Just4Stan/betaflight/(list of files, cad)

Other CAD files:
hardware/OpenFC-B_Paste.dxf
hardware/OpenFC-F_Paste.dxf
