Just4Stan/betaflight/hardware/OpenFC.kicad_pcb

## KiCad design hardware/OpenFC.kicad_pcb (2026-04-27)

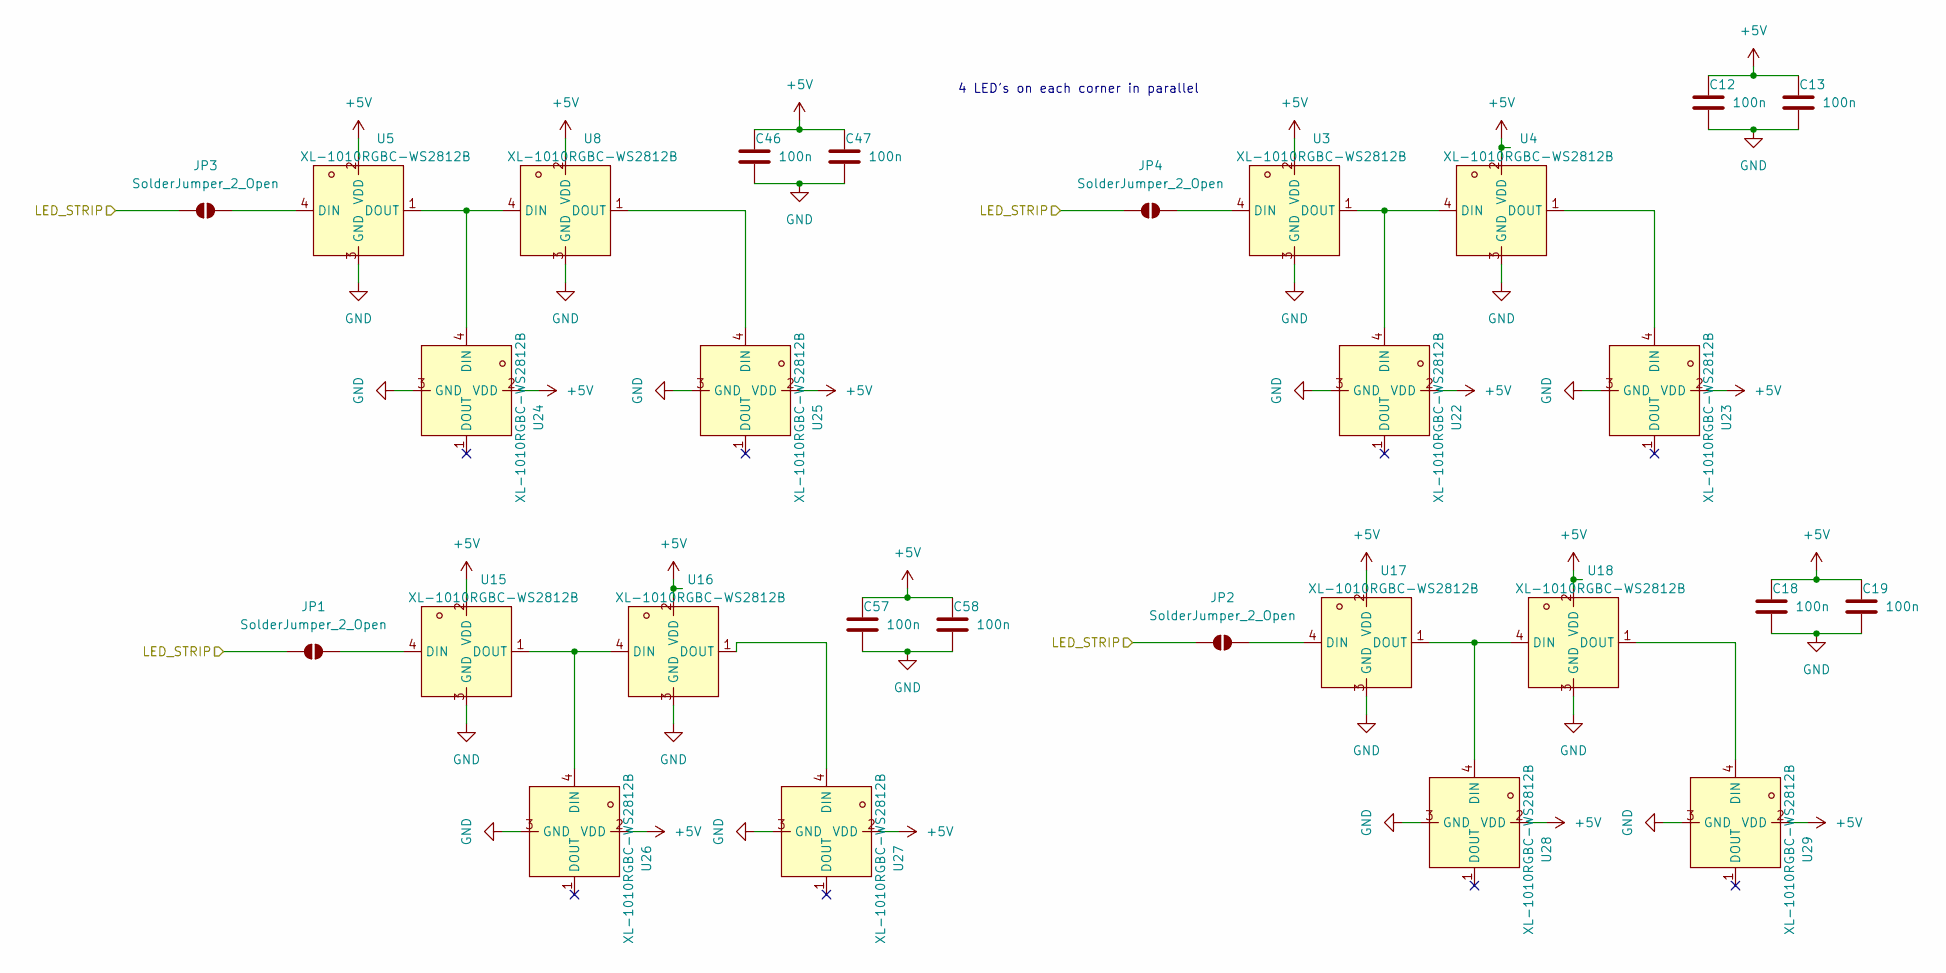
[picture p1: schematic leds.kicad_sch]

Parts:
C12, C13, C18, C19, C46, C47, C57, C58: 100n; C_0402_1005Metric; LCSC C1525
JP1, JP2, JP3, JP4: SolderJumper_2_Open; MouseBite-Slot-Jumper_0201
U3, U4, U5, U8, U15, U16, U17, U18, U22, U23, U24, U25, U26, U27, U28, U29: XL-1010RGBC-WS2812B; LED-SMD_4P-L1.0-W1.0-TL_XL-1010RGBC-WS2812B; LCSC Part C5349953

Connections:
+5V: C12.1, C13.1, C18.1, C19.1, C46.1, C47.1, C57.1, C58.1, U3.2 (VDD), U4.2 (VDD), U5.2 (VDD), U8.2 (VDD), U15.2 (VDD), U16.2 (VDD), U17.2 (VDD), U18.2 (VDD), U22.2 (VDD), U23.2 (VDD), U24.2 (VDD), U25.2 (VDD), U26.2 (VDD), U27.2 (VDD), U28.2 (VDD), U29.2 (VDD); also elsewhere on the board
/LED: JP1.1 (A), JP2.1 (A), JP3.1 (A), JP4.1 (A); also elsewhere on the board
GND: C12.2, C13.2, C18.2, C19.2, C46.2, C47.2, C57.2, C58.2, U3.3 (GND), U4.3 (GND), U5.3 (GND), U8.3 (GND), U15.3 (GND), U16.3 (GND), U17.3 (GND), U18.3 (GND), U22.3 (GND), U23.3 (GND), U24.3 (GND), U25.3 (GND), U26.3 (GND), U27.3 (GND), U28.3 (GND), U29.3 (GND); also elsewhere on the board
unnamed: JP1.2 (B), U15.4 (DIN)
unnamed: JP2.2 (B), U17.4 (DIN)
unnamed: JP3.2 (B), U5.4 (DIN)
unnamed: JP4.2 (B), U3.4 (DIN)
unnamed: U15.1 (DOUT), U16.4 (DIN), U26.4 (DIN)
unnamed: U16.1 (DOUT), U27.4 (DIN)
unnamed: U17.1 (DOUT), U18.4 (DIN), U28.4 (DIN)
unnamed: U18.1 (DOUT), U29.4 (DIN)
unnamed: U3.1 (DOUT), U4.4 (DIN), U22.4 (DIN)
unnamed: U4.1 (DOUT), U23.4 (DIN)
unnamed: U5.1 (DOUT), U8.4 (DIN), U24.4 (DIN)
unnamed: U8.1 (DOUT), U25.4 (DIN)

Notes on the sheet:
4 LED's on each corner in parallel

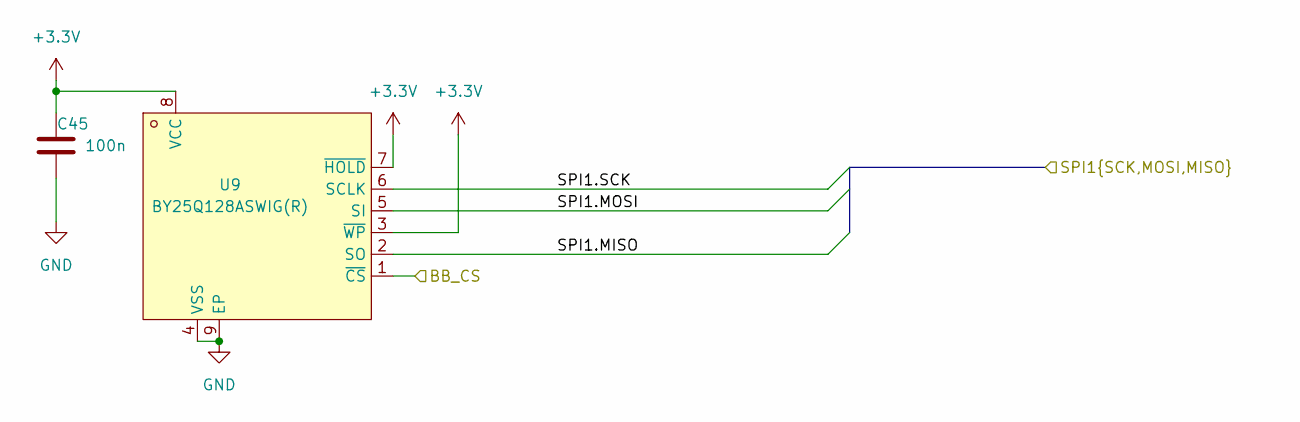
[picture p2: schematic blackbox.kicad_sch]

Parts:
C45: 100n; C_0402_1005Metric; LCSC C1525
U9: BY25Q128ASWIG(R); WSON-8_L6.0-W5.0-P1.27-BL-EP; LCSC Part C394872

Connections:
+3.3V: C45.1, U9.3 (~WP), U9.7 (~HOLD), U9.8 (VCC); also elsewhere on the board
/BLACKBOX/BB_CS: U9.1 (~CS); also elsewhere on the board
/BLACKBOX/SPI1.MISO: U9.2 (SO); also elsewhere on the board
/BLACKBOX/SPI1.MOSI: U9.5 (SI); also elsewhere on the board
/BLACKBOX/SPI1.SCK: U9.6 (SCLK); also elsewhere on the board
GND: C45.2, U9.4 (VSS), U9.9 (EP); also elsewhere on the board

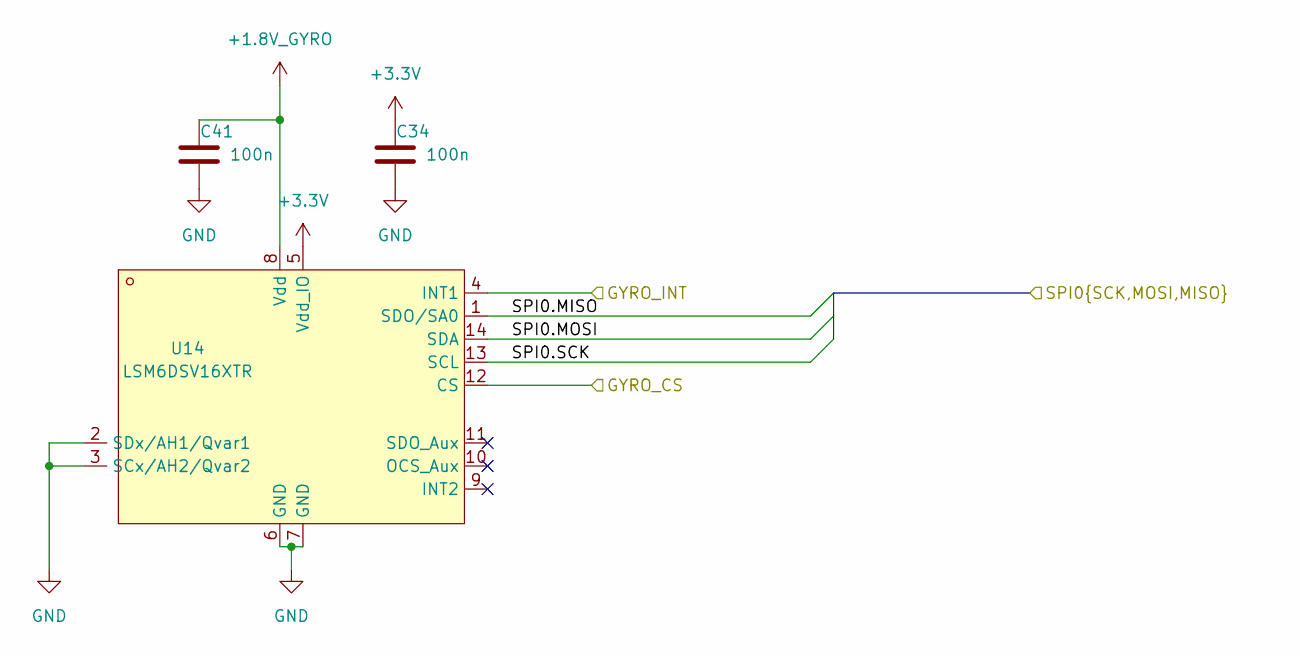
[picture p3: schematic imu.kicad_sch]

Parts:
C34, C41: 100n; C_0402_1005Metric; LCSC C1525
U14: LSM6DSV16XTR; LGA-14_L3.0-W2.5-P0.50-BR; LCSC Part C5267406

Connections:
+1.8V_GYRO: C41.1, U14.8 (Vdd); also elsewhere on the board
+3.3V: C34.1, U14.5 (Vdd_IO); also elsewhere on the board
/IMU/GYRO_CS: U14.12 (CS); also elsewhere on the board
/IMU/GYRO_INT: U14.4 (INT1); also elsewhere on the board
/IMU/SPI0.MISO: U14.1 (SDO/SA0); also elsewhere on the board
/IMU/SPI0.MOSI: U14.14 (SDA); also elsewhere on the board
/IMU/SPI0.SCK: U14.13 (SCL); also elsewhere on the board
GND: C34.2, C41.2, U14.2 (SDx/AH1/Qvar1), U14.3 (SCx/AH2/Qvar2), U14.6 (GND), U14.7 (GND); also elsewhere on the board

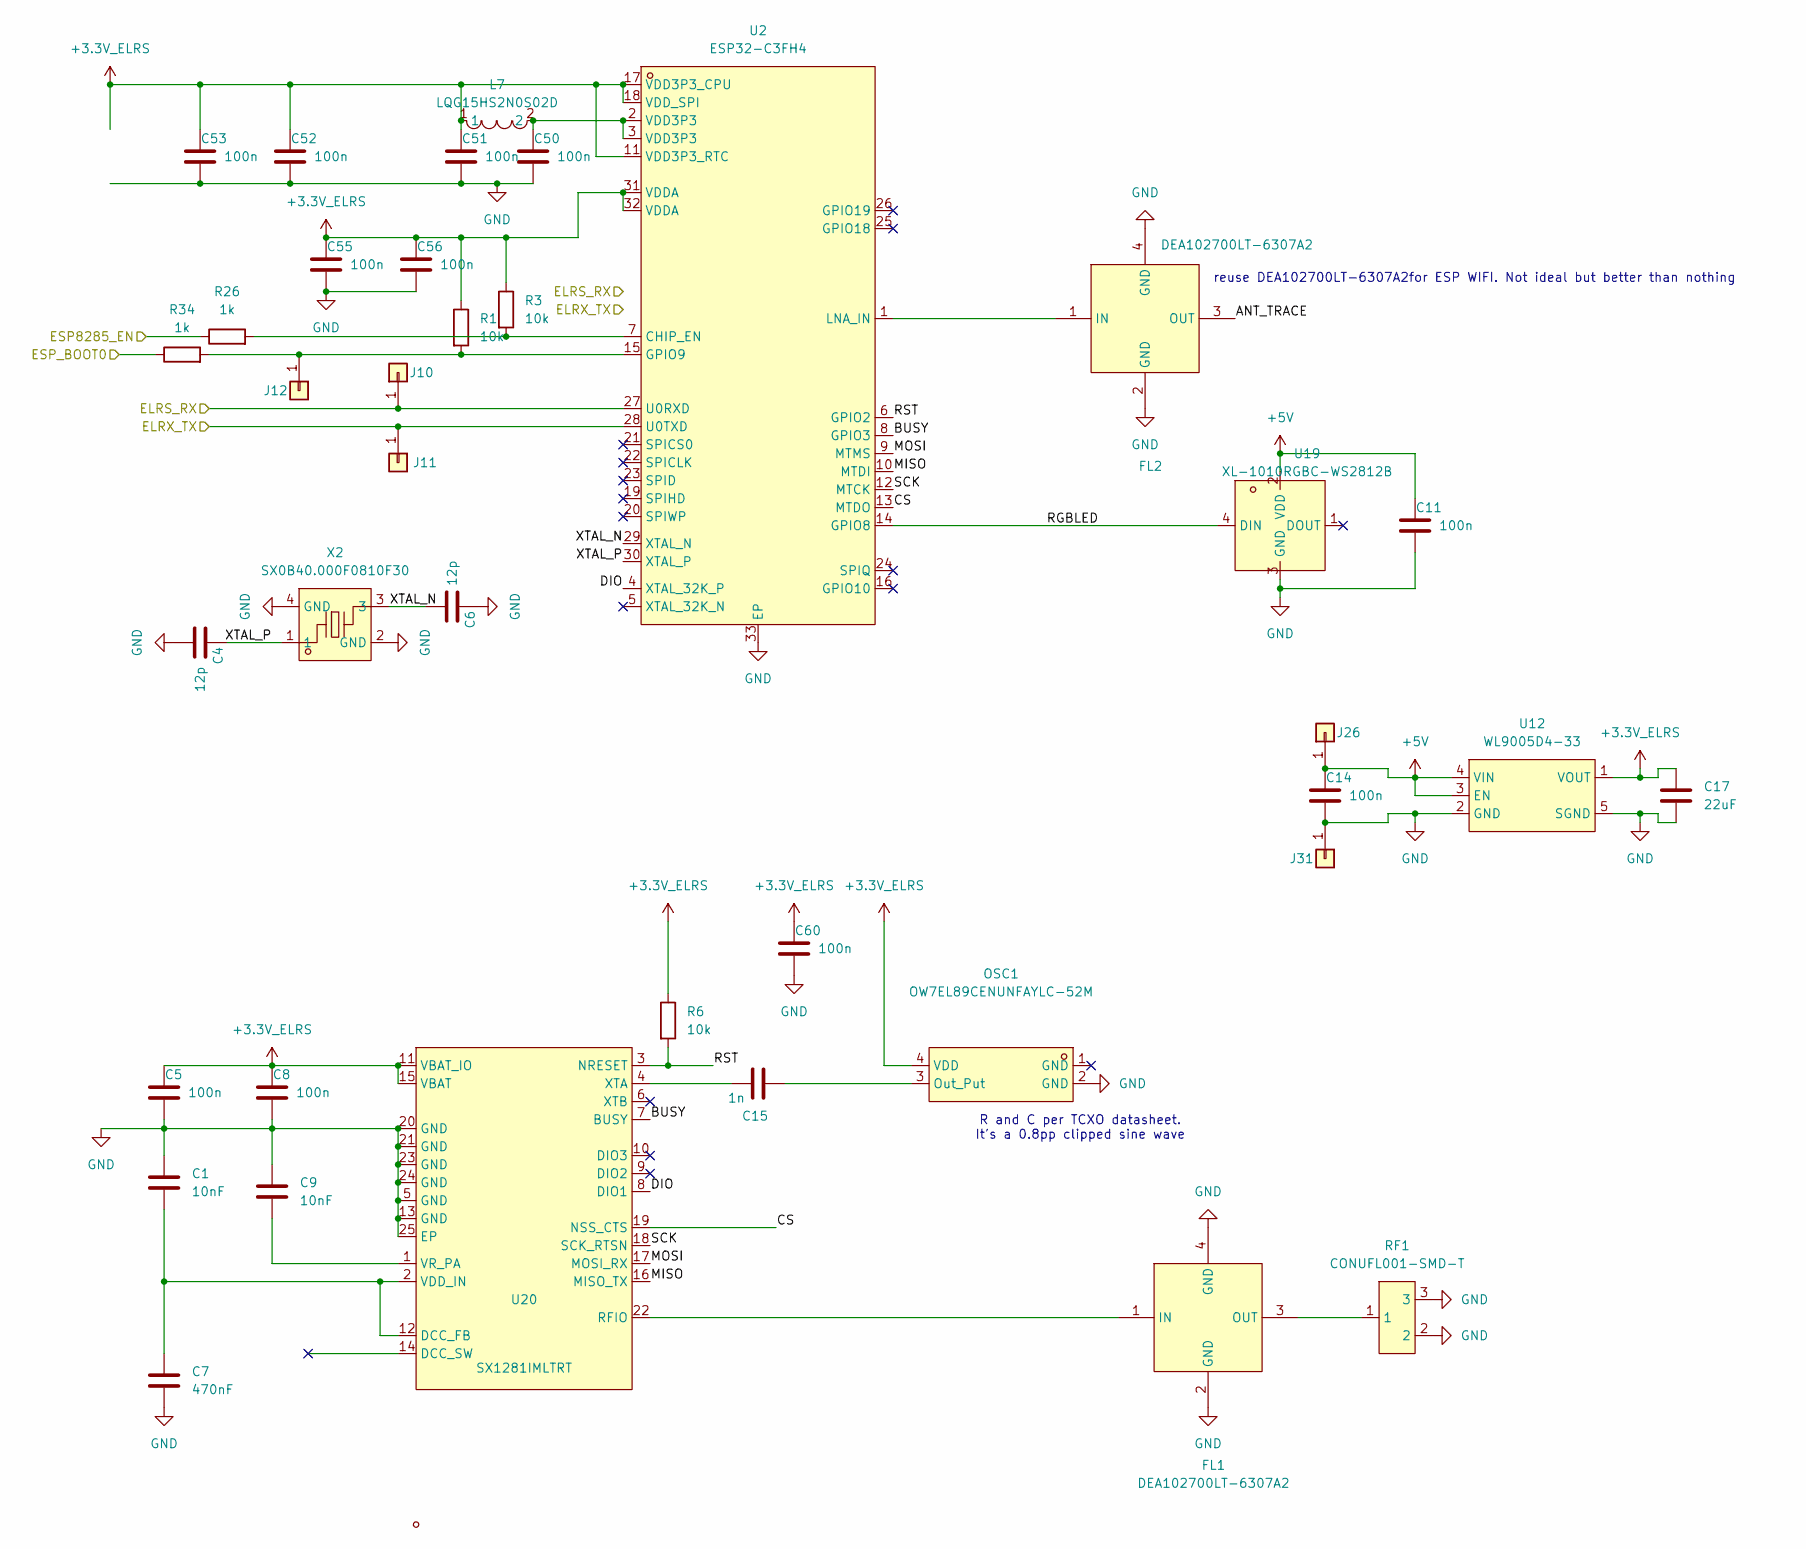
[picture p4: schematic elrs.kicad_sch]

Parts:
C1, C9: 10nF; C_0402_1005Metric; LCSC C15195
C4, C6: 12p; C_0402_1005Metric; LCSC C441742
C5, C8, C11, C14, C50, C51, C52, C53, C55, C56, C60: 100n; C_0402_1005Metric; LCSC C1525
C7: 470nF; C_0402_1005Metric; LCSC C92361
C15: 1n; C_0402_1005Metric
C17: 22uF; C_0402_1005Metric; LCSC C105226
FL1, FL2: DEA102700LT-6307A2; FILTER-SMD_4P-L1.0-W0.5-L; LCSC Part C574024
J10, J11, J12, J26, J31: 5V; small_pad
L7: LQG15HS2N0S02D; L0402; LCSC Part C18216
OSC1: OW7EL89CENUNFAYLC-52M; OSC-SMD_4P-L2.0-W1.6-BL_TXC_7Z; LCSC Part C22434896
R1, R3, R6: 10k; R_0402_1005Metric; LCSC C2909316
R26, R34: 1k; R_0402_1005Metric; LCSC C2909316
RF1: CONUFL001-SMD-T; IPEX-SMD_3P-L2.6-W2.6-LS3.0; LCSC Part C22418213
U2: ESP32-C3FH4; QFN-32_L5.0-W5.0-P0.50-TL-EP3.7; LCSC Part C2858491
U12: WL9005D4-33; UDFN-4_L1.0-W1.0-P0.65-TL; LCSC Part C5357206
U19: XL-1010RGBC-WS2812B; LED-SMD_4P-L1.0-W1.0-TL_XL-1010RGBC-WS2812B; LCSC Part C5349953
U20: SX1281IMLTRT; QFN-24_L4.0-W4.0-P0.50-TL-EP2.6; LCSC Part C2151551
X2: SX0B40.000F0810F30; CRYSTAL-SMD_4P-L1.6-W1.2-BL; LCSC Part C7301926

Connections:
+3.3V_ELRS: C5.1, C8.1, C17.1, C51.1, C52.1, C53.1, C55.1, C56.1, C60.1, L7.1, OSC1.4 (VDD), R1.1, R3.1, R6.1, U2.11 (VDD3P3_RTC), U2.17 (VDD3P3_CPU), U2.18 (VDD_SPI), U2.31 (VDDA), U2.32 (VDDA), U12.1 (VOUT), U20.11 (VBAT_IO), U20.15 (VBAT)
+5V: C11.1, C14.1, J26.1, U12.3 (EN), U12.4 (VIN), U19.2 (VDD); also elsewhere on the board
/ELRS/ANT_TRACE: FL2.3 (OUT)
/ELRS/BUSY: U2.8 (GPIO3), U20.7 (BUSY)
/ELRS/CS: U2.13 (MTDO), U20.19 (NSS_CTS)
/ELRS/DIO: U2.4 (XTAL_32K_P), U20.8 (DIO1)
/ELRS/ESP8285_EN: R26.1; also elsewhere on the board
/ELRS/ESP_BOOT0: R34.1; also elsewhere on the board
/ELRS/MISO: U2.10 (MTDI), U20.16 (MISO_TX)
/ELRS/MOSI: U2.9 (MTMS), U20.17 (MOSI_RX)
/ELRS/RGBLED: U2.14 (GPIO8), U19.4 (DIN)
/ELRS/RST: R6.2, U2.6 (GPIO2), U20.3 (NRESET)
/ELRS/SCK: U2.12 (MTCK), U20.18 (SCK_RTSN)
/ELRS/XTAL_N: C6.2, U2.29 (XTAL_N), X2.3
/ELRS/XTAL_P: C4.1, U2.30 (XTAL_P), X2.1
/UART1_RX: J11.1, U2.28 (U0TXD); also elsewhere on the board
/UART1_TX: J10.1, U2.27 (U0RXD); also elsewhere on the board
GND: C1.1, C4.2, C5.2, C6.1, C7.2, C8.2, C9.1, C11.2, C14.2, C17.2, C50.2, C51.2, C52.2, C53.2, C55.2, C56.2, C60.2, FL1.2 (GND), FL1.4 (GND), FL2.2 (GND), FL2.4 (GND), J31.1, OSC1.2 (GND), RF1.2, RF1.3, U2.33 (EP), U12.2 (GND), U12.5 (SGND), U19.3 (GND), U20.5 (GND), U20.13 (GND), U20.20 (GND), U20.21 (GND), U20.23 (GND), U20.24 (GND), U20.25 (EP), X2.2 (GND), X2.4 (GND); also elsewhere on the board
unnamed: C50.1, L7.2, U2.2 (VDD3P3), U2.3 (VDD3P3)
unnamed: FL1.1 (IN), U20.22 (RFIO)
unnamed: FL1.3 (OUT), RF1.1
unnamed: FL2.1 (IN), U2.1 (LNA_IN)
unnamed: J12.1, R1.2, R34.2, U2.15 (GPIO9)
unnamed: C15.2, OSC1.3 (Out_Put)
unnamed: R3.2, R26.2, U2.7 (CHIP_EN)
unnamed: C1.2, C7.1, U20.2 (VDD_IN), U20.12 (DCC_FB)
unnamed: C9.2, U20.1 (VR_PA)
unnamed: C15.1, U20.4 (XTA)

Notes on the sheet:
reuse DEA102700LT-6307A2for ESP WIFI. Not ideal but better than nothing
R and C per TCXO datasheet. It's a 0.8pp clipped sine wave

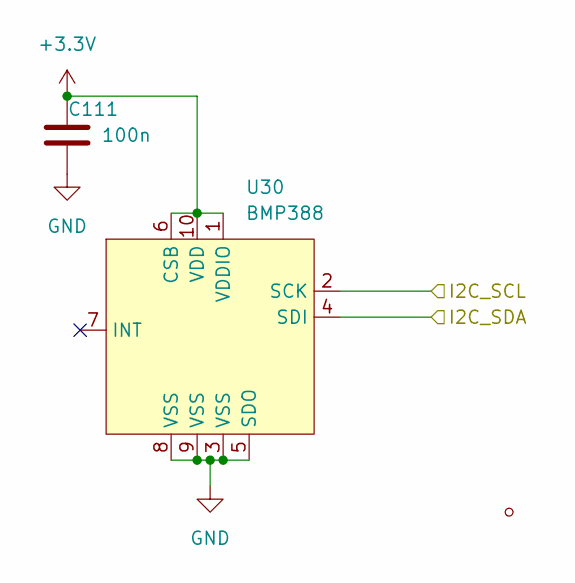
[picture p5: schematic baro.kicad_sch]

Parts:
C111: 100n; C_0402_1005Metric; LCSC C1525
U30: BMP388; SENSORM-SMD_BMP388; LCSC Part C779278

Connections:
+3.3V: C111.1, U30.1 (VDDIO), U30.6 (CSB), U30.10 (VDD); also elsewhere on the board
/I2C_SCL: U30.2 (SCK); also elsewhere on the board
/I2C_SDA: U30.4 (SDI); also elsewhere on the board
GND: C111.2, U30.3 (VSS), U30.5 (SDO), U30.8 (VSS), U30.9 (VSS); also elsewhere on the board

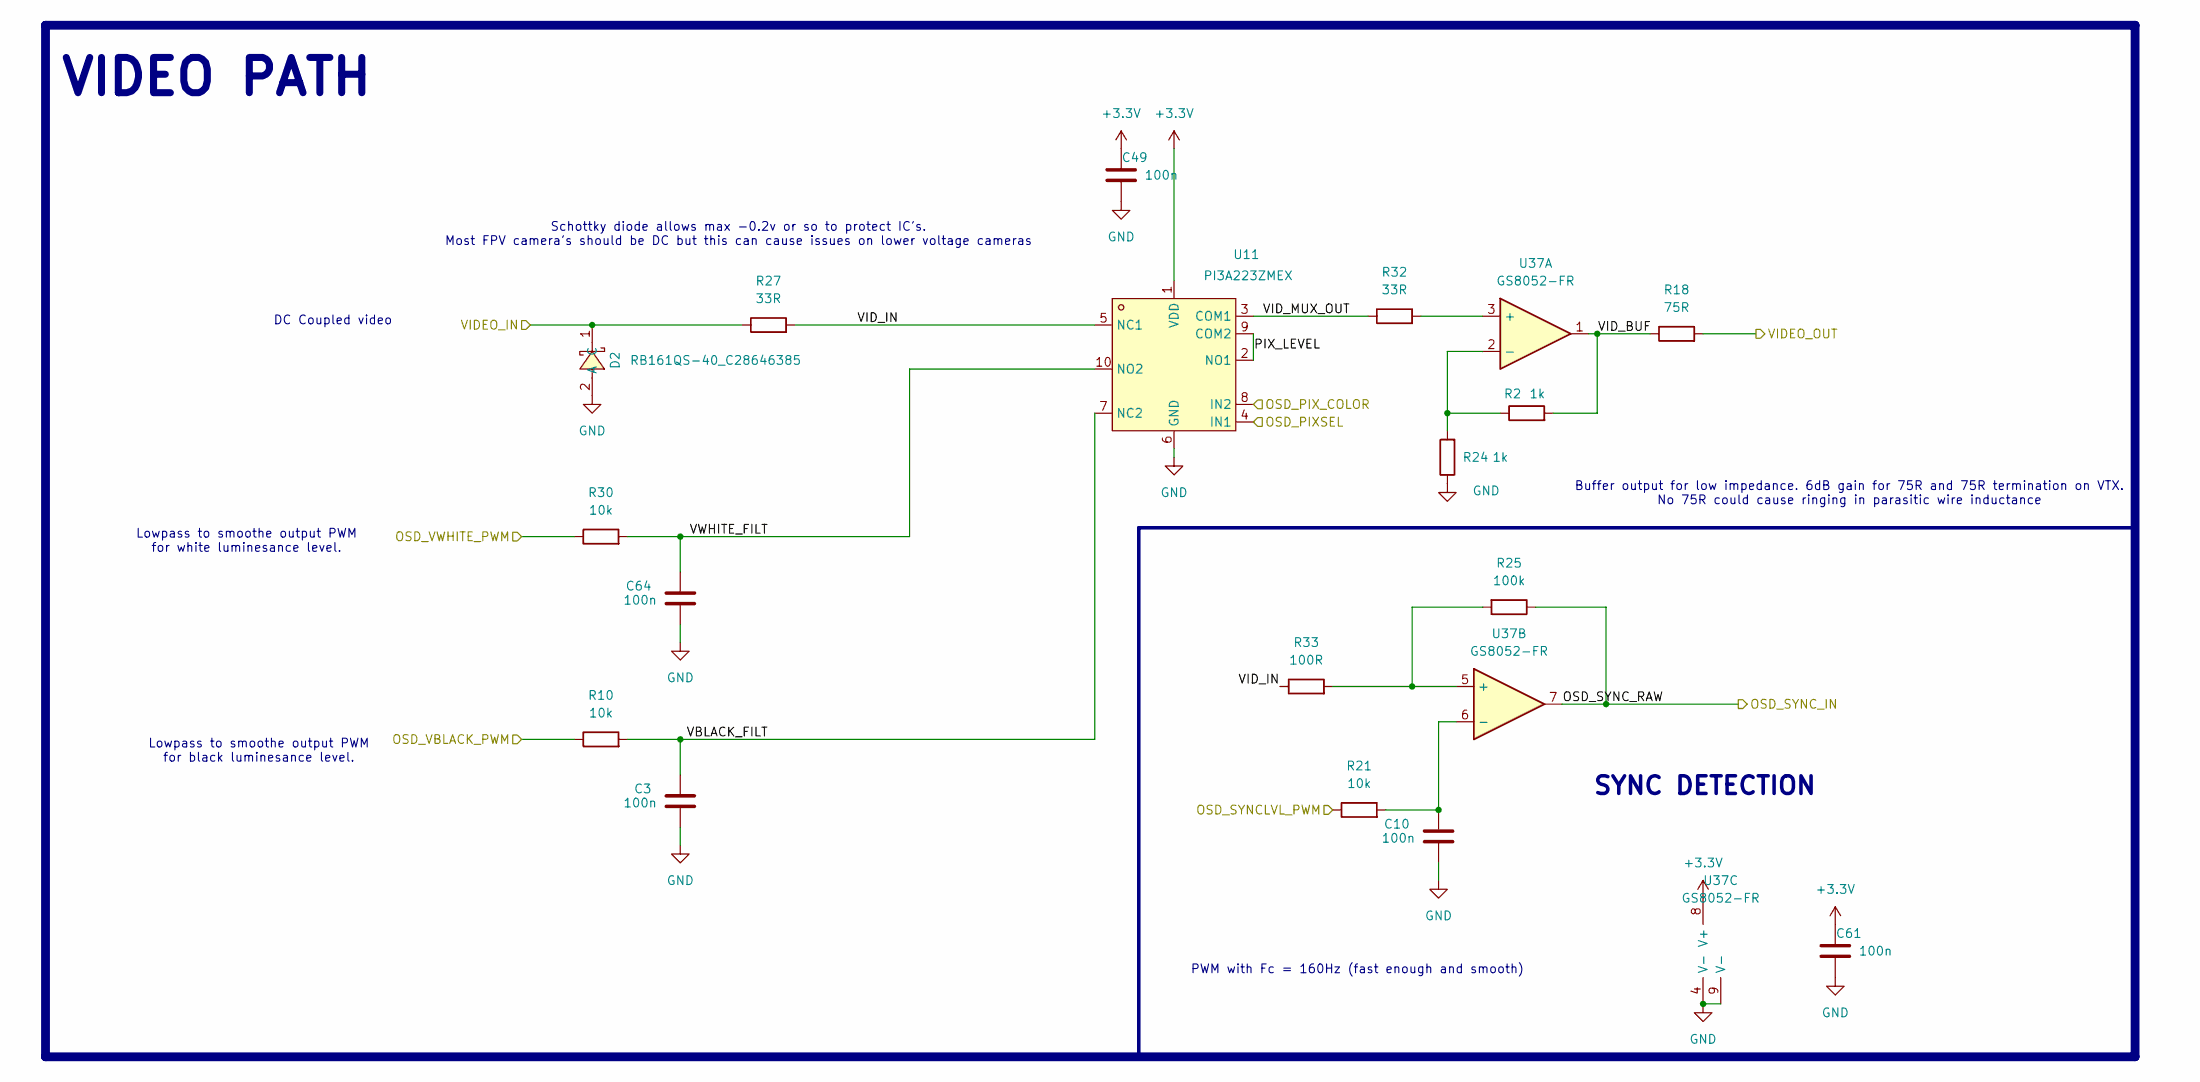
[picture p6: schematic osd.kicad_sch]

Parts:
C3, C10, C49, C61, C64: 100n; C_0402_1005Metric; LCSC C1525
D2: RB161QS-40_C28646385; SOD-882_L1.0-W0.6-RD; LCSC Part C28646385
R2, R24: 1k; R_0402_1005Metric
R10, R21, R30: 10k; R_0402_1005Metric
R18: 75R; R_0402_1005Metric
R25: 100k; R_0402_1005Metric
R27, R32: 33R; R_0402_1005Metric
R33: 100R; R_0402_1005Metric
U11: PI3A223ZMEX; UQFN-10_L1.8-W1.4-P0.40-TL; LCSC Part C2673436
U37: GS8052-FR; WSON-8-1EP_2x2mm_P0.5mm_EP0.9x1.6mm; LCSC C605423

Connections:
+3.3V: C49.1, C61.1, U11.1 (VDD), U37.8 (V+); also elsewhere on the board
/OSD/OSD_PIXSEL: U11.4 (IN1); also elsewhere on the board
/OSD/OSD_PIX_COLOR: U11.8 (IN2); also elsewhere on the board
/OSD/OSD_SYNCLVL_PWM: R21.1; also elsewhere on the board
/OSD/OSD_SYNC_RAW: R25.1, U37.7; also elsewhere on the board
/OSD/OSD_VBLACK_PWM: R10.1; also elsewhere on the board
/OSD/OSD_VWHITE_PWM: R30.1; also elsewhere on the board
/OSD/PIX_LEVEL: U11.2 (NO1), U11.9 (COM2)
/OSD/VBLACK_FILT: C3.2, R10.2, U11.7 (NC2); also elsewhere on the board
/OSD/VIDEO_IN: D2.1 (C), R27.1; also elsewhere on the board
/OSD/VIDEO_OUT: R18.2; also elsewhere on the board
/OSD/VID_BUF: R2.2, R18.1, U37.1
/OSD/VID_IN: R27.2, R33.1, U11.5 (NC1); also elsewhere on the board
/OSD/VID_MUX_OUT: R32.1, U11.3 (COM1); also elsewhere on the board
/OSD/VWHITE_FILT: C64.2, R30.2, U11.10 (NO2); also elsewhere on the board
GND: C3.1, C10.1, C49.2, C61.2, C64.1, D2.2 (A), R24.1, U11.6 (GND), U37.4 (V-), U37.9 (V-); also elsewhere on the board
unnamed: R32.2, U37.3 (+)
unnamed: R2.1, R24.2, U37.2 (-)
unnamed: R25.2, R33.2, U37.5 (+)
unnamed 131: C10.2, R21.2, U37.6 (-); also elsewhere on the board

Notes on the sheet:
PWM with Fc = 160Hz (fast enough and smooth)
DC Coupled video
Buffer output for low impedance. 6dB gain for 75R and 75R termination on VTX. No 75R could cause ringing in parasitic wire inductance
VIDEO PATH
SYNC DETECTION
Lowpass to smoothe output PWM for white luminesance level.
Lowpass to smoothe output PWM for black luminesance level.
Schottky diode allows max -0.2v or so to protect IC's. Most FPV camera's should be DC but this can cause issues on lower voltage cameras

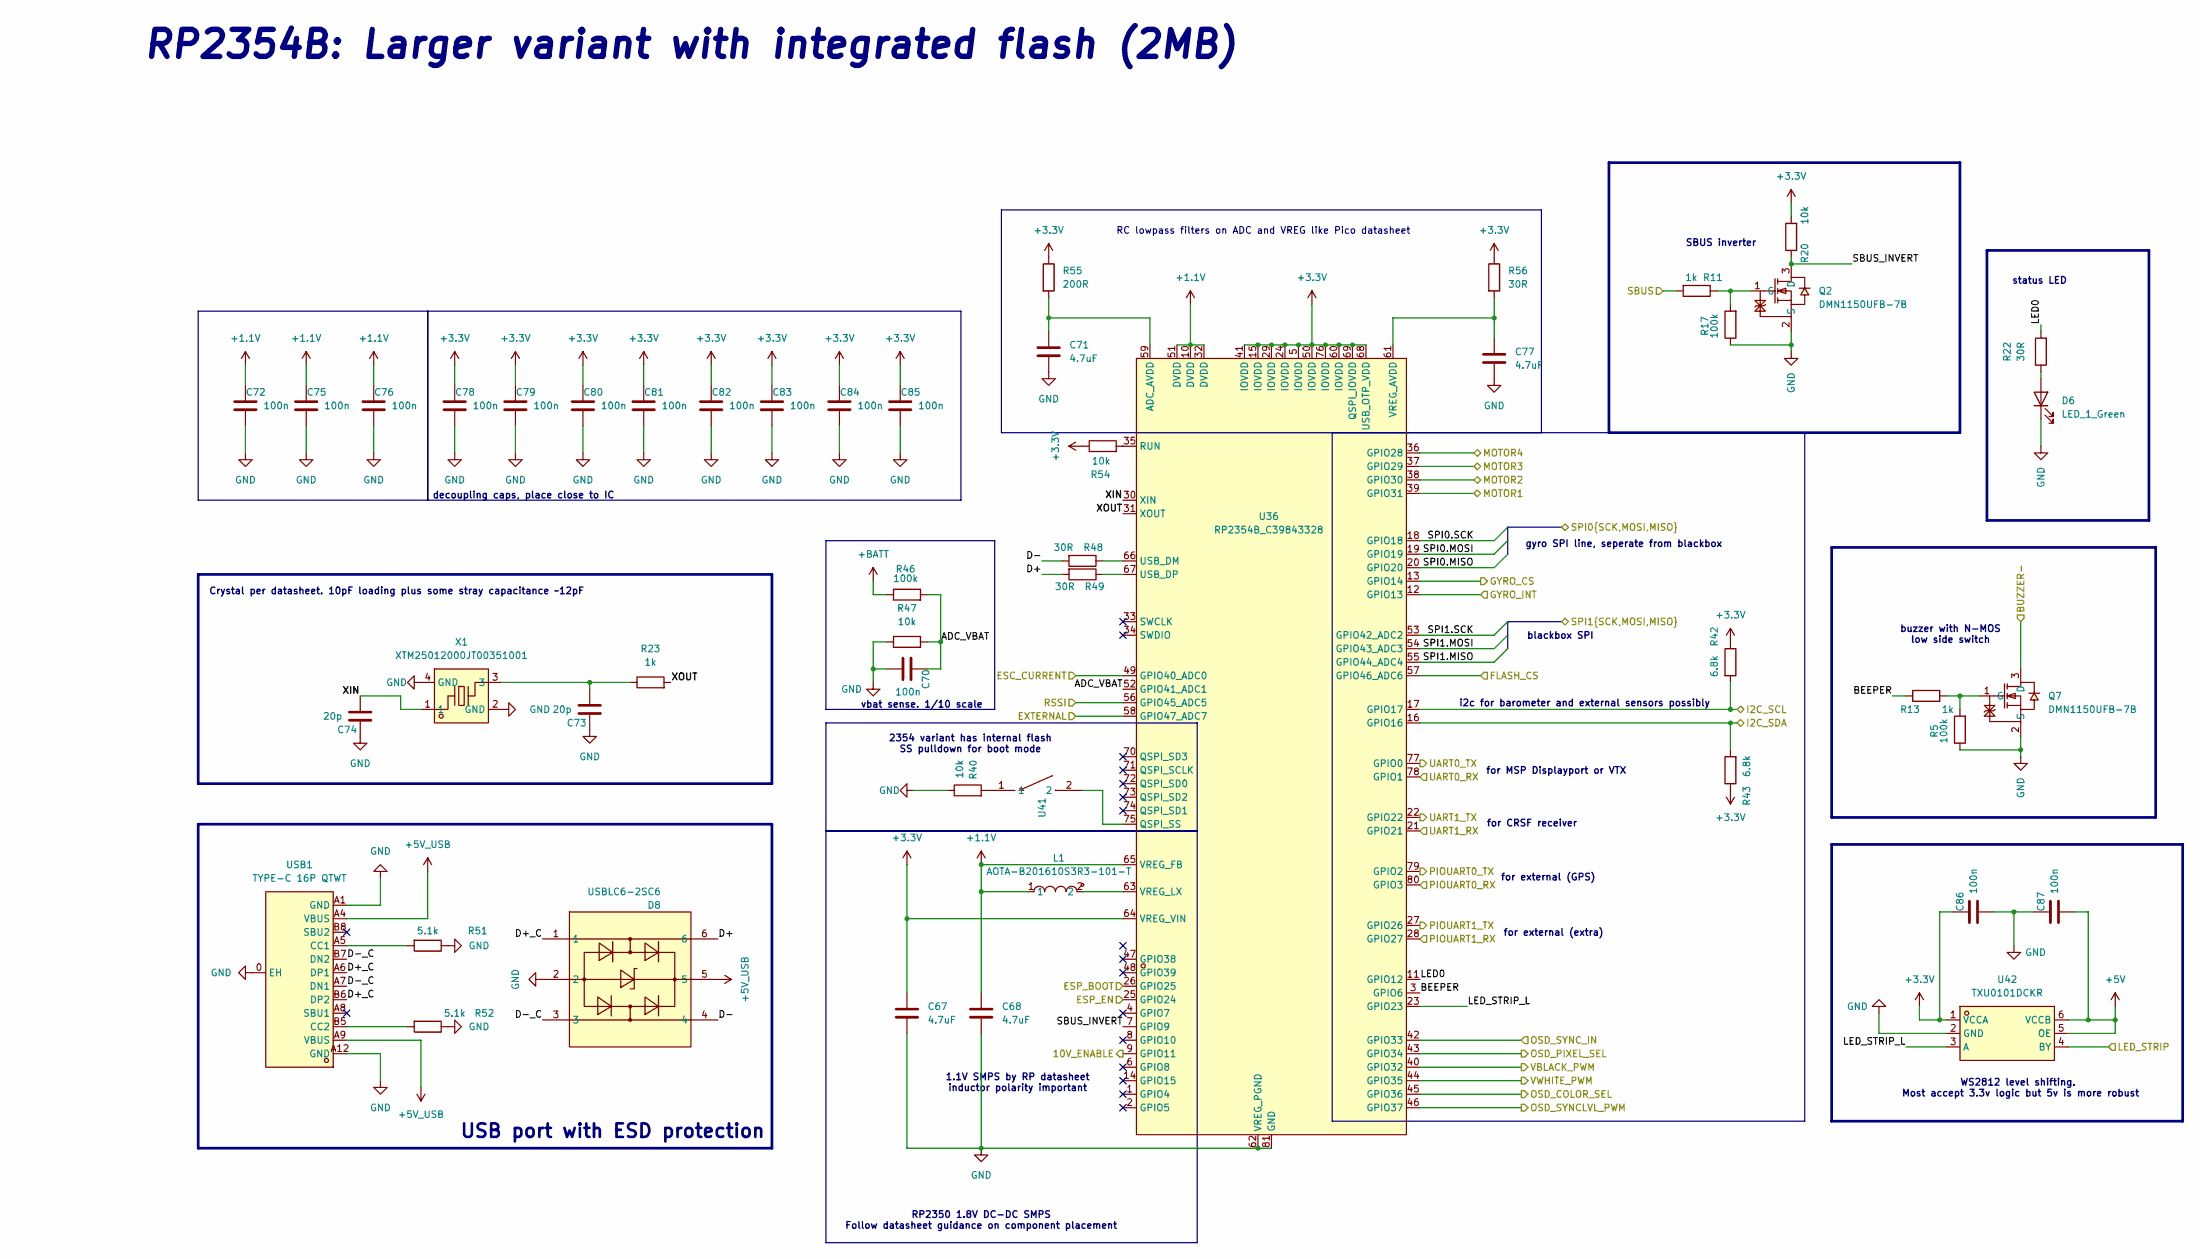
[picture p7: schematic rp2350a.kicad_sch]

Parts:
C67, C68, C71, C77: 4.7uF; C_0402_1005Metric; LCSC C23733
C70, C72, C75, C76, C78, C79, C80, C81, C82, C83, C84, C85, C86, C87: 100n; C_0402_1005Metric; LCSC C1525
C73, C74: 20p; C_0402_1005Metric; LCSC C441742
D6: LED_1_Green; LED_0603_1608Metric; LCSC C2994781
D8: USBLC6-2SC6; SOT-23-6_L2.9-W1.6-P0.95-LS2.8-BL; LCSC Part C7519
L1: AOTA-B201610S3R3-101-T; IND-SMD_L2.0-W1.6_AOTA-B201610S3R3-101-T; LCSC Part C42411119
Q2, Q7: DMN1150UFB-7B; DFN-3L_L1.0-W0.6-P0.65-BR; LCSC Part C459538
R5, R17, R46: 100k; R_0402_1005Metric; LCSC C60491
R11, R13: 1k; R_0402_1005Metric; LCSC C106235
R20: 10k; R_0402_1005Metric; LCSC C106235
R22, R48, R49, R56: 30R; R_0402_1005Metric; LCSC C138007
R23: 1k; R_0402_1005Metric; LCSC C2909316
R40, R47, R54: 10k; R_0402_1005Metric; LCSC C2909316
R42: 6.8k; R_0402_1005Metric; LCSC C105872
R43: 6.8k; R_0402_1005Metric; LCSC C2906876
R51, R52: 5.1k; R_0402_1005Metric; LCSC C105872
R55: 200R; R_0402_1005Metric; LCSC C25087
U36: RP2354B_C39843328; QFN-80_L10.0-W10.0-P0.40-TL-EP3.4; LCSC Part C39843328
U41: TS2306A 240GF MSM 9_C2976675; SW-SMD_4P-L3.0-W2.0-P0.85-LS3.5; LCSC Part C2976675
U42: TXU0101DCKR; SC-70-6_L2.0-W1.3-P0.65-LS2.1-BL; LCSC Part C5217868
USB1: TYPE-C 16P QTWT; USB-TYPE-C-SMD_TYPE-C-16P-QTWT; LCSC Part C5187472
X1: XTM25012000JT00351001; CRYSTAL-SMD_4P-L2.5-W2.0-BL-A; LCSC Part C37635340

Connections:
+1.1V: C68.1, C72.1, C75.1, C76.1, L1.1, U36.10 (DVDD), U36.32 (DVDD), U36.51 (DVDD), U36.65 (VREG_FB)
+3.3V: C67.1, C78.1, C79.1, C80.1, C81.1, C82.1, C83.1, C84.1, C85.1, C86.1, R20.2, R42.1, R43.1, R54.1, R55.1, R56.1, U36.5 (IOVDD), U36.15 (IOVDD), U36.24 (IOVDD), U36.29 (IOVDD), U36.41 (IOVDD), U36.50 (IOVDD), U36.60 (IOVDD), U36.64 (VREG_VIN), U36.68 (USB_OTP_VDD), U36.69 (QSPI_IOVDD), U36.76 (IOVDD), U42.1 (VCCA); also elsewhere on the board
+5V: C87.2, U42.5 (OE), U42.6 (VCCB); also elsewhere on the board
+5V_USB: D8.5, USB1.A4 (VBUS), USB1.A9 (VBUS); also elsewhere on the board
+BATT: R46.1; also elsewhere on the board
/BLACKBOX/BB_CS: U36.57 (GPIO46_ADC6); also elsewhere on the board
/BLACKBOX/SPI1.MISO: U36.55 (GPIO44_ADC4); also elsewhere on the board
/BLACKBOX/SPI1.MOSI: U36.54 (GPIO43_ADC3); also elsewhere on the board
/BLACKBOX/SPI1.SCK: U36.53 (GPIO42_ADC2); also elsewhere on the board
/ELRS/ESP8285_EN: U36.25 (GPIO24); also elsewhere on the board
/ELRS/ESP_BOOT0: U36.26 (GPIO25); also elsewhere on the board
/I2C_SCL: R42.2, U36.17 (GPIO17); also elsewhere on the board
/I2C_SDA: R43.2, U36.16 (GPIO16); also elsewhere on the board
/IMU/GYRO_CS: U36.13 (GPIO14); also elsewhere on the board
/IMU/GYRO_INT: U36.12 (GPIO13); also elsewhere on the board
/IMU/SPI0.MISO: U36.20 (GPIO20); also elsewhere on the board
/IMU/SPI0.MOSI: U36.19 (GPIO19); also elsewhere on the board
/IMU/SPI0.SCK: U36.18 (GPIO18); also elsewhere on the board
/LED: U42.4 (BY); also elsewhere on the board
/OSD/OSD_PIXSEL: U36.43 (GPIO34); also elsewhere on the board
/OSD/OSD_PIX_COLOR: U36.45 (GPIO36); also elsewhere on the board
/OSD/OSD_SYNCLVL_PWM: U36.46 (GPIO37); also elsewhere on the board
/OSD/OSD_SYNC_RAW: U36.42 (GPIO33); also elsewhere on the board
/OSD/OSD_VBLACK_PWM: U36.40 (GPIO32); also elsewhere on the board
/OSD/OSD_VWHITE_PWM: U36.44 (GPIO35); also elsewhere on the board
/PADS/ADC2: U36.58 (GPIO47_ADC7); also elsewhere on the board
/PADS/BUZZER-: Q7.3 (D); also elsewhere on the board
/PADS/CURRENT: U36.49 (GPIO40_ADC0); also elsewhere on the board
/PADS/DIGITAL_RX: U36.78 (GPIO1); also elsewhere on the board
/PADS/DIGITAL_TX: U36.77 (GPIO0); also elsewhere on the board
/PADS/M1: U36.39 (GPIO31); also elsewhere on the board
/PADS/M2: U36.38 (GPIO30); also elsewhere on the board
/PADS/M3: U36.37 (GPIO29); also elsewhere on the board
/PADS/M4: U36.36 (GPIO28); also elsewhere on the board
/PADS/PIOUART0_RX: U36.80 (GPIO3); also elsewhere on the board
/PADS/PIOUART0_TX: U36.79 (GPIO2); also elsewhere on the board
/PADS/PIOUART1_RX: U36.28 (GPIO27); also elsewhere on the board
/PADS/PIOUART1_TX: U36.27 (GPIO26); also elsewhere on the board
/PADS/RSSI: U36.56 (GPIO45_ADC5); also elsewhere on the board
/PADS/SBUS: R11.2; also elsewhere on the board
/RP2350A/ADC_VBAT: C70.1, R46.2, R47.2, U36.52 (GPIO41_ADC1)
/RP2350A/BEEPER: R13.1, U36.3 (GPIO6)
/RP2350A/D+: D8.6, R49.2
/RP2350A/D+_C: D8.1, USB1.A6 (DP1), USB1.B6 (DP2)
/RP2350A/D-: D8.4, R48.2
/RP2350A/D-_C: D8.3, USB1.A7 (DN1), USB1.B7 (DN2)
/RP2350A/LED0: R22.2, U36.11 (GPIO12)
/RP2350A/LED_STRIP_L: U36.23 (GPIO23), U42.3 (A); also elsewhere on the board
/RP2350A/SBUS_INVERT: Q2.3 (D), R20.1, U36.7 (GPIO9); also elsewhere on the board
/RP2350A/XIN: C74.2, U36.30 (XIN), X1.1
/RP2350A/XOUT: R23.2, U36.31 (XOUT)
/UART1_RX: U36.21 (GPIO21); also elsewhere on the board
/UART1_TX: U36.22 (GPIO22); also elsewhere on the board
GND: C67.2, C68.2, C70.2, C71.2, C72.2, C73.1, C74.1, C75.2, C76.2, C77.2, C78.2, C79.2, C80.2, C81.2, C82.2, C83.2, C84.2, C85.2, C86.2, C87.1, D6.1 (K), D8.2, Q2.2 (S), Q7.2 (S), R5.1, R17.1, R40.1, R47.1, R51.1, R52.1, U36.62 (VREG_PGND), U36.81 (GND), U42.2 (GND), USB1.0 (EH), USB1.A1 (GND), USB1.A12 (GND), X1.2 (GND), X1.4 (GND); also elsewhere on the board
unnamed: C73.2, R23.1, X1.3
unnamed: D6.2 (A), R22.1
unnamed: Q2.1 (G), R11.1, R17.2
unnamed: Q7.1 (G), R5.2, R13.2
unnamed: R40.2, U41.1
unnamed: C71.1, R55.2, U36.59 (ADC_AVDD)
unnamed: U36.75 (QSPI_SS), U41.2
unnamed: R54.2, U36.35 (RUN)
unnamed 122: U36.33 (SWCLK); also elsewhere on the board
unnamed 123: U36.34 (SWDIO); also elsewhere on the board
unnamed: R48.1, U36.66 (USB_DM)
unnamed: R49.1, U36.67 (USB_DP)
unnamed: C77.1, R56.2, U36.61 (VREG_AVDD)
unnamed: L1.2, U36.63 (VREG_LX)
unnamed: R51.2, USB1.A5 (CC1)
unnamed: R52.2, USB1.B5 (CC2)

Notes on the sheet:
vbat sense. 1/10 scale
RP2354B: Larger variant with integrated flash (2MB)
blackbox SPI
buzzer with N-MOS low side switch
for MSP Displayport or VTX
2354 variant has internal flash SS pulldown for boot mode
RP2350 1.8V DC-DC SMPS Follow datasheet guidance on component placement
for CRSF receiver
gyro SPI line, seperate from blackbox
decoupling caps, place close to IC
for external (extra)
status LED
Crystal per datasheet. 10pF loading plus some stray capacitance ~12pF
for external (GPS)
i2c for barometer and external sensors possibly
SBUS inverter
RC lowpass filters on ADC and VREG like Pico datasheet
WS2812 level shifting. Most accept 3.3v logic but 5v is more robust
USB port with ESD protection
1.1V SMPS by RP datasheet inductor polarity important

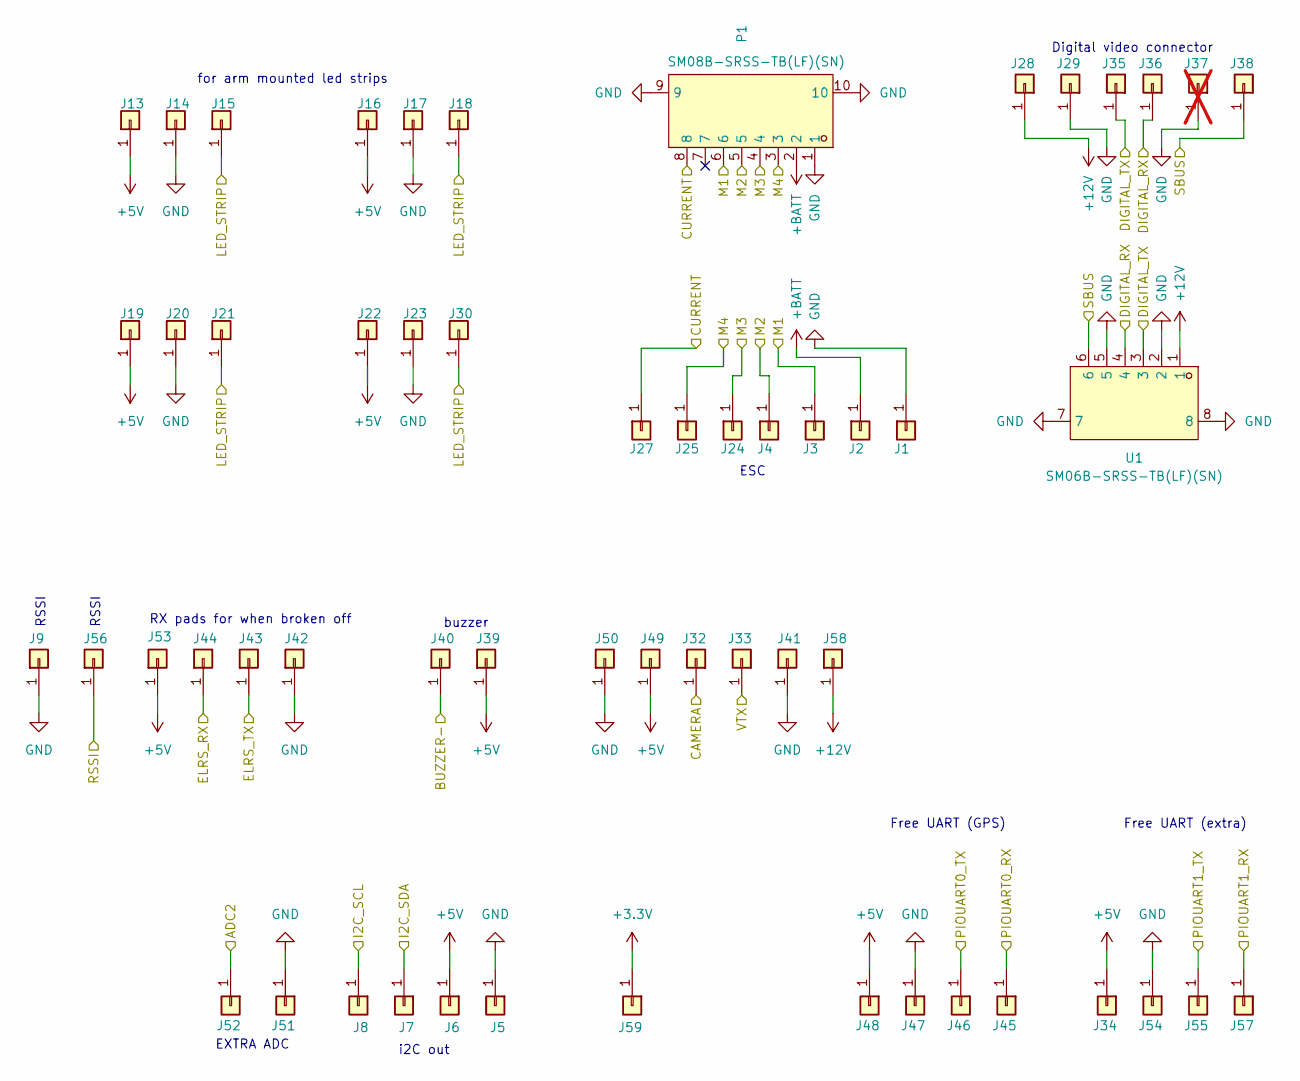
[picture p8: schematic pads.kicad_sch]

Parts:
J1, J2, J3, J4, J5, J6, J7, J8, J9, J13, J14, J15, J16, J17, J18, J19, J20, J21, J22, J23, J24, J25, J27, J28, J29, J30, J32, J33, J34, J35, J36, J38, J39, J40, J41, J42, J43, J44, J45, J46, J47, J48, J49, J50, J51, J52, J53, J54, J55, J56, J57, J58, J59: 5V; small_pad
J37: 5V; small_pad; not fitted
P1: SM08B-SRSS-TB(LF)(SN); CONN-TH_SM08B-SRSS-TB-LF-SN; LCSC Part C160407
U1: SM06B-SRSS-TB(LF)(SN); CONN-SMD_SM06B-SRSS-TB-LF-SN; LCSC Part C160405

Connections:
+3.3V: J59.1; also elsewhere on the board
+5V: J6.1, J13.1, J16.1, J19.1, J22.1, J34.1, J39.1, J48.1, J49.1, J53.1; also elsewhere on the board
+12V: J28.1, J58.1, U1.1; also elsewhere on the board
+BATT: J2.1, P1.2; also elsewhere on the board
/I2C_SCL: J8.1; also elsewhere on the board
/I2C_SDA: J7.1; also elsewhere on the board
/LED: J15.1, J18.1, J21.1, J30.1; also elsewhere on the board
/OSD/VIDEO_IN: J32.1; also elsewhere on the board
/OSD/VIDEO_OUT: J33.1; also elsewhere on the board
/PADS/ADC2: J52.1; also elsewhere on the board
/PADS/BUZZER-: J40.1; also elsewhere on the board
/PADS/CURRENT: J27.1, P1.8; also elsewhere on the board
/PADS/DIGITAL_RX: J36.1, U1.4; also elsewhere on the board
/PADS/DIGITAL_TX: J35.1, U1.3; also elsewhere on the board
/PADS/M1: J3.1, P1.6; also elsewhere on the board
/PADS/M2: J4.1, P1.5; also elsewhere on the board
/PADS/M3: J24.1, P1.4; also elsewhere on the board
/PADS/M4: J25.1, P1.3; also elsewhere on the board
/PADS/PIOUART0_RX: J45.1; also elsewhere on the board
/PADS/PIOUART0_TX: J46.1; also elsewhere on the board
/PADS/PIOUART1_RX: J57.1; also elsewhere on the board
/PADS/PIOUART1_TX: J55.1; also elsewhere on the board
/PADS/RSSI: J56.1; also elsewhere on the board
/PADS/SBUS: J38.1, U1.6; also elsewhere on the board
/UART1_RX: J44.1; also elsewhere on the board
/UART1_TX: J43.1; also elsewhere on the board
GND: J1.1, J5.1, J9.1, J14.1, J17.1, J20.1, J23.1, J29.1, J37.1, J41.1, J42.1, J47.1, J50.1, J51.1, J54.1, P1.1, P1.9, P1.10, U1.2, U1.5, U1.7, U1.8; also elsewhere on the board

Notes on the sheet:
RSSI
Free UART (GPS)
i2C out
Free UART (extra)
buzzer
RX pads for when broken off
ESC
Digital video connector
EXTRA ADC
for arm mounted led strips
