Just4Stan/betaflight/hardware/OpenFC.kicad_pcb

## KiCad design hardware/OpenFC.kicad_pcb (continued)

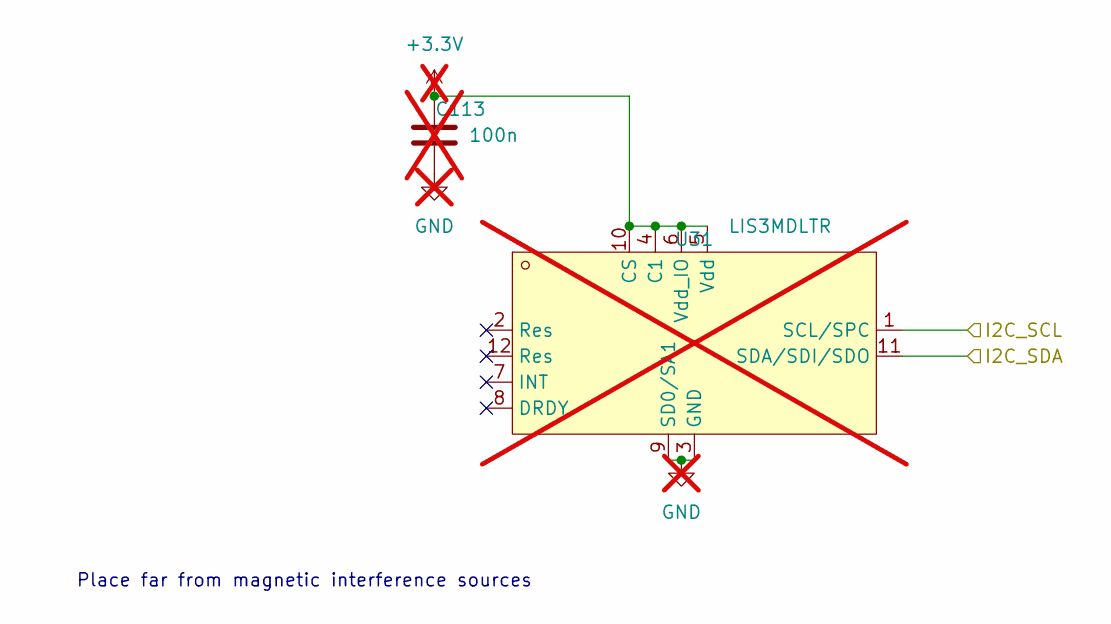
[picture p9: schematic compass.kicad_sch]

Parts:
C113: 100n; C_0402_1005Metric; LCSC C1525; not fitted
U31: LIS3MDLTR; LGA-12_L2.0-W2.0-P0.50-BL; LCSC Part C478483; not fitted

Connections:
unnamed: C113.1, U31.4 (C1), U31.5 (Vdd), U31.6 (Vdd_IO), U31.10 (CS)
unnamed: C113.2, U31.3 (GND), U31.9 (SD0/SA1)

Notes on the sheet:
Place far from magnetic interference sources

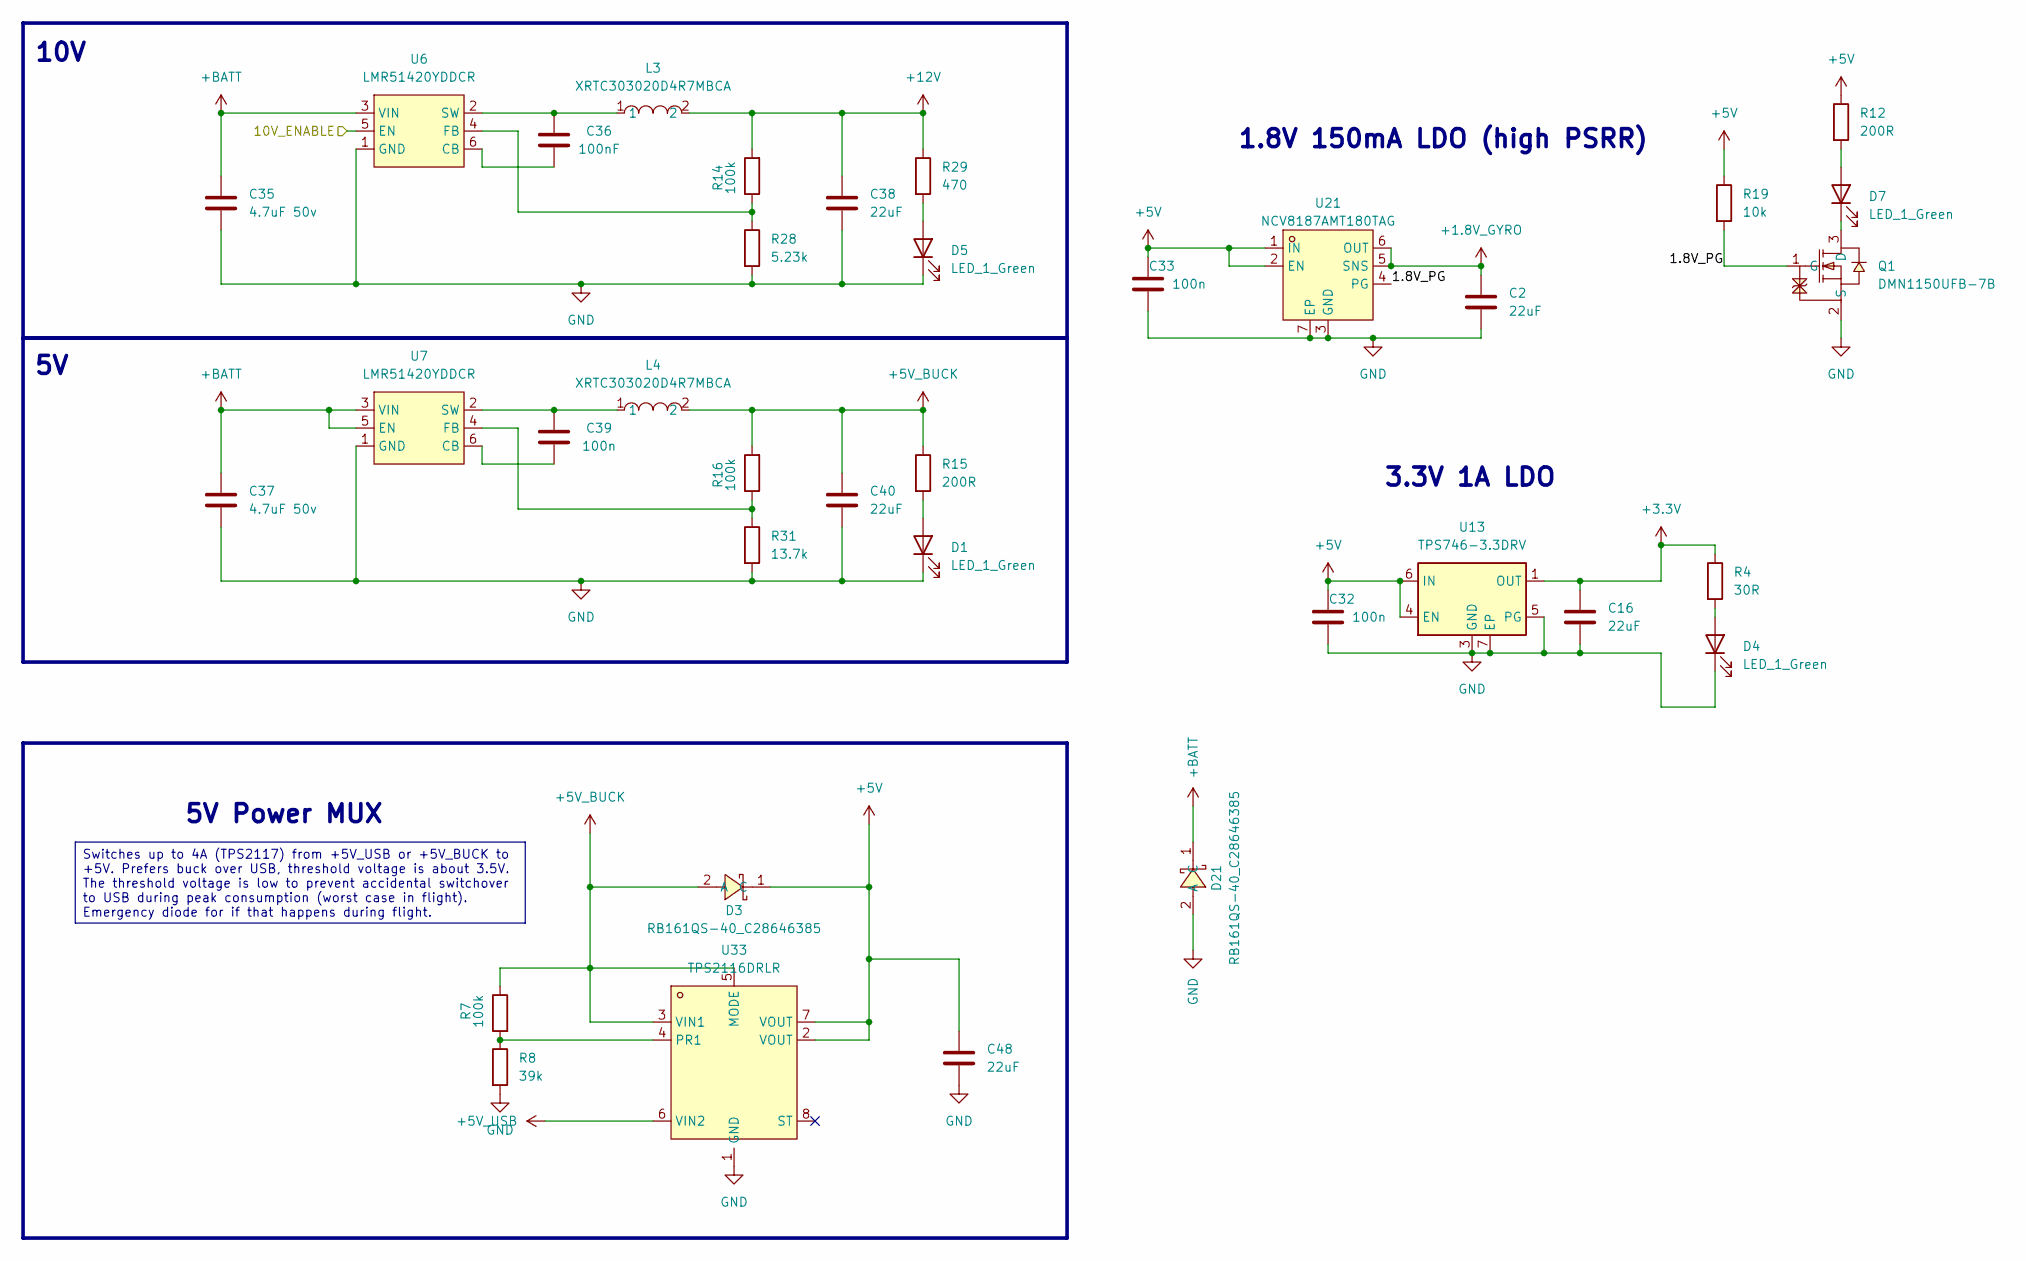
[picture p10: schematic power.kicad_sch]

Parts:
C2, C16: 22uF; C_0402_1005Metric; LCSC C105226
C32, C33, C39: 100n; C_0402_1005Metric; LCSC C1525
C35, C37: 4.7uF 50v; C_0805_2012Metric; LCSC C98192
C36: 100nF; C_0402_1005Metric; LCSC C1525
C38, C40, C48: 22uF; C_0603_1608Metric; LCSC C2762594
D1, D4, D5, D7: LED_1_Green; LED_0603_1608Metric; LCSC C2994781
D3, D21: RB161QS-40_C28646385; SOD-882_L1.0-W0.6-RD; LCSC Part C28646385
L3, L4: XRTC303020D4R7MBCA; IND-SMD_L3.0-W3.0_AFE303020S; LCSC Part C39846837
Q1: DMN1150UFB-7B; DFN-3L_L1.0-W0.6-P0.65-BR; LCSC Part C459538
R4: 30R; R_0402_1005Metric; LCSC C138007
R7, R14, R16: 100k; R_0402_1005Metric; LCSC C60491
R8: 39k; R_0402_1005Metric; LCSC C137995
R12, R15: 200R; R_0402_1005Metric; LCSC C25087
R19: 10k; R_0402_1005Metric; LCSC C25087
R28: 5.23k; R_0402_1005Metric; LCSC C2684530
R29: 470; R_0402_1005Metric; LCSC C114877
R31: 13.7k; R_0402_1005Metric; LCSC C2933072
U6, U7: LMR51420YDDCR; SOT-23-6_L2.9-W1.6-P0.95-LS2.9-BL; LCSC Part C5383002
U13: TPS746-3.3DRV; WSON-6-1EP_2x2mm_P0.65mm_EP1x1.6mm; LCSC C2868202
U21: NCV8187AMT180TAG; WDFN-6_L2.0-W2.0-P0.65-BL-EP; LCSC Part C893189
U33: TPS2116DRLR; SOT-583-8_L2.1-W1.6-P0.50-LS1.6-BL; LCSC Part C3235557

Connections:
+1.8V_GYRO: C2.1, U21.5 (SNS), U21.6 (OUT); also elsewhere on the board
+3.3V: C16.1, R4.1, U13.1 (OUT); also elsewhere on the board
+5V: C32.1, C33.1, C48.1, D3.1 (C), R12.1, R19.1, U13.4 (EN), U13.6 (IN), U21.1 (IN), U21.2 (EN), U33.2 (VOUT), U33.7 (VOUT); also elsewhere on the board
+5V_BUCK: C40.1, D3.2 (A), L4.2, R7.1, R15.1, R16.2, U33.3 (VIN1), U33.5 (MODE); also elsewhere on the board
+5V_USB: U33.6 (VIN2); also elsewhere on the board
+12V: C38.1, L3.2, R14.2, R29.1; also elsewhere on the board
+BATT: C35.1, C37.1, D21.1 (C), U6.3 (VIN), U6.5 (EN), U7.3 (VIN), U7.5 (EN); also elsewhere on the board
/POWER/1.8V_PG: Q1.1 (G), R19.2, U21.4 (PG)
GND: C2.2, C16.2, C32.2, C33.2, C35.2, C37.2, C38.2, C40.2, C48.2, D1.1 (K), D4.1 (K), D5.1 (K), D21.2 (A), Q1.2 (S), R8.2, R28.2, R31.2, U6.1 (GND), U7.1 (GND), U13.3 (GND), U13.5 (PG), U13.7 (EP), U21.3 (GND), U21.7 (EP), U33.1 (GND); also elsewhere on the board
unnamed: D1.2 (A), R15.2
unnamed: D4.2 (A), R4.2
unnamed: D5.2 (A), R29.2
unnamed: D7.2 (A), R12.2
unnamed: D7.1 (K), Q1.3 (D)
unnamed: C36.2, U6.6 (CB)
unnamed: R14.1, R28.1, U6.4 (FB)
unnamed 103: C36.1, L3.1, U6.2 (SW); also elsewhere on the board
unnamed: C39.2, U7.6 (CB)
unnamed: R16.1, R31.1, U7.4 (FB)
unnamed 106: C39.1, L4.1, U7.2 (SW); also elsewhere on the board
unnamed: R7.2, R8.1, U33.4 (PR1)

Notes on the sheet:
10V
3.3V 1A LDO
1.8V 150mA LDO (high PSRR)
5V Power MUX
Switches up to 4A (TPS2117) from +5V_USB or +5V_BUCK to +5V. Prefers buck over USB, threshold voltage is about 3.5V. The threshold voltage is low to prevent accidental switchover to USB during peak consumption (worst case in flight). Emergency diode for if that happens during flight.

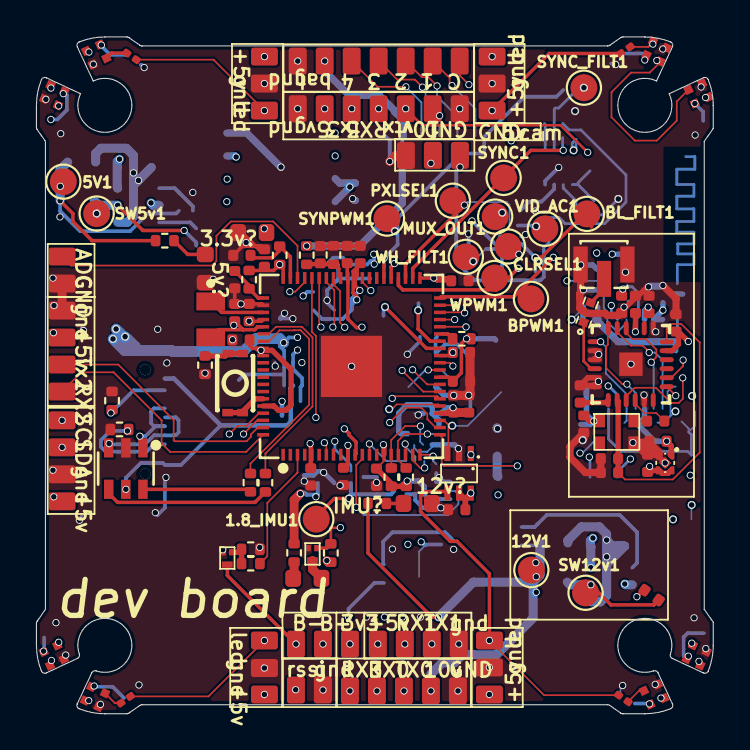
[picture p11: board OpenFC.kicad_pcb from above]

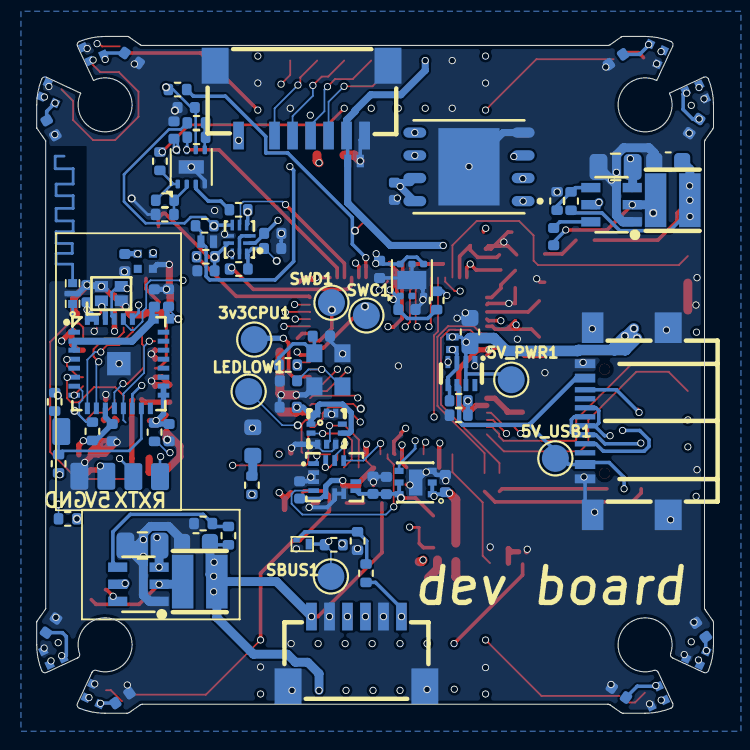
[picture p12: board OpenFC.kicad_pcb from below]

Board: 8 copper layers, 37.6 x 37.6 mm, 253 parts (108 on the bottom side), 131 nets.

Other parts of the board:
1.8_IMU1, 3v3CPU1, 5V1, 5V_PWR1, 5V_USB1, 12V1: TestPoint; TestPoint_Pad_D1.5mm
BL_FILT1: TestPoint; TestPoint_Pad_D1.5mm
BPWM1: TestPoint; TestPoint_Pad_D1.5mm
CLRSEL1: TestPoint; TestPoint_Pad_D1.5mm
LEDLOW1: TestPoint; TestPoint_Pad_D1.5mm
MUX_OUT1: TestPoint; TestPoint_Pad_D1.5mm
PXLSEL1: TestPoint; TestPoint_Pad_D1.5mm
SBUS1: TestPoint; TestPoint_Pad_D1.5mm
SW5v1, SW12v1: TestPoint; TestPoint_Pad_D1.5mm
SWC1: TestPoint; TestPoint_Pad_D1.5mm
SWD1: TestPoint; TestPoint_Pad_D1.5mm
SYNC1: TestPoint; TestPoint_Pad_D1.5mm
SYNC_FILT1: TestPoint; TestPoint_Pad_D1.5mm
SYNPWM1: TestPoint; TestPoint_Pad_D1.5mm
VID_AC1: TestPoint; TestPoint_Pad_D1.5mm
WH_FILT1: TestPoint; TestPoint_Pad_D1.5mm
WPWM1: TestPoint; TestPoint_Pad_D1.5mm

Their connections:
+1.8V_GYRO: 1.8_IMU1.1; also elsewhere on the board
+3.3V: 3v3CPU1.1; also elsewhere on the board
+5V: 5V_PWR1.1; also elsewhere on the board
+5V_BUCK: 5V1.1; also elsewhere on the board
+5V_USB: 5V_USB1.1; also elsewhere on the board
+12V: 12V1.1; also elsewhere on the board
/OSD/OSD_PIXSEL: PXLSEL1.1; also elsewhere on the board
/OSD/OSD_PIX_COLOR: CLRSEL1.1; also elsewhere on the board
/OSD/OSD_SYNCLVL_PWM: SYNPWM1.1; also elsewhere on the board
/OSD/OSD_SYNC_RAW: SYNC1.1; also elsewhere on the board
/OSD/OSD_VBLACK_PWM: BPWM1.1; also elsewhere on the board
/OSD/OSD_VWHITE_PWM: WPWM1.1; also elsewhere on the board
/OSD/VBLACK_FILT: BL_FILT1.1; also elsewhere on the board
/OSD/VID_IN: VID_AC1.1; also elsewhere on the board
/OSD/VID_MUX_OUT: MUX_OUT1.1; also elsewhere on the board
/OSD/VWHITE_FILT: WH_FILT1.1; also elsewhere on the board
/RP2350A/LED_STRIP_L: LEDLOW1.1; also elsewhere on the board
/RP2350A/SBUS_INVERT: SBUS1.1; also elsewhere on the board
unnamed 103: SW12v1.1; also elsewhere on the board
unnamed 106: SW5v1.1; also elsewhere on the board
unnamed 122: SWC1.1; also elsewhere on the board
unnamed 123: SWD1.1; also elsewhere on the board
unnamed 131: SYNC_FILT1.1; also elsewhere on the board
