Just4Stan/betaflight/src/platform/PICO/pwm_motor_pico.c

/*
 * This file is part of Betaflight.
 *
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
 * See the GNU General Public License for more details.
 *
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
 * If not, see <http://www.gnu.org/licenses/>.
 */

#include <stdbool.h>
#include <stdint.h>
#include <math.h>
#include <string.h>

#include "platform.h"

#ifdef USE_PWM_OUTPUT

#include "build/debug.h"
#include "build/debug_pin.h"

#include "drivers/io.h"
#include "drivers/io_impl.h"
#include "drivers/pwm_output.h"
#include "drivers/pwm_output_impl.h"
#include "drivers/motor_types.h"

#include "drivers/time.h"
#include "drivers/timer.h"

#include "pg/motor.h"

#include "hardware/gpio.h"
#include "hardware/pwm.h"
#include "hardware/clocks.h"

#include "platform/pwm.h"

static picoPwmOutput_t picoPwmMotors[MAX_SUPPORTED_MOTORS];
static bool useContinuousUpdate = false;

void pwmShutdownPulsesForAllMotors(void)
{
    for (int index = 0; index < pwmMotorCount; index++) {
        pwm_set_chan_level(picoPwmMotors[index].slice, picoPwmMotors[index].channel, 0);
    }
}

void pwmDisableMotors(void)
{
    pwmShutdownPulsesForAllMotors();
}

static void pwmWriteStandard(uint8_t index, float value)
{
    /* TODO: move value to be a number between 0-1 (i.e. percent throttle from mixer) */
    pwm_set_chan_level(picoPwmMotors[index].slice, picoPwmMotors[index].channel, lrintf((value * pwmMotors[index].pulseScale) + pwmMotors[index].pulseOffset));
}

static void pwmCompleteMotorUpdate(void)
{
    if (useContinuousUpdate) {
        return;
    }

    for (int index = 0; index < pwmMotorCount; index++) {
        pwm_set_chan_level(picoPwmMotors[index].slice, picoPwmMotors[index].channel, 0);
    }
}

static float pwmConvertFromExternal(uint16_t externalValue)
{
    return (float)externalValue;
}

static uint16_t pwmConvertToExternal(float motorValue)
{
    return (uint16_t)motorValue;
}

static motorVTable_t motorPwmVTable = {
    .postInit = NULL,
    .enable = pwmEnableMotors,
    .disable = pwmDisableMotors,
    .isMotorEnabled = pwmIsMotorEnabled,
    .shutdown = pwmShutdownPulsesForAllMotors,
    .convertExternalToMotor = pwmConvertFromExternal,
    .convertMotorToExternal = pwmConvertToExternal,
    .write = pwmWriteStandard,
    .decodeTelemetry = NULL,
    .updateComplete = pwmCompleteMotorUpdate,
    .requestTelemetry = NULL,
    .isMotorIdle = NULL,
    .getMotorIO = pwmGetMotorIO,
};

bool motorPwmDevInit(motorDevice_t *device, const motorDevConfig_t *motorConfig, uint16_t idlePulse)
{
    UNUSED(idlePulse);

    if (!device) {
        return false;
    }

    pwmMotorCount = device->count;

    memset(pwmMotors, 0, sizeof(pwmMotors));

    if (!device || !motorConfig) {
        return false;
    }

    pwmMotorCount = device->count;
    device->vTable = &motorPwmVTable;

    useContinuousUpdate = motorConfig->useContinuousUpdate;

    float sMin = 0;
    float sLen = 0;
    switch (motorConfig->motorProtocol) {
    default:
    case MOTOR_PROTOCOL_ONESHOT125:
        sMin = 125e-6f;
        sLen = 125e-6f;
        break;
    case MOTOR_PROTOCOL_ONESHOT42:
        sMin = 42e-6f;
        sLen = 42e-6f;
        break;
    case MOTOR_PROTOCOL_MULTISHOT:
        sMin = 5e-6f;
        sLen = 20e-6f;
        break;
    case MOTOR_PROTOCOL_BRUSHED:
        sMin = 0;
        useContinuousUpdate = true;
        break;
    case MOTOR_PROTOCOL_PWM :
        sMin = 1e-3f;
        sLen = 1e-3f;
        useContinuousUpdate = true;
        break;
    }

    for (unsigned motorIndex = 0; motorIndex < MAX_SUPPORTED_MOTORS && motorIndex < pwmMotorCount; motorIndex++) {

        const unsigned reorderedMotorIndex = motorConfig->motorOutputReordering[motorIndex];
        const ioTag_t tag = motorConfig->ioTags[reorderedMotorIndex];

        pwmMotors[motorIndex].io = IOGetByTag(tag);
        uint8_t pin = IO_PINBYTAG(tag);

        const uint16_t slice = pwm_gpio_to_slice_num(pin);
        const uint16_t channel = pwm_gpio_to_channel(pin);

        IOInit(pwmMotors[motorIndex].io, OWNER_MOTOR, RESOURCE_INDEX(reorderedMotorIndex));

        picoPwmMotors[motorIndex].slice = slice;
        picoPwmMotors[motorIndex].channel = channel;

        /* standard PWM outputs */
        // margin of safety is 4 periods when not continuous
        const unsigned pwmRateHz = useContinuousUpdate ? motorConfig->motorPwmRate : ceilf(1 / ((sMin + sLen) * 4));

        /*
            PWM Frequency = clock / (interval * (wrap + 1))

            Wrap is when the counter resets to zero.
            Interval (divider) will determine the resolution.
        */
        const uint32_t clock = clock_get_hz(clk_sys); // PICO timer clock is the CPU clock.

        /* used to find the desired timer frequency for max resolution */
        const unsigned prescaler = ceilf(clock / pwmRateHz); /* rounding up */
        const uint32_t hz = clock / prescaler;
        const unsigned period = useContinuousUpdate ? hz / pwmRateHz : 0xffff;

        pwm_config config = pwm_get_default_config();

        const uint8_t interval = (uint8_t)(clock / period);
        const uint8_t fraction = (uint8_t)(((clock / period) - interval) * (0x01 << 4));
        pwm_config_set_clkdiv_int_frac(&config, interval, fraction);
        pwm_config_set_wrap(&config, period);

        gpio_set_function(pin, GPIO_FUNC_PWM);

        pwm_set_chan_level(slice, channel, 0);
        pwm_init(slice, &config, true);

        /*
            if brushed then it is the entire length of the period.
            TODO: this can be moved back to periodMin and periodLen
            once mixer outputs a 0..1 float value.
        */
        pwmMotors[motorIndex].pulseScale = ((motorConfig->motorProtocol == MOTOR_PROTOCOL_BRUSHED) ? period : (sLen * hz)) / 1000.0f;
        pwmMotors[motorIndex].pulseOffset = (sMin * hz) - (pwmMotors[motorIndex].pulseScale * 1000);
        pwmMotors[motorIndex].enabled = true;
        picoPwmMotors[motorIndex].initialised = true;
    }

    return true;
}

#endif // USE_PWM_OUTPUT
