Just4Stan/betaflight/src/main/msp/msp_protocol_v2_betaflight.h

/*
 * This file is part of Cleanflight, Betaflight and INAV.
 *
 * Cleanflight and Betaflight are free software. You can redistribute
 * this software and/or modify this software under the terms of the
 * GNU General Public License as published by the Free Software
 * Foundation, either version 3 of the License, or (at your option)
 * any later version.
 *
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
 * If not, see <http://www.gnu.org/licenses/>.
 */

#define MSP2_BETAFLIGHT_BIND                0x3000
#define MSP2_MOTOR_OUTPUT_REORDERING        0x3001
#define MSP2_SET_MOTOR_OUTPUT_REORDERING    0x3002
#define MSP2_SEND_DSHOT_COMMAND             0x3003
#define MSP2_GET_VTX_DEVICE_STATUS          0x3004
#define MSP2_GET_OSD_WARNINGS               0x3005  // returns active OSD warning message text
#define MSP2_GET_TEXT                       0x3006
#define MSP2_SET_TEXT                       0x3007
#define MSP2_GET_LED_STRIP_CONFIG_VALUES    0x3008
#define MSP2_SET_LED_STRIP_CONFIG_VALUES    0x3009
#define MSP2_SENSOR_CONFIG_ACTIVE           0x300A
#define MSP2_SENSOR_OPTICALFLOW             0x300B
#define MSP2_MCU_INFO                       0x300C
#define MSP2_GYRO_SENSOR_ACTIVE             0x300D
#define MSP2_BATTERY_PROFILE                0x300E
#define MSP2_SET_BATTERY_PROFILE            0x300F
#define MSP2_CLI_SETTING                    0x3010
#define MSP2_CLI_SETTING_INFO               0x3011
#define MSP2_SYSID_RESULT                   0x3012  // out: per-axis on-board PID identifier fit (PR-D)
#define MSP2_SET_SYSID_CMD                  0x3013  // in:  payload byte = 0:wipe / 1:compute_now / 2:apply_suggestion

// MSP2_SET_TEXT and MSP2_GET_TEXT variable types
#define MSP2TEXT_PILOT_NAME                      1
#define MSP2TEXT_CRAFT_NAME                      2
#define MSP2TEXT_PID_PROFILE_NAME                3
#define MSP2TEXT_RATE_PROFILE_NAME               4
#define MSP2TEXT_BUILDKEY                        5
#define MSP2TEXT_RELEASENAME                     6
#define MSP2TEXT_CUSTOM_MSG_0                    7  // CUSTOM_MSG_MAX_NUM  entries are allocated
#define CUSTOM_MSG_MAX_NUM                       4
#define MSP2TEXT_BATTERY_PROFILE_NAME        11
// next new variable type must be >= MSP2TEXT_BATTERY_PROFILE_NAME + 1 (12)
