Just4Stan/betaflight/src/main/cli/cli.c

/*
 * This file is part of Cleanflight and Betaflight.
 *
 * Cleanflight and Betaflight are free software. You can redistribute
 * this software and/or modify this software under the terms of the
 * GNU General Public License as published by the Free Software
 * Foundation, either version 3 of the License, or (at your option)
 * any later version.
 *
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
 * If not, see <http://www.gnu.org/licenses/>.
 */

#include <stdbool.h>
#include <stdint.h>
#include <stdlib.h>
#include <stdarg.h>
#include <string.h>
#include <math.h>
#include <ctype.h>
#include <errno.h>

#include "platform.h"

// FIXME remove this for targets that don't need a CLI.  Perhaps use a no-op macro when USE_CLI is not enabled
// signal that we're in cli mode
bool cliMode = false;

#ifdef USE_CLI

#include "blackbox/blackbox.h"

#include "build/build_config.h"
#include "build/debug.h"
#include "build/version.h"

#include "cli/settings.h"

#include "cms/cms.h"

#include "common/axis.h"
#include "common/color.h"
#include "common/maths.h"
#include "common/printf.h"
#include "common/printf_serial.h"
#include "common/strtol.h"
#include "common/time.h"
#include "common/typeconversion.h"
#include "common/utils.h"

#include "config/config.h"
#include "config/config_eeprom.h"
#include "config/feature.h"
#include "config/simplified_tuning.h"

#include "drivers/accgyro/accgyro.h"
#include "drivers/adc.h"
#include "drivers/buf_writer.h"
#include "drivers/bus_i2c.h"
#include "drivers/bus_spi.h"
#include "drivers/dma.h"
#include "drivers/dma_reqmap.h"
#include "drivers/dshot.h"
#include "drivers/dshot_command.h"
#include "drivers/camera_control.h"
#include "drivers/compass/compass.h"
#include "drivers/display.h"
#include "drivers/dma.h"
#include "drivers/flash/flash.h"
#include "drivers/inverter.h"
#include "drivers/io.h"
#include "drivers/io_impl.h"
#include "drivers/lcd_console.h"
#include "drivers/light_led.h"
#include "drivers/motor.h"
#include "drivers/rangefinder/rangefinder_hcsr04.h"
#include "drivers/resource.h"
#include "drivers/sdcard.h"
#include "drivers/sensor.h"
#include "drivers/serial.h"
#include "drivers/serial_escserial.h"
#include "drivers/sound_beeper.h"
#include "drivers/stack_check.h"
#include "drivers/system.h"
#include "drivers/time.h"
#include "drivers/timer.h"
#include "drivers/transponder_ir.h"
#include "drivers/usb_msc.h"
#include "drivers/vtx_common.h"
#include "drivers/vtx_table.h"

#include "fc/board_info.h"
#include "fc/controlrate_profile.h"
#include "fc/core.h"
#include "fc/rc.h"
#include "fc/rc_adjustments.h"
#include "fc/rc_controls.h"
#include "fc/runtime_config.h"

#include "flight/failsafe.h"
#include "flight/flight_plan_nav.h"
#include "flight/imu.h"
#include "flight/mixer.h"
#include "flight/pid.h"
#include "flight/position.h"
#include "flight/servos.h"

#include "io/asyncfatfs/asyncfatfs.h"
#include "io/beeper.h"
#if ENABLE_FB_OSD
#include "drivers/fb_osd_impl.h"
#include "io/displayport_fb_osd.h"
#endif
#include "io/dronecan/dronecan.h"
#include "io/flashfs.h"
#include "io/gimbal.h"
#include "io/gps.h"
#include "io/ledstrip.h"
#include "io/serial.h"
#include "io/transponder_ir.h"
#include "io/usb_msc.h"
#include "io/vtx_control.h"
#include "io/vtx.h"

#include "msp/msp.h"
#include "msp/msp_box.h"
#include "msp/msp_build_info.h"
#include "msp/msp_protocol.h"

#include "osd/osd.h"

#include "pg/adc.h"
#include "pg/beeper.h"
#include "pg/beeper_dev.h"
#include "pg/board.h"
#include "pg/bus_i2c.h"
#include "pg/bus_spi.h"
#include "pg/can.h"
#include "pg/dronecan.h"
#include "pg/flight_plan.h"
#include "pg/gyrodev.h"
#include "pg/max7456.h"
#include "pg/mco.h"
#include "pg/motor.h"
#include "pg/pilot.h"
#include "pg/pinio.h"
#include "pg/pin_pull_up_down.h"
#include "pg/pg.h"
#include "pg/pg_ids.h"
#include "pg/rx.h"
#include "pg/rx_pwm.h"
#include "pg/rx_spi_cc2500.h"
#include "pg/rx_spi_expresslrs.h"
#include "pg/serial_uart.h"
#include "pg/sdio.h"
#include "pg/timerio.h"
#include "pg/timerup.h"
#include "pg/usb.h"
#include "pg/vtx_table.h"

#include "rx/rx_bind.h"
#include "rx/rx_spi.h"

#include "scheduler/scheduler.h"

#include "sensors/acceleration.h"
#include "sensors/adcinternal.h"
#include "sensors/barometer.h"
#include "sensors/battery.h"
#include "sensors/boardalignment.h"
#include "sensors/compass.h"
#include "sensors/gyro.h"
#include "sensors/gyro_init.h"
#include "sensors/sensors.h"

#include "telemetry/frsky_hub.h"
#include "telemetry/telemetry.h"

#include "cli.h"

static serialPort_t *cliPort = NULL;
static bool cliInteractive = false;
static timeMs_t cliEntryTime = 0;

static bufWriter_t cliWriterDesc;
static bufWriter_t *cliWriter = NULL;
static bufWriter_t *cliErrorWriter = NULL;
static uint8_t cliWriteBuffer[CLI_OUT_BUFFER_SIZE];

static char cliBuffer[CLI_IN_BUFFER_SIZE];
static uint32_t bufferIndex = 0;

static bool configIsInCopy = false;

#define CURRENT_PROFILE_INDEX -1
static int8_t pidProfileIndexToUse = CURRENT_PROFILE_INDEX;
static int8_t rateProfileIndexToUse = CURRENT_PROFILE_INDEX;
static int8_t batteryProfileIndexToUse = CURRENT_PROFILE_INDEX;

#ifdef USE_CLI_BATCH
static bool commandBatchActive = false;
static bool commandBatchError = false;
#endif

#if defined(USE_BOARD_INFO)
static bool boardInformationUpdated = false;
#if defined(USE_SIGNATURE)
static bool signatureUpdated = false;
#endif
#endif // USE_BOARD_INFO

static const char* const emptyName = "-";
static const char* const invalidName = "INVALID";

#define MAX_CHANGESET_ID_LENGTH 8
#define MAX_DATE_LENGTH 20

#define ERROR_INVALID_NAME "INVALID NAME: %s"
#define ERROR_MESSAGE "%s CANNOT BE CHANGED. CURRENT VALUE: '%s'"

#ifndef USE_QUAD_MIXER_ONLY
// sync this with mixerMode_e
static const char * const mixerNames[] = {
    "TRI", "QUADP", "QUADX", "BI",
    "GIMBAL", "Y6", "HEX6",
    "FLYING_WING", "Y4", "HEX6X", "OCTOX8", "OCTOFLATP", "OCTOFLATX",
    "AIRPLANE", "HELI_120_CCPM", "HELI_90_DEG", "VTAIL4",
    "HEX6H", "PPM_TO_SERVO", "DUALCOPTER", "SINGLECOPTER",
    "ATAIL4", "CUSTOM", "CUSTOMAIRPLANE", "CUSTOMTRI", "QUADX1234",
    "OCTOX8P", NULL
};
#endif

// sync this with features_e
#define _R(_flag, _name) [LOG2(_flag)] = _name
static const char * const featureNames[] = {
    _R(FEATURE_RX_PPM, "RX_PPM"),
    _R(FEATURE_RX_UDP, "RX_UDP"),
    _R(FEATURE_INFLIGHT_ACC_CAL, "INFLIGHT_ACC_CAL"),
    _R(FEATURE_RX_SERIAL, "RX_SERIAL"),
    _R(FEATURE_MOTOR_STOP, "MOTOR_STOP"),
    _R(FEATURE_SERVO_TILT, "SERVO_TILT"),
    _R(FEATURE_SOFTSERIAL, "SOFTSERIAL"),
    _R(FEATURE_GPS, "GPS"),
    _R(FEATURE_RANGEFINDER, "RANGEFINDER"),
    _R(FEATURE_OPTICALFLOW, "OPTICALFLOW"),
    _R(FEATURE_TELEMETRY, "TELEMETRY"),
    _R(FEATURE_3D, "3D"),
    _R(FEATURE_RX_PARALLEL_PWM, "RX_PARALLEL_PWM"),
    _R(FEATURE_RX_MSP, "RX_MSP"),
    _R(FEATURE_RSSI_ADC, "RSSI_ADC"),
    _R(FEATURE_LED_STRIP, "LED_STRIP"),
    _R(FEATURE_DASHBOARD, "DISPLAY"),
    _R(FEATURE_OSD, "OSD"),
    _R(FEATURE_CHANNEL_FORWARDING, "CHANNEL_FORWARDING"),
    _R(FEATURE_TRANSPONDER, "TRANSPONDER"),
    _R(FEATURE_AIRMODE, "AIRMODE"),
    _R(FEATURE_RX_SPI, "RX_SPI"),
    _R(FEATURE_ESC_SENSOR, "ESC_SENSOR"),
    _R(FEATURE_ANTI_GRAVITY, "ANTI_GRAVITY"),
};
#undef _R

// sync this with rxFailsafeChannelMode_e
static const char rxFailsafeModeCharacters[] = "ahs";

static const rxFailsafeChannelMode_e rxFailsafeModesTable[RX_FAILSAFE_TYPE_COUNT][RX_FAILSAFE_MODE_COUNT] = {
    { RX_FAILSAFE_MODE_AUTO, RX_FAILSAFE_MODE_HOLD, RX_FAILSAFE_MODE_SET },
    { RX_FAILSAFE_MODE_INVALID, RX_FAILSAFE_MODE_HOLD, RX_FAILSAFE_MODE_SET }
};

#if defined(USE_SENSOR_NAMES)
// sync this with sensors_e
static const char *const sensorTypeDisplayNames[] = {
    "GYRO", "ACC", "BARO", "MAG", "RANGEFINDER", "OPTICAL-FLOW"
};
STATIC_ASSERT(SENSOR_INDEX_COUNT == ARRAYLEN(sensorTypeDisplayNames), sensorTypeDisplayNames_array_length_mismatch);
#endif // USE_SENSOR_NAMES

static const char *configurationStates[] = {
    [CONFIGURATION_STATE_UNCONFIGURED] = "UNCONFIGURED",
    [CONFIGURATION_STATE_CONFIGURED] = "CONFIGURED"
};

typedef enum dumpFlags_e {
    DUMP_MASTER = (1 << 0),
    DUMP_PROFILE = (1 << 1),
    DUMP_RATES = (1 << 2),
    DUMP_ALL = (1 << 3),
    DO_DIFF = (1 << 4),
    SHOW_DEFAULTS = (1 << 5),
    HIDE_UNUSED = (1 << 6),
    HARDWARE_ONLY = (1 << 7),
    BARE = (1 << 8),
} dumpFlags_t;

static void cliExit(const bool reboot);
typedef bool printFn(dumpFlags_t dumpMask, bool equalsDefault, const char *format, ...);

typedef enum {
    REBOOT_TARGET_FIRMWARE,
    REBOOT_TARGET_BOOTLOADER_ROM,
    REBOOT_TARGET_BOOTLOADER_FLASH,
} rebootTarget_e;

typedef struct serialPassthroughPort_s {
    serialPortIdentifier_e id;
    uint32_t baud;
    portMode_e mode;
    portOptions_e options;
    serialPort_t *port;
} serialPassthroughPort_t;

static void cliClearInputBuffer(void)
{
    memset(cliBuffer, 0, sizeof(cliBuffer));
    bufferIndex = 0;
}

static void cliWriterFlushInternal(bufWriter_t *writer)
{
    if (writer) {
        bufWriterFlush(writer);
    }
}

static void cliPrintInternal(bufWriter_t *writer, const char *str)
{
    if (writer) {
        while (*str) {
            bufWriterAppend(writer, *str++);
        }
        cliWriterFlushInternal(writer);
    }
}

static void cliWriterFlush(void)
{
    cliWriterFlushInternal(cliWriter);
}

#ifdef USE_CLI_DEBUG_PRINT
#define CLI_DEBUG_EXPORT /* empty */
#else
#define CLI_DEBUG_EXPORT static
#endif

CLI_DEBUG_EXPORT void cliPrint(const char *str)
{
    cliPrintInternal(cliWriter, str);
}

CLI_DEBUG_EXPORT void cliPrintLinefeed(void)
{
    cliPrint("\r\n");
}

CLI_DEBUG_EXPORT void cliPrintLine(const char *str)
{
    cliPrint(str);
    cliPrintLinefeed();
}

static void cliPrintHashLine(const char *str)
{
#ifndef MINIMAL_CLI
    cliPrint("\r\n# ");
    cliPrintLine(str);
#else
    UNUSED(str);
#endif
}

static void cliPutp(void *p, char ch)
{
    bufWriterAppend(p, ch);
}

static void cliPrintfva(const char *format, va_list va)
{
    if (cliWriter) {
        tfp_format(cliWriter, cliPutp, format, va);
        cliWriterFlush();
    }
}

static bool cliDumpPrintLinef(dumpFlags_t dumpMask, bool equalsDefault, const char *format, ...)
{
    if (!((dumpMask & DO_DIFF) && equalsDefault)) {
        va_list va;
        va_start(va, format);
        cliPrintfva(format, va);
        va_end(va);
        cliPrintLinefeed();
        return true;
    } else {
        return false;
    }
}

static void cliWrite(uint8_t ch)
{
    if (cliWriter) {
        bufWriterAppend(cliWriter, ch);
    }
}

static bool cliDefaultPrintLinef(dumpFlags_t dumpMask, bool equalsDefault, const char *format, ...)
{
    if ((dumpMask & SHOW_DEFAULTS) && !equalsDefault) {
        cliWrite('#');

        va_list va;
        va_start(va, format);
        cliPrintfva(format, va);
        va_end(va);
        cliPrintLinefeed();
        return true;
    } else {
        return false;
    }
}

CLI_DEBUG_EXPORT void cliPrintf(const char *format, ...)
{
    va_list va;
    va_start(va, format);
    cliPrintfva(format, va);
    va_end(va);
}

CLI_DEBUG_EXPORT void cliPrintLinef(const char *format, ...)
{
    va_list va;
    va_start(va, format);
    cliPrintfva(format, va);
    va_end(va);
    cliPrintLinefeed();
}

static const char *cliEnvFilter;

static bool cliEnvKeyMatches(const char *name)
{
    return !cliEnvFilter || strncmp(name, cliEnvFilter, strlen(cliEnvFilter)) == 0;
}

static void cliPrintNameValue(const char *name, const char *value)
{
    if (!cliEnvKeyMatches(name)) {
        return;
    }
    cliPrintf("%s=%s", name, value);
    cliPrintLinefeed();
}

static void cliPrintNameValuef(const char *name, const char *format, ...)
{
    if (!cliEnvKeyMatches(name)) {
        return;
    }
    cliPrintf("%s=", name);
    va_list va;
    va_start(va, format);
    cliPrintfva(format, va);
    va_end(va);
    cliPrintLinefeed();
}

static void cliPrintErrorVa(const char *cmdName, const char *format, va_list va)
{
    if (cliErrorWriter) {
        cliPrintInternal(cliErrorWriter, "###ERROR IN ");
        cliPrintInternal(cliErrorWriter, cmdName);
        cliPrintInternal(cliErrorWriter, ": ");

        tfp_format(cliErrorWriter, cliPutp, format, va);
        va_end(va);

        cliPrintInternal(cliErrorWriter, "###");
    }

#ifdef USE_CLI_BATCH
    if (commandBatchActive) {
        commandBatchError = true;
    }
#endif
}

static void cliPrintError(const char *cmdName, const char *format, ...)
{
    va_list va;
    va_start(va, format);
    cliPrintErrorVa(cmdName, format, va);
    va_end(va);

    if (!cliWriter) {
        // Supply our own linefeed in case we are printing inside a custom defaults operation
        // TODO: Fix this by rewriting the entire CLI to have self contained line feeds
        // instead of expecting the directly following command to supply the line feed.
        cliPrintInternal(cliErrorWriter, "\r\n");
    }
}

static void cliPrintErrorLinef(const char *cmdName, const char *format, ...)
{
    va_list va;
    va_start(va, format);
    cliPrintErrorVa(cmdName, format, va);
    va_end(va);
    cliPrintInternal(cliErrorWriter, "\r\n");
}

static void getMinMax(const clivalue_t *var, int *min, int *max)
{
    switch (var->type & VALUE_TYPE_MASK) {
    case VAR_UINT8:
    case VAR_UINT16:
        *min = var->config.minmaxUnsigned.min;
        *max = var->config.minmaxUnsigned.max;

        break;
    default:
        *min = var->config.minmax.min;
        *max = var->config.minmax.max;

        break;
    }
}

// Returns the full required length (excluding NUL), copying up to bufLen-1 bytes.
// If return value >= bufLen, the output was truncated.
// Returns -1 if the value is corrupted (e.g., NULL lookup entry).
static int sprintValuePointer(char *buf, int bufLen, const clivalue_t *var, const void *valuePointer)
{
    int required = 0;

    if ((var->type & VALUE_MODE_MASK) == MODE_ARRAY) {
        for (int i = 0; i < var->config.array.length; i++) {
            int val = 0;
            switch (var->type & VALUE_TYPE_MASK) {
            default:
            case VAR_UINT8:
                val = ((uint8_t *)valuePointer)[i];
                break;
            case VAR_INT8:
                val = ((int8_t *)valuePointer)[i];
                break;
            case VAR_UINT16:
                val = ((uint16_t *)valuePointer)[i];
                break;
            case VAR_INT16:
                val = ((int16_t *)valuePointer)[i];
                break;
            case VAR_UINT32:
                val = ((uint32_t *)valuePointer)[i];
                break;
            case VAR_INT32:
                val = ((int32_t *)valuePointer)[i];
                break;
            }
            char tmp[16];
            int n;
            if ((var->type & VALUE_TYPE_MASK) == VAR_UINT32) {
                n = tfp_sprintf(tmp, "%u", (uint32_t)val);
            } else {
                n = tfp_sprintf(tmp, "%d", val);
            }
            if (required < bufLen - 1) {
                const int rem = bufLen - 1 - required;
                const int copy = MIN(n, rem);
                memcpy(buf + required, tmp, copy);
            }
            required += n;
            if (i < var->config.array.length - 1) {
                if (required < bufLen - 1) {
                    buf[required] = ',';
                }
                required++;
            }
        }
    } else {
        int value = 0;

        switch (var->type & VALUE_TYPE_MASK) {
        case VAR_UINT8:
            value = *(uint8_t *)valuePointer;
            break;
        case VAR_INT8:
            value = *(int8_t *)valuePointer;
            break;
        case VAR_UINT16:
            value = *(uint16_t *)valuePointer;
            break;
        case VAR_INT16:
            value = *(int16_t *)valuePointer;
            break;
        case VAR_UINT32:
            value = *(uint32_t *)valuePointer;
            break;
        case VAR_INT32:
            value = *(int32_t *)valuePointer;
            break;
        }

        switch (var->type & VALUE_MODE_MASK) {
        case MODE_DIRECT: {
                char tmp[16];
                int n;
                if ((var->type & VALUE_TYPE_MASK) == VAR_UINT32) {
                    n = tfp_sprintf(tmp, "%u", (uint32_t)value);
                } else {
                    n = tfp_sprintf(tmp, "%d", value);
                }
                const int copy = MIN(n, bufLen - 1);
                memcpy(buf, tmp, copy);
                required = n;
            }
            break;
        case MODE_LOOKUP: {
                if (value < 0 || value >= lookupTables[var->config.lookup.tableIndex].valueCount
                    || !lookupTables[var->config.lookup.tableIndex].values[value]) {
                    if (bufLen > 0) {
                        buf[0] = '\0';
                    }
                    return -1;
                }

                const char *str = lookupTables[var->config.lookup.tableIndex].values[value];
                required = strlen(str);
                const int copy = MIN(required, bufLen - 1);
                memcpy(buf, str, copy);
            }
            break;
        case MODE_BITSET: {
                const char *str = (value & 1U << var->config.bitpos) ? "ON" : "OFF";
                required = strlen(str);
                const int copy = MIN(required, bufLen - 1);
                memcpy(buf, str, copy);
            }
            break;
        case MODE_STRING: {
                const int maxLen = var->config.string.maxlength;
                const size_t sLen = strnlen((const char *)valuePointer, maxLen);
                const char *str = (sLen == 0) ? "-" : (const char *)valuePointer;
                required = (sLen == 0) ? 1 : (int)sLen;
                const int copy = MIN(required, bufLen - 1);
                memcpy(buf, str, copy);
            }
            break;
        }
    }

    const int written = MIN(required, bufLen - 1);
    if (written >= 0 && written < bufLen) {
        buf[written] = '\0';
    }
    return required;
}

static void printValuePointer(const char *cmdName, const clivalue_t *var, const void *valuePointer, bool full)
{
    char buf[256];
    sprintValuePointer(buf, sizeof(buf), var, valuePointer);
    cliPrint(buf);

    if ((var->type & VALUE_MODE_MASK) != MODE_ARRAY) {
        int value = 0;

        switch (var->type & VALUE_TYPE_MASK) {
        case VAR_UINT8:
            value = *(uint8_t *)valuePointer;
            break;
        case VAR_INT8:
            value = *(int8_t *)valuePointer;
            break;
        case VAR_UINT16:
            value = *(uint16_t *)valuePointer;
            break;
        case VAR_INT16:
            value = *(int16_t *)valuePointer;
            break;
        case VAR_UINT32:
            value = *(uint32_t *)valuePointer;
            break;
        case VAR_INT32:
            value = *(int32_t *)valuePointer;
            break;
        }

        bool valueIsCorrupted = false;
        switch (var->type & VALUE_MODE_MASK) {
        case MODE_DIRECT:
            if ((var->type & VALUE_TYPE_MASK) == VAR_UINT32) {
                if ((uint32_t)value > var->config.u32Max) {
                    valueIsCorrupted = true;
                } else if (full) {
                    cliPrintf(" 0 %u", var->config.u32Max);
                }
            } else if ((var->type & VALUE_TYPE_MASK) == VAR_INT32) {
                if ((int32_t)value > var->config.d32Max || (int32_t)value < -var->config.d32Max) {
                    valueIsCorrupted = true;
                } else if (full) {
                    cliPrintf(" 0 %u", var->config.u32Max);
                }
            } else {
                int min;
                int max;
                getMinMax(var, &min, &max);
                if ((value < min) || (value > max)) {
                    valueIsCorrupted = true;
                } else if (full) {
                    cliPrintf(" %d %d", min, max);
                }
            }
            break;
        case MODE_LOOKUP:
            if (value < 0 || value >= lookupTables[var->config.lookup.tableIndex].valueCount
                || !lookupTables[var->config.lookup.tableIndex].values[value]) {
                valueIsCorrupted = true;
            }
            break;
        }

        if (valueIsCorrupted) {
            cliPrintLinefeed();
            cliPrintError(cmdName, "CORRUPTED CONFIG: %s = %d", var->name, value);
        }
    }
}

static bool valuePtrEqualsDefault(const clivalue_t *var, const void *ptr, const void *ptrDefault)
{
    bool result = true;
    int elementCount = 1;
    uint32_t mask = 0xffffffff;

    if ((var->type & VALUE_MODE_MASK) == MODE_ARRAY) {
        elementCount = var->config.array.length;
    }
    if ((var->type & VALUE_MODE_MASK) == MODE_BITSET) {
        mask = 1U << var->config.bitpos;
    }
    for (int i = 0; i < elementCount; i++) {
        switch (var->type & VALUE_TYPE_MASK) {
        case VAR_UINT8:
            result = result && (((uint8_t *)ptr)[i] & mask) == (((uint8_t *)ptrDefault)[i] & mask);
            break;

        case VAR_INT8:
            result = result && ((int8_t *)ptr)[i] == ((int8_t *)ptrDefault)[i];
            break;

        case VAR_UINT16:
            result = result && (((uint16_t *)ptr)[i] & mask) == (((uint16_t *)ptrDefault)[i] & mask);
            break;
        case VAR_INT16:
            result = result && ((int16_t *)ptr)[i] == ((int16_t *)ptrDefault)[i];
            break;
        case VAR_UINT32:
            result = result && (((uint32_t *)ptr)[i] & mask) == (((uint32_t *)ptrDefault)[i] & mask);
            break;
        case VAR_INT32:
            result = result && (((int32_t *)ptr)[i] & mask) == (((int32_t *)ptrDefault)[i] & mask);
            break;
        }
    }

    return result;
}

static const char *cliPrintSectionHeading(dumpFlags_t dumpMask, bool outputFlag, const char *headingStr)
{
    if (headingStr && (!(dumpMask & DO_DIFF) || outputFlag)) {
        cliPrintHashLine(headingStr);
        return NULL;
    } else {
        return headingStr;
    }
}

static void backupPgConfig(const pgRegistry_t *pg)
{
    memcpy(pg->copy, pg->address, pg->size);
}

static void restorePgConfig(const pgRegistry_t *pg, uint16_t notToRestoreGroupId)
{
    if (!notToRestoreGroupId || pgN(pg) != notToRestoreGroupId) {
        memcpy(pg->address, pg->copy, pg->size);
    }
}

static void backupConfigs(void)
{
    if (configIsInCopy) {
        return;
    }

    PG_FOREACH(pg) {
        backupPgConfig(pg);
    }

    configIsInCopy = true;
}

static void restoreConfigs(uint16_t notToRestoreGroupId)
{
    if (!configIsInCopy) {
        return;
    }

    PG_FOREACH(pg) {
        restorePgConfig(pg, notToRestoreGroupId);
    }

    configIsInCopy = false;
}

#if defined(USE_RESOURCE_MGMT) || defined(USE_TIMER_MGMT)
static bool isReadingConfigFromCopy(void)
{
    return configIsInCopy;
}
#endif

static bool isWritingConfigToCopy(void)
{
    return configIsInCopy;
}

static void backupAndResetConfigs(void)
{
    backupConfigs();
    // reset all configs to defaults to do differencing
    resetConfig();
}

static uint8_t getPidProfileIndexToUse(void)
{
    return pidProfileIndexToUse == CURRENT_PROFILE_INDEX ? getCurrentPidProfileIndex() : pidProfileIndexToUse;
}

static uint8_t getRateProfileIndexToUse(void)
{
    return rateProfileIndexToUse == CURRENT_PROFILE_INDEX ? getCurrentControlRateProfileIndex() : rateProfileIndexToUse;
}

static uint8_t getBatteryProfileIndexToUse(void)
{
    return batteryProfileIndexToUse == CURRENT_PROFILE_INDEX ? getCurrentBatteryProfileIndex() : batteryProfileIndexToUse;
}

static uint16_t getValueOffset(const clivalue_t *value)
{
    switch (value->type & VALUE_SECTION_MASK) {
    case MASTER_VALUE:
    case HARDWARE_VALUE:
        return value->offset;
    case PROFILE_VALUE:
        return value->offset + sizeof(pidProfile_t) * getPidProfileIndexToUse();
    case PROFILE_RATE_VALUE:
        return value->offset + sizeof(controlRateConfig_t) * getRateProfileIndexToUse();
    case PROFILE_BATTERY_VALUE:
        return value->offset + sizeof(batteryProfile_t) * getBatteryProfileIndexToUse();
    }
    return 0;
}

STATIC_UNIT_TESTED void *cliGetValuePointer(const clivalue_t *value)
{
    const pgRegistry_t* rec = pgFind(value->pgn);
    if (isWritingConfigToCopy()) {
        return CONST_CAST(void *, rec->copy + getValueOffset(value));
    } else {
        return CONST_CAST(void *, rec->address + getValueOffset(value));
    }
}

static const char *dumpPgValue(const char *cmdName, const clivalue_t *value, dumpFlags_t dumpMask, const char *headingStr)
{
    const pgRegistry_t *pg = pgFind(value->pgn);
#ifdef DEBUG
    if (!pg) {
        cliPrintLinef("VALUE %s ERROR", value->name);
        return headingStr; // if it's not found, the pgn shouldn't be in the value table!
    }
#endif

    const char *format = "set %s = ";
    const char *defaultFormat = "#set %s = ";
    const int valueOffset = getValueOffset(value);
    const bool equalsDefault = valuePtrEqualsDefault(value, pg->copy + valueOffset, pg->address + valueOffset);

    headingStr = cliPrintSectionHeading(dumpMask, !equalsDefault, headingStr);
    if (((dumpMask & DO_DIFF) == 0) || !equalsDefault) {
        if (dumpMask & SHOW_DEFAULTS && !equalsDefault) {
            cliPrintf(defaultFormat, value->name);
            printValuePointer(cmdName, value, (uint8_t*)pg->address + valueOffset, false);
            cliPrintLinefeed();
        }
        cliPrintf(format, value->name);
        printValuePointer(cmdName, value, pg->copy + valueOffset, false);
        cliPrintLinefeed();
    }
    return headingStr;
}

static void dumpAllValues(const char *cmdName, uint16_t valueSection, dumpFlags_t dumpMask, const char *headingStr)
{
    headingStr = cliPrintSectionHeading(dumpMask, false, headingStr);

    for (uint32_t i = 0; i < valueTableEntryCount; i++) {
        const clivalue_t *value = &valueTable[i];
        cliWriterFlush();
        if ((value->type & VALUE_SECTION_MASK) == valueSection || ((valueSection == MASTER_VALUE) && (value->type & VALUE_SECTION_MASK) == HARDWARE_VALUE)) {
            headingStr = dumpPgValue(cmdName, value, dumpMask, headingStr);
        }
    }
}

static void cliPrintVar(const char *cmdName, const clivalue_t *var, bool full)
{
    const void *ptr = cliGetValuePointer(var);

    printValuePointer(cmdName, var, ptr, full);
}

static void cliPrintVarRange(const clivalue_t *var)
{
    switch (var->type & VALUE_MODE_MASK) {
    case (MODE_DIRECT): {
        switch (var->type & VALUE_TYPE_MASK) {
        case VAR_UINT32:
            cliPrintLinef("Allowed range: 0 - %u", var->config.u32Max);

            break;
        case VAR_INT32:
            cliPrintLinef("Allowed range: %d - %d", -var->config.d32Max, var->config.d32Max);

            break;
        case VAR_UINT8:
        case VAR_UINT16:
            cliPrintLinef("Allowed range: %d - %d", var->config.minmaxUnsigned.min, var->config.minmaxUnsigned.max);

            break;
        default:
            cliPrintLinef("Allowed range: %d - %d", var->config.minmax.min, var->config.minmax.max);

            break;
        }
    }
    break;
    case (MODE_LOOKUP): {
        const lookupTableEntry_t *tableEntry = &lookupTables[var->config.lookup.tableIndex];
        cliPrint("Allowed values: ");
        bool firstEntry = true;
        for (unsigned i = 0; i < tableEntry->valueCount; i++) {
            if (tableEntry->values[i]) {
                if (!firstEntry) {
                    cliPrint(", ");
                }
                cliPrintf("%s", tableEntry->values[i]);
                firstEntry = false;
            }
        }
        cliPrintLinefeed();
    }
    break;
    case (MODE_ARRAY): {
        cliPrintLinef("Array length: %d", var->config.array.length);
    }
    break;
    case (MODE_STRING): {
        cliPrintLinef("String length: %d - %d", var->config.string.minlength, var->config.string.maxlength);
    }
    break;
    case (MODE_BITSET): {
        cliPrintLinef("Allowed values: OFF, ON");
    }
    break;
    }
}

static void cliSetVar(const clivalue_t *var, const uint32_t value)
{
    void *ptr = cliGetValuePointer(var);
    uint32_t workValue;
    uint32_t mask;

    if ((var->type & VALUE_MODE_MASK) == MODE_BITSET) {
        switch (var->type & VALUE_TYPE_MASK) {
        case VAR_UINT8:
            mask = (1U << var->config.bitpos) & 0xff;
            if (value) {
                workValue = *(uint8_t *)ptr | mask;
            } else {
                workValue = *(uint8_t *)ptr & ~mask;
            }
            *(uint8_t *)ptr = workValue;
            break;

        case VAR_UINT16:
            mask = (1U << var->config.bitpos) & 0xffff;
            if (value) {
                workValue = *(uint16_t *)ptr | mask;
            } else {
                workValue = *(uint16_t *)ptr & ~mask;
            }
            *(uint16_t *)ptr = workValue;
            break;

        case VAR_UINT32:
            mask = 1U << var->config.bitpos;
            if (value) {
                workValue = *(uint32_t *)ptr | mask;
            } else {
                workValue = *(uint32_t *)ptr & ~mask;
            }
            *(uint32_t *)ptr = workValue;
            break;

        case VAR_INT32:
            mask = 1U << var->config.bitpos;
            if (value) {
                workValue = *(int32_t *)ptr | mask;
            } else {
                workValue = *(int32_t *)ptr & ~mask;
            }
            *(int32_t *)ptr = workValue;
            break;
        }
    } else {
        switch (var->type & VALUE_TYPE_MASK) {
        case VAR_UINT8:
            *(uint8_t *)ptr = value;
            break;

        case VAR_INT8:
            *(int8_t *)ptr = value;
            break;

        case VAR_UINT16:
            *(uint16_t *)ptr = value;
            break;

        case VAR_INT16:
            *(int16_t *)ptr = value;
            break;

        case VAR_UINT32:
            *(uint32_t *)ptr = value;
            break;

        case VAR_INT32:
            *(int32_t *)ptr = value;
            break;
        }
    }
}

#if defined(USE_RESOURCE_MGMT) && !defined(MINIMAL_CLI)
static void cliRepeat(char ch, uint8_t len)
{
    if (cliWriter) {
        for (int i = 0; i < len; i++) {
            bufWriterAppend(cliWriter, ch);
        }
        cliPrintLinefeed();
    }
}
#endif

static char *skipSpace(char *buffer)
{
    while (*(buffer) == ' ') {
        buffer++;
    }

    return buffer;
}

static void cliPrompt(void)
{
    cliPrint("\r\n# ");
}

static void cliShowParseError(const char *cmdName)
{
    cliPrintErrorLinef(cmdName, "PARSING FAILED");
}

static void cliShowInvalidArgumentCountError(const char *cmdName)
{
    cliPrintErrorLinef(cmdName, "INVALID ARGUMENT COUNT");
}

static void cliShowArgumentRangeError(const char *cmdName, char *name, int min, int max)
{
    if (name) {
        cliPrintErrorLinef(cmdName, "%s NOT BETWEEN %d AND %d", name, min, max);
    } else {
        cliPrintErrorLinef(cmdName, "ARGUMENT OUT OF RANGE");
    }
}

static const char *nextArg(const char *currentArg)
{
    if (!currentArg) {
        return NULL;
    }
    const char *ptr = strchr(currentArg, ' ');
    while (ptr && *ptr == ' ') {
        ptr++;
    }

    return ptr;
}

static const char *processChannelRangeArgs(const char *ptr, channelRange_t *range, uint8_t *validArgumentCount)
{
    for (uint32_t argIndex = 0; argIndex < 2; argIndex++) {
        ptr = nextArg(ptr);
        if (ptr) {
            int val = atoi(ptr);
            val = CHANNEL_VALUE_TO_STEP(val);
            if (val >= MIN_MODE_RANGE_STEP && val <= MAX_MODE_RANGE_STEP) {
                if (argIndex == 0) {
                    range->startStep = val;
                } else {
                    range->endStep = val;
                }
                (*validArgumentCount)++;
            }
        }
    }

    return ptr;
}

// Check if a string's length is zero
static bool isEmpty(const char *string)
{
    return (string == NULL || *string == '\0') ? true : false;
}

static void printRxFailsafe(dumpFlags_t dumpMask, const rxFailsafeChannelConfig_t *rxFailsafeChannelConfigs, const rxFailsafeChannelConfig_t *defaultRxFailsafeChannelConfigs, const char *headingStr)
{
    // print out rxConfig failsafe settings
    headingStr = cliPrintSectionHeading(dumpMask, false, headingStr);
    for (uint32_t channel = 0; channel < MAX_SUPPORTED_RC_CHANNEL_COUNT; channel++) {
        const rxFailsafeChannelConfig_t *channelFailsafeConfig = &rxFailsafeChannelConfigs[channel];
        const rxFailsafeChannelConfig_t *defaultChannelFailsafeConfig = &defaultRxFailsafeChannelConfigs[channel];
        const bool equalsDefault = !memcmp(channelFailsafeConfig, defaultChannelFailsafeConfig, sizeof(*channelFailsafeConfig));
        const bool requireValue = channelFailsafeConfig->mode == RX_FAILSAFE_MODE_SET;
        headingStr = cliPrintSectionHeading(dumpMask, !equalsDefault, headingStr);
        if (requireValue) {
            const char *format = "rxfail %u %c %d";
            cliDefaultPrintLinef(dumpMask, equalsDefault, format,
                channel,
                rxFailsafeModeCharacters[defaultChannelFailsafeConfig->mode],
                RXFAIL_STEP_TO_CHANNEL_VALUE(defaultChannelFailsafeConfig->step)
            );
            cliDumpPrintLinef(dumpMask, equalsDefault, format,
                channel,
                rxFailsafeModeCharacters[channelFailsafeConfig->mode],
                RXFAIL_STEP_TO_CHANNEL_VALUE(channelFailsafeConfig->step)
            );
        } else {
            const char *format = "rxfail %u %c";
            cliDefaultPrintLinef(dumpMask, equalsDefault, format,
                channel,
                rxFailsafeModeCharacters[defaultChannelFailsafeConfig->mode]
            );
            cliDumpPrintLinef(dumpMask, equalsDefault, format,
                channel,
                rxFailsafeModeCharacters[channelFailsafeConfig->mode]
            );
        }
    }
}

static void cliRxFailsafe(const char *cmdName, char *cmdline)
{
    uint8_t channel;
    char buf[3];

    if (isEmpty(cmdline)) {
        // print out rxConfig failsafe settings
        for (channel = 0; channel < MAX_SUPPORTED_RC_CHANNEL_COUNT; channel++) {
            cliRxFailsafe(cmdName, itoa(channel, buf, 10));
        }
    } else {
        const char *ptr = cmdline;
        channel = atoi(ptr++);
        if ((channel < MAX_SUPPORTED_RC_CHANNEL_COUNT)) {

            rxFailsafeChannelConfig_t *channelFailsafeConfig = rxFailsafeChannelConfigsMutable(channel);

            const rxFailsafeChannelType_e type = (channel < NON_AUX_CHANNEL_COUNT) ? RX_FAILSAFE_TYPE_FLIGHT : RX_FAILSAFE_TYPE_AUX;
            rxFailsafeChannelMode_e mode = channelFailsafeConfig->mode;
            bool requireValue = channelFailsafeConfig->mode == RX_FAILSAFE_MODE_SET;

            ptr = nextArg(ptr);
            if (ptr) {
                const char *p = strchr(rxFailsafeModeCharacters, *(ptr));
                if (p) {
                    const uint8_t requestedMode = p - rxFailsafeModeCharacters;
                    mode = rxFailsafeModesTable[type][requestedMode];
                } else {
                    mode = RX_FAILSAFE_MODE_INVALID;
                }
                if (mode == RX_FAILSAFE_MODE_INVALID) {
                    cliShowParseError(cmdName);
                    return;
                }

                requireValue = mode == RX_FAILSAFE_MODE_SET;

                ptr = nextArg(ptr);
                if (ptr) {
                    if (!requireValue) {
                        cliShowParseError(cmdName);
                        return;
                    }
                    uint16_t value = atoi(ptr);
                    value = CHANNEL_VALUE_TO_RXFAIL_STEP(value);
                    if (value > MAX_RXFAIL_RANGE_STEP) {
                        cliPrintErrorLinef(cmdName, "value out of range: %d", value);
                        return;
                    }

                    channelFailsafeConfig->step = value;
                } else if (requireValue) {
                    cliShowInvalidArgumentCountError(cmdName);
                    return;
                }
                channelFailsafeConfig->mode = mode;
            }

            char modeCharacter = rxFailsafeModeCharacters[channelFailsafeConfig->mode];

            // double use of cliPrintf below
            // 1. acknowledge interpretation on command,
            // 2. query current setting on single item,

            if (requireValue) {
                cliPrintLinef("rxfail %u %c %d",
                    channel,
                    modeCharacter,
                    RXFAIL_STEP_TO_CHANNEL_VALUE(channelFailsafeConfig->step)
                );
            } else {
                cliPrintLinef("rxfail %u %c",
                    channel,
                    modeCharacter
                );
            }
        } else {
            cliShowArgumentRangeError(cmdName, "CHANNEL", 0, MAX_SUPPORTED_RC_CHANNEL_COUNT - 1);
        }
    }
}

static void printAux(dumpFlags_t dumpMask, const modeActivationCondition_t *modeActivationConditions, const modeActivationCondition_t *defaultModeActivationConditions, const char *headingStr)
{
    const char *format = "aux %u %u %u %u %u %u %u";
    // print out aux channel settings
    headingStr = cliPrintSectionHeading(dumpMask, false, headingStr);
    for (uint32_t i = 0; i < MAX_MODE_ACTIVATION_CONDITION_COUNT; i++) {
        const modeActivationCondition_t *mac = &modeActivationConditions[i];
        bool equalsDefault = false;
        if (defaultModeActivationConditions) {
            const modeActivationCondition_t *macDefault = &defaultModeActivationConditions[i];
            equalsDefault = !isModeActivationConditionConfigured(mac, macDefault);
            headingStr = cliPrintSectionHeading(dumpMask, !equalsDefault, headingStr);
            const box_t *box = findBoxByBoxId(macDefault->modeId);
            const box_t *linkedTo = findBoxByBoxId(macDefault->linkedTo);
            if (box) {
                cliDefaultPrintLinef(dumpMask, equalsDefault, format,
                    i,
                    box->permanentId,
                    macDefault->auxChannelIndex,
                    MODE_STEP_TO_CHANNEL_VALUE(macDefault->range.startStep),
                    MODE_STEP_TO_CHANNEL_VALUE(macDefault->range.endStep),
                    macDefault->modeLogic,
                    linkedTo ? linkedTo->permanentId : 0
                );
            }
        }
        const box_t *box = findBoxByBoxId(mac->modeId);
        const box_t *linkedTo = findBoxByBoxId(mac->linkedTo);
        if (box) {
            cliDumpPrintLinef(dumpMask, equalsDefault, format,
                i,
                box->permanentId,
                mac->auxChannelIndex,
                MODE_STEP_TO_CHANNEL_VALUE(mac->range.startStep),
                MODE_STEP_TO_CHANNEL_VALUE(mac->range.endStep),
                mac->modeLogic,
                linkedTo ? linkedTo->permanentId : 0
            );
        }
    }
}

static void cliAux(const char *cmdName, char *cmdline)
{
    int i, val = 0;
    const char *ptr;

    if (isEmpty(cmdline)) {
        printAux(DUMP_MASTER, modeActivationConditions(0), NULL, NULL);
    } else {
        ptr = cmdline;
        i = atoi(ptr++);
        if (i < MAX_MODE_ACTIVATION_CONDITION_COUNT) {
            modeActivationCondition_t *mac = modeActivationConditionsMutable(i);
            uint8_t validArgumentCount = 0;
            ptr = nextArg(ptr);
            if (ptr) {
                val = atoi(ptr);
                const box_t *box = findBoxByPermanentId(val);
                if (box) {
                    mac->modeId = box->boxId;
                    validArgumentCount++;
                }
            }
            ptr = nextArg(ptr);
            if (ptr) {
                val = atoi(ptr);
                if (val >= 0 && val < MAX_AUX_CHANNEL_COUNT) {
                    mac->auxChannelIndex = val;
                    validArgumentCount++;
                }
            }
            ptr = processChannelRangeArgs(ptr, &mac->range, &validArgumentCount);
            ptr = nextArg(ptr);
            if (ptr) {
                val = atoi(ptr);
                if (val == MODELOGIC_OR || val == MODELOGIC_AND) {
                    mac->modeLogic = val;
                    validArgumentCount++;
                }
            }
            ptr = nextArg(ptr);
            if (ptr) {
                val = atoi(ptr);
                const box_t *box = findBoxByPermanentId(val);
                if (box) {
                    mac->linkedTo = box->boxId;
                    validArgumentCount++;
                }
            }
            if (validArgumentCount == 4) { // for backwards compatibility
                mac->modeLogic = MODELOGIC_OR;
                mac->linkedTo = 0;
            } else if (validArgumentCount == 5) { // for backwards compatibility
                mac->linkedTo = 0;
            } else if (validArgumentCount != 6) {
                memset(mac, 0, sizeof(modeActivationCondition_t));
            }
            analyzeModeActivationConditions();
            cliPrintLinef( "aux %u %u %u %u %u %u %u",
                i,
                findBoxByBoxId(mac->modeId)->permanentId,
                mac->auxChannelIndex,
                MODE_STEP_TO_CHANNEL_VALUE(mac->range.startStep),
                MODE_STEP_TO_CHANNEL_VALUE(mac->range.endStep),
                mac->modeLogic,
                findBoxByBoxId(mac->linkedTo)->permanentId
            );
        } else {
            cliShowArgumentRangeError(cmdName, "INDEX", 0, MAX_MODE_ACTIVATION_CONDITION_COUNT - 1);
        }
    }
}

static void printSerial(dumpFlags_t dumpMask, const serialConfig_t *serialConfig, const serialConfig_t *serialConfigDefault, const char *headingStr)
{
    const char *format = "serial %s %d %ld %ld %ld %ld";
    headingStr = cliPrintSectionHeading(dumpMask, false, headingStr);
    for (unsigned i = 0; i < ARRAYLEN(serialConfig->portConfigs); i++) {
        if (!serialIsPortAvailable(serialConfig->portConfigs[i].identifier)) {
            continue;
        };
        bool equalsDefault = false;
        if (serialConfigDefault) {
            equalsDefault = !memcmp(&serialConfig->portConfigs[i], &serialConfigDefault->portConfigs[i], sizeof(serialConfig->portConfigs[i]));
            headingStr = cliPrintSectionHeading(dumpMask, !equalsDefault, headingStr);
            cliDefaultPrintLinef(dumpMask, equalsDefault, format,
                serialName(serialConfigDefault->portConfigs[i].identifier, invalidName),
                serialConfigDefault->portConfigs[i].functionMask,
                baudRates[serialConfigDefault->portConfigs[i].msp_baudrateIndex],
                baudRates[serialConfigDefault->portConfigs[i].gps_baudrateIndex],
                baudRates[serialConfigDefault->portConfigs[i].telemetry_baudrateIndex],
                baudRates[serialConfigDefault->portConfigs[i].blackbox_baudrateIndex]
            );
        }
        cliDumpPrintLinef(dumpMask, equalsDefault, format,
            serialName(serialConfig->portConfigs[i].identifier, invalidName),
            serialConfig->portConfigs[i].functionMask,
            baudRates[serialConfig->portConfigs[i].msp_baudrateIndex],
            baudRates[serialConfig->portConfigs[i].gps_baudrateIndex],
            baudRates[serialConfig->portConfigs[i].telemetry_baudrateIndex],
            baudRates[serialConfig->portConfigs[i].blackbox_baudrateIndex]
            );
    }
}

static void cliSerial(const char *cmdName, char *cmdline)
{
    const char *format = "serial %s %d %ld %ld %ld %ld";
    if (isEmpty(cmdline)) {
        printSerial(DUMP_MASTER, serialConfig(), NULL, NULL);
        return;
    }

    serialPortConfig_t portConfig;
    memset(&portConfig, 0 , sizeof(portConfig));

    uint8_t validArgumentCount = 0;

    char *ptr = cmdline;
    char *tok = strsep(&ptr, " ");
    serialPortIdentifier_e identifier = findSerialPortByName(tok, strcasecmp);
    if (identifier == SERIAL_PORT_NONE) {
        char *eptr;
        identifier = strtoul(tok, &eptr, 10);
        if (*eptr) {
            // parsing ended before end of token indicating an invalid identifier
            identifier = SERIAL_PORT_NONE;
        } else {
            // correction for legacy configuration where UART1 == 0
            if (identifier >= SERIAL_PORT_LEGACY_START_IDENTIFIER && identifier < SERIAL_PORT_START_IDENTIFIER) {
                identifier += SERIAL_PORT_UART1;
            }
       }
    }

    serialPortConfig_t *currentConfig = serialFindPortConfigurationMutable(identifier);

    if (!currentConfig) {
        cliShowParseError(cmdName);
        return;
    }

    portConfig.identifier = identifier;
    validArgumentCount++;

    tok = strsep(&ptr, " ");
    if (tok) {
        int val = strtoul(tok, NULL, 10);
        portConfig.functionMask = val;
        validArgumentCount++;
    }

    for (int i = 0; i < 4; i ++) {
        tok = strsep(&ptr, " ");
        if (!tok) {
            break;
        }

        int val = atoi(tok);

        uint8_t baudRateIndex = lookupBaudRateIndex(val);
        if (baudRates[baudRateIndex] != (uint32_t) val) {
            break;
        }

        switch (i) {
        case 0:
            if (baudRateIndex < BAUD_9600 || baudRateIndex > BAUD_1000000) {
                continue;
            }
            portConfig.msp_baudrateIndex = baudRateIndex;
            break;
        case 1:
            if (baudRateIndex < BAUD_9600 || baudRateIndex > BAUD_230400) {
                continue;
            }
            portConfig.gps_baudrateIndex = baudRateIndex;
            break;
        case 2:
            if (baudRateIndex != BAUD_AUTO && baudRateIndex > BAUD_460800) {
                continue;
            }
            portConfig.telemetry_baudrateIndex = baudRateIndex;
            break;
        case 3:
            if (baudRateIndex < BAUD_19200 || baudRateIndex > BAUD_2470000) {
                continue;
            }
            portConfig.blackbox_baudrateIndex = baudRateIndex;
            break;
        }

        validArgumentCount++;
    }

    if (validArgumentCount < 6) {
        cliShowInvalidArgumentCountError(cmdName);
        return;
    }

    memcpy(currentConfig, &portConfig, sizeof(portConfig));

    cliDumpPrintLinef(0, false, format,
        serialName(portConfig.identifier, invalidName),
        portConfig.functionMask,
        baudRates[portConfig.msp_baudrateIndex],
        baudRates[portConfig.gps_baudrateIndex],
        baudRates[portConfig.telemetry_baudrateIndex],
        baudRates[portConfig.blackbox_baudrateIndex]
        );
}

#if defined(USE_SERIAL_PASSTHROUGH)
static void cbCtrlLine_reset(void *context, uint16_t ctrl)
{
    UNUSED(context);
    if (!(ctrl & CTRL_LINE_STATE_DTR)) {
        systemReset();
    }
}

#ifdef USE_PINIO
static void cbCtrlLine_pinIO(void *context, uint16_t ctrl)
{
    pinioSet((intptr_t)context, !(ctrl & CTRL_LINE_STATE_DTR));
}
#endif

static portMode_e cliParseSerialMode(const char *tok)
{
    portMode_e mode = 0;

    if (strcasestr(tok, "rx")) {
        mode |= MODE_RX;
    }
    if (strcasestr(tok, "tx")) {
        mode |= MODE_TX;
    }

    return mode;
}

static portOptions_e cliParseSerialOptions(const char *tok)
{
    struct {
        const char* tag;
        portOptions_e val;
    } map[] = {
        {"Invert", SERIAL_INVERTED},
        {"Stop2", SERIAL_STOPBITS_2},
        {"Even", SERIAL_PARITY_EVEN},
        {"Bidir", SERIAL_BIDIR},
        {"Pushpull", SERIAL_BIDIR_PP},
        {"Saudio", SERIAL_PULL_SMARTAUDIO},
        {"Check", SERIAL_CHECK_TX},
    };
    portOptions_e options = 0;
    for (unsigned i = 0; i < ARRAYLEN(map); i++) {
        if (strstr(tok, map[i].tag) != 0) {
            options |= map[i].val;
        }
    }
    return options;
}

static void cliSerialPassthrough(const char *cmdName, char *cmdline)
{
    if (isEmpty(cmdline)) {
        cliShowInvalidArgumentCountError(cmdName);
        return;
    }

    serialPassthroughPort_t ports[2] = { {SERIAL_PORT_NONE, 0, 0, 0, NULL}, {cliPort->identifier, 0, 0, 0, cliPort} };
    bool enableBaudCb = false;
#ifdef USE_PINIO
    int port1PinioDtr = -1;          // route port2 USB DTR to pinio
#endif
    bool port1ResetOnDtr = false;    // reset board with DTR
#ifdef USE_PWM_OUTPUT
    bool escSensorPassthrough = false;
#endif

    char* nexttok = cmdline;
    char* tok;
    int index = 0;
    while ((tok = strsep(&nexttok, " ")) != NULL) {
        if (*tok == '\0') { // skip adjacent delimiters
            continue;
        }
        unsigned portN = (index < 4) ? 0 : 1;  // port1 / port2
        switch (index) {
        case 0: // port1 to open: esc_sensor, portName, port ID port1
        case 4: // port2 to use (defaults to CLI serial if no more arguments)
        {
            serialPortIdentifier_e portId;
            char* endptr;
            if (portN == 0 && strcasestr(tok, "esc_sensor") != NULL) {
#ifdef USE_PWM_OUTPUT
                escSensorPassthrough = true;
#endif
                const serialPortConfig_t *portConfig = findSerialPortConfig(FUNCTION_ESC_SENSOR);
                portId = portConfig ? portConfig->identifier : SERIAL_PORT_NONE;
            } else if (strcasecmp(tok, "cli") == 0) {
                portId = cliPort->identifier;
            } else if ((portId = findSerialPortByName(tok, strcasecmp)) >= 0) {
                // empty
            } else if ((portId = strtol(tok, &endptr, 10)) >= 0 && *endptr == '\0') {
                // empty
            } else {
                cliPrintLinef("Failed parsing port%d (%s)", portN + 1, tok);
                return;
            }
            if (portN == 1) { // port1 is specified, don't use CLI port
                ports[portN].port = NULL;
            }
            ports[portN].id = portId;
            break;
        }
        case 1: // baudrate
        case 5: {
            int baud = atoi(tok);
            ports[portN].baud = baud;
            break;
        }
        case 2: // port1 mode (rx/tx/rxtx) + options
        case 6: // port2 mode + options
            ports[portN].mode = cliParseSerialMode(tok);
            ports[portN].options = cliParseSerialOptions(tok);
            break;
        case 3: // DTR action
            if (strcasecmp(tok, "reset") == 0) {
                port1ResetOnDtr = true;
                break;
            }
            if (strcasecmp(tok, "none") == 0) {
                break;
            }
#ifdef USE_PINIO
            port1PinioDtr = atoi(tok);
            if (port1PinioDtr < 0 || port1PinioDtr >= PINIO_COUNT) {
                cliPrintLinef("Invalid PinIO number %d", port1PinioDtr);
                return;
            }
#endif /* USE_PINIO */
            break;
        default:
            cliPrintLinef("Unexpected argument %d (%s)", index + 1, tok);
            return;
        }
        index++;
    }

    for (unsigned i = 0; i < ARRAYLEN(ports); i++) {
        if (findSerialPortIndexByIdentifier(ports[i].id) < 0) {
            cliPrintLinef("Invalid port%d %d", i + 1, ports[i].id);
            return;
        } else {
            cliPrintLinef("Port%d: %s", i + 1, serialName(ports[i].id, invalidName));
        }
    }

    // Port checks
    if (ports[0].id == ports[1].id) {
        cliPrintLinef("Port1 and port2 are same");
        return ;
    }

    if (ports[0].baud == 0 && ports[1].id == SERIAL_PORT_USB_VCP) {
        enableBaudCb = true;
    }

    for (int i = 0; i < 2; i++) {
        serialPassthroughPort_t* cfg = &ports[i];
        if (cfg->port != NULL) {  // port already selected, don't touch it (used when port2 defaults to cli)
            continue;
        }

        int portIndex = i + 1;
        serialPortUsage_t *portUsage = findSerialPortUsageByIdentifier(cfg->id);
        if (!portUsage || portUsage->serialPort == NULL) {
            // serial port is not open yet
            const bool isUseDefaultBaud = cfg->baud == 0;
            if (isUseDefaultBaud) {
                // Set default baud
                cfg->baud = 57600;
            }

            if (!cfg->mode) {
                cliPrintLinef("Using RXTX mode as default");
                cfg->mode = MODE_RXTX;
            }

            if (cfg->options) {
                cliPrintLinef("Port%d: using options 0x%x",
                              portIndex, cfg->options);
            }
            cfg->port = openSerialPort(cfg->id, FUNCTION_NONE,
                                       NULL, NULL,   // rxCallback
                                       cfg->baud, cfg->mode, cfg->options);
            if (!cfg->port) {
                cliPrintLinef("Port%d could not be opened.", portIndex);
                return;
            }

            cliPrintf("Port%d opened, %sbaud = %d.\r\n", portIndex, isUseDefaultBaud ? "default ":"", cfg->baud);
        } else {
            cfg->port = portUsage->serialPort;
            // If the user supplied a mode, override the port's mode, otherwise
            // leave the mode unchanged. serialPassthrough() handles one-way ports.
            // Set the baud rate if specified
            if (cfg->baud) {
                serialSetBaudRate(cfg->port, cfg->baud);
            }
            cliPrintLinef("Port%d is already open, %sbaud = %d.", portIndex, cfg->baud ? "new " : "", cfg->port->baudRate);

            if (cfg->mode && cfg->port->mode != cfg->mode) {
                cliPrintLinef("Port%d mode changed from %d to %d.",
                          portIndex, cfg->port->mode, cfg->mode);
                serialSetMode(cfg->port, cfg->mode);
            }

            if (cfg->options) {
                cliPrintLinef("Port%d is open, can't change options from 0x%x to 0x%x",
                              portIndex, cfg->port->options, cfg->options);
            }

            // If this port has a rx callback associated we need to remove it now.
            // Otherwise no data will be pushed in the serial port buffer!
            if (cfg->port->rxCallback) {
                cliPrintLinef("Port%d: Callback removed", portIndex);
                cfg->port->rxCallback = NULL;
            }
        }
    }

    // If no baud rate is specified allow to be set via USB
    if (enableBaudCb) {
        cliPrintLine("Port1 baud rate change over USB enabled.");
        // Register the right side baud rate setting routine with the left side which allows setting of the UART
        // baud rate over USB without setting it using the serialpassthrough command
        serialSetBaudRateCb(ports[1].port, serialSetBaudRate, ports[0].port);
    }

    const char *resetMessage = "";
    if (port1ResetOnDtr && ports[1].id == SERIAL_PORT_USB_VCP) {
        resetMessage = "or drop DTR ";
    }

    cliPrintLinef("Forwarding, power cycle %sto exit.", resetMessage);

    if (ports[1].id == SERIAL_PORT_USB_VCP) {
        do {
            if (port1ResetOnDtr) {
                serialSetCtrlLineStateCb(ports[1].port, cbCtrlLine_reset, NULL);
                break;
            }
#ifdef USE_PINIO
            if (port1PinioDtr >= 0) {
                serialSetCtrlLineStateCb(ports[1].port, cbCtrlLine_pinIO, (void *)(intptr_t)(port1PinioDtr));
                break;
            }
#endif /* USE_PINIO */
        } while (0);
    }

// XXX Review ESC pass through under refactored motor handling
#ifdef USE_PWM_OUTPUT
    if (escSensorPassthrough) {
        // pwmDisableMotors();
        motorDisable();
        delay(5);
        for (unsigned i = 0; i < getMotorCount(); i++) {
            const ioTag_t tag = motorConfig()->dev.ioTags[i];
            if (tag) {
                const timerHardware_t *timerHardware = timerGetConfiguredByTag(tag);
                if (timerHardware) {
                    IO_t io = IOGetByTag(tag);
                    IOInit(io, OWNER_MOTOR, i);
                    IOConfigGPIO(io, IOCFG_OUT_PP);
                    if (timerHardware->output & TIMER_OUTPUT_INVERTED) {
                        IOLo(io);
                    } else {
                        IOHi(io);
                    }
                }
            }
        }
    }
#endif

    serialPassthrough(ports[0].port, ports[1].port, NULL, NULL);
}
#endif

static void printAdjustmentRange(dumpFlags_t dumpMask, const adjustmentRange_t *adjustmentRanges, const adjustmentRange_t *defaultAdjustmentRanges, const char *headingStr)
{
    const char *format = "adjrange %u 0 %u %u %u %u %u %u %u";
    // print out adjustment ranges channel settings
    headingStr = cliPrintSectionHeading(dumpMask, false, headingStr);
    for (uint32_t i = 0; i < MAX_ADJUSTMENT_RANGE_COUNT; i++) {
        const adjustmentRange_t *ar = &adjustmentRanges[i];
        bool equalsDefault = false;
        if (defaultAdjustmentRanges) {
            const adjustmentRange_t *arDefault = &defaultAdjustmentRanges[i];
            equalsDefault = !memcmp(ar, arDefault, sizeof(*ar));
            headingStr = cliPrintSectionHeading(dumpMask, !equalsDefault, headingStr);
            cliDefaultPrintLinef(dumpMask, equalsDefault, format,
                i,
                arDefault->auxChannelIndex,
                MODE_STEP_TO_CHANNEL_VALUE(arDefault->range.startStep),
                MODE_STEP_TO_CHANNEL_VALUE(arDefault->range.endStep),
                arDefault->adjustmentConfig,
                arDefault->auxSwitchChannelIndex,
                arDefault->adjustmentCenter,
                arDefault->adjustmentScale
            );
        }
        cliDumpPrintLinef(dumpMask, equalsDefault, format,
            i,
            ar->auxChannelIndex,
            MODE_STEP_TO_CHANNEL_VALUE(ar->range.startStep),
            MODE_STEP_TO_CHANNEL_VALUE(ar->range.endStep),
            ar->adjustmentConfig,
            ar->auxSwitchChannelIndex,
            ar->adjustmentCenter,
            ar->adjustmentScale
        );
    }
}

static void cliAdjustmentRange(const char *cmdName, char *cmdline)
{
    const char *format = "adjrange %u 0 %u %u %u %u %u %u %u";
    const char *ptr;

    if (isEmpty(cmdline)) {
        printAdjustmentRange(DUMP_MASTER, adjustmentRanges(0), NULL, NULL);
    } else {
        ptr = cmdline;
        int i = atoi(ptr++);
        if (i < MAX_ADJUSTMENT_RANGE_COUNT) {
            adjustmentRange_t *ar = adjustmentRangesMutable(i);
            uint8_t validArgumentCount = 0;

            ptr = nextArg(ptr);
            if (ptr) {
                // Was: slot
                // Keeping the parameter to retain backwards compatibility for the command format.
                validArgumentCount++;
            }
            ptr = nextArg(ptr);
            if (ptr) {
                int val = atoi(ptr);
                if (val >= 0 && val < MAX_AUX_CHANNEL_COUNT) {
                    ar->auxChannelIndex = val;
                    validArgumentCount++;
                }
            }

            ptr = processChannelRangeArgs(ptr, &ar->range, &validArgumentCount);

            ptr = nextArg(ptr);
            if (ptr) {
                int val = atoi(ptr);
                if (val >= 0 && val < ADJUSTMENT_FUNCTION_COUNT) {
                    ar->adjustmentConfig = val;
                    validArgumentCount++;
                }
            }
            ptr = nextArg(ptr);
            if (ptr) {
                int val = atoi(ptr);
                if (val >= 0 && val < MAX_AUX_CHANNEL_COUNT) {
                    ar->auxSwitchChannelIndex = val;
                    validArgumentCount++;
                }
            }

            if (validArgumentCount != 6) {
                memset(ar, 0, sizeof(adjustmentRange_t));
                cliShowInvalidArgumentCountError(cmdName);
                return;
            }

            // Optional arguments
            ar->adjustmentCenter = 0;
            ar->adjustmentScale = 0;

            ptr = nextArg(ptr);
            if (ptr) {
                int val = atoi(ptr);
                ar->adjustmentCenter = val;
                validArgumentCount++;
            }
            ptr = nextArg(ptr);
            if (ptr) {
                int val = atoi(ptr);
                ar->adjustmentScale = val;
                validArgumentCount++;
            }

            activeAdjustmentRangeReset();

            cliDumpPrintLinef(0, false, format,
                i,
                ar->auxChannelIndex,
                MODE_STEP_TO_CHANNEL_VALUE(ar->range.startStep),
                MODE_STEP_TO_CHANNEL_VALUE(ar->range.endStep),
                ar->adjustmentConfig,
                ar->auxSwitchChannelIndex,
                ar->adjustmentCenter,
                ar->adjustmentScale
            );

        } else {
            cliShowArgumentRangeError(cmdName, "INDEX", 0, MAX_ADJUSTMENT_RANGE_COUNT - 1);
        }
    }
}

#ifndef USE_QUAD_MIXER_ONLY
static void printMotorMix(dumpFlags_t dumpMask, const motorMixer_t *customMotorMixer, const motorMixer_t *defaultCustomMotorMixer, const char *headingStr)
{
    const char *format = "mmix %d %s %s %s %s";
    char buf0[FTOA_BUFFER_LENGTH];
    char buf1[FTOA_BUFFER_LENGTH];
    char buf2[FTOA_BUFFER_LENGTH];
    char buf3[FTOA_BUFFER_LENGTH];
    for (uint32_t i = 0; i < MAX_SUPPORTED_MOTORS; i++) {
        if (customMotorMixer[i].throttle == 0.0f)
            break;
        const float thr = customMotorMixer[i].throttle;
        const float roll = customMotorMixer[i].roll;
        const float pitch = customMotorMixer[i].pitch;
        const float yaw = customMotorMixer[i].yaw;
        bool equalsDefault = false;
        if (defaultCustomMotorMixer) {
            const float thrDefault = defaultCustomMotorMixer[i].throttle;
            const float rollDefault = defaultCustomMotorMixer[i].roll;
            const float pitchDefault = defaultCustomMotorMixer[i].pitch;
            const float yawDefault = defaultCustomMotorMixer[i].yaw;
            const bool equalsDefault = thr == thrDefault && roll == rollDefault && pitch == pitchDefault && yaw == yawDefault;

            headingStr = cliPrintSectionHeading(dumpMask, !equalsDefault, headingStr);
            cliDefaultPrintLinef(dumpMask, equalsDefault, format,
                i,
                ftoa(thrDefault, buf0),
                ftoa(rollDefault, buf1),
                ftoa(pitchDefault, buf2),
                ftoa(yawDefault, buf3));
        }
        cliDumpPrintLinef(dumpMask, equalsDefault, format,
            i,
            ftoa(thr, buf0),
            ftoa(roll, buf1),
            ftoa(pitch, buf2),
            ftoa(yaw, buf3));
    }
}
#endif // USE_QUAD_MIXER_ONLY

static void cliMotorMix(const char *cmdName, char *cmdline)
{
#ifdef USE_QUAD_MIXER_ONLY
    UNUSED(cmdName);
    UNUSED(cmdline);
#else
    int check = 0;
    uint8_t len;
    const char *ptr;

    if (isEmpty(cmdline)) {
        printMotorMix(DUMP_MASTER, customMotorMixer(0), NULL, NULL);
    } else if (strncasecmp(cmdline, "reset", 5) == 0) {
        // erase custom mixer
        for (uint32_t i = 0; i < MAX_SUPPORTED_MOTORS; i++) {
            customMotorMixerMutable(i)->throttle = 0.0f;
        }
    } else if (strncasecmp(cmdline, "load", 4) == 0) {
        ptr = nextArg(cmdline);
        if (ptr) {
            len = strlen(ptr);
            for (uint32_t i = 0; ; i++) {
                if (mixerNames[i] == NULL) {
                    cliPrintErrorLinef(cmdName, ERROR_INVALID_NAME, cmdline);
                    break;
                }
                if (strncasecmp(ptr, mixerNames[i], len) == 0) {
                    mixerLoadMix(i, customMotorMixerMutable(0));
                    cliPrintLinef("Loaded %s", mixerNames[i]);
                    cliMotorMix(cmdName, "");
                    break;
                }
            }
        }
    } else {
        ptr = cmdline;
        uint32_t i = atoi(ptr); // get motor number
        if (i < MAX_SUPPORTED_MOTORS) {
            ptr = nextArg(ptr);
            if (ptr) {
                customMotorMixerMutable(i)->throttle = fastA2F(ptr);
                check++;
            }
            ptr = nextArg(ptr);
            if (ptr) {
                customMotorMixerMutable(i)->roll = fastA2F(ptr);
                check++;
            }
            ptr = nextArg(ptr);
            if (ptr) {
                customMotorMixerMutable(i)->pitch = fastA2F(ptr);
                check++;
            }
            ptr = nextArg(ptr);
            if (ptr) {
                customMotorMixerMutable(i)->yaw = fastA2F(ptr);
                check++;
            }
            if (check != 4) {
                cliShowInvalidArgumentCountError(cmdName);
            } else {
                printMotorMix(DUMP_MASTER, customMotorMixer(0), NULL, NULL);
            }
        } else {
            cliShowArgumentRangeError(cmdName, "INDEX", 0, MAX_SUPPORTED_MOTORS - 1);
        }
    }
#endif
}

static void printRxRange(dumpFlags_t dumpMask, const rxChannelRangeConfig_t *channelRangeConfigs, const rxChannelRangeConfig_t *defaultChannelRangeConfigs, const char *headingStr)
{
    const char *format = "rxrange %u %u %u";
    headingStr = cliPrintSectionHeading(dumpMask, false, headingStr);
    for (uint32_t i = 0; i < NON_AUX_CHANNEL_COUNT; i++) {
        bool equalsDefault = false;
        if (defaultChannelRangeConfigs) {
            equalsDefault = !memcmp(&channelRangeConfigs[i], &defaultChannelRangeConfigs[i], sizeof(channelRangeConfigs[i]));
            headingStr = cliPrintSectionHeading(dumpMask, !equalsDefault, headingStr);
            cliDefaultPrintLinef(dumpMask, equalsDefault, format,
                i,
                defaultChannelRangeConfigs[i].min,
                defaultChannelRangeConfigs[i].max
            );
        }
        cliDumpPrintLinef(dumpMask, equalsDefault, format,
            i,
            channelRangeConfigs[i].min,
            channelRangeConfigs[i].max
        );
    }
}

static void cliRxRange(const char *cmdName, char *cmdline)
{
    const char *format = "rxrange %u %u %u";
    int i, validArgumentCount = 0;
    const char *ptr;

    if (isEmpty(cmdline)) {
        printRxRange(DUMP_MASTER, rxChannelRangeConfigs(0), NULL, NULL);
    } else if (strcasecmp(cmdline, "reset") == 0) {
        resetAllRxChannelRangeConfigurations(rxChannelRangeConfigsMutable(0));
    } else {
        ptr = cmdline;
        i = atoi(ptr);
        if (i >= 0 && i < NON_AUX_CHANNEL_COUNT) {
            int rangeMin = PWM_PULSE_MIN, rangeMax = PWM_PULSE_MAX;

            ptr = nextArg(ptr);
            if (ptr) {
                rangeMin = atoi(ptr);
                validArgumentCount++;
            }

            ptr = nextArg(ptr);
            if (ptr) {
                rangeMax = atoi(ptr);
                validArgumentCount++;
            }

            if (validArgumentCount != 2) {
                cliShowInvalidArgumentCountError(cmdName);
            } else if (rangeMin < PWM_PULSE_MIN || rangeMin > PWM_PULSE_MAX || rangeMax < PWM_PULSE_MIN || rangeMax > PWM_PULSE_MAX) {
                cliShowArgumentRangeError(cmdName, "range min/max", PWM_PULSE_MIN, PWM_PULSE_MAX);
            } else {
                rxChannelRangeConfig_t *channelRangeConfig = rxChannelRangeConfigsMutable(i);
                channelRangeConfig->min = rangeMin;
                channelRangeConfig->max = rangeMax;
                cliDumpPrintLinef(0, false, format,
                    i,
                    channelRangeConfig->min,
                    channelRangeConfig->max
                );

            }
        } else {
            cliShowArgumentRangeError(cmdName, "CHANNEL", 0, NON_AUX_CHANNEL_COUNT - 1);
        }
    }
}

#ifdef USE_LED_STRIP_STATUS_MODE
static void printLed(dumpFlags_t dumpMask, const ledConfig_t *ledConfigs, const ledConfig_t *defaultLedConfigs, const char *headingStr)
{
    const char *format = "led %u %s";
    char ledConfigBuffer[20];
    char ledConfigDefaultBuffer[20];
    headingStr = cliPrintSectionHeading(dumpMask, false, headingStr);
    for (uint32_t i = 0; i < LED_STRIP_MAX_LENGTH; i++) {
        ledConfig_t ledConfig = ledConfigs[i];
        generateLedConfig(&ledConfig, ledConfigBuffer, sizeof(ledConfigBuffer));
        bool equalsDefault = false;
        if (defaultLedConfigs) {
            ledConfig_t ledConfigDefault = defaultLedConfigs[i];
            equalsDefault = ledConfig == ledConfigDefault;
            headingStr = cliPrintSectionHeading(dumpMask, !equalsDefault, headingStr);
            generateLedConfig(&ledConfigDefault, ledConfigDefaultBuffer, sizeof(ledConfigDefaultBuffer));
            cliDefaultPrintLinef(dumpMask, equalsDefault, format, i, ledConfigDefaultBuffer);
        }
        cliDumpPrintLinef(dumpMask, equalsDefault, format, i, ledConfigBuffer);
    }
}

static void cliLed(const char *cmdName, char *cmdline)
{
    const char *format = "led %u %s";
    char ledConfigBuffer[20];
    int i;
    const char *ptr;

    if (isEmpty(cmdline)) {
        printLed(DUMP_MASTER, ledStripStatusModeConfig()->ledConfigs, NULL, NULL);
    } else {
        ptr = cmdline;
        i = atoi(ptr);
        if (i >= 0 && i < LED_STRIP_MAX_LENGTH) {
            ptr = nextArg(cmdline);
            if (!ptr) {
                cliShowInvalidArgumentCountError(cmdName);
            } else if (parseLedStripConfig(i, ptr)) {
                generateLedConfig((ledConfig_t *)&ledStripStatusModeConfig()->ledConfigs[i], ledConfigBuffer, sizeof(ledConfigBuffer));
                cliDumpPrintLinef(0, false, format, i, ledConfigBuffer);
            } else {
                cliShowParseError(cmdName);
            }
        } else {
            cliShowArgumentRangeError(cmdName, "INDEX", 0, LED_STRIP_MAX_LENGTH - 1);
        }
    }
}

static void printColor(dumpFlags_t dumpMask, const hsvColor_t *colors, const hsvColor_t *defaultColors, const char *headingStr)
{
    const char *format = "color %u %d,%u,%u";
    headingStr = cliPrintSectionHeading(dumpMask, false, headingStr);
    for (uint32_t i = 0; i < LED_CONFIGURABLE_COLOR_COUNT; i++) {
        const hsvColor_t *color = &colors[i];
        bool equalsDefault = false;
        if (defaultColors) {
            const hsvColor_t *colorDefault = &defaultColors[i];
            equalsDefault = !memcmp(color, colorDefault, sizeof(*color));
            headingStr = cliPrintSectionHeading(dumpMask, !equalsDefault, headingStr);
            cliDefaultPrintLinef(dumpMask, equalsDefault, format, i,colorDefault->h, colorDefault->s, colorDefault->v);
        }
        cliDumpPrintLinef(dumpMask, equalsDefault, format, i, color->h, color->s, color->v);
    }
}

static void cliColor(const char *cmdName, char *cmdline)
{
    const char *format = "color %u %d,%u,%u";
    if (isEmpty(cmdline)) {
        printColor(DUMP_MASTER, ledStripStatusModeConfig()->colors, NULL, NULL);
    } else {
        const char *ptr = cmdline;
        const int i = atoi(ptr);
        if (i >= 0 && i < LED_CONFIGURABLE_COLOR_COUNT) {
            ptr = nextArg(cmdline);
            if (!ptr) {
                cliShowInvalidArgumentCountError(cmdName);
            } else if (parseColor(i, ptr)) {
                const hsvColor_t *color = &ledStripStatusModeConfig()->colors[i];
                cliDumpPrintLinef(0, false, format, i, color->h, color->s, color->v);
            } else {
                cliShowParseError(cmdName);
            }
        } else {
            cliShowArgumentRangeError(cmdName, "INDEX", 0, LED_CONFIGURABLE_COLOR_COUNT - 1);
        }
    }
}

static void printModeColor(dumpFlags_t dumpMask, const ledStripStatusModeConfig_t *ledStripStatusModeConfig, const ledStripStatusModeConfig_t *defaultLedStripConfig, const char *headingStr)
{
    const char *format = "mode_color %u %u %u";
    headingStr = cliPrintSectionHeading(dumpMask, false, headingStr);
    for (uint32_t i = 0; i < LED_MODE_COUNT; i++) {
        for (uint32_t j = 0; j < LED_DIRECTION_COUNT; j++) {
            int colorIndex = ledStripStatusModeConfig->modeColors[i].color[j];
            bool equalsDefault = false;
            if (defaultLedStripConfig) {
                int colorIndexDefault = defaultLedStripConfig->modeColors[i].color[j];
                equalsDefault = colorIndex == colorIndexDefault;
                headingStr = cliPrintSectionHeading(dumpMask, !equalsDefault, headingStr);
                cliDefaultPrintLinef(dumpMask, equalsDefault, format, i, j, colorIndexDefault);
            }
            cliDumpPrintLinef(dumpMask, equalsDefault, format, i, j, colorIndex);
        }
    }

    for (uint32_t j = 0; j < LED_SPECIAL_COLOR_COUNT; j++) {
        const int colorIndex = ledStripStatusModeConfig->specialColors.color[j];
        bool equalsDefault = false;
        if (defaultLedStripConfig) {
            const int colorIndexDefault = defaultLedStripConfig->specialColors.color[j];
            equalsDefault = colorIndex == colorIndexDefault;
            headingStr = cliPrintSectionHeading(dumpMask, !equalsDefault, headingStr);
            cliDefaultPrintLinef(dumpMask, equalsDefault, format, LED_SPECIAL, j, colorIndexDefault);
        }
        cliDumpPrintLinef(dumpMask, equalsDefault, format, LED_SPECIAL, j, colorIndex);
    }

    const int ledStripAuxChannel = ledStripStatusModeConfig->ledstrip_aux_channel;
    bool equalsDefault = false;
    if (defaultLedStripConfig) {
        const int ledStripAuxChannelDefault = defaultLedStripConfig->ledstrip_aux_channel;
        equalsDefault = ledStripAuxChannel == ledStripAuxChannelDefault;
        headingStr = cliPrintSectionHeading(dumpMask, !equalsDefault, headingStr);
        cliDefaultPrintLinef(dumpMask, equalsDefault, format, LED_AUX_CHANNEL, 0, ledStripAuxChannelDefault);
    }
    cliDumpPrintLinef(dumpMask, equalsDefault, format, LED_AUX_CHANNEL, 0, ledStripAuxChannel);
}

static void cliModeColor(const char *cmdName, char *cmdline)
{
    if (isEmpty(cmdline)) {
        printModeColor(DUMP_MASTER, ledStripStatusModeConfig(), NULL, NULL);
    } else {
        enum {MODE = 0, FUNCTION, COLOR, ARGS_COUNT};
        int args[ARGS_COUNT];
        int argNo = 0;
        char *saveptr;
        const char* ptr = strtok_r(cmdline, " ", &saveptr);
        while (ptr && argNo < ARGS_COUNT) {
            args[argNo++] = atoi(ptr);
            ptr = strtok_r(NULL, " ", &saveptr);
        }

        if (ptr != NULL || argNo != ARGS_COUNT) {
            cliShowInvalidArgumentCountError(cmdName);
            return;
        }

        int modeIdx  = args[MODE];
        int funIdx = args[FUNCTION];
        int color = args[COLOR];
        if (!setModeColor(modeIdx, funIdx, color)) {
            cliShowParseError(cmdName);
            return;
        }
        // values are validated
        cliPrintLinef("mode_color %u %u %u", modeIdx, funIdx, color);
    }
}
#endif

#ifdef USE_SERVOS
static void printServo(dumpFlags_t dumpMask, const servoParam_t *servoParams, const servoParam_t *defaultServoParams, const char *headingStr)
{
    // print out servo settings
    const char *format = "servo %u %d %d %d %d %d";
    headingStr = cliPrintSectionHeading(dumpMask, false, headingStr);
    for (uint32_t i = 0; i < MAX_SUPPORTED_SERVOS; i++) {
        const servoParam_t *servoConf = &servoParams[i];
        bool equalsDefault = false;
        if (defaultServoParams) {
            const servoParam_t *defaultServoConf = &defaultServoParams[i];
            equalsDefault = !memcmp(servoConf, defaultServoConf, sizeof(*servoConf));
            headingStr = cliPrintSectionHeading(dumpMask, !equalsDefault, headingStr);
            cliDefaultPrintLinef(dumpMask, equalsDefault, format,
                i,
                defaultServoConf->min,
                defaultServoConf->max,
                defaultServoConf->middle,
                defaultServoConf->rate,
                defaultServoConf->forwardFromChannel
            );
        }
        cliDumpPrintLinef(dumpMask, equalsDefault, format,
            i,
            servoConf->min,
            servoConf->max,
            servoConf->middle,
            servoConf->rate,
            servoConf->forwardFromChannel
        );
    }
    // print servo directions
    for (uint32_t i = 0; i < MAX_SUPPORTED_SERVOS; i++) {
        const char *format = "smix reverse %d %d r";
        const servoParam_t *servoConf = &servoParams[i];
        const servoParam_t *servoConfDefault = &defaultServoParams[i];
        if (defaultServoParams) {
            bool equalsDefault = servoConf->reversedSources == servoConfDefault->reversedSources;
            for (uint32_t channel = 0; channel < INPUT_SOURCE_COUNT; channel++) {
                equalsDefault = ~(servoConf->reversedSources ^ servoConfDefault->reversedSources) & (1 << channel);
                if (servoConfDefault->reversedSources & (1 << channel)) {
                    cliDefaultPrintLinef(dumpMask, equalsDefault, format, i , channel);
                }
                if (servoConf->reversedSources & (1 << channel)) {
                    cliDumpPrintLinef(dumpMask, equalsDefault, format, i , channel);
                }
            }
        } else {
            for (uint32_t channel = 0; channel < INPUT_SOURCE_COUNT; channel++) {
                if (servoConf->reversedSources & (1 << channel)) {
                    cliDumpPrintLinef(dumpMask, true, format, i , channel);
                }
            }
        }
    }
}

static void cliServo(const char *cmdName, char *cmdline)
{
    const char *format = "servo %u %d %d %d %d %d";
    enum { SERVO_ARGUMENT_COUNT = 6 };
    int16_t arguments[SERVO_ARGUMENT_COUNT];

    servoParam_t *servo;

    int i;
    char *ptr;

    if (isEmpty(cmdline)) {
        printServo(DUMP_MASTER, servoParams(0), NULL, NULL);
    } else {
        int validArgumentCount = 0;

        ptr = cmdline;

        // Command line is integers (possibly negative) separated by spaces, no other characters allowed.

        // If command line doesn't fit the format, don't modify the config
        while (*ptr) {
            if (*ptr == '-' || (*ptr >= '0' && *ptr <= '9')) {
                if (validArgumentCount >= SERVO_ARGUMENT_COUNT) {
                    cliShowInvalidArgumentCountError(cmdName);
                    return;
                }

                arguments[validArgumentCount++] = atoi(ptr);

                do {
                    ptr++;
                } while (*ptr >= '0' && *ptr <= '9');
            } else if (*ptr == ' ') {
                ptr++;
            } else {
                cliShowParseError(cmdName);
                return;
            }
        }

        enum {INDEX = 0, MIN, MAX, MIDDLE, RATE, FORWARD};

        i = arguments[INDEX];

        // Check we got the right number of args and the servo index is correct (don't validate the other values)
        if (validArgumentCount != SERVO_ARGUMENT_COUNT || i < 0 || i >= MAX_SUPPORTED_SERVOS) {
            cliShowInvalidArgumentCountError(cmdName);
            return;
        }

        servo = servoParamsMutable(i);

        if (
            arguments[MIN] < PWM_SERVO_MIN || arguments[MIN] > PWM_SERVO_MAX ||
            arguments[MAX] < PWM_SERVO_MIN || arguments[MAX] > PWM_SERVO_MAX ||
            arguments[MIDDLE] < arguments[MIN] || arguments[MIDDLE] > arguments[MAX] ||
            arguments[MIN] > arguments[MAX] ||
            arguments[RATE] < -100 || arguments[RATE] > 100 ||
            arguments[FORWARD] >= MAX_SUPPORTED_RC_CHANNEL_COUNT
        ) {
            cliShowArgumentRangeError(cmdName, NULL, 0, 0);
            return;
        }

        servo->min = arguments[MIN];
        servo->max = arguments[MAX];
        servo->middle = arguments[MIDDLE];
        servo->rate = arguments[RATE];
        servo->forwardFromChannel = arguments[FORWARD];

        cliDumpPrintLinef(0, false, format,
            i,
            servo->min,
            servo->max,
            servo->middle,
            servo->rate,
            servo->forwardFromChannel
        );

    }
}
#endif

#ifdef USE_SERVOS
static void printServoMix(dumpFlags_t dumpMask, const servoMixer_t *customServoMixers, const servoMixer_t *defaultCustomServoMixers, const char *headingStr)
{
    const char *format = "smix %d %d %d %d %d %d %d %d";
    headingStr = cliPrintSectionHeading(dumpMask, false, headingStr);
    for (uint32_t i = 0; i < MAX_SERVO_RULES; i++) {
        const servoMixer_t customServoMixer = customServoMixers[i];
        if (customServoMixer.rate == 0) {
            break;
        }

        bool equalsDefault = false;
        if (defaultCustomServoMixers) {
            servoMixer_t customServoMixerDefault = defaultCustomServoMixers[i];
            equalsDefault = !memcmp(&customServoMixer, &customServoMixerDefault, sizeof(customServoMixer));

            headingStr = cliPrintSectionHeading(dumpMask, !equalsDefault, headingStr);
            cliDefaultPrintLinef(dumpMask, equalsDefault, format,
                i,
                customServoMixerDefault.targetChannel,
                customServoMixerDefault.inputSource,
                customServoMixerDefault.rate,
                customServoMixerDefault.speed,
                customServoMixerDefault.min,
                customServoMixerDefault.max,
                customServoMixerDefault.box
            );
        }
        cliDumpPrintLinef(dumpMask, equalsDefault, format,
            i,
            customServoMixer.targetChannel,
            customServoMixer.inputSource,
            customServoMixer.rate,
            customServoMixer.speed,
            customServoMixer.min,
            customServoMixer.max,
            customServoMixer.box
        );
    }
}

static void cliServoMix(const char *cmdName, char *cmdline)
{
    int args[8], check = 0;
    int len = strlen(cmdline);

    if (len == 0) {
        printServoMix(DUMP_MASTER, customServoMixers(0), NULL, NULL);
    } else if (strncasecmp(cmdline, "reset", 5) == 0) {
        // erase custom mixer
        memset(customServoMixers_array(), 0, sizeof(*customServoMixers_array()));
        for (uint32_t i = 0; i < MAX_SUPPORTED_SERVOS; i++) {
            servoParamsMutable(i)->reversedSources = 0;
        }
    } else if (strncasecmp(cmdline, "load", 4) == 0) {
        const char *ptr = nextArg(cmdline);
        if (ptr) {
            len = strlen(ptr);
            for (uint32_t i = 0; ; i++) {
                if (mixerNames[i] == NULL) {
                    cliPrintErrorLinef(cmdName, ERROR_INVALID_NAME, cmdline);
                    break;
                }
                if (strncasecmp(ptr, mixerNames[i], len) == 0) {
                    servoMixerLoadMix(i);
                    cliPrintLinef("Loaded %s", mixerNames[i]);
                    cliServoMix(cmdName, "");
                    break;
                }
            }
        }
    } else if (strncasecmp(cmdline, "reverse", 7) == 0) {
        enum {SERVO = 0, INPUT, REVERSE, ARGS_COUNT};
        char *ptr = strchr(cmdline, ' ');

        if (ptr == NULL) {
            cliPrintf("s");
            for (uint32_t inputSource = 0; inputSource < INPUT_SOURCE_COUNT; inputSource++)
                cliPrintf("\ti%d", inputSource);
            cliPrintLinefeed();

            for (uint32_t servoIndex = 0; servoIndex < MAX_SUPPORTED_SERVOS; servoIndex++) {
                cliPrintf("%d", servoIndex);
                for (uint32_t inputSource = 0; inputSource < INPUT_SOURCE_COUNT; inputSource++) {
                    cliPrintf("\t%s  ", (servoParams(servoIndex)->reversedSources & (1 << inputSource)) ? "r" : "n");
                }
                cliPrintLinefeed();
            }
            return;
        }

        char *saveptr;
        ptr = strtok_r(ptr, " ", &saveptr);
        while (ptr != NULL && check < ARGS_COUNT - 1) {
            args[check++] = atoi(ptr);
            ptr = strtok_r(NULL, " ", &saveptr);
        }

        if (ptr == NULL || check != ARGS_COUNT - 1) {
            cliShowInvalidArgumentCountError(cmdName);
            return;
        }

        if (args[SERVO] >= 0 && args[SERVO] < MAX_SUPPORTED_SERVOS
                && args[INPUT] >= 0 && args[INPUT] < INPUT_SOURCE_COUNT
                && (*ptr == 'r' || *ptr == 'n')) {
            if (*ptr == 'r') {
                servoParamsMutable(args[SERVO])->reversedSources |= 1 << args[INPUT];
            } else {
                servoParamsMutable(args[SERVO])->reversedSources &= ~(1 << args[INPUT]);
            }
        } else {
            cliShowArgumentRangeError(cmdName, "servo", 0, MAX_SUPPORTED_SERVOS);
            return;
        }

        cliServoMix(cmdName, "reverse");
    } else {
        enum {RULE = 0, TARGET, INPUT, RATE, SPEED, MIN, MAX, BOX, ARGS_COUNT};
        char *saveptr;
        char *ptr = strtok_r(cmdline, " ", &saveptr);
        while (ptr != NULL && check < ARGS_COUNT) {
            args[check++] = atoi(ptr);
            ptr = strtok_r(NULL, " ", &saveptr);
        }

        if (ptr != NULL || check != ARGS_COUNT) {
            cliShowInvalidArgumentCountError(cmdName);
            return;
        }

        int32_t i = args[RULE];
        if (i >= 0 && i < MAX_SERVO_RULES &&
            args[TARGET] >= 0 && args[TARGET] < MAX_SUPPORTED_SERVOS &&
            args[INPUT] >= 0 && args[INPUT] < INPUT_SOURCE_COUNT &&
            args[RATE] >= -100 && args[RATE] <= 100 &&
            args[SPEED] >= 0 && args[SPEED] <= MAX_SERVO_SPEED &&
            args[MIN] >= 0 && args[MIN] <= 100 &&
            args[MAX] >= 0 && args[MAX] <= 100 && args[MIN] < args[MAX] &&
            args[BOX] >= 0 && args[BOX] <= MAX_SERVO_BOXES) {
            customServoMixersMutable(i)->targetChannel = args[TARGET];
            customServoMixersMutable(i)->inputSource = args[INPUT];
            customServoMixersMutable(i)->rate = args[RATE];
            customServoMixersMutable(i)->speed = args[SPEED];
            customServoMixersMutable(i)->min = args[MIN];
            customServoMixersMutable(i)->max = args[MAX];
            customServoMixersMutable(i)->box = args[BOX];
            cliServoMix(cmdName, "");
        } else {
            cliShowArgumentRangeError(cmdName, NULL, 0, 0);
        }
    }
}
#endif

#if ENABLE_FLIGHT_PLAN

static const char * const waypointTypeNames[] = {
    "FLYOVER", "FLYBY", "HOLD", "LAND", "TAKEOFF",
    "ALT_CHANGE", "DELAY", "YAW_RATE"
};
STATIC_ASSERT(WAYPOINT_TYPE_COUNT == ARRAYLEN(waypointTypeNames), waypointTypeNames_array_length_mismatch);

static const char * const waypointPatternNames[] = {
    "NONE", "ORBIT", "FIGURE8"
};
STATIC_ASSERT(WAYPOINT_PATTERN_COUNT == ARRAYLEN(waypointPatternNames), waypointPatternNames_array_length_mismatch);

// Parse decimal coordinate string to int32 (degrees * 10^7)
// Accepts formats like: -33.5429890, 151.6664560, -33.5, 151
static bool parseDecimalCoordinate(const char *str, int32_t *result)
{
    if (!str || !result) {
        return false;
    }

    bool negative = false;
    const char *ptr = str;

    // Handle sign
    if (*ptr == '-') {
        negative = true;
        ptr++;
    } else if (*ptr == '+') {
        ptr++;
    }

    // Parse integer part (as positive value) with overflow checks
    int32_t integerPart = 0;
    if (!(*ptr >= '0' && *ptr <= '9')) {
        return false; // No digits found
    }
    while (*ptr >= '0' && *ptr <= '9') {
        int digit = (*ptr - '0');
        // Check for overflow before multiply and add
        if (integerPart > (INT32_MAX - digit) / 10) {
            return false; // Would overflow
        }
        integerPart = integerPart * 10 + digit;
        ptr++;
    }

    // Parse fractional part (up to 7 digits) with overflow checks
    int32_t fractionalPart = 0;
    int32_t divisor = 10000000;

    if (*ptr == '.') {
        ptr++;
        int digits = 0;
        while (*ptr >= '0' && *ptr <= '9' && digits < 7) {
            int digit = (*ptr - '0');
            // Check for overflow before multiply and add
            if (fractionalPart > (INT32_MAX - digit) / 10) {
                return false; // Would overflow
            }
            fractionalPart = fractionalPart * 10 + digit;
            divisor /= 10;
            digits++;
            ptr++;
        }
        // Ignore any additional digits beyond 7 decimal places
        while (*ptr >= '0' && *ptr <= '9') {
            ptr++;
        }
        // Check for overflow before scaling fractional part
        if (divisor > 0 && fractionalPart > INT32_MAX / divisor) {
            return false; // Would overflow
        }
        fractionalPart *= divisor; // Scale to 7 decimal places
    }

    // Check for trailing garbage
    if (*ptr != '\0') {
        return false;
    }

    // Check for overflow before computing result
    // For positive: integerPart * 10000000 + fractionalPart must fit in INT32_MAX
    if (integerPart > (INT32_MAX - fractionalPart) / 10000000) {
        return false; // Would overflow
    }

    int32_t microdegrees = integerPart * 10000000 + fractionalPart;

    // Apply sign and check it fits in int32_t range
    if (negative) {
        // Check if negation would overflow (microdegrees > INT32_MAX means -microdegrees < INT32_MIN)
        // Since microdegrees is positive and <= INT32_MAX, -microdegrees >= -INT32_MAX
        // But -INT32_MAX = INT32_MIN + 1, so we're safe except when microdegrees would make result = INT32_MIN - 1
        // Actually, we need to check if the negated value would be < INT32_MIN
        // For int32_t: INT32_MIN = -2147483648, INT32_MAX = 2147483647
        // If microdegrees = 2147483648, then -microdegrees = -2147483648 = INT32_MIN (valid)
        // But microdegrees is int32_t, max is 2147483647, so -microdegrees = -2147483647 (valid)
        // Special case: if microdegrees = 0, result is 0 (valid)
        // The only concern is if microdegrees = INT32_MAX + 1, but that's impossible since microdegrees is int32_t
        // So negation is always safe here
        microdegrees = -microdegrees;
    }

    *result = microdegrees;
    return true;
}

// Format coordinate as decimal string with 7 decimal places
static void formatDecimalCoordinate(int32_t value, char *buffer)
{
    bool negative = value < 0;
    int32_t integerPart, fractionalPart;

    // Special case for INT32_MIN to avoid UB when negating
    if (value == INT32_MIN) {
        // INT32_MIN = -2147483648
        // -2147483648 / 10000000 = -214 (rounds toward zero)
        // -2147483648 % 10000000 = -7483648
        integerPart = 214;
        fractionalPart = 7483648;
    } else {
        int32_t absValue = negative ? -value : value;
        integerPart = absValue / 10000000;
        fractionalPart = absValue % 10000000;
    }

    tfp_sprintf(buffer, "%s%d.%07d", negative ? "-" : "", integerPart, fractionalPart);
}

static void printWaypoint(dumpFlags_t dumpMask, const flightPlanConfig_t *flightPlanConfig, const flightPlanConfig_t *defaultFlightPlanConfig, const char *headingStr)
{
    const char *format = "waypoint insert %u %s %s %d %u %s %u %s";
    headingStr = cliPrintSectionHeading(dumpMask, false, headingStr);

    // Determine if all waypoints equal their defaults
    bool equalsDefaultAll = false;
    if (defaultFlightPlanConfig) {
        // Check if counts match
        if (flightPlanConfig->waypointCount == defaultFlightPlanConfig->waypointCount) {
            equalsDefaultAll = true;
            // Check if all waypoints match their defaults
            for (uint32_t i = 0; i < flightPlanConfig->waypointCount; i++) {
                const waypoint_t *wp = &flightPlanConfig->waypoints[i];
                const waypoint_t *defaultWp = &defaultFlightPlanConfig->waypoints[i];
                if (memcmp(wp, defaultWp, sizeof(*wp)) != 0) {
                    equalsDefaultAll = false;
                    break;
                }
            }
        }
    }

    // Emit "waypoint clear" before inserts so replaying clears persisted waypoints
    cliDumpPrintLinef(dumpMask, equalsDefaultAll, "waypoint clear");

    for (uint32_t i = 0; i < flightPlanConfig->waypointCount; i++) {
        const waypoint_t *wp = &flightPlanConfig->waypoints[i];
        bool equalsDefault = false;

        char latBuffer[16];
        char lonBuffer[16];

        if (defaultFlightPlanConfig && i < defaultFlightPlanConfig->waypointCount) {
            const waypoint_t *defaultWp = &defaultFlightPlanConfig->waypoints[i];
            equalsDefault = !memcmp(wp, defaultWp, sizeof(*wp));
            headingStr = cliPrintSectionHeading(dumpMask, !equalsDefault, headingStr);

            formatDecimalCoordinate(defaultWp->latitude, latBuffer);
            formatDecimalCoordinate(defaultWp->longitude, lonBuffer);

            const char *defaultTypeName = (defaultWp->type < ARRAYLEN(waypointTypeNames)) ? waypointTypeNames[defaultWp->type] : "UNKNOWN";
            const char *defaultPatternName = (defaultWp->pattern < ARRAYLEN(waypointPatternNames)) ? waypointPatternNames[defaultWp->pattern] : "UNKNOWN";

            cliDefaultPrintLinef(dumpMask, equalsDefault, format,
                i,
                latBuffer,
                lonBuffer,
                defaultWp->altitude,
                defaultWp->speed,
                defaultTypeName,
                defaultWp->duration,
                defaultPatternName
            );
        }

        formatDecimalCoordinate(wp->latitude, latBuffer);
        formatDecimalCoordinate(wp->longitude, lonBuffer);

        const char *typeName = (wp->type < ARRAYLEN(waypointTypeNames)) ? waypointTypeNames[wp->type] : "UNKNOWN";
        const char *patternName = (wp->pattern < ARRAYLEN(waypointPatternNames)) ? waypointPatternNames[wp->pattern] : "UNKNOWN";

        cliDumpPrintLinef(dumpMask, equalsDefault, format,
            i,
            latBuffer,
            lonBuffer,
            wp->altitude,
            wp->speed,
            typeName,
            wp->duration,
            patternName
        );
    }
}

static void cliWaypoint(const char *cmdName, char *cmdline)
{
    flightPlanConfig_t *config = flightPlanConfigMutable();

    // Defensive: detect corrupted waypointCount from EEPROM
    if (config->waypointCount > MAX_WAYPOINTS) {
        config->waypointCount = 0;
        cliPrintErrorLinef(cmdName, "WAYPOINT COUNT CORRUPTED, CLEARED");
    }

    // No arguments - list all waypoints
    if (isEmpty(cmdline)) {
        printWaypoint(DUMP_MASTER, flightPlanConfig(), NULL, NULL);
        return;
    }

    // Parse arguments into args array
    enum { OP = 0, INDEX, LAT, LON, ALT, SPEED, TYPE, DURATION, PATTERN, MAX_ARGS };
    char *args[MAX_ARGS];
    int argCount = 0;

    char *ptr = cmdline;
    while (*ptr && argCount < MAX_ARGS) {
        while (*ptr == ' ') ptr++;
        if (*ptr == '\0') break;
        args[argCount++] = ptr;
        while (*ptr && *ptr != ' ') ptr++;
        if (*ptr) *ptr++ = '\0';
    }

    // Reject commands with more tokens than MAX_ARGS
    while (*ptr == ' ') ptr++;
    if (*ptr != '\0') {
        cliShowInvalidArgumentCountError(cmdName);
        return;
    }

    // Validate we have at least one argument
    if (argCount == 0) {
        return;
    }

    // Check for clear operation
    if (strcasecmp(args[OP], "clear") == 0) {
        if (argCount != 1) {
            cliShowInvalidArgumentCountError(cmdName);
            return;
        }
        config->waypointCount = 0;
        cliPrintLine("Waypoints cleared");
        return;
    }

    // Check for list operation
    if (strcasecmp(args[OP], "list") == 0) {
        if (argCount != 1) {
            cliShowInvalidArgumentCountError(cmdName);
            return;
        }
        printWaypoint(DUMP_MASTER, flightPlanConfig(), NULL, NULL);
        return;
    }

    // Check for status operation
    if (strcasecmp(args[OP], "status") == 0) {
        if (argCount != 1) {
            cliShowInvalidArgumentCountError(cmdName);
            return;
        }
        cliPrintLinef("Waypoint count: %u", config->waypointCount);

        // List configured waypoints
        if (config->waypointCount > 0) {
            cliPrintLine("\nConfigured waypoints:");
            for (int i = 0; i < config->waypointCount; i++) {
                const waypoint_t *wp = &config->waypoints[i];
                char latBuffer[16];
                char lonBuffer[16];
                formatDecimalCoordinate(wp->latitude, latBuffer);
                formatDecimalCoordinate(wp->longitude, lonBuffer);
                const char *typeName = (wp->type < ARRAYLEN(waypointTypeNames)) ? waypointTypeNames[wp->type] : "UNKNOWN";
                const uint32_t altAbs = (wp->altitude < 0) ? -(uint32_t)wp->altitude : (uint32_t)wp->altitude;
                cliPrintLinef("  [%d] %s %s %s%u.%02um %s",
                    i, latBuffer, lonBuffer, (wp->altitude < 0) ? "-" : "", altAbs / 100, altAbs % 100, typeName);
            }
        }

        cliPrintLine("\nRuntime status:");
        if (!flightPlanNavIsActive()) {
            cliPrintLine("  inactive");
            return;
        }

        static const char * const stateNames[] = {
            "IDLE", "TARGETING", "HOLDING", "COMPLETE", "LANDING", "ABORTED",
        };
        const flightPlanNavState_e state = flightPlanNavGetState();
        cliPrintLinef("  state: %s", (state < ARRAYLEN(stateNames)) ? stateNames[state] : "UNKNOWN");
        const uint8_t currentDisplay = (config->waypointCount == 0) ? 0 : flightPlanNavGetCurrentIndex() + 1;
        cliPrintLinef("  current waypoint: %u/%u", currentDisplay, config->waypointCount);

        const float distanceM = flightPlanNavGetDistanceToWaypointM();
        if (distanceM >= 0.0f) {
            const uint32_t distanceCm = lrintf(distanceM * 100.0f);
            const int32_t bearingDeg = flightPlanNavGetBearingToWaypointDeciDeg() / 10;
            cliPrintLinef("  distance: %u.%02um  bearing: %ld deg  eta: %us",
                distanceCm / 100, distanceCm % 100, (long)bearingDeg, flightPlanNavGetEtaSeconds());
        }

        if (state == FP_NAV_ABORTED) {
            static const char * const abortNames[] = {
                "NONE", "GPS LOST", "STALLED", "FLYAWAY", "HEADING",
            };
            const flightPlanAbortReason_e reason = flightPlanNavGetAbortReason();
            cliPrintLinef("  abort reason: %s", (reason < ARRAYLEN(abortNames)) ? abortNames[reason] : "UNKNOWN");
        }
        return;
    }

    // Check for remove operation
    if (strcasecmp(args[OP], "remove") == 0) {
        if (argCount != 2) {
            cliShowInvalidArgumentCountError(cmdName);
            return;
        }

        if (config->waypointCount == 0) {
            cliPrintErrorLinef(cmdName, "NO WAYPOINTS TO REMOVE");
            return;
        }

        char *endptr;
        long index = strtol(args[INDEX], &endptr, 10);
        if (*endptr != '\0') {
            cliPrintErrorLinef(cmdName, "INVALID INDEX");
            return;
        }
        if (index < 0 || index >= config->waypointCount) {
            cliShowArgumentRangeError(cmdName, "index", 0, config->waypointCount - 1);
            return;
        }

        // Shift waypoints down to fill the gap
        for (int i = index; i < config->waypointCount - 1; i++) {
            config->waypoints[i] = config->waypoints[i + 1];
        }
        config->waypointCount--;

        cliPrintLinef("Waypoint %d removed, %d waypoints remaining", index, config->waypointCount);
        return;
    }

    // Check for insert or update operation
    bool isInsert = strcasecmp(args[OP], "insert") == 0;
    bool isUpdate = strcasecmp(args[OP], "update") == 0;

    if (!isInsert && !isUpdate) {
        cliPrintErrorLinef(cmdName, "INVALID OPERATION. USE: list, status, insert, update, remove, clear");
        return;
    }

    if (argCount != 9) {
        cliShowInvalidArgumentCountError(cmdName);
        return;
    }

    // Parse index
    char *endptr;
    long index = strtol(args[INDEX], &endptr, 10);
    if (*endptr != '\0') {
        cliPrintErrorLinef(cmdName, "INVALID INDEX");
        return;
    }

    if (isInsert) {
        // For insert, index can be 0 to waypointCount (inclusive, to append)
        if (index < 0 || index > config->waypointCount || config->waypointCount >= MAX_WAYPOINTS) {
            if (config->waypointCount >= MAX_WAYPOINTS) {
                cliPrintErrorLinef(cmdName, "WAYPOINT LIST FULL");
            } else {
                cliShowArgumentRangeError(cmdName, "index", 0, config->waypointCount);
            }
            return;
        }
    } else {
        // For update, index must be within existing waypoints
        if (config->waypointCount == 0) {
            cliPrintErrorLinef(cmdName, "NO WAYPOINTS TO UPDATE");
            return;
        }
        if (index < 0 || index >= config->waypointCount) {
            cliShowArgumentRangeError(cmdName, "index", 0, config->waypointCount - 1);
            return;
        }
    }

    // Parse coordinates (decimal format with up to 7 decimal places)
    int32_t latitude, longitude;
    if (!parseDecimalCoordinate(args[LAT], &latitude)) {
        cliPrintErrorLinef(cmdName, "INVALID LATITUDE FORMAT. USE: -90.0000000 to 90.0000000");
        return;
    }
    if (!parseDecimalCoordinate(args[LON], &longitude)) {
        cliPrintErrorLinef(cmdName, "INVALID LONGITUDE FORMAT. USE: -180.0000000 to 180.0000000");
        return;
    }

    // Parse other values
    errno = 0;
    long altitude = strtol(args[ALT], &endptr, 10);
    if (*endptr != '\0') {
        cliPrintErrorLinef(cmdName, "INVALID ALTITUDE");
        return;
    }
    if (errno == ERANGE || altitude < INT32_MIN || altitude > INT32_MAX) {
        cliPrintErrorLinef(cmdName, "ALTITUDE OUT OF RANGE");
        return;
    }

    // Parse speed and duration with validation
    long tmpSpeed = strtol(args[SPEED], &endptr, 10);
    if (*endptr != '\0') {
        cliPrintErrorLinef(cmdName, "INVALID SPEED");
        return;
    }
    long tmpDuration = strtol(args[DURATION], &endptr, 10);
    if (*endptr != '\0') {
        cliPrintErrorLinef(cmdName, "INVALID DURATION");
        return;
    }

    if (tmpSpeed < 0 || tmpSpeed > UINT16_MAX) {
        cliShowArgumentRangeError(cmdName, "speed", 0, UINT16_MAX);
        return;
    }
    if (tmpDuration < 0 || tmpDuration > UINT16_MAX) {
        cliShowArgumentRangeError(cmdName, "duration", 0, UINT16_MAX);
        return;
    }

    // Parse type
    uint8_t type = 0;
    bool typeFound = false;
    for (uint8_t i = 0; i < ARRAYLEN(waypointTypeNames); i++) {
        if (strcasecmp(args[TYPE], waypointTypeNames[i]) == 0) {
            type = i;
            typeFound = true;
            break;
        }
    }
    if (!typeFound) {
        cliPrintErrorLinef(cmdName, "INVALID TYPE. USE: FLYOVER, FLYBY, HOLD, LAND, TAKEOFF, ALT_CHANGE, DELAY, YAW_RATE");
        return;
    }

    // Parse pattern
    uint8_t pattern = 0;
    bool patternFound = false;
    for (uint8_t i = 0; i < ARRAYLEN(waypointPatternNames); i++) {
        if (strcasecmp(args[PATTERN], waypointPatternNames[i]) == 0) {
            pattern = i;
            patternFound = true;
            break;
        }
    }
    if (!patternFound) {
        cliPrintErrorLinef(cmdName, "INVALID PATTERN. USE: NONE, ORBIT, FIGURE8");
        return;
    }

    // Validate ranges (stored as degrees * 10^7)
    if (latitude < -900000000 || latitude > 900000000) {
        cliPrintErrorLinef(cmdName, "LATITUDE OUT OF RANGE. USE: -90.0 to 90.0");
        return;
    }
    if (longitude < -1800000000 || longitude > 1800000000) {
        cliPrintErrorLinef(cmdName, "LONGITUDE OUT OF RANGE. USE: -180.0 to 180.0");
        return;
    }

    // Perform insert or update
    if (isInsert) {
        // Shift waypoints up to make room
        for (int i = config->waypointCount; i > index; i--) {
            config->waypoints[i] = config->waypoints[i - 1];
        }
        config->waypointCount++;
    }

    // Set waypoint data
    waypoint_t *wp = &config->waypoints[index];
    wp->latitude = latitude;
    wp->longitude = longitude;
    wp->altitude = altitude;
    wp->speed = (uint16_t)tmpSpeed;
    wp->duration = (uint16_t)tmpDuration;
    wp->type = type;
    wp->pattern = pattern;

    char latBuffer[16];
    char lonBuffer[16];
    formatDecimalCoordinate(wp->latitude, latBuffer);
    formatDecimalCoordinate(wp->longitude, lonBuffer);

    const uint32_t altAbs = (wp->altitude < 0) ? -(uint32_t)wp->altitude : (uint32_t)wp->altitude;
    cliPrintLinef("waypoint %s %u %s %s %s%u.%02um %u %s %u %s",
        isInsert ? "insert" : "update",
        index,
        latBuffer,
        lonBuffer,
        (wp->altitude < 0) ? "-" : "", altAbs / 100, altAbs % 100,
        wp->speed,
        waypointTypeNames[wp->type],
        wp->duration,
        waypointPatternNames[wp->pattern]
    );
}

#endif // ENABLE_FLIGHT_PLAN

#ifdef USE_SDCARD

static void cliWriteBytes(const uint8_t *buffer, int count)
{
    while (count > 0) {
        cliWrite(*buffer);
        buffer++;
        count--;
    }
}

static void cliSdInfo(const char *cmdName, char *cmdline)
{
    UNUSED(cmdName);
    UNUSED(cmdline);

    cliPrint("SD-CARD: ");

    if (sdcardConfig()->mode == SDCARD_MODE_NONE) {
        cliPrintLine("Not configured");

        return;
    }

    if (!sdcard_isInserted()) {
        cliPrintLine("None inserted");
        return;
    }

    if (!sdcard_isFunctional() || !sdcard_isInitialized()) {
        cliPrintLine("Startup failed");
        return;
    }

    const sdcardMetadata_t *metadata = sdcard_getMetadata();

    cliPrintf("Manufacturer 0x%x, %ukB, %02d/%04d, v%d.%d, '",
        metadata->manufacturerID,
        metadata->numBlocks / 2, /* One block is half a kB */
        metadata->productionMonth,
        metadata->productionYear,
        metadata->productRevisionMajor,
        metadata->productRevisionMinor
    );

    cliWriteBytes((uint8_t*)metadata->productName, sizeof(metadata->productName));

    cliPrint(" FS: ");

    switch (afatfs_getFilesystemState()) {
    case AFATFS_FILESYSTEM_STATE_READY:
        cliPrint("Ready");
        break;
    case AFATFS_FILESYSTEM_STATE_INITIALIZATION:
        cliPrint("Initializing");
        break;
    case AFATFS_FILESYSTEM_STATE_UNKNOWN:
    case AFATFS_FILESYSTEM_STATE_FATAL:
        cliPrint("Fatal");

        switch (afatfs_getLastError()) {
        case AFATFS_ERROR_BAD_MBR:
            cliPrint(" - no FAT MBR partitions");
            break;
        case AFATFS_ERROR_BAD_FILESYSTEM_HEADER:
            cliPrint(" - bad FAT header");
            break;
        case AFATFS_ERROR_GENERIC:
        case AFATFS_ERROR_NONE:
            ; // Nothing more detailed to print
            break;
        }
        break;
    }
    cliPrintLinefeed();
}

#endif

#ifdef USE_FLASH_CHIP
static void cliFlashInfo(const char *cmdName, char *cmdline)
{
    UNUSED(cmdName);
    UNUSED(cmdline);

    const flashGeometry_t *layout = flashGetGeometry();

    cliPrintLinef("Flash sectors=%u, sectorSize=%u, pagesPerSector=%u, pageSize=%u, totalSize=%u JEDEC ID=0x%08x",
            layout->sectors, layout->sectorSize, layout->pagesPerSector, layout->pageSize, layout->totalSize, layout->jedecId);

    for (uint8_t index = 0; index < FLASH_MAX_PARTITIONS; index++) {
        const flashPartition_t *partition;
        if (index == 0) {
            cliPrintLine("Partitions:");
        }
        partition = flashPartitionFindByIndex(index);
        if (!partition) {
            break;
        }
        cliPrintLinef("  %d: %s %u %u", index, flashPartitionGetTypeName(partition->type), partition->startSector, partition->endSector);
    }
#ifdef USE_FLASHFS
    const flashPartition_t *flashPartition = flashPartitionFindByType(FLASH_PARTITION_TYPE_FLASHFS);

    cliPrintLinef("FlashFS size=%u, usedSize=%u",
            FLASH_PARTITION_SECTOR_COUNT(flashPartition) * layout->sectorSize,
            flashfsGetOffset()
    );
#endif
}
#endif // USE_FLASH_CHIP

#if defined(USE_FLASHFS) && defined(USE_FLASH_CHIP)
static void cliFlashErase(const char *cmdName, char *cmdline)
{
    UNUSED(cmdName);
    UNUSED(cmdline);

    if (!flashfsIsSupported()) {
        return;
    }

#ifndef MINIMAL_CLI
    uint32_t i = 0;
    cliPrintLine("Erasing, please wait ... ");
#else
    cliPrintLine("Erasing,");
#endif

    cliWriterFlush();
    flashfsEraseCompletely();

    while (!flashfsIsReady()) {
        flashfsEraseAsync();
#ifndef MINIMAL_CLI
        cliPrintf(".");
        if (i++ > 120) {
            i=0;
            cliPrintLinefeed();
        }

        cliWriterFlush();
#endif
        delay(100);
    }
    beeper(BEEPER_BLACKBOX_ERASE);
    cliPrintLinefeed();
    cliPrintLine("Done.");
}

#ifdef USE_FLASH_TOOLS
static void cliFlashVerify(const char *cmdName, char *cmdline)
{
    UNUSED(cmdline);

    cliPrintLine("Verifying");
    if (flashfsVerifyEntireFlash()) {
        cliPrintLine("Success");
    } else {
        cliPrintErrorLinef(cmdName, "Failed");
    }
}

static void cliFlashWrite(const char *cmdName, char *cmdline)
{
    const uint32_t address = atoi(cmdline);
    char *text = strchr(cmdline, ' ');

    if (!text) {
        cliShowInvalidArgumentCountError(cmdName);
    } else {
        text = skipSpace(text + 1);
        flashfsSeekAbs(address);
        flashfsWrite((uint8_t*)text, strlen(text), true);
        flashfsFlushSync();

        cliPrintLinef("Wrote %u bytes at %u.", strlen(text), address);
    }
}

static void cliFlashRead(const char *cmdName, char *cmdline)
{
    uint32_t address = atoi(cmdline);

    const char *nextArg = strchr(cmdline, ' ');

    if (!nextArg) {
        cliShowInvalidArgumentCountError(cmdName);
    } else {
        uint32_t length = atoi(nextArg);

        cliPrintLinef("Reading %u bytes at %u:", length, address);

        uint8_t buffer[32];
        while (length > 0) {
            int bytesRead = flashfsReadAbs(address, buffer, length < sizeof(buffer) ? length : sizeof(buffer));

            for (int i = 0; i < bytesRead; i++) {
                cliWrite(buffer[i]);
            }

            length -= bytesRead;
            address += bytesRead;

            if (bytesRead == 0) {
                //Assume we reached the end of the volume or something fatal happened
                break;
            }
        }
        cliPrintLinefeed();
    }
}
#endif // USE_FLASH_TOOLS
#endif // USE_FLASHFS

#ifdef USE_VTX_CONTROL
static void printVtx(dumpFlags_t dumpMask, const vtxConfig_t *vtxConfig, const vtxConfig_t *vtxConfigDefault, const char *headingStr)
{
    // print out vtx channel settings
    const char *format = "vtx %u %u %u %u %u %u %u";
    headingStr = cliPrintSectionHeading(dumpMask, false, headingStr);
    bool equalsDefault = false;
    for (uint32_t i = 0; i < MAX_CHANNEL_ACTIVATION_CONDITION_COUNT; i++) {
        const vtxChannelActivationCondition_t *cac = &vtxConfig->vtxChannelActivationConditions[i];
        if (vtxConfigDefault) {
            const vtxChannelActivationCondition_t *cacDefault = &vtxConfigDefault->vtxChannelActivationConditions[i];
            equalsDefault = !memcmp(cac, cacDefault, sizeof(*cac));
            headingStr = cliPrintSectionHeading(dumpMask, !equalsDefault, headingStr);
            cliDefaultPrintLinef(dumpMask, equalsDefault, format,
                i,
                cacDefault->auxChannelIndex,
                cacDefault->band,
                cacDefault->channel,
                cacDefault->power,
                MODE_STEP_TO_CHANNEL_VALUE(cacDefault->range.startStep),
                MODE_STEP_TO_CHANNEL_VALUE(cacDefault->range.endStep)
            );
        }
        cliDumpPrintLinef(dumpMask, equalsDefault, format,
            i,
            cac->auxChannelIndex,
            cac->band,
            cac->channel,
            cac->power,
            MODE_STEP_TO_CHANNEL_VALUE(cac->range.startStep),
            MODE_STEP_TO_CHANNEL_VALUE(cac->range.endStep)
        );
    }
}

static void cliVtx(const char *cmdName, char *cmdline)
{
    const char *format = "vtx %u %u %u %u %u %u %u";
    const char *ptr;

    if (isEmpty(cmdline)) {
        printVtx(DUMP_MASTER, vtxConfig(), NULL, NULL);
    } else {
#ifdef USE_VTX_TABLE
        const uint8_t maxBandIndex = vtxTableConfig()->bands;
        const uint8_t maxChannelIndex = vtxTableConfig()->channels;
        const uint8_t maxPowerIndex = vtxTableConfig()->powerLevels;
#else
        const uint8_t maxBandIndex = VTX_TABLE_MAX_BANDS;
        const uint8_t maxChannelIndex = VTX_TABLE_MAX_CHANNELS;
        const uint8_t maxPowerIndex = VTX_TABLE_MAX_POWER_LEVELS;
#endif
        ptr = cmdline;
        int i = atoi(ptr++);
        if (i < MAX_CHANNEL_ACTIVATION_CONDITION_COUNT) {
            vtxChannelActivationCondition_t *cac = &vtxConfigMutable()->vtxChannelActivationConditions[i];
            uint8_t validArgumentCount = 0;
            ptr = nextArg(ptr);
            if (ptr) {
                int val = atoi(ptr);
                if (val >= 0 && val < MAX_AUX_CHANNEL_COUNT) {
                    cac->auxChannelIndex = val;
                    validArgumentCount++;
                }
            }
            ptr = nextArg(ptr);
            if (ptr) {
                int val = atoi(ptr);
                if (val >= 0 && val <= maxBandIndex) {
                    cac->band = val;
                    validArgumentCount++;
                }
            }
            ptr = nextArg(ptr);
            if (ptr) {
                int val = atoi(ptr);
                if (val >= 0 && val <= maxChannelIndex) {
                    cac->channel = val;
                    validArgumentCount++;
                }
            }
            ptr = nextArg(ptr);
            if (ptr) {
                int val = atoi(ptr);
                if (val >= 0 && val <= maxPowerIndex) {
                    cac->power= val;
                    validArgumentCount++;
                }
            }
            ptr = processChannelRangeArgs(ptr, &cac->range, &validArgumentCount);

            if (validArgumentCount != 6) {
                memset(cac, 0, sizeof(vtxChannelActivationCondition_t));
                cliShowInvalidArgumentCountError(cmdName);
            } else {
                cliDumpPrintLinef(0, false, format,
                    i,
                    cac->auxChannelIndex,
                    cac->band,
                    cac->channel,
                    cac->power,
                    MODE_STEP_TO_CHANNEL_VALUE(cac->range.startStep),
                    MODE_STEP_TO_CHANNEL_VALUE(cac->range.endStep)
                );
            }
        } else {
            cliShowArgumentRangeError(cmdName, "INDEX", 0, MAX_CHANNEL_ACTIVATION_CONDITION_COUNT - 1);
        }
    }
}

#endif // VTX_CONTROL

#ifdef USE_VTX_TABLE

static char *formatVtxTableBandFrequency(const bool isFactory, const uint16_t *frequency, int channels)
{
    static char freqbuf[5 * VTX_TABLE_MAX_CHANNELS + 8 + 1];
    char freqtmp[5 + 1];
    freqbuf[0] = 0;
    strcat(freqbuf, isFactory ? " FACTORY" : " CUSTOM ");
    for (int channel = 0; channel < channels; channel++) {
        tfp_sprintf(freqtmp, " %4d", frequency[channel]);
        strcat(freqbuf, freqtmp);
    }
    return freqbuf;
}

static const char *printVtxTableBand(dumpFlags_t dumpMask, int band, const vtxTableConfig_t *currentConfig, const vtxTableConfig_t *defaultConfig, const char *headingStr)
{
    char *fmt = "vtxtable band %d %s %c%s";
    bool equalsDefault = false;

    if (defaultConfig) {
        equalsDefault = true;
        if (strcasecmp(currentConfig->bandNames[band], defaultConfig->bandNames[band])) {
            equalsDefault = false;
        }
        if (currentConfig->bandLetters[band] != defaultConfig->bandLetters[band]) {
            equalsDefault = false;
        }
        for (int channel = 0; channel < VTX_TABLE_MAX_CHANNELS; channel++) {
            if (currentConfig->frequency[band][channel] != defaultConfig->frequency[band][channel]) {
                equalsDefault = false;
              }
        }
        headingStr = cliPrintSectionHeading(dumpMask, !equalsDefault, headingStr);
        char *freqbuf = formatVtxTableBandFrequency(defaultConfig->isFactoryBand[band], defaultConfig->frequency[band], defaultConfig->channels);
        cliDefaultPrintLinef(dumpMask, equalsDefault, fmt, band + 1, defaultConfig->bandNames[band], defaultConfig->bandLetters[band], freqbuf);
    }

    char *freqbuf = formatVtxTableBandFrequency(currentConfig->isFactoryBand[band], currentConfig->frequency[band], currentConfig->channels);
    cliDumpPrintLinef(dumpMask, equalsDefault, fmt, band + 1, currentConfig->bandNames[band], currentConfig->bandLetters[band], freqbuf);
    return headingStr;
}

static char *formatVtxTablePowerValues(const uint16_t *levels, int count)
{
    // (max 4 digit + 1 space) per level
    static char pwrbuf[5 * VTX_TABLE_MAX_POWER_LEVELS + 1];
    char pwrtmp[5 + 1];
    pwrbuf[0] = 0;
    for (int pwrindex = 0; pwrindex < count; pwrindex++) {
        tfp_sprintf(pwrtmp, " %d", levels[pwrindex]);
        strcat(pwrbuf, pwrtmp);
    }
    return pwrbuf;
}

static const char *printVtxTablePowerValues(dumpFlags_t dumpMask, const vtxTableConfig_t *currentConfig, const vtxTableConfig_t *defaultConfig, const char *headingStr)
{
    char *fmt = "vtxtable powervalues%s";
    bool equalsDefault = false;
    if (defaultConfig) {
        equalsDefault = true;
        for (int pwrindex = 0; pwrindex < VTX_TABLE_MAX_POWER_LEVELS; pwrindex++) {
            if (defaultConfig->powerValues[pwrindex] != currentConfig->powerValues[pwrindex]) {
                equalsDefault = false;
            }
        }
        headingStr = cliPrintSectionHeading(dumpMask, !equalsDefault, headingStr);
        char *pwrbuf = formatVtxTablePowerValues(defaultConfig->powerValues, VTX_TABLE_MAX_POWER_LEVELS);
        cliDefaultPrintLinef(dumpMask, equalsDefault, fmt, pwrbuf);
    }

    char *pwrbuf = formatVtxTablePowerValues(currentConfig->powerValues, currentConfig->powerLevels);
    cliDumpPrintLinef(dumpMask, equalsDefault, fmt, pwrbuf);
    return headingStr;
}

static char *formatVtxTablePowerLabels(const char labels[VTX_TABLE_MAX_POWER_LEVELS][VTX_TABLE_POWER_LABEL_LENGTH + 1], int count)
{
    static char pwrbuf[(VTX_TABLE_POWER_LABEL_LENGTH + 1) * VTX_TABLE_MAX_POWER_LEVELS + 1];
    char pwrtmp[(VTX_TABLE_POWER_LABEL_LENGTH + 1) + 1];
    pwrbuf[0] = 0;
    for (int pwrindex = 0; pwrindex < count; pwrindex++) {
        strcat(pwrbuf, " ");
        strcpy(pwrtmp, labels[pwrindex]);
        // trim trailing space
        char *sp;
        while ((sp = strchr(pwrtmp, ' '))) {
            *sp = 0;
        }
        strcat(pwrbuf, pwrtmp);
    }
    return pwrbuf;
}

static const char *printVtxTablePowerLabels(dumpFlags_t dumpMask, const vtxTableConfig_t *currentConfig, const vtxTableConfig_t *defaultConfig, const char *headingStr)
{
    char *fmt = "vtxtable powerlabels%s";
    bool equalsDefault = false;
    if (defaultConfig) {
        equalsDefault = true;
        for (int pwrindex = 0; pwrindex < VTX_TABLE_MAX_POWER_LEVELS; pwrindex++) {
            if (strcasecmp(defaultConfig->powerLabels[pwrindex], currentConfig->powerLabels[pwrindex])) {
                equalsDefault = false;
            }
        }
        headingStr = cliPrintSectionHeading(dumpMask, !equalsDefault, headingStr);
        char *pwrbuf = formatVtxTablePowerLabels(defaultConfig->powerLabels, VTX_TABLE_MAX_POWER_LEVELS);
        cliDefaultPrintLinef(dumpMask, equalsDefault, fmt, pwrbuf);
    }

    char *pwrbuf = formatVtxTablePowerLabels(currentConfig->powerLabels, currentConfig->powerLevels);
    cliDumpPrintLinef(dumpMask, equalsDefault, fmt, pwrbuf);
    return headingStr;
}
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
