Just4Stan/betaflight/src/main/msp/msp.c

/*
 * This file is part of Cleanflight and Betaflight.
 *
 * Cleanflight and Betaflight are free software. You can redistribute
 * this software and/or modify this software under the terms of the
 * GNU General Public License as published by the Free Software
 * Foundation, either version 3 of the License, or (at your option)
 * any later version.
 *
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
 * If not, see <http://www.gnu.org/licenses/>.
 */

#include <stdbool.h>
#include <stdint.h>
#include <string.h>
#include <math.h>
#include <stdlib.h>
#include <limits.h>
#include <ctype.h>

#include "platform.h"

#include "blackbox/blackbox.h"
#include "blackbox/blackbox_io.h"

#include "build/build_config.h"
#include "build/debug.h"
#include "build/version.h"

#include "cli/cli.h"

#include "common/axis.h"
#include "common/bitarray.h"
#include "common/color.h"
#include "common/huffman.h"
#include "common/maths.h"
#include "common/streambuf.h"
#include "common/utils.h"

#include "config/config.h"
#include "config/config_eeprom.h"
#include "config/feature.h"
#include "config/simplified_tuning.h"

#include "drivers/accgyro/accgyro.h"
#include "drivers/bus_i2c.h"
#include "drivers/bus_spi.h"
#include "drivers/camera_control.h"
#include "drivers/compass/compass.h"
#include "drivers/display.h"
#include "drivers/dshot.h"
#include "drivers/dshot_command.h"
#include "drivers/flash/flash.h"
#include "drivers/io.h"
#include "drivers/motor.h"
#include "drivers/osd.h"
#include "drivers/pwm_output.h"
#include "drivers/sdcard.h"
#include "drivers/serial.h"
#include "drivers/serial_escserial.h"
#include "drivers/system.h"
#include "drivers/transponder_ir.h"
#include "drivers/usb_msc.h"
#include "drivers/vtx_common.h"
#include "drivers/vtx_table.h"
#include "drivers/rangefinder/rangefinder_lidarmt.h"

#include "fc/board_info.h"
#include "fc/controlrate_profile.h"
#include "fc/core.h"
#include "fc/dispatch.h"
#include "fc/rc.h"
#include "fc/rc_adjustments.h"
#include "fc/rc_controls.h"
#include "fc/rc_modes.h"
#include "fc/runtime_config.h"

#include "flight/failsafe.h"
#include "flight/imu.h"
#include "flight/mixer.h"
#include "flight/pid.h"
#include "flight/pid_init.h"
#include "flight/position.h"
#include "flight/rpm_filter.h"
#include "flight/servos.h"

#include "io/asyncfatfs/asyncfatfs.h"
#include "io/beeper.h"
#include "io/flashfs.h"
#include "io/gimbal.h"
#include "io/gps.h"
#include "io/ledstrip.h"
#include "io/serial.h"
#include "io/serial_4way.h"
#include "io/transponder_ir.h"
#include "io/usb_msc.h"
#include "io/vtx_control.h"
#include "io/vtx.h"
#include "io/vtx_msp.h"

#include "msp/msp_box.h"
#include "msp/msp_build_info.h"
#include "msp/msp_protocol.h"
#include "msp/msp_protocol_v2_betaflight.h"
#include "msp/msp_protocol_v2_common.h"
#include "msp/msp_serial.h"

#include "osd/osd.h"
#include "osd/osd_elements.h"
#include "osd/osd_warnings.h"

#include "pg/autopilot.h"
#include "pg/beeper.h"
#include "pg/board.h"
#include "pg/displayport_profiles.h"
#include "pg/dyn_notch.h"
#include "pg/gps_rescue.h"
#include "pg/gyrodev.h"
#include "pg/motor.h"
#include "pg/pilot.h"
#include "pg/pos_hold.h"
#include "pg/rx.h"
#include "pg/rx_spi.h"
#ifdef USE_RX_EXPRESSLRS
#include "pg/rx_spi_expresslrs.h"
#endif
#include "pg/usb.h"
#include "pg/vcd.h"
#include "pg/vtx_table.h"

#include "rx/rx.h"
#include "rx/rx_bind.h"
#include "rx/msp.h"

#include "scheduler/scheduler.h"

#include "sensors/acceleration.h"
#include "sensors/adcinternal.h"
#include "sensors/barometer.h"
#include "sensors/battery.h"
#include "sensors/boardalignment.h"
#include "sensors/compass.h"
#include "sensors/gyro.h"
#include "sensors/gyro_init.h"
#include "sensors/rangefinder.h"
#include "sensors/opticalflow.h"

#include "telemetry/msp_shared.h"
#include "telemetry/telemetry.h"

#ifdef USE_HARDWARE_REVISION_DETECTION
#include "hardware_revision.h"
#endif

#include "msp.h"

static const char * const flightControllerIdentifier = FC_FIRMWARE_IDENTIFIER; // 4 UPPER CASE alpha numeric characters that identify the flight controller.

enum {
    MSP_REBOOT_FIRMWARE = 0,
    MSP_REBOOT_BOOTLOADER_ROM,
    MSP_REBOOT_MSC,
    MSP_REBOOT_MSC_UTC,
    MSP_REBOOT_BOOTLOADER_FLASH,
    MSP_REBOOT_COUNT,
};

static uint8_t rebootMode;

typedef enum {
    MSP_SDCARD_STATE_NOT_PRESENT = 0,
    MSP_SDCARD_STATE_FATAL       = 1,
    MSP_SDCARD_STATE_CARD_INIT   = 2,
    MSP_SDCARD_STATE_FS_INIT     = 3,
    MSP_SDCARD_STATE_READY       = 4
} mspSDCardState_e;

typedef enum {
    MSP_SDCARD_FLAG_SUPPORTED   = 1
} mspSDCardFlags_e;

typedef enum {
    MSP_FLASHFS_FLAG_READY       = 1,
    MSP_FLASHFS_FLAG_SUPPORTED  = 2
} mspFlashFsFlags_e;

typedef enum {
    MSP_PASSTHROUGH_ESC_SIMONK = PROTOCOL_SIMONK,
    MSP_PASSTHROUGH_ESC_BLHELI = PROTOCOL_BLHELI,
    MSP_PASSTHROUGH_ESC_KISS = PROTOCOL_KISS,
    MSP_PASSTHROUGH_ESC_KISSALL = PROTOCOL_KISSALL,
    MSP_PASSTHROUGH_ESC_CASTLE = PROTOCOL_CASTLE,

    MSP_PASSTHROUGH_SERIAL_ID = 0xFD,
    MSP_PASSTHROUGH_SERIAL_FUNCTION_ID = 0xFE,

    MSP_PASSTHROUGH_ESC_4WAY = 0xFF,
} mspPassthroughType_e;

#define RATEPROFILE_MASK (1 << 7)
#define BATTERYPROFILE_MASK (1 << 6)

#define RTC_NOT_SUPPORTED 0xff

typedef enum {
    DEFAULTS_TYPE_BASE = 0,
    DEFAULTS_TYPE_CUSTOM,
} defaultsType_e;

#ifdef USE_VTX_TABLE
static bool vtxTableNeedsInit = false;
#endif

#ifdef USE_OSD
static bool fontHasBeenUpdated = false;
#endif

static int mspDescriptor = 0;

mspDescriptor_t mspDescriptorAlloc(void)
{
    return (mspDescriptor_t)mspDescriptor++;
}

static uint32_t mspArmingDisableFlags = 0;

#if !ENABLE_SIMULATOR
static void mspArmingDisableByDescriptor(mspDescriptor_t desc)
{
    mspArmingDisableFlags |= (1 << desc);
}
#endif

static void mspArmingEnableByDescriptor(mspDescriptor_t desc)
{
    mspArmingDisableFlags &= ~(1 << desc);
}

static bool mspIsMspArmingEnabled(void)
{
    return mspArmingDisableFlags == 0;
}

#define MSP_PASSTHROUGH_ESC_4WAY 0xff

static uint8_t mspPassthroughMode;
static uint8_t mspPassthroughArgument;

#if defined(USE_ESCSERIAL) && defined(USE_SERIAL_4WAY_BLHELI_INTERFACE)
static void mspEscPassthroughFn(serialPort_t *serialPort)
{
    escEnablePassthrough(serialPort, &motorConfig()->dev, mspPassthroughArgument, mspPassthroughMode);
}
#endif

#ifdef USE_SERIAL_PASSTHROUGH
static serialPort_t *mspFindPassthroughSerialPort(void)
{
    serialPortUsage_t *portUsage = NULL;

    switch (mspPassthroughMode) {
    case MSP_PASSTHROUGH_SERIAL_ID:
    {
        portUsage = findSerialPortUsageByIdentifier(mspPassthroughArgument);
        break;
    }
    case MSP_PASSTHROUGH_SERIAL_FUNCTION_ID:
    {
        const serialPortConfig_t *portConfig = findSerialPortConfig(1 << mspPassthroughArgument);
        if (portConfig) {
            portUsage = findSerialPortUsageByIdentifier(portConfig->identifier);
        }
        break;
    }
    }
    return portUsage ? portUsage->serialPort : NULL;
}

static void mspSerialPassthroughFn(serialPort_t *serialPort)
{
    serialPort_t *passthroughPort = mspFindPassthroughSerialPort();
    if (passthroughPort && serialPort) {
        serialPassthrough(passthroughPort, serialPort, NULL, NULL);
    }
}
#endif

static void mspFcSetPassthroughCommand(sbuf_t *dst, sbuf_t *src, mspPostProcessFnPtr *mspPostProcessFn)
{
#ifndef USE_SERIAL_PASSTHROUGH
    UNUSED(mspPostProcessFn);
#endif
    const unsigned int dataSize = sbufBytesRemaining(src);
    if (dataSize == 0) {
        // Legacy format
        mspPassthroughMode = MSP_PASSTHROUGH_ESC_4WAY;
    } else {
        mspPassthroughMode = sbufReadU8(src);
        mspPassthroughArgument = sbufReadU8(src);
    }

    switch (mspPassthroughMode) {
#ifdef USE_SERIAL_PASSTHROUGH
    case MSP_PASSTHROUGH_SERIAL_ID:
    case MSP_PASSTHROUGH_SERIAL_FUNCTION_ID:
        if (mspFindPassthroughSerialPort()) {
            if (mspPostProcessFn) {
                *mspPostProcessFn = mspSerialPassthroughFn;
            }
            sbufWriteU8(dst, 1);
        } else {
            sbufWriteU8(dst, 0);
        }
        break;
#endif
#ifdef USE_SERIAL_4WAY_BLHELI_INTERFACE
    case MSP_PASSTHROUGH_ESC_4WAY:
        // get channel number
        // switch all motor lines HI
        // reply with the count of ESC found
        sbufWriteU8(dst, esc4wayInit());

        if (mspPostProcessFn) {
            *mspPostProcessFn = esc4wayProcess;
        }
        break;

#ifdef USE_ESCSERIAL
    case MSP_PASSTHROUGH_ESC_SIMONK:
    case MSP_PASSTHROUGH_ESC_BLHELI:
    case MSP_PASSTHROUGH_ESC_KISS:
    case MSP_PASSTHROUGH_ESC_KISSALL:
    case MSP_PASSTHROUGH_ESC_CASTLE:
        if (mspPassthroughArgument < getMotorCount() || (mspPassthroughMode == MSP_PASSTHROUGH_ESC_KISS && mspPassthroughArgument == ALL_MOTORS)) {
            sbufWriteU8(dst, 1);

            if (mspPostProcessFn) {
                *mspPostProcessFn = mspEscPassthroughFn;
            }

            break;
        }
        FALLTHROUGH;
#endif // USE_ESCSERIAL
#endif // USE_SERIAL_4WAY_BLHELI_INTERFACE
    default:
        sbufWriteU8(dst, 0);
    }
}

MAYBE_UNUSED static void configRebootUpdateCheckU8(uint8_t *parm, uint8_t value)
{
    if (*parm != value) {
        setRebootRequired();
    }
    *parm = value;
}

#ifdef USE_OSD
static void fontUpdateCompletion(void)
{
    displayPort_t *osdDisplayPort = osdGetDisplayPort(NULL);
    if (osdDisplayPort) {
        displayFontUpdateCompletion(osdDisplayPort);
    }
}
#endif

static void mspRebootFn(serialPort_t *serialPort)
{
    UNUSED(serialPort);

    motorShutdown();

    switch (rebootMode) {
    case MSP_REBOOT_FIRMWARE:
#ifdef USE_OSD
        if (fontHasBeenUpdated) {
            fontUpdateCompletion();
            fontHasBeenUpdated = false;
        }
#endif

        systemReset();

        break;
    case MSP_REBOOT_BOOTLOADER_ROM:
        systemResetToBootloader(BOOTLOADER_REQUEST_ROM);

        break;
#if defined(USE_USB_MSC)
    case MSP_REBOOT_MSC:
    case MSP_REBOOT_MSC_UTC: {
#ifdef USE_RTC_TIME
        const int16_t timezoneOffsetMinutes = (rebootMode == MSP_REBOOT_MSC) ? timeConfig()->tz_offsetMinutes : 0;
        systemResetToMsc(timezoneOffsetMinutes);
#else
        systemResetToMsc(0);
#endif
        }
        break;
#endif
#if defined(USE_FLASH_BOOT_LOADER)
    case MSP_REBOOT_BOOTLOADER_FLASH:
        systemResetToBootloader(BOOTLOADER_REQUEST_FLASH);

        break;
#endif
    default:

        return;
    }

    // control should never return here.
    while (true) ;
}

#define MSP_DISPATCH_DELAY_US 1000000

static void mspReboot(dispatchEntry_t* self)
{
    UNUSED(self);

    if (ARMING_FLAG(ARMED)) {
        return;
    }

    mspRebootFn(NULL);
}

dispatchEntry_t mspRebootEntry = {
    mspReboot, 0, NULL, false
};

static void writeReadEeprom(dispatchEntry_t* self)
{
    UNUSED(self);

    if (ARMING_FLAG(ARMED)) {
        return;
    }

    writeEEPROM();
    readEEPROM();

#ifdef USE_VTX_TABLE
    if (vtxTableNeedsInit) {
        vtxTableNeedsInit = false;
        vtxTableInit();  // Reinitialize and refresh the in-memory copies
    }
#endif
}

dispatchEntry_t writeReadEepromEntry = {
    writeReadEeprom, 0, NULL, false
};

static void serializeSDCardSummaryReply(sbuf_t *dst)
{
    uint8_t flags = 0;
    uint8_t state = 0;
    uint8_t lastError = 0;
    uint32_t freeSpace = 0;
    uint32_t totalSpace = 0;

#if defined(USE_SDCARD)
    if (sdcardConfig()->mode != SDCARD_MODE_NONE) {
        flags = MSP_SDCARD_FLAG_SUPPORTED;

        // Merge the card and filesystem states together
        if (!sdcard_isInserted()) {
            state = MSP_SDCARD_STATE_NOT_PRESENT;
        } else if (!sdcard_isFunctional()) {
            state = MSP_SDCARD_STATE_FATAL;
        } else {
            switch (afatfs_getFilesystemState()) {
            case AFATFS_FILESYSTEM_STATE_READY:
                state = MSP_SDCARD_STATE_READY;
                break;

            case AFATFS_FILESYSTEM_STATE_INITIALIZATION:
             if (sdcard_isInitialized()) {
                 state = MSP_SDCARD_STATE_FS_INIT;
             } else {
                 state = MSP_SDCARD_STATE_CARD_INIT;
             }
             break;

            case AFATFS_FILESYSTEM_STATE_FATAL:
            case AFATFS_FILESYSTEM_STATE_UNKNOWN:
            default:
                state = MSP_SDCARD_STATE_FATAL;
                break;
            }
        }

        lastError = afatfs_getLastError();
        // Write free space and total space in kilobytes
        if (state == MSP_SDCARD_STATE_READY) {
            freeSpace = afatfs_getContiguousFreeSpace() / 1024;
            totalSpace = sdcard_getMetadata()->numBlocks / 2;
        }
    }
#endif

    sbufWriteU8(dst, flags);
    sbufWriteU8(dst, state);
    sbufWriteU8(dst, lastError);
    sbufWriteU32(dst, freeSpace);
    sbufWriteU32(dst, totalSpace);
}

static void serializeDataflashSummaryReply(sbuf_t *dst)
{
#ifdef USE_FLASHFS
    if (flashfsIsSupported()) {
        uint8_t flags = MSP_FLASHFS_FLAG_SUPPORTED;
        flags |= (flashfsIsReady() ? MSP_FLASHFS_FLAG_READY : 0);

        const flashPartition_t *flashPartition = flashPartitionFindByType(FLASH_PARTITION_TYPE_FLASHFS);

        sbufWriteU8(dst, flags);
        sbufWriteU32(dst, FLASH_PARTITION_SECTOR_COUNT(flashPartition));
        sbufWriteU32(dst, flashfsGetSize());
        sbufWriteU32(dst, flashfsGetOffset()); // Effectively the current number of bytes stored on the volume
    } else
#endif

    // FlashFS is not configured or valid device is not detected
    {
        sbufWriteU8(dst, 0);
        sbufWriteU32(dst, 0);
        sbufWriteU32(dst, 0);
        sbufWriteU32(dst, 0);
    }
}

#ifdef USE_FLASHFS
enum compressionType_e {
    NO_COMPRESSION,
    HUFFMAN
};

static void serializeDataflashReadReply(sbuf_t *dst, uint32_t address, const uint16_t size, bool useLegacyFormat, bool allowCompression)
{
    STATIC_ASSERT(MSP_PORT_DATAFLASH_INFO_SIZE >= 16, MSP_PORT_DATAFLASH_INFO_SIZE_invalid);

    uint16_t readLen = size;
    const int bytesRemainingInBuf = sbufBytesRemaining(dst) - MSP_PORT_DATAFLASH_INFO_SIZE;
    if (readLen > bytesRemainingInBuf) {
        readLen = bytesRemainingInBuf;
    }
    // size will be lower than that requested if we reach end of volume
    const uint32_t flashfsSize = flashfsGetSize();
    if (readLen > flashfsSize - address) {
        // truncate the request
        readLen = flashfsSize - address;
    }
    sbufWriteU32(dst, address);

    // legacy format does not support compression
#ifdef USE_HUFFMAN
    const uint8_t compressionMethod = (!allowCompression || useLegacyFormat) ? NO_COMPRESSION : HUFFMAN;
#else
    const uint8_t compressionMethod = NO_COMPRESSION;
    UNUSED(allowCompression);
#endif

    if (compressionMethod == NO_COMPRESSION) {

        uint16_t *readLenPtr = (uint16_t *)sbufPtr(dst);
        if (!useLegacyFormat) {
            // new format supports variable read lengths
            sbufWriteU16(dst, readLen);
            sbufWriteU8(dst, 0); // placeholder for compression format
        }

        const int bytesRead = flashfsReadAbs(address, sbufPtr(dst), readLen);

        if (!useLegacyFormat) {
            // update the 'read length' with the actual amount read from flash.
            *readLenPtr = bytesRead;
        }

        sbufAdvance(dst, bytesRead);

        if (useLegacyFormat) {
            // pad the buffer with zeros
            for (int i = bytesRead; i < size; i++) {
                sbufWriteU8(dst, 0);
            }
        }
    } else {
#ifdef USE_HUFFMAN
        // compress in 256-byte chunks
        const uint16_t READ_BUFFER_SIZE = 256;
        // This may be DMAable, so make it cache aligned
        __attribute__ ((aligned(32))) uint8_t readBuffer[READ_BUFFER_SIZE];

        huffmanState_t state = {
            .bytesWritten = 0,
            .outByte = sbufPtr(dst) + sizeof(uint16_t) + sizeof(uint8_t) + HUFFMAN_INFO_SIZE,
            .outBufLen = readLen,
            .outBit = 0x80,
        };
        *state.outByte = 0;

        uint16_t bytesReadTotal = 0;
        // read until output buffer overflows or flash is exhausted
        while (state.bytesWritten < state.outBufLen && address + bytesReadTotal < flashfsSize) {
            const int bytesRead = flashfsReadAbs(address + bytesReadTotal, readBuffer,
                MIN(sizeof(readBuffer), flashfsSize - address - bytesReadTotal));

            const int status = huffmanEncodeBufStreaming(&state, readBuffer, bytesRead, huffmanTable);
            if (status == -1) {
                // overflow
                break;
            }

            bytesReadTotal += bytesRead;
        }

        if (state.outBit != 0x80) {
            ++state.bytesWritten;
        }

        // header
        sbufWriteU16(dst, HUFFMAN_INFO_SIZE + state.bytesWritten);
        sbufWriteU8(dst, compressionMethod);
        // payload
        sbufWriteU16(dst, bytesReadTotal);
        sbufAdvance(dst, state.bytesWritten);
#endif
    }
}
#endif // USE_FLASHFS

/*
 * Returns true if the command was processd, false otherwise.
 * May set mspPostProcessFunc to a function to be called once the command has been processed
 */
static bool mspCommonProcessOutCommand(int16_t cmdMSP, sbuf_t *dst, mspPostProcessFnPtr *mspPostProcessFn)
{
    UNUSED(mspPostProcessFn);

    switch (cmdMSP) {
    case MSP_API_VERSION:
        sbufWriteU8(dst, MSP_PROTOCOL_VERSION);
        sbufWriteU8(dst, API_VERSION_MAJOR);
        sbufWriteU8(dst, API_VERSION_MINOR);
        break;

    case MSP_FC_VARIANT:
        sbufWriteData(dst, flightControllerIdentifier, FLIGHT_CONTROLLER_IDENTIFIER_LENGTH);
        break;

    case MSP_FC_VERSION:
        sbufWriteU8(dst, (uint8_t)(FC_VERSION_YEAR - FC_CALVER_BASE_YEAR)); // year since 2000
        sbufWriteU8(dst, FC_VERSION_MONTH);
        sbufWriteU8(dst, FC_VERSION_PATCH_LEVEL);
        sbufWritePString(dst, FC_VERSION_STRING);
        break;

    case MSP2_MCU_INFO: {
        sbufWriteU8(dst, MCU_TYPE_ID_PROVIDED_BY_NAME);
        sbufWritePString(dst, getMcuTypeName());
        break;
    }

    case MSP_BOARD_INFO: {
        sbufWriteData(dst, systemConfig()->boardIdentifier, BOARD_IDENTIFIER_LENGTH);
#ifdef USE_HARDWARE_REVISION_DETECTION
        sbufWriteU16(dst, hardwareRevision);
#else
        sbufWriteU16(dst, 0); // No other build targets currently have hardware revision detection.
#endif
#if defined(USE_MAX7456)
        sbufWriteU8(dst, 2);  // 2 == FC with MAX7456
#else
        sbufWriteU8(dst, 0);  // 0 == FC
#endif

        // Target capabilities (uint8)
#define TARGET_HAS_VCP 0
#define TARGET_HAS_SOFTSERIAL 1
#define TARGET_HAS_FLASH_BOOTLOADER 3
#define TARGET_SUPPORTS_RX_BIND 6

        uint8_t targetCapabilities = 0;
#ifdef USE_VCP
        targetCapabilities |= BIT(TARGET_HAS_VCP);
#endif
#if defined(USE_SOFTSERIAL)
        targetCapabilities |= BIT(TARGET_HAS_SOFTSERIAL);
#endif
#if defined(USE_FLASH_BOOT_LOADER)
        targetCapabilities |= BIT(TARGET_HAS_FLASH_BOOTLOADER);
#endif
#if defined(USE_RX_BIND)
        if (getRxBindSupported()) {
            targetCapabilities |= BIT(TARGET_SUPPORTS_RX_BIND);
        }
#endif

        sbufWriteU8(dst, targetCapabilities);

        // Target name with explicit length
        sbufWritePString(dst, targetName);

#if defined(USE_BOARD_INFO)
        // Board name with explicit length
        sbufWritePString(dst, getBoardName());

        // Manufacturer id with explicit length
        sbufWritePString(dst, getManufacturerId());
#else
        sbufWriteU8(dst, 0);
        sbufWriteU8(dst, 0);
#endif

#if defined(USE_SIGNATURE)
        // Signature
        sbufWriteData(dst, getSignature(), SIGNATURE_LENGTH);
#else
        uint8_t emptySignature[SIGNATURE_LENGTH];
        memset(emptySignature, 0, sizeof(emptySignature));
        sbufWriteData(dst, &emptySignature, sizeof(emptySignature));
#endif

        sbufWriteU8(dst, MCU_TYPE_ID_PROVIDED_BY_NAME);

        // Added in API version 1.42
        sbufWriteU8(dst, systemConfig()->configurationState);

        // Added in API version 1.43
        sbufWriteU16(dst, gyro.sampleRateHz); // informational so the configurator can display the correct gyro/pid frequencies in the drop-down

        // Configuration warnings / problems (uint32_t)
#define PROBLEM_ACC_NEEDS_CALIBRATION 0
#define PROBLEM_MOTOR_PROTOCOL_DISABLED 1

        uint32_t configurationProblems = 0;

#if defined(USE_ACC)
        if (!accHasBeenCalibrated()) {
            configurationProblems |= BIT(PROBLEM_ACC_NEEDS_CALIBRATION);
        }
#endif

        if (!checkMotorProtocolEnabled(&motorConfig()->dev, NULL)) {
            configurationProblems |= BIT(PROBLEM_MOTOR_PROTOCOL_DISABLED);
        }

        sbufWriteU32(dst, configurationProblems);

        // Added in MSP API 1.44
#if defined(USE_SPI)
        sbufWriteU8(dst, spiGetRegisteredDeviceCount());
#else
        sbufWriteU8(dst, 0);
#endif
#if defined(USE_I2C)
        sbufWriteU8(dst, i2cGetRegisteredDeviceCount());
#else
        sbufWriteU8(dst, 0);
#endif

        break;
    }

    case MSP_BUILD_INFO:
        sbufWriteData(dst, buildDate, BUILD_DATE_LENGTH);
        sbufWriteData(dst, buildTime, BUILD_TIME_LENGTH);
        sbufWriteData(dst, shortGitRevision, GIT_SHORT_REVISION_LENGTH);
        // Added in API version 1.46
        sbufWriteBuildInfoFlags(dst);
        break;

    case MSP_ANALOG:
        sbufWriteU8(dst, (uint8_t)constrain(getLegacyBatteryVoltage(), 0, 255));
        sbufWriteU16(dst, (uint16_t)constrain(getMAhDrawn(), 0, 0xFFFF)); // milliamp hours drawn from battery
        sbufWriteU16(dst, getRssi());
        sbufWriteU16(dst, (int16_t)constrain(getAmperage(), -0x8000, 0x7FFF)); // send current in 0.01 A steps, range is -320A to 320A
        sbufWriteU16(dst, getBatteryVoltage());
        break;

    case MSP_DEBUG:
        for (int i = 0; i < DEBUG16_VALUE_COUNT; i++) {
            sbufWriteU16(dst, debug[i]);      // 4 variables are here for general monitoring purpose
        }
        break;

    case MSP_UID:
        sbufWriteU32(dst, U_ID_0);
        sbufWriteU32(dst, U_ID_1);
        sbufWriteU32(dst, U_ID_2);
        break;

    case MSP_FEATURE_CONFIG:
        sbufWriteU32(dst, featureConfig()->enabledFeatures);
        break;

#ifdef USE_BEEPER
    case MSP_BEEPER_CONFIG:
        sbufWriteU32(dst, beeperConfig()->beeper_off_flags);
        sbufWriteU8(dst, beeperConfig()->dshotBeaconTone);
        sbufWriteU32(dst, beeperConfig()->dshotBeaconOffFlags);
        break;
#endif

    case MSP_BATTERY_STATE: {
        // battery characteristics
        sbufWriteU8(dst, (uint8_t)constrain(getBatteryCellCount(), 0, 255)); // 0 indicates battery not detected.
        sbufWriteU16(dst, currentBatteryProfile->batteryCapacity); // in mAh

        // battery state
        sbufWriteU8(dst, (uint8_t)constrain(getLegacyBatteryVoltage(), 0, 255)); // in 0.1V steps
        sbufWriteU16(dst, (uint16_t)constrain(getMAhDrawn(), 0, 0xFFFF)); // milliamp hours drawn from battery
        sbufWriteU16(dst, (int16_t)constrain(getAmperage(), -0x8000, 0x7FFF)); // send current in 0.01 A steps, range is -320A to 320A

        // battery alerts
        sbufWriteU8(dst, (uint8_t)getBatteryState());

        sbufWriteU16(dst, getBatteryVoltage()); // in 0.01V steps
        break;
    }

    case MSP_VOLTAGE_METERS: {
        // write out id and voltage meter values, once for each meter we support
        uint8_t count = supportedVoltageMeterCount;
#ifdef USE_ESC_SENSOR
        count -= VOLTAGE_METER_ID_ESC_COUNT - getMotorCount();
#endif

        for (int i = 0; i < count; i++) {

            voltageMeter_t meter;
            uint8_t id = (uint8_t)voltageMeterIds[i];
            voltageMeterRead(id, &meter);

            sbufWriteU8(dst, id);
            sbufWriteU8(dst, (uint8_t)constrain((meter.displayFiltered + 5) / 10, 0, 255));
        }
        break;
    }

    case MSP_CURRENT_METERS: {
        // write out id and current meter values, once for each meter we support
        uint8_t count = supportedCurrentMeterCount;
#ifdef USE_ESC_SENSOR
        count -= VOLTAGE_METER_ID_ESC_COUNT - getMotorCount();
#endif
        for (int i = 0; i < count; i++) {

            currentMeter_t meter;
            uint8_t id = (uint8_t)currentMeterIds[i];
            currentMeterRead(id, &meter);

            sbufWriteU8(dst, id);
            sbufWriteU16(dst, (uint16_t)constrain(meter.mAhDrawn, 0, 0xFFFF)); // milliamp hours drawn from battery
            sbufWriteU16(dst, (uint16_t)constrain(meter.amperage * 10, 0, 0xFFFF)); // send amperage in 0.001 A steps (mA). Negative range is truncated to zero
        }
        break;
    }

    case MSP_VOLTAGE_METER_CONFIG: {
        // by using a sensor type and a sub-frame length it's possible to configure any type of voltage meter,
        // e.g. an i2c/spi/can sensor or any sensor not built directly into the FC such as ESC/RX/SPort/SBus that has
        // different configuration requirements.
        STATIC_ASSERT(VOLTAGE_SENSOR_ADC_VBAT == 0, VOLTAGE_SENSOR_ADC_VBAT_incorrect); // VOLTAGE_SENSOR_ADC_VBAT should be the first index
        sbufWriteU8(dst, MAX_VOLTAGE_SENSOR_ADC); // voltage meters in payload
        for (int i = VOLTAGE_SENSOR_ADC_VBAT; i < MAX_VOLTAGE_SENSOR_ADC; i++) {
            const uint8_t adcSensorSubframeLength = 1 + 1 + 1 + 1 + 1; // length of id, type, vbatscale, vbatresdivval, vbatresdivmultipler, in bytes
            sbufWriteU8(dst, adcSensorSubframeLength); // ADC sensor sub-frame length

            sbufWriteU8(dst, voltageMeterADCtoIDMap[i]); // id of the sensor
            sbufWriteU8(dst, VOLTAGE_SENSOR_TYPE_ADC_RESISTOR_DIVIDER); // indicate the type of sensor that the next part of the payload is for

            sbufWriteU8(dst, voltageSensorADCConfig(i)->vbatscale);
            sbufWriteU8(dst, voltageSensorADCConfig(i)->vbatresdivval);
            sbufWriteU8(dst, voltageSensorADCConfig(i)->vbatresdivmultiplier);
        }
        // if we had any other voltage sensors, this is where we would output any needed configuration
        break;
    }

    case MSP_CURRENT_METER_CONFIG: {
        // the ADC and VIRTUAL sensors have the same configuration requirements, however this API reflects
        // that this situation may change and allows us to support configuration of any current sensor with
        // specialist configuration requirements.

        int currentMeterCount = 1;

#ifdef USE_VIRTUAL_CURRENT_METER
        currentMeterCount++;
#endif
        sbufWriteU8(dst, currentMeterCount);

        const uint8_t adcSensorSubframeLength = 1 + 1 + 2 + 2; // length of id, type, scale, offset, in bytes
        sbufWriteU8(dst, adcSensorSubframeLength);
        sbufWriteU8(dst, CURRENT_METER_ID_BATTERY_1); // the id of the meter
        sbufWriteU8(dst, CURRENT_SENSOR_ADC); // indicate the type of sensor that the next part of the payload is for
        sbufWriteU16(dst, currentSensorADCConfig()->scale);
        sbufWriteU16(dst, currentSensorADCConfig()->offset);

#ifdef USE_VIRTUAL_CURRENT_METER
        const int8_t virtualSensorSubframeLength = 1 + 1 + 2 + 2; // length of id, type, scale, offset, in bytes
        sbufWriteU8(dst, virtualSensorSubframeLength);
        sbufWriteU8(dst, CURRENT_METER_ID_VIRTUAL_1); // the id of the meter
        sbufWriteU8(dst, CURRENT_SENSOR_VIRTUAL); // indicate the type of sensor that the next part of the payload is for
        sbufWriteU16(dst, currentSensorVirtualConfig()->scale);
        sbufWriteU16(dst, currentSensorVirtualConfig()->offset);
#endif

        // if we had any other current sensors, this is where we would output any needed configuration
        break;
    }

    case MSP_BATTERY_CONFIG:
        sbufWriteU8(dst, (currentBatteryProfile->vbatmincellvoltage + 5) / 10);
        sbufWriteU8(dst, (currentBatteryProfile->vbatmaxcellvoltage + 5) / 10);
        sbufWriteU8(dst, (currentBatteryProfile->vbatwarningcellvoltage + 5) / 10);
        sbufWriteU16(dst, currentBatteryProfile->batteryCapacity);
        sbufWriteU8(dst, batteryConfig()->voltageMeterSource);
        sbufWriteU8(dst, batteryConfig()->currentMeterSource);
        sbufWriteU16(dst, currentBatteryProfile->vbatmincellvoltage);
        sbufWriteU16(dst, currentBatteryProfile->vbatmaxcellvoltage);
        sbufWriteU16(dst, currentBatteryProfile->vbatwarningcellvoltage);
        break;

    case MSP_TRANSPONDER_CONFIG: {
#ifdef USE_TRANSPONDER
        // Backward compatibility to BFC 3.1.1 is lost for this message type
        sbufWriteU8(dst, TRANSPONDER_PROVIDER_COUNT);
        for (unsigned int i = 0; i < TRANSPONDER_PROVIDER_COUNT; i++) {
            sbufWriteU8(dst, transponderRequirements[i].provider);
            sbufWriteU8(dst, transponderRequirements[i].dataLength);
        }

        uint8_t provider = transponderConfig()->provider;
        sbufWriteU8(dst, provider);

        if (provider) {
            uint8_t requirementIndex = provider - 1;
            uint8_t providerDataLength = transponderRequirements[requirementIndex].dataLength;

            for (unsigned int i = 0; i < providerDataLength; i++) {
                sbufWriteU8(dst, transponderConfig()->data[i]);
            }
        }
#else
        sbufWriteU8(dst, 0); // no providers
#endif
        break;
    }

#if defined(USE_OSD)
    case MSP_OSD_CONFIG: {
#define OSD_FLAGS_OSD_FEATURE           (1 << 0)
//#define OSD_FLAGS_OSD_SLAVE             (1 << 1)
#define OSD_FLAGS_RESERVED_1            (1 << 2)
#define OSD_FLAGS_OSD_HARDWARE_FRSKYOSD (1 << 3)
#define OSD_FLAGS_OSD_HARDWARE_MAX_7456 (1 << 4)
#define OSD_FLAGS_OSD_DEVICE_DETECTED   (1 << 5)
#define OSD_FLAGS_OSD_MSP_DEVICE        (1 << 6)
#define OSD_FLAGS_OSD_HARDWARE_AIRBOT_THEIA_OSD (1 << 7)

#if ENABLE_FB_OSD
// TODO allocated a new flag for FB_OSD (maybe reuse 1 << 1 ? ), and update Configurator accordingly.
// For now, pretend to Configurator that we are max7456
#define OSD_FLAGS_OSD_HARDWARE_FB_OSD   (1 << 4)
#endif

        uint8_t osdFlags = 0;

        osdFlags |= OSD_FLAGS_OSD_FEATURE;

        osdDisplayPortDevice_e deviceType;
        displayPort_t *osdDisplayPort = osdGetDisplayPort(&deviceType);
        bool displayIsReady = osdDisplayPort && displayCheckReady(osdDisplayPort, true);
        switch (deviceType) {
        case OSD_DISPLAYPORT_DEVICE_MAX7456:
            osdFlags |= OSD_FLAGS_OSD_HARDWARE_MAX_7456;
            if (displayIsReady) {
                osdFlags |= OSD_FLAGS_OSD_DEVICE_DETECTED;
            }

            break;
        case OSD_DISPLAYPORT_DEVICE_FRSKYOSD:
            osdFlags |= OSD_FLAGS_OSD_HARDWARE_FRSKYOSD;
            if (displayIsReady) {
                osdFlags |= OSD_FLAGS_OSD_DEVICE_DETECTED;
            }

            break;
        case OSD_DISPLAYPORT_DEVICE_MSP:
            osdFlags |= OSD_FLAGS_OSD_MSP_DEVICE
#ifdef USE_MSP_DISPLAYPORT_FONT
                        | OSD_FLAGS_OSD_HARDWARE_AIRBOT_THEIA_OSD
#endif
            ;
            if (displayIsReady) {
                osdFlags |= OSD_FLAGS_OSD_DEVICE_DETECTED;
            }

            break;
#if ENABLE_FB_OSD
        case OSD_DISPLAYPORT_DEVICE_FBOSD:
            osdFlags |= OSD_FLAGS_OSD_HARDWARE_FB_OSD;
            if (displayIsReady) {
                osdFlags |= OSD_FLAGS_OSD_DEVICE_DETECTED;
            }

            break;
#endif
        default:
            break;
        }

        sbufWriteU8(dst, osdFlags);

#ifdef USE_OSD_SD
        // send video system (AUTO/PAL/NTSC/HD)
        sbufWriteU8(dst, vcdProfile()->video_system);
#else
        sbufWriteU8(dst, VIDEO_SYSTEM_HD);
#endif // USE_OSD_SD

        // OSD specific, not applicable to OSD slaves.

        // Configuration
        sbufWriteU8(dst, osdConfig()->units);

        // Alarms
        sbufWriteU8(dst, osdConfig()->rssi_alarm);
        sbufWriteU16(dst, osdConfig()->cap_alarm);

        // Reuse old timer alarm (U16) as OSD_ITEM_COUNT
        sbufWriteU8(dst, 0);
        sbufWriteU8(dst, OSD_ITEM_COUNT);

        sbufWriteU16(dst, osdConfig()->alt_alarm);

        // Element position and visibility
        for (int i = 0; i < OSD_ITEM_COUNT; i++) {
            sbufWriteU16(dst, osdElementConfig()->item_pos[i]);
        }

        // Post flight statistics
        sbufWriteU8(dst, OSD_STAT_COUNT);
        for (int i = 0; i < OSD_STAT_COUNT; i++ ) {
            sbufWriteU8(dst, osdStatGetState(i));
        }

        // Timers
        sbufWriteU8(dst, OSD_TIMER_COUNT);
        for (int i = 0; i < OSD_TIMER_COUNT; i++) {
            sbufWriteU16(dst, osdConfig()->timers[i]);
        }

        // Enabled warnings
        // Send low word first for backwards compatibility (API < 1.41)
        sbufWriteU16(dst, (uint16_t)(osdConfig()->enabledWarnings & 0xFFFF));
        // API >= 1.41
        // Send the warnings count and 32bit enabled warnings flags.
        // Add currently active OSD profile (0 indicates OSD profiles not available).
        // Add OSD stick overlay mode (0 indicates OSD stick overlay not available).
        sbufWriteU8(dst, OSD_WARNING_COUNT);
        sbufWriteU32(dst, osdConfig()->enabledWarnings);

#ifdef USE_OSD_PROFILES
        sbufWriteU8(dst, OSD_PROFILE_COUNT);            // available profiles
        sbufWriteU8(dst, osdConfig()->osdProfileIndex); // selected profile
#else
        // If the feature is not available there is only 1 profile and it's always selected
        sbufWriteU8(dst, 1);
        sbufWriteU8(dst, 1);
#endif // USE_OSD_PROFILES

#ifdef USE_OSD_STICK_OVERLAY
        sbufWriteU8(dst, osdConfig()->overlay_radio_mode);
#else
        sbufWriteU8(dst, 0);
#endif // USE_OSD_STICK_OVERLAY

        // API >= 1.43
        // Add the camera frame element width/height
        sbufWriteU8(dst, osdConfig()->camera_frame_width);
        sbufWriteU8(dst, osdConfig()->camera_frame_height);

        // API >= 1.46
        sbufWriteU16(dst, osdConfig()->link_quality_alarm);

        // API >= 1.47
        sbufWriteU16(dst, osdConfig()->rssi_dbm_alarm);

        break;
    }
#endif // USE_OSD

    case MSP_OSD_CANVAS: {
#ifdef USE_OSD
        sbufWriteU8(dst, osdConfig()->canvas_cols);
        sbufWriteU8(dst, osdConfig()->canvas_rows);
#endif
        break;
    }

    default:
        return false;
    }
    return true;
}

static bool mspProcessOutCommand(mspDescriptor_t srcDesc, int16_t cmdMSP, sbuf_t *dst)
{
    bool unsupportedCommand = false;

#if !defined(USE_VTX_COMMON) || !defined(USE_VTX_MSP)
    UNUSED(srcDesc);
#endif

    switch (cmdMSP) {
    case MSP_STATUS_EX:
    case MSP_STATUS: {
        boxBitmask_t flightModeFlags;
        const int flagBits = packFlightModeFlags(&flightModeFlags);
#ifdef USE_MSP_DISPLAYPORT
        // Digital VTX (DJI O3/O4) stays in low power until it sees ARM; optionally
        // report ARM to the displayport device only. Arming state is unchanged.
        if (displayPortProfileMsp()->reportArmed
            && displayPortMspGetSerial() != SERIAL_PORT_NONE
            && srcDesc == getMspSerialPortDescriptor(displayPortMspGetSerial())) {
            bitArraySet(&flightModeFlags, 0);   // BOXARM is always the first active box
        }
#endif

        sbufWriteU16(dst, getTaskDeltaTimeUs(TASK_PID));
#ifdef USE_I2C
        sbufWriteU16(dst, i2cGetErrorCounter());
#else
        sbufWriteU16(dst, 0);
#endif
        sbufWriteU16(dst, sensors(SENSOR_ACC) | sensors(SENSOR_BARO) << 1 | sensors(SENSOR_MAG) << 2 | sensors(SENSOR_GPS) << 3 | sensors(SENSOR_RANGEFINDER) << 4 | sensors(SENSOR_GYRO) << 5 | sensors(SENSOR_OPTICALFLOW) << 6);
        sbufWriteData(dst, &flightModeFlags, 4);        // unconditional part of flags, first 32 bits
        sbufWriteU8(dst, getCurrentPidProfileIndex());
        sbufWriteU16(dst, constrain(getAverageSystemLoadPercent(), 0, LOAD_PERCENTAGE_ONE));
        if (cmdMSP == MSP_STATUS_EX) {
            sbufWriteU8(dst, PID_PROFILE_COUNT);
            sbufWriteU8(dst, getCurrentControlRateProfileIndex());
        } else {  // MSP_STATUS
            sbufWriteU16(dst, 0); // gyro cycle time
        }

        // write flightModeFlags header. Lowest 4 bits contain number of bytes that follow
        // header is emited even when all bits fit into 32 bits to allow future extension
        int byteCount = (flagBits - 32 + 7) / 8;        // 32 already stored, round up
        byteCount = constrain(byteCount, 0, 15);        // limit to 16 bytes (128 bits)
        sbufWriteU8(dst, byteCount);
        sbufWriteData(dst, ((uint8_t*)&flightModeFlags) + 4, byteCount);

        // Write arming disable flags
        // 1 byte, flag count
        sbufWriteU8(dst, ARMING_DISABLE_FLAGS_COUNT);
        // 4 bytes, flags
        const uint32_t armingDisableFlags = getArmingDisableFlags();
        sbufWriteU32(dst, armingDisableFlags);

        // config state flags - bits to indicate the state of the configuration, reboot required, etc.
        // other flags can be added as needed
        sbufWriteU8(dst, (getRebootRequired() << 0));

        // Added in API version 1.46
        // Write CPU temp
#ifdef USE_ADC_INTERNAL
        sbufWriteU16(dst, getCoreTemperatureCelsius());
#else
        sbufWriteU16(dst, 0);
#endif
        sbufWriteU8(dst, CONTROL_RATE_PROFILE_COUNT);

        // Added in API version 1.48
        sbufWriteU8(dst, BATTERY_PROFILE_COUNT);
        sbufWriteU8(dst, getCurrentBatteryProfileIndex());
        break;
    }

    case MSP_RAW_IMU: {
        for (int i = 0; i < 3; i++) {
#if defined(USE_ACC)
            sbufWriteU16(dst, lrintf(acc.accADC.v[i]));
#else
            sbufWriteU16(dst, 0);
#endif
        }
        for (int i = 0; i < 3; i++) {
            sbufWriteU16(dst, gyroRateDps(i));
        }
        for (int i = 0; i < 3; i++) {
#if defined(USE_MAG)
            sbufWriteU16(dst, lrintf(mag.magADC.v[i]));
#else
            sbufWriteU16(dst, 0);
#endif
        }
        break;
    }

case MSP_NAME:
        sbufWriteString(dst, pilotConfig()->craftName);
        break;

#ifdef USE_SERVOS
    case MSP_SERVO:
        sbufWriteData(dst, &servo, MAX_SUPPORTED_SERVOS * 2);
        break;
    case MSP_SERVO_CONFIGURATIONS:
        for (int i = 0; i < MAX_SUPPORTED_SERVOS; i++) {
            sbufWriteU16(dst, servoParams(i)->min);
            sbufWriteU16(dst, servoParams(i)->max);
            sbufWriteU16(dst, servoParams(i)->middle);
            sbufWriteU8(dst, servoParams(i)->rate);
            sbufWriteU8(dst, servoParams(i)->forwardFromChannel);
            sbufWriteU32(dst, servoParams(i)->reversedSources);
        }
        break;

    case MSP_SERVO_MIX_RULES:
        for (int i = 0; i < MAX_SERVO_RULES; i++) {
            sbufWriteU8(dst, customServoMixers(i)->targetChannel);
            sbufWriteU8(dst, customServoMixers(i)->inputSource);
            sbufWriteU8(dst, customServoMixers(i)->rate);
            sbufWriteU8(dst, customServoMixers(i)->speed);
            sbufWriteU8(dst, customServoMixers(i)->min);
            sbufWriteU8(dst, customServoMixers(i)->max);
            sbufWriteU8(dst, customServoMixers(i)->box);
        }
        break;
#endif

    case MSP_MOTOR:
        for (unsigned i = 0; i < 8; i++) {
#ifdef USE_MOTOR
            if (!motorIsEnabled() || i >= MAX_SUPPORTED_MOTORS || !motorIsMotorEnabled(i)) {
                sbufWriteU16(dst, 0);
                continue;
            }

            sbufWriteU16(dst, motorConvertToExternal(motor[i]));
#else
            sbufWriteU16(dst, 0);
#endif
        }
        break;

    // Added in API version 1.42
    case MSP_MOTOR_TELEMETRY:
        sbufWriteU8(dst, getMotorCount());
        for (unsigned i = 0; i < getMotorCount(); i++) {
            int rpm = 0;
            uint16_t invalidPct = 0;
            uint8_t escTemperature = 0;  // degrees celcius
            uint16_t escVoltage = 0;     // 0.01V per unit
            uint16_t escCurrent = 0;     // 0.01A per unit
            uint16_t escConsumption = 0; // mAh

            bool rpmDataAvailable = false;

#ifdef USE_DSHOT_TELEMETRY
            if (useDshotTelemetry) {
                rpm = lrintf(getDshotRpm(i));
                rpmDataAvailable = true;
                invalidPct = 10000; // 100.00%

#ifdef USE_DSHOT_TELEMETRY_STATS
                if (isDshotMotorTelemetryActive(i)) {
                    invalidPct = getDshotTelemetryMotorInvalidPercent(i);
                }
#endif

                // Provide extended dshot telemetry
                if ((dshotTelemetryState.motorState[i].telemetryTypes & DSHOT_EXTENDED_TELEMETRY_MASK) != 0) {
                    // Temperature Celsius [0, 1, ..., 255] in degree Celsius, just like Blheli_32 and KISS
                    if ((dshotTelemetryState.motorState[i].telemetryTypes & (1 << DSHOT_TELEMETRY_TYPE_TEMPERATURE)) != 0) {
                        escTemperature = dshotTelemetryState.motorState[i].telemetryData[DSHOT_TELEMETRY_TYPE_TEMPERATURE];
                    }

                    // Current -> 0-255A step 1A
                    if ((dshotTelemetryState.motorState[i].telemetryTypes & (1 << DSHOT_TELEMETRY_TYPE_CURRENT)) != 0) {
                        escCurrent = dshotTelemetryState.motorState[i].telemetryData[DSHOT_TELEMETRY_TYPE_CURRENT];
                    }

                    // Voltage -> 0-63,75V step 0,25V
                    if ((dshotTelemetryState.motorState[i].telemetryTypes & (1 << DSHOT_TELEMETRY_TYPE_VOLTAGE)) != 0) {
                        escVoltage = dshotTelemetryState.motorState[i].telemetryData[DSHOT_TELEMETRY_TYPE_VOLTAGE] >> 2;
                    }
                }
            }
#endif

#ifdef USE_ESC_SENSOR
            if (featureIsEnabled(FEATURE_ESC_SENSOR)) {
                escSensorData_t *escData = getEscSensorData(i);
                if (!rpmDataAvailable) {  // We want DSHOT telemetry RPM data (if available) to have precedence
                    rpm = lrintf(erpmToRpm(escData->rpm));
                    rpmDataAvailable = true;
                }
                escTemperature = escData->temperature;
                escVoltage = escData->voltage;
                escCurrent = escData->current;
                escConsumption = escData->consumption;
            }
#endif

            sbufWriteU32(dst, (rpmDataAvailable ? rpm : 0));
            sbufWriteU16(dst, invalidPct);
            sbufWriteU8(dst, escTemperature);
            sbufWriteU16(dst, escVoltage);
            sbufWriteU16(dst, escCurrent);
            sbufWriteU16(dst, escConsumption);
        }
        break;

    case MSP2_MOTOR_OUTPUT_REORDERING:
        {
            sbufWriteU8(dst, MAX_SUPPORTED_MOTORS);

            for (unsigned i = 0; i < MAX_SUPPORTED_MOTORS; i++) {
                sbufWriteU8(dst, motorConfig()->dev.motorOutputReordering[i]);
            }
        }
        break;

#ifdef USE_VTX_COMMON
    case MSP2_GET_VTX_DEVICE_STATUS: {
        const vtxDevice_t *vtxDevice = vtxCommonDevice();
        vtxCommonSerializeDeviceStatus(vtxDevice, dst);
        break;
    }
#endif

#ifdef USE_OSD
    case MSP2_GET_OSD_WARNINGS: {
        bool isBlinking;
        uint8_t displayAttr;
        char warningsBuffer[OSD_WARNINGS_MAX_SIZE + 1];

        renderOsdWarning(warningsBuffer, &isBlinking, &displayAttr);

        if (isBlinking) {
            displayAttr |= DISPLAYPORT_BLINK;
        }
        sbufWriteU8(dst, displayAttr);  // see displayPortSeverity_e
        sbufWritePString(dst, warningsBuffer);

        break;
    }
#endif

    case MSP_RC:
        for (int i = 0; i < rxRuntimeState.channelCount; i++) {
            sbufWriteU16(dst, rcData[i]);
        }
        break;

    case MSP_ATTITUDE:
        sbufWriteU16(dst, attitude.values.roll);
        sbufWriteU16(dst, attitude.values.pitch);
        sbufWriteU16(dst, DECIDEGREES_TO_DEGREES(attitude.values.yaw));
        break;

    case MSP_ATTITUDE_QUATERNION: {
        const float q_scale = 0x7FFF;
        // Create temporary int16_t variables
        int16_t w = lrintf(imuAttitudeQuaternion.w * q_scale);
        int16_t x = lrintf(imuAttitudeQuaternion.x * q_scale);
        int16_t y = lrintf(imuAttitudeQuaternion.y * q_scale);
        int16_t z = lrintf(imuAttitudeQuaternion.z * q_scale); 
        // Write their bit representation as uint16_t
        sbufWriteU16(dst, *(uint16_t*)&w);
        sbufWriteU16(dst, *(uint16_t*)&x);
        sbufWriteU16(dst, *(uint16_t*)&y);
        sbufWriteU16(dst, *(uint16_t*)&z);
        break;
    }

    case MSP_ALTITUDE:
        sbufWriteU32(dst, getEstimatedAltitudeCm());
#ifdef USE_VARIO
        sbufWriteU16(dst, getEstimatedVario());
#else
        sbufWriteU16(dst, 0);
#endif
        break;

    case MSP_SONAR_ALTITUDE:
#if defined(USE_RANGEFINDER)
        sbufWriteU32(dst, rangefinderGetLatestAltitude());
#else
        sbufWriteU32(dst, 0);
#endif
        break;

    case MSP_BOARD_ALIGNMENT_CONFIG:
        sbufWriteU16(dst, boardAlignment()->rollDegrees);
        sbufWriteU16(dst, boardAlignment()->pitchDegrees);
        sbufWriteU16(dst, boardAlignment()->yawDegrees);
        break;

    case MSP_ARMING_CONFIG:
        sbufWriteU8(dst, armingConfig()->auto_disarm_delay);
        sbufWriteU8(dst, 0);
        sbufWriteU8(dst, imuConfig()->small_angle);
        sbufWriteU8(dst, armingConfig()->gyro_cal_on_first_arm);
        break;

    case MSP_RC_TUNING:
        sbufWriteU8(dst, currentControlRateProfile->rcRates[FD_ROLL]);
        sbufWriteU8(dst, currentControlRateProfile->rcExpo[FD_ROLL]);
        for (int i = 0 ; i < 3; i++) {
            sbufWriteU8(dst, currentControlRateProfile->rates[i]); // R,P,Y see flight_dynamics_index_t
        }
        sbufWriteU8(dst, 0);   // was currentControlRateProfile->tpa_rate
        sbufWriteU8(dst, currentControlRateProfile->thrMid8);
        sbufWriteU8(dst, currentControlRateProfile->thrExpo8);
        sbufWriteU16(dst, 0);   // was currentControlRateProfile->tpa_breakpoint
        sbufWriteU8(dst, currentControlRateProfile->rcExpo[FD_YAW]);
        sbufWriteU8(dst, currentControlRateProfile->rcRates[FD_YAW]);
        sbufWriteU8(dst, currentControlRateProfile->rcRates[FD_PITCH]);
        sbufWriteU8(dst, currentControlRateProfile->rcExpo[FD_PITCH]);

        // added in 1.41
        sbufWriteU8(dst, currentControlRateProfile->throttle_limit_type);
        sbufWriteU8(dst, currentControlRateProfile->throttle_limit_percent);

        // added in 1.42
        sbufWriteU16(dst, currentControlRateProfile->rate_limit[FD_ROLL]);
        sbufWriteU16(dst, currentControlRateProfile->rate_limit[FD_PITCH]);
        sbufWriteU16(dst, currentControlRateProfile->rate_limit[FD_YAW]);

        // added in 1.43
        sbufWriteU8(dst, currentControlRateProfile->rates_type);

        // added in 1.47
        sbufWriteU8(dst, currentControlRateProfile->thrHover8);

        break;

    case MSP_PID:
        for (int i = 0; i < PID_ITEM_COUNT; i++) {
            sbufWriteU8(dst, currentPidProfile->pid[i].P);
            sbufWriteU8(dst, currentPidProfile->pid[i].I);
            sbufWriteU8(dst, currentPidProfile->pid[i].D);
        }
        break;

    case MSP_PIDNAMES:
        for (const char *c = pidNames; *c; c++) {
            sbufWriteU8(dst, *c);
        }
        break;

    case MSP_PID_CONTROLLER:
        sbufWriteU8(dst, PID_CONTROLLER_BETAFLIGHT);
        break;

    case MSP_MODE_RANGES:
        for (int i = 0; i < MAX_MODE_ACTIVATION_CONDITION_COUNT; i++) {
            const modeActivationCondition_t *mac = modeActivationConditions(i);
            const box_t *box = findBoxByBoxId(mac->modeId);
            sbufWriteU8(dst, box->permanentId);
            sbufWriteU8(dst, mac->auxChannelIndex);
            sbufWriteU8(dst, mac->range.startStep);
            sbufWriteU8(dst, mac->range.endStep);
        }
        break;

    case MSP_MODE_RANGES_EXTRA:
        sbufWriteU8(dst, MAX_MODE_ACTIVATION_CONDITION_COUNT);          // prepend number of EXTRAs array elements

        for (int i = 0; i < MAX_MODE_ACTIVATION_CONDITION_COUNT; i++) {
            const modeActivationCondition_t *mac = modeActivationConditions(i);
            const box_t *box = findBoxByBoxId(mac->modeId);
            const box_t *linkedBox = findBoxByBoxId(mac->linkedTo);
            sbufWriteU8(dst, box->permanentId);     // each element is aligned with MODE_RANGES by the permanentId
            sbufWriteU8(dst, mac->modeLogic);
            sbufWriteU8(dst, linkedBox->permanentId);
        }
        break;

    case MSP_ADJUSTMENT_RANGES:
        for (int i = 0; i < MAX_ADJUSTMENT_RANGE_COUNT; i++) {
            const adjustmentRange_t *adjRange = adjustmentRanges(i);
            sbufWriteU8(dst, 0); // was adjRange->adjustmentIndex
            sbufWriteU8(dst, adjRange->auxChannelIndex);
            sbufWriteU8(dst, adjRange->range.startStep);
            sbufWriteU8(dst, adjRange->range.endStep);
            sbufWriteU8(dst, adjRange->adjustmentConfig);
            sbufWriteU8(dst, adjRange->auxSwitchChannelIndex);
            sbufWriteU16(dst, adjRange->adjustmentCenter);
            sbufWriteU16(dst, adjRange->adjustmentScale);
        }
        break;

    case MSP_MOTOR_CONFIG:
        sbufWriteU16(dst, 0); // was minthrottle until after 4.5
        sbufWriteU16(dst, motorConfig()->maxthrottle);
        sbufWriteU16(dst, motorConfig()->mincommand);

        // API 1.42
        sbufWriteU8(dst, getMotorCount());
        sbufWriteU8(dst, motorConfig()->motorPoleCount);
#ifdef USE_DSHOT_TELEMETRY
        sbufWriteU8(dst, useDshotTelemetry);
#else
        sbufWriteU8(dst, 0);
#endif

#ifdef USE_ESC_SENSOR
        sbufWriteU8(dst, featureIsEnabled(FEATURE_ESC_SENSOR)); // ESC sensor available
#else
        sbufWriteU8(dst, 0);
#endif
        break;

#ifdef USE_MAG
    case MSP_COMPASS_CONFIG:
        sbufWriteU16(dst, imuConfig()->mag_declination);
        break;
#endif
    // Deprecated in favor of MSP_MOTOR_TELEMETY as of API version 1.42
    // Used by DJI FPV
    case MSP_ESC_SENSOR_DATA:
#if defined(USE_ESC_SENSOR)
        if (featureIsEnabled(FEATURE_ESC_SENSOR)) {
            sbufWriteU8(dst, getMotorCount());
            for (int i = 0; i < getMotorCount(); i++) {
                const escSensorData_t *escData = getEscSensorData(i);
                sbufWriteU8(dst, escData->temperature);
                sbufWriteU16(dst, escData->rpm);
            }
        } else
#endif
#if defined(USE_DSHOT_TELEMETRY)
        if (useDshotTelemetry) {
            sbufWriteU8(dst, getMotorCount());
            for (int i = 0; i < getMotorCount(); i++) {
                sbufWriteU8(dst, dshotTelemetryState.motorState[i].telemetryData[DSHOT_TELEMETRY_TYPE_TEMPERATURE]);
                sbufWriteU16(dst, lrintf(getDshotRpm(i)));
            }
        }
        else
#endif
        {
            unsupportedCommand = true;
        }

        break;

#ifdef USE_GPS
    case MSP_GPS_CONFIG:
        sbufWriteU8(dst, gpsConfig()->provider);
        sbufWriteU8(dst, gpsConfig()->sbasMode);
        sbufWriteU8(dst, gpsConfig()->autoConfig);
        sbufWriteU8(dst, gpsConfig()->autoBaud);
        // Added in API version 1.43
        sbufWriteU8(dst, gpsConfig()->gps_set_home_point_once);
        sbufWriteU8(dst, gpsConfig()->gps_ublox_use_galileo);
        break;

    case MSP_RAW_GPS:
        sbufWriteU8(dst, STATE(GPS_FIX));
        sbufWriteU8(dst, gpsSol.numSat);
        sbufWriteU32(dst, gpsSol.llh.lat);
        sbufWriteU32(dst, gpsSol.llh.lon);
        sbufWriteU16(dst, (uint16_t)constrain(gpsSol.llh.altCm / 100, 0, UINT16_MAX)); // alt changed from 1m to 0.01m per lsb since MSP API 1.39 by RTH. To maintain backwards compatibility compensate to 1m per lsb in MSP again.
        sbufWriteU16(dst, gpsSol.groundSpeed);
        sbufWriteU16(dst, gpsSol.groundCourse);
        // Added in API version 1.44
        sbufWriteU16(dst, gpsSol.dop.pdop);
        break;

    case MSP_COMP_GPS:
        sbufWriteU16(dst, GPS_distanceToHome);
        sbufWriteU16(dst, GPS_directionToHome / 10); // resolution increased in Betaflight 4.4 by factor of 10, this maintains backwards compatibility for DJI OSD
        sbufWriteU8(dst, GPS_update & 1);
        break;

    case MSP_GPSSVINFO:
        sbufWriteU8(dst, GPS_numCh);
        for (int i = 0; i < GPS_numCh; i++) {
           sbufWriteU8(dst, GPS_svinfo[i].chn);
           sbufWriteU8(dst, GPS_svinfo[i].svid);
           sbufWriteU8(dst, GPS_svinfo[i].quality);
           sbufWriteU8(dst, GPS_svinfo[i].cno);
        }
        break;

#ifdef USE_GPS_RESCUE
#ifndef USE_WING
    case MSP_GPS_RESCUE:
        sbufWriteU16(dst, autopilotConfig()->maxAngle);
        sbufWriteU16(dst, gpsRescueConfig()->returnAltitudeM);
        sbufWriteU16(dst, gpsRescueConfig()->descentDistanceM);
        sbufWriteU16(dst, gpsRescueConfig()->groundSpeedCmS);
        sbufWriteU16(dst, autopilotConfig()->throttleMin);
        sbufWriteU16(dst, autopilotConfig()->throttleMax);
        sbufWriteU16(dst, autopilotConfig()->hoverThrottle);
        sbufWriteU8(dst,  gpsRescueConfig()->sanityChecks);
        sbufWriteU8(dst,  gpsRescueConfig()->minSats);

        // Added in API version 1.43
        sbufWriteU16(dst, gpsRescueConfig()->ascendRate);
        sbufWriteU16(dst, gpsRescueConfig()->descendRate);
        sbufWriteU8(dst, gpsRescueConfig()->allowArmingWithoutFix);
        sbufWriteU8(dst, gpsRescueConfig()->altitudeMode);
        // Added in API version 1.44
        sbufWriteU16(dst, gpsRescueConfig()->minStartDistM);
        // Added in API version 1.46
        sbufWriteU16(dst, gpsRescueConfig()->initialClimbM);
        break;

    case MSP_GPS_RESCUE_PIDS:
        sbufWriteU16(dst, autopilotConfig()->altitudeP);
        sbufWriteU16(dst, autopilotConfig()->altitudeI);
        sbufWriteU16(dst, autopilotConfig()->altitudeD);
        // altitude_F not implemented yet
        sbufWriteU16(dst, autopilotConfig()->positionP);
        sbufWriteU16(dst, autopilotConfig()->positionI);
        sbufWriteU16(dst, autopilotConfig()->positionD);
        sbufWriteU16(dst, gpsRescueConfig()->yawP);
        break;
#endif // !USE_WING
#endif
#endif

#if defined(USE_ACC)
    case MSP_ACC_TRIM:
        sbufWriteU16(dst, accelerometerConfig()->accelerometerTrims.values.pitch);
        sbufWriteU16(dst, accelerometerConfig()->accelerometerTrims.values.roll);

        break;
#endif
    case MSP_MIXER_CONFIG:
        sbufWriteU8(dst, mixerConfig()->mixerMode);
        sbufWriteU8(dst, mixerConfig()->yaw_motors_reversed);
        break;

    case MSP_RX_CONFIG:
        sbufWriteU8(dst, rxConfig()->serialrx_provider);
        sbufWriteU16(dst, rxConfig()->maxcheck);
        sbufWriteU16(dst, rxConfig()->midrc);
        sbufWriteU16(dst, rxConfig()->mincheck);
        sbufWriteU8(dst, rxConfig()->spektrum_sat_bind);
        sbufWriteU16(dst, rxConfig()->rx_min_usec);
        sbufWriteU16(dst, rxConfig()->rx_max_usec);
        sbufWriteU8(dst, 0); // not required in API 1.44, was rxConfig()->rcInterpolation
        sbufWriteU8(dst, 0); // not required in API 1.44, was rxConfig()->rcInterpolationInterval
        sbufWriteU16(dst, rxConfig()->airModeActivateThreshold * 10 + 1000);
#ifdef USE_RX_SPI
        sbufWriteU8(dst, rxSpiConfig()->rx_spi_protocol);
        sbufWriteU32(dst, rxSpiConfig()->rx_spi_id);
        sbufWriteU8(dst, rxSpiConfig()->rx_spi_rf_channel_count);
#else
        sbufWriteU8(dst, 0);
        sbufWriteU32(dst, 0);
        sbufWriteU8(dst, 0);
#endif
        sbufWriteU8(dst, rxConfig()->fpvCamAngleDegrees);
        sbufWriteU8(dst, 0); // not required in API 1.44, was rxConfig()->rcSmoothingChannels
#if defined(USE_RC_SMOOTHING_FILTER)
        sbufWriteU8(dst, 0); // not required in API 1.44, was rxConfig()->rc_smoothing_type
        sbufWriteU8(dst, rxConfig()->rc_smoothing_setpoint_cutoff);
        sbufWriteU8(dst, rxConfig()->rc_smoothing_throttle_cutoff); // was rc_smoothing_feedforward_cutoff
        sbufWriteU8(dst, rxConfig()->rc_smoothing_auto_factor_throttle); //, was rxConfig()->rc_smoothing_input_type
        sbufWriteU8(dst, 0); // not required in API 1.44, was rxConfig()->rc_smoothing_derivative_type
#else
        sbufWriteU8(dst, 0);
        sbufWriteU8(dst, 0);
        sbufWriteU8(dst, 0);
        sbufWriteU8(dst, 0);
        sbufWriteU8(dst, 0);
#endif
#if defined(USE_USB_CDC_HID)
        sbufWriteU8(dst, usbDevConfig()->type);
#else
        sbufWriteU8(dst, 0);
#endif
        // Added in MSP API 1.42
#if defined(USE_RC_SMOOTHING_FILTER)
        sbufWriteU8(dst, rxConfig()->rc_smoothing_auto_factor_rpy);
#else
        sbufWriteU8(dst, 0);
#endif
        // Added in MSP API 1.44
#if defined(USE_RC_SMOOTHING_FILTER)
        sbufWriteU8(dst, rxConfig()->rc_smoothing);
#else
        sbufWriteU8(dst, 0);
#endif

        // Added in MSP API 1.45
#ifdef USE_RX_EXPRESSLRS
        sbufWriteData(dst, rxExpressLrsSpiConfig()->UID, sizeof(rxExpressLrsSpiConfig()->UID));
#else
        uint8_t emptyUid[6];
        memset(emptyUid, 0, sizeof(emptyUid));
        sbufWriteData(dst, &emptyUid, sizeof(emptyUid));
#endif
        // Added in MSP API 1.47
#ifdef USE_RX_EXPRESSLRS
        sbufWriteU8(dst, rxExpressLrsSpiConfig()->modelId);
#else
        sbufWriteU8(dst, 0);
#endif
        break;
    case MSP_FAILSAFE_CONFIG:
        sbufWriteU8(dst, failsafeConfig()->failsafe_delay);
        sbufWriteU8(dst, failsafeConfig()->failsafe_landing_time);
        sbufWriteU16(dst, failsafeConfig()->failsafe_throttle);
        sbufWriteU8(dst, failsafeConfig()->failsafe_switch_mode);
        sbufWriteU16(dst, failsafeConfig()->failsafe_throttle_low_delay);
        sbufWriteU8(dst, failsafeConfig()->failsafe_procedure);
        break;

    case MSP_RXFAIL_CONFIG:
        for (int i = 0; i < rxRuntimeState.channelCount; i++) {
            sbufWriteU8(dst, rxFailsafeChannelConfigs(i)->mode);
            sbufWriteU16(dst, RXFAIL_STEP_TO_CHANNEL_VALUE(rxFailsafeChannelConfigs(i)->step));
        }
        break;

    case MSP_RSSI_CONFIG:
        sbufWriteU8(dst, rxConfig()->rssi_channel);
        break;

    case MSP_RX_MAP:
        sbufWriteData(dst, rxConfig()->rcmap, RX_MAPPABLE_CHANNEL_COUNT);
        break;

    case MSP_CF_SERIAL_CONFIG:
        for (int i = 0; i < SERIAL_PORT_COUNT; i++) {
            if (!serialIsPortAvailable(serialConfig()->portConfigs[i].identifier)) {
                continue;
            };
            sbufWriteU8(dst, serialConfig()->portConfigs[i].identifier);
            sbufWriteU16(dst, serialConfig()->portConfigs[i].functionMask);
            sbufWriteU8(dst, serialConfig()->portConfigs[i].msp_baudrateIndex);
            sbufWriteU8(dst, serialConfig()->portConfigs[i].gps_baudrateIndex);
            sbufWriteU8(dst, serialConfig()->portConfigs[i].telemetry_baudrateIndex);
            sbufWriteU8(dst, serialConfig()->portConfigs[i].blackbox_baudrateIndex);
        }
        break;

    case MSP2_COMMON_SERIAL_CONFIG: {
        uint8_t count = 0;
        for (int i = 0; i < SERIAL_PORT_COUNT; i++) {
            if (serialIsPortAvailable(serialConfig()->portConfigs[i].identifier)) {
                count++;
            }
        }
        sbufWriteU8(dst, count);
        for (int i = 0; i < SERIAL_PORT_COUNT; i++) {
            if (!serialIsPortAvailable(serialConfig()->portConfigs[i].identifier)) {
                continue;
            };
            sbufWriteU8(dst, serialConfig()->portConfigs[i].identifier);
            sbufWriteU32(dst, serialConfig()->portConfigs[i].functionMask);
            sbufWriteU8(dst, serialConfig()->portConfigs[i].msp_baudrateIndex);
            sbufWriteU8(dst, serialConfig()->portConfigs[i].gps_baudrateIndex);
            sbufWriteU8(dst, serialConfig()->portConfigs[i].telemetry_baudrateIndex);
            sbufWriteU8(dst, serialConfig()->portConfigs[i].blackbox_baudrateIndex);
        }
        break;
    }

#ifdef USE_LED_STRIP_STATUS_MODE
    case MSP_LED_COLORS:
        for (int i = 0; i < LED_CONFIGURABLE_COLOR_COUNT; i++) {
            const hsvColor_t *color = &ledStripStatusModeConfig()->colors[i];
            sbufWriteU16(dst, color->h);
            sbufWriteU8(dst, color->s);
            sbufWriteU8(dst, color->v);
        }
        break;
#endif

#ifdef USE_LED_STRIP
    case MSP_LED_STRIP_CONFIG:
        for (int i = 0; i < LED_STRIP_MAX_LENGTH; i++) {
#ifdef USE_LED_STRIP_STATUS_MODE
            const ledConfig_t *ledConfig = &ledStripStatusModeConfig()->ledConfigs[i];
            sbufWriteU32(dst, *ledConfig);
#else
            sbufWriteU32(dst, 0);
#endif
        }

        // API 1.41 - add indicator for advanced profile support and the current profile selection
        // 0 = basic ledstrip available
        // 1 = advanced ledstrip available
#ifdef USE_LED_STRIP_STATUS_MODE
        sbufWriteU8(dst, 1);   // advanced ledstrip available
#else
        sbufWriteU8(dst, 0);   // only simple ledstrip available
#endif
        sbufWriteU8(dst, ledStripConfig()->ledstrip_profile);
        break;
#endif

#ifdef USE_LED_STRIP_STATUS_MODE
    case MSP_LED_STRIP_MODECOLOR:
        for (int i = 0; i < LED_MODE_COUNT; i++) {
            for (int j = 0; j < LED_DIRECTION_COUNT; j++) {
                sbufWriteU8(dst, i);
                sbufWriteU8(dst, j);
                sbufWriteU8(dst, ledStripStatusModeConfig()->modeColors[i].color[j]);
            }
        }

        for (int j = 0; j < LED_SPECIAL_COLOR_COUNT; j++) {
            sbufWriteU8(dst, LED_MODE_COUNT);
            sbufWriteU8(dst, j);
            sbufWriteU8(dst, ledStripStatusModeConfig()->specialColors.color[j]);
        }

        sbufWriteU8(dst, LED_AUX_CHANNEL);
        sbufWriteU8(dst, 0);
        sbufWriteU8(dst, ledStripStatusModeConfig()->ledstrip_aux_channel);
        break;
#endif

    case MSP_DATAFLASH_SUMMARY:
        serializeDataflashSummaryReply(dst);
        break;

    case MSP_BLACKBOX_CONFIG:
#ifdef USE_BLACKBOX
        sbufWriteU8(dst, 1); //Blackbox supported
        sbufWriteU8(dst, blackboxConfig()->device);
        sbufWriteU8(dst, 1); // Rate numerator, not used anymore
        sbufWriteU8(dst, blackboxGetRateDenom());
        sbufWriteU16(dst, blackboxGetPRatio());
        sbufWriteU8(dst, blackboxConfig()->sample_rate);
        // Added in MSP API 1.45
        sbufWriteU32(dst, blackboxConfig()->fields_disabled_mask);
#else
        sbufWriteU8(dst, 0); // Blackbox not supported
        sbufWriteU8(dst, 0);
        sbufWriteU8(dst, 0);
        sbufWriteU8(dst, 0);
        sbufWriteU16(dst, 0);
        sbufWriteU8(dst, 0);
        // Added in MSP API 1.45
        sbufWriteU32(dst, 0);
#endif
        break;

    case MSP_SDCARD_SUMMARY:
        serializeSDCardSummaryReply(dst);
        break;

    case MSP_MOTOR_3D_CONFIG:
        sbufWriteU16(dst, flight3DConfig()->deadband3d_low);
        sbufWriteU16(dst, flight3DConfig()->deadband3d_high);
        sbufWriteU16(dst, flight3DConfig()->neutral3d);
        break;

    case MSP_RC_DEADBAND:
        sbufWriteU8(dst, rcControlsConfig()->deadband);
        sbufWriteU8(dst, rcControlsConfig()->yaw_deadband);
#if defined(USE_POSITION_HOLD) && !defined(USE_WING)
        sbufWriteU8(dst, posHoldConfig()->deadband);
#else
        sbufWriteU8(dst, 0);
#endif
        sbufWriteU16(dst, flight3DConfig()->deadband3d_throttle);
        break;

    case MSP_SENSOR_ALIGNMENT: {
        uint8_t gyroAlignment = gyroDeviceConfig(firstEnabledGyro())->alignment;
        sbufWriteU8(dst, gyroAlignment);
        sbufWriteU8(dst, gyroAlignment);  // Starting with 4.0 gyro and acc alignment are the same
#if defined(USE_MAG)
        sbufWriteU8(dst, compassConfig()->mag_alignment);
#else
        sbufWriteU8(dst, 0);
#endif

        // API 1.41 - Add multi-gyro indicator, selected gyro, and support for separate gyro 1 & 2 alignment
        sbufWriteU8(dst, getGyroDetectedFlags());
        sbufWriteU8(dst, gyroConfig()->gyro_enabled_bitmask); // deprecates gyro_to_use

#ifdef USE_MAG
        sbufWriteU16(dst, compassConfig()->mag_customAlignment.roll);
        sbufWriteU16(dst, compassConfig()->mag_customAlignment.pitch);
        sbufWriteU16(dst, compassConfig()->mag_customAlignment.yaw);
#else
        sbufWriteU16(dst, 0);
        sbufWriteU16(dst, 0);
        sbufWriteU16(dst, 0);
#endif
        break;
    }

    case MSP_ADVANCED_CONFIG:
        sbufWriteU8(dst, 1);  // was gyroConfig()->gyro_sync_denom - removed in API 1.43
        sbufWriteU8(dst, pidConfig()->pid_process_denom);
        sbufWriteU8(dst, motorConfig()->dev.useContinuousUpdate);
        sbufWriteU8(dst, motorConfig()->dev.motorProtocol);
        sbufWriteU16(dst, motorConfig()->dev.motorPwmRate);
        sbufWriteU16(dst, motorConfig()->motorIdle);
        sbufWriteU8(dst, 0); // DEPRECATED: gyro_use_32kHz
        sbufWriteU8(dst, motorConfig()->dev.motorInversion);
        sbufWriteU8(dst, 0); // deprecated gyro_to_use
        sbufWriteU8(dst, gyroConfig()->gyro_high_fsr);
        sbufWriteU8(dst, gyroConfig()->gyroMovementCalibrationThreshold);
        sbufWriteU16(dst, gyroConfig()->gyroCalibrationDuration);
        sbufWriteU16(dst, gyroConfig()->gyro_offset_yaw);
        sbufWriteU8(dst, gyroConfig()->checkOverflow);
        //Added in MSP API 1.42
        sbufWriteU8(dst, systemConfig()->debug_mode);
        sbufWriteU8(dst, DEBUG_COUNT);
        break;

    case MSP_FILTER_CONFIG:
        sbufWriteU8(dst, gyroConfig()->gyro_lpf1_static_hz);
        sbufWriteU16(dst, currentPidProfile->dterm_lpf1_static_hz);
        sbufWriteU16(dst, currentPidProfile->yaw_lowpass_hz);
        sbufWriteU16(dst, gyroConfig()->gyro_soft_notch_hz_1);
        sbufWriteU16(dst, gyroConfig()->gyro_soft_notch_cutoff_1);
        sbufWriteU16(dst, currentPidProfile->dterm_notch_hz);
        sbufWriteU16(dst, currentPidProfile->dterm_notch_cutoff);
        sbufWriteU16(dst, gyroConfig()->gyro_soft_notch_hz_2);
        sbufWriteU16(dst, gyroConfig()->gyro_soft_notch_cutoff_2);
        sbufWriteU8(dst, currentPidProfile->dterm_lpf1_type);
        sbufWriteU8(dst, gyroConfig()->gyro_hardware_lpf);
        sbufWriteU8(dst, 0); // DEPRECATED: gyro_32khz_hardware_lpf
        sbufWriteU16(dst, gyroConfig()->gyro_lpf1_static_hz);
        sbufWriteU16(dst, gyroConfig()->gyro_lpf2_static_hz);
        sbufWriteU8(dst, gyroConfig()->gyro_lpf1_type);
        sbufWriteU8(dst, gyroConfig()->gyro_lpf2_type);
        sbufWriteU16(dst, currentPidProfile->dterm_lpf2_static_hz);
        // Added in MSP API 1.41
        sbufWriteU8(dst, currentPidProfile->dterm_lpf2_type);
#if defined(USE_DYN_LPF)
        sbufWriteU16(dst, gyroConfig()->gyro_lpf1_dyn_min_hz);
        sbufWriteU16(dst, gyroConfig()->gyro_lpf1_dyn_max_hz);
        sbufWriteU16(dst, currentPidProfile->dterm_lpf1_dyn_min_hz);
        sbufWriteU16(dst, currentPidProfile->dterm_lpf1_dyn_max_hz);
#else
        sbufWriteU16(dst, 0);
        sbufWriteU16(dst, 0);
        sbufWriteU16(dst, 0);
        sbufWriteU16(dst, 0);
#endif
        // Added in MSP API 1.42
#if defined(USE_DYN_NOTCH_FILTER)
        sbufWriteU8(dst, 0);  // DEPRECATED 1.43: dyn_notch_range
        sbufWriteU8(dst, 0);  // DEPRECATED 1.44: dyn_notch_width_percent
        sbufWriteU16(dst, dynNotchConfig()->dyn_notch_q);
        sbufWriteU16(dst, dynNotchConfig()->dyn_notch_min_hz);
#else
        sbufWriteU8(dst, 0);
        sbufWriteU8(dst, 0);
        sbufWriteU16(dst, 0);
        sbufWriteU16(dst, 0);
#endif
#if defined(USE_RPM_FILTER)
        sbufWriteU8(dst, rpmFilterConfig()->rpm_filter_harmonics);
        sbufWriteU8(dst, rpmFilterConfig()->rpm_filter_min_hz);
#else
        sbufWriteU8(dst, 0);
        sbufWriteU8(dst, 0);
#endif
#if defined(USE_DYN_NOTCH_FILTER)
        // Added in MSP API 1.43
        sbufWriteU16(dst, dynNotchConfig()->dyn_notch_max_hz);
#else
        sbufWriteU16(dst, 0);
#endif
#if defined(USE_DYN_LPF)
        // Added in MSP API 1.44
        sbufWriteU8(dst, currentPidProfile->dterm_lpf1_dyn_expo);
#else
        sbufWriteU8(dst, 0);
#endif
#if defined(USE_DYN_NOTCH_FILTER)
        sbufWriteU8(dst, dynNotchConfig()->dyn_notch_count);
#else
        sbufWriteU8(dst, 0);
#endif
        // Added in MSP API 1.48
#if defined(USE_RPM_FILTER)
        sbufWriteU16(dst, rpmFilterConfig()->rpm_filter_fade_range_hz);
        sbufWriteU16(dst, rpmFilterConfig()->rpm_filter_q);
        for (int i = 0; i < RPM_FILTER_HARMONICS_MAX; i++) {
            sbufWriteU8(dst, rpmFilterConfig()->rpm_filter_weights[i]);
        }
#else
        sbufWriteU16(dst, 0);
        sbufWriteU16(dst, 0);
        for (int i = 0; i < RPM_FILTER_HARMONICS_MAX; i++) {
            sbufWriteU8(dst, 0);
        }
#endif
        break;

    case MSP_PID_ADVANCED:
        sbufWriteU16(dst, 0);
        sbufWriteU16(dst, 0);
        sbufWriteU16(dst, 0); // was pidProfile.yaw_p_limit
        sbufWriteU8(dst, 0); // reserved
        sbufWriteU8(dst, 0); // was vbatPidCompensation
#if defined(USE_FEEDFORWARD)
        sbufWriteU8(dst, currentPidProfile->feedforward_transition);
#else
        sbufWriteU8(dst, 0);
#endif
        sbufWriteU8(dst, 0); // was low byte of currentPidProfile->dtermSetpointWeight
        sbufWriteU8(dst, 0); // reserved
        sbufWriteU8(dst, 0); // reserved
        sbufWriteU8(dst, 0); // reserved
        sbufWriteU16(dst, currentPidProfile->rateAccelLimit);
        sbufWriteU16(dst, currentPidProfile->yawRateAccelLimit);
        sbufWriteU8(dst, currentPidProfile->angle_limit);
        sbufWriteU8(dst, 0); // was pidProfile.levelSensitivity
        sbufWriteU16(dst, 0); // was currentPidProfile->itermThrottleThreshold
        sbufWriteU16(dst, currentPidProfile->anti_gravity_gain);
        sbufWriteU16(dst, 0); // was currentPidProfile->dtermSetpointWeight
        sbufWriteU8(dst, currentPidProfile->iterm_rotation);
        sbufWriteU8(dst, 0); // was currentPidProfile->smart_feedforward
#if defined(USE_ITERM_RELAX)
        sbufWriteU8(dst, currentPidProfile->iterm_relax);
        sbufWriteU8(dst, currentPidProfile->iterm_relax_type);
#else
        sbufWriteU8(dst, 0);
        sbufWriteU8(dst, 0);
#endif
        sbufWriteU8(dst, 0); // was abs_control_gain
#if defined(USE_THROTTLE_BOOST)
        sbufWriteU8(dst, currentPidProfile->throttle_boost);
#else
        sbufWriteU8(dst, 0);
#endif
#if defined(USE_ACRO_TRAINER)
        sbufWriteU8(dst, currentPidProfile->acro_trainer_angle_limit);
#else
        sbufWriteU8(dst, 0);
#endif
        sbufWriteU16(dst, currentPidProfile->pid[PID_ROLL].F);
        sbufWriteU16(dst, currentPidProfile->pid[PID_PITCH].F);
        sbufWriteU16(dst, currentPidProfile->pid[PID_YAW].F);
        sbufWriteU8(dst, 0); // was currentPidProfile->antiGravityMode
#ifdef USE_D_MAX
        sbufWriteU8(dst, currentPidProfile->d_max[PID_ROLL]);
        sbufWriteU8(dst, currentPidProfile->d_max[PID_PITCH]);
        sbufWriteU8(dst, currentPidProfile->d_max[PID_YAW]);
        sbufWriteU8(dst, currentPidProfile->d_max_gain);
        sbufWriteU8(dst, currentPidProfile->d_max_advance);
#else
        sbufWriteU8(dst, 0);
        sbufWriteU8(dst, 0);
        sbufWriteU8(dst, 0);
        sbufWriteU8(dst, 0);
        sbufWriteU8(dst, 0);
#endif
#if defined(USE_INTEGRATED_YAW_CONTROL)
        sbufWriteU8(dst, currentPidProfile->use_integrated_yaw);
        sbufWriteU8(dst, currentPidProfile->integrated_yaw_relax);
#else
        sbufWriteU8(dst, 0);
        sbufWriteU8(dst, 0);
#endif
#if defined(USE_ITERM_RELAX)
        // Added in MSP API 1.42
        sbufWriteU8(dst, currentPidProfile->iterm_relax_cutoff);
#else
        sbufWriteU8(dst, 0);
#endif
        // Added in MSP API 1.43
        sbufWriteU8(dst, currentPidProfile->motor_output_limit);
        sbufWriteU8(dst, currentPidProfile->auto_profile_cell_count);
#if defined(USE_DYN_IDLE)
        sbufWriteU8(dst, currentPidProfile->dyn_idle_min_rpm);
#else
        sbufWriteU8(dst, 0);
#endif
        // Added in MSP API 1.44
#if defined(USE_FEEDFORWARD)
        sbufWriteU8(dst, currentPidProfile->feedforward_averaging);
        sbufWriteU8(dst, currentPidProfile->feedforward_smooth_factor);
        sbufWriteU8(dst, currentPidProfile->feedforward_boost);
        sbufWriteU8(dst, currentPidProfile->feedforward_max_rate_limit);
        sbufWriteU8(dst, currentPidProfile->feedforward_jitter_factor);
#else
        sbufWriteU8(dst, 0);
        sbufWriteU8(dst, 0);
        sbufWriteU8(dst, 0);
        sbufWriteU8(dst, 0);
        sbufWriteU8(dst, 0);
#endif
#if defined(USE_BATTERY_VOLTAGE_SAG_COMPENSATION)
        sbufWriteU8(dst, currentPidProfile->vbat_sag_compensation);
#else
        sbufWriteU8(dst, 0);
#endif
#if defined(USE_THRUST_LINEARIZATION)
        sbufWriteU8(dst, currentPidProfile->thrustLinearization);
#else
        sbufWriteU8(dst, 0);
#endif
        sbufWriteU8(dst, currentPidProfile->tpa_mode);
        sbufWriteU8(dst, currentPidProfile->tpa_rate);
        sbufWriteU16(dst, currentPidProfile->tpa_breakpoint);   // was currentControlRateProfile->tpa_breakpoint
        break;

    case MSP_SENSOR_CONFIG:
        // use sensorIndex_e index: 0:GyroHardware, 1:AccHardware, 2:BaroHardware, 3:MagHardware, 4:RangefinderHardware 5:OpticalflowHardware
#if defined(USE_ACC)
        sbufWriteU8(dst, accelerometerConfig()->acc_hardware);
#else
        sbufWriteU8(dst, ACC_NONE);
#endif
#ifdef USE_BARO
        sbufWriteU8(dst, barometerConfig()->baro_hardware);
#else
        sbufWriteU8(dst, BARO_NONE);
#endif
#ifdef USE_MAG
        sbufWriteU8(dst, compassConfig()->mag_hardware);
#else
        sbufWriteU8(dst, MAG_NONE);
#endif
        // Added in MSP API 1.46
#ifdef USE_RANGEFINDER
        sbufWriteU8(dst, rangefinderConfig()->rangefinder_hardware);    // no RANGEFINDER_DEFAULT value
#else
        sbufWriteU8(dst, RANGEFINDER_NONE);
#endif

#ifdef USE_OPTICALFLOW
        sbufWriteU8(dst, opticalflowConfig()->opticalflow_hardware);
#else
        sbufWriteU8(dst, OPTICALFLOW_NONE);
#endif
        break;

    // Added in MSP API 1.46
    case MSP2_SENSOR_CONFIG_ACTIVE:

#define SENSOR_NOT_AVAILABLE 0xFF

#if defined(USE_GYRO)
        sbufWriteU8(dst, detectedSensors[SENSOR_INDEX_GYRO]);
#else
        sbufWriteU8(dst, SENSOR_NOT_AVAILABLE);
#endif
#if defined(USE_ACC)
        sbufWriteU8(dst, detectedSensors[SENSOR_INDEX_ACC]);
#else
        sbufWriteU8(dst, SENSOR_NOT_AVAILABLE);
#endif
#ifdef USE_BARO
        sbufWriteU8(dst, detectedSensors[SENSOR_INDEX_BARO]);
#else
        sbufWriteU8(dst, SENSOR_NOT_AVAILABLE);
#endif
#ifdef USE_MAG
        sbufWriteU8(dst, detectedSensors[SENSOR_INDEX_MAG]);
#else
        sbufWriteU8(dst, SENSOR_NOT_AVAILABLE);
#endif
#ifdef USE_RANGEFINDER
        sbufWriteU8(dst, detectedSensors[SENSOR_INDEX_RANGEFINDER]);
#else
        sbufWriteU8(dst, SENSOR_NOT_AVAILABLE);
#endif
#ifdef USE_OPTICALFLOW
        sbufWriteU8(dst, detectedSensors[SENSOR_INDEX_OPTICALFLOW]);
#else
        sbufWriteU8(dst, SENSOR_NOT_AVAILABLE);
#endif
        break;

    case MSP2_GYRO_SENSOR_ACTIVE:
#ifdef USE_GYRO
        sbufWriteU8(dst, GYRO_COUNT);
        for (unsigned i = 0; i < GYRO_COUNT; i++) {
            sbufWriteU8(dst, detectedGyros[i]);
        }
#endif
        break;

#if defined(USE_VTX_COMMON)
    case MSP_VTX_CONFIG: {
        const vtxDevice_t *vtxDevice = vtxCommonDevice();
        unsigned vtxStatus = 0;
        vtxDevType_e vtxType = VTXDEV_UNKNOWN;
        uint8_t deviceIsReady = 0;
        if (vtxDevice) {
            vtxCommonGetStatus(vtxDevice, &vtxStatus);
            vtxType = vtxCommonGetDeviceType(vtxDevice);
            deviceIsReady = vtxCommonDeviceIsReady(vtxDevice) ? 1 : 0;
        }
        sbufWriteU8(dst, vtxType);
        sbufWriteU8(dst, vtxSettingsConfig()->band);
        sbufWriteU8(dst, vtxSettingsConfig()->channel);
        sbufWriteU8(dst, vtxSettingsConfig()->power);
        sbufWriteU8(dst, (vtxStatus & VTX_STATUS_PIT_MODE) ? 1 : 0);
        sbufWriteU16(dst, vtxSettingsConfig()->freq);
        sbufWriteU8(dst, deviceIsReady);
        sbufWriteU8(dst, vtxSettingsConfig()->lowPowerDisarm);

        // API version 1.42
        sbufWriteU16(dst, vtxSettingsConfig()->pitModeFreq);
#ifdef USE_VTX_TABLE
        sbufWriteU8(dst, 1);   // vtxtable is available
        sbufWriteU8(dst, vtxTableConfig()->bands);
        sbufWriteU8(dst, vtxTableConfig()->channels);
        sbufWriteU8(dst, vtxTableConfig()->powerLevels);
#else
        sbufWriteU8(dst, 0);
        sbufWriteU8(dst, 0);
        sbufWriteU8(dst, 0);
        sbufWriteU8(dst, 0);
#endif
#ifdef USE_VTX_MSP
        setMspVtxDeviceStatusReady(srcDesc);
#endif
        break;
    }
#endif

    case MSP_TX_INFO:
        sbufWriteU8(dst, rssiSource);
        uint8_t rtcDateTimeIsSet = 0;
#ifdef USE_RTC_TIME
        dateTime_t dt;
        if (rtcGetDateTime(&dt)) {
            rtcDateTimeIsSet = 1;
        }
#else
        rtcDateTimeIsSet = RTC_NOT_SUPPORTED;
#endif
        sbufWriteU8(dst, rtcDateTimeIsSet);
        break;

#ifdef USE_RTC_TIME
    case MSP_RTC: {
        dateTime_t dt;
        if (rtcGetDateTime(&dt)) {
            sbufWriteU16(dst, dt.year);
            sbufWriteU8(dst, dt.month);
            sbufWriteU8(dst, dt.day);
            sbufWriteU8(dst, dt.hours);
            sbufWriteU8(dst, dt.minutes);
            sbufWriteU8(dst, dt.seconds);
            sbufWriteU16(dst, dt.millis);
        }
        break;
    }
#endif

    default:
        unsupportedCommand = true;
    }
    return !unsupportedCommand;
}

#ifdef USE_SIMPLIFIED_TUNING
// Reads simplified PID tuning values from MSP buffer
static void readSimplifiedPids(pidProfile_t* pidProfile, sbuf_t *src)
{
    pidProfile->simplified_pids_mode = sbufReadU8(src);
    pidProfile->simplified_master_multiplier = sbufReadU8(src);
    pidProfile->simplified_roll_pitch_ratio = sbufReadU8(src);
    pidProfile->simplified_i_gain = sbufReadU8(src);
    pidProfile->simplified_d_gain = sbufReadU8(src);
    pidProfile->simplified_pi_gain = sbufReadU8(src);
#ifdef USE_D_MAX
    pidProfile->simplified_d_max_gain = sbufReadU8(src);
#else
    sbufReadU8(src);
#endif
    pidProfile->simplified_feedforward_gain = sbufReadU8(src);
    pidProfile->simplified_pitch_pi_gain = sbufReadU8(src);
    sbufReadU32(src); // reserved for future use
    sbufReadU32(src); // reserved for future use
}

// Writes simplified PID tuning values to MSP buffer
static void writeSimplifiedPids(const pidProfile_t *pidProfile, sbuf_t *dst)
{
    sbufWriteU8(dst, pidProfile->simplified_pids_mode);
    sbufWriteU8(dst, pidProfile->simplified_master_multiplier);
    sbufWriteU8(dst, pidProfile->simplified_roll_pitch_ratio);
    sbufWriteU8(dst, pidProfile->simplified_i_gain);
    sbufWriteU8(dst, pidProfile->simplified_d_gain);
    sbufWriteU8(dst, pidProfile->simplified_pi_gain);
#ifdef USE_D_MAX
    sbufWriteU8(dst, pidProfile->simplified_d_max_gain);
#else
    sbufWriteU8(dst, 0);
#endif
    sbufWriteU8(dst, pidProfile->simplified_feedforward_gain);
    sbufWriteU8(dst, pidProfile->simplified_pitch_pi_gain);
    sbufWriteU32(dst, 0); // reserved for future use
    sbufWriteU32(dst, 0); // reserved for future use
}

// Reads simplified Dterm Filter values from MSP buffer
static void readSimplifiedDtermFilters(pidProfile_t* pidProfile, sbuf_t *src)
{
    pidProfile->simplified_dterm_filter = sbufReadU8(src);
    pidProfile->simplified_dterm_filter_multiplier = sbufReadU8(src);
    pidProfile->dterm_lpf1_static_hz = sbufReadU16(src);
    pidProfile->dterm_lpf2_static_hz = sbufReadU16(src);
#if defined(USE_DYN_LPF)
    pidProfile->dterm_lpf1_dyn_min_hz = sbufReadU16(src);
    pidProfile->dterm_lpf1_dyn_max_hz = sbufReadU16(src);
#else
    sbufReadU16(src);
    sbufReadU16(src);
#endif
    sbufReadU32(src); // reserved for future use
    sbufReadU32(src); // reserved for future use
}

// Writes simplified Dterm Filter values into MSP buffer
static void writeSimplifiedDtermFilters(const pidProfile_t* pidProfile, sbuf_t *dst)
{
    sbufWriteU8(dst, pidProfile->simplified_dterm_filter);
    sbufWriteU8(dst, pidProfile->simplified_dterm_filter_multiplier);
    sbufWriteU16(dst, pidProfile->dterm_lpf1_static_hz);
    sbufWriteU16(dst, pidProfile->dterm_lpf2_static_hz);
#if defined(USE_DYN_LPF)
    sbufWriteU16(dst, pidProfile->dterm_lpf1_dyn_min_hz);
    sbufWriteU16(dst, pidProfile->dterm_lpf1_dyn_max_hz);
#else
    sbufWriteU16(dst, 0);
    sbufWriteU16(dst, 0);
#endif
    sbufWriteU32(dst, 0); // reserved for future use
    sbufWriteU32(dst, 0); // reserved for future use
}

// Writes simplified Gyro Filter values from MSP buffer
static void readSimplifiedGyroFilters(gyroConfig_t *gyroConfig, sbuf_t *src)
{
    gyroConfig->simplified_gyro_filter = sbufReadU8(src);
    gyroConfig->simplified_gyro_filter_multiplier = sbufReadU8(src);
    gyroConfig->gyro_lpf1_static_hz = sbufReadU16(src);
    gyroConfig->gyro_lpf2_static_hz = sbufReadU16(src);
#if defined(USE_DYN_LPF)
    gyroConfig->gyro_lpf1_dyn_min_hz = sbufReadU16(src);
    gyroConfig->gyro_lpf1_dyn_max_hz = sbufReadU16(src);
#else
    sbufReadU16(src);
    sbufReadU16(src);
#endif
    sbufReadU32(src); // reserved for future use
    sbufReadU32(src); // reserved for future use
}

// Writes simplified Gyro Filter values into MSP buffer
static void writeSimplifiedGyroFilters(const gyroConfig_t *gyroConfig, sbuf_t *dst)
{
    sbufWriteU8(dst, gyroConfig->simplified_gyro_filter);
    sbufWriteU8(dst, gyroConfig->simplified_gyro_filter_multiplier);
    sbufWriteU16(dst, gyroConfig->gyro_lpf1_static_hz);
    sbufWriteU16(dst, gyroConfig->gyro_lpf2_static_hz);
#if defined(USE_DYN_LPF)
    sbufWriteU16(dst, gyroConfig->gyro_lpf1_dyn_min_hz);
    sbufWriteU16(dst, gyroConfig->gyro_lpf1_dyn_max_hz);
#else
    sbufWriteU16(dst, 0);
    sbufWriteU16(dst, 0);
#endif
    sbufWriteU32(dst, 0); // reserved for future use
    sbufWriteU32(dst, 0); // reserved for future use
}

// writes results of simplified PID tuning values to MSP buffer
static void writePidfs(pidProfile_t* pidProfile, sbuf_t *dst)
{
    for (int i = 0; i < XYZ_AXIS_COUNT; i++) {
        sbufWriteU8(dst, pidProfile->pid[i].P);
        sbufWriteU8(dst, pidProfile->pid[i].I);
        sbufWriteU8(dst, pidProfile->pid[i].D);
        sbufWriteU8(dst, pidProfile->d_max[i]);
        sbufWriteU16(dst, pidProfile->pid[i].F);
    }
}
#endif // USE_SIMPLIFIED_TUNING

static mspResult_e mspFcProcessOutCommand(mspDescriptor_t srcDesc, int16_t cmdMSP, mspPacket_t *reply, mspPostProcessFnPtr *mspPostProcessFn);

static mspResult_e mspFcProcessOutCommandWithArg(mspDescriptor_t srcDesc, int16_t cmdMSP, sbuf_t *src, sbuf_t *dst, mspPostProcessFnPtr *mspPostProcessFn)
{

    switch (cmdMSP) {
    case MSP_BOXNAMES:
        {
            const int page = sbufBytesRemaining(src) ? sbufReadU8(src) : 0;
            serializeBoxReply(dst, page, &serializeBoxNameFn);
        }
        break;
    case MSP_BOXIDS:
        {
            const int page = sbufBytesRemaining(src) ? sbufReadU8(src) : 0;
            serializeBoxReply(dst, page, &serializeBoxPermanentIdFn);
        }
        break;
    case MSP_REBOOT:
        if (sbufBytesRemaining(src)) {
            rebootMode = sbufReadU8(src);

            if (rebootMode >= MSP_REBOOT_COUNT
#if !defined(USE_USB_MSC)
                || rebootMode == MSP_REBOOT_MSC || rebootMode == MSP_REBOOT_MSC_UTC
#endif
                ) {
                return MSP_RESULT_ERROR;
            }
        } else {
            rebootMode = MSP_REBOOT_FIRMWARE;
        }

        sbufWriteU8(dst, rebootMode);

#if defined(USE_USB_MSC)
        if (rebootMode == MSP_REBOOT_MSC) {
            if (mscCheckFilesystemReady()) {
                sbufWriteU8(dst, 1);
            } else {
                sbufWriteU8(dst, 0);

                return MSP_RESULT_ACK;
            }
        }
#endif

#if defined(USE_MSP_OVER_TELEMETRY)
        if (featureIsEnabled(FEATURE_RX_SPI) && srcDesc == getMspTelemetryDescriptor()) {
            dispatchAdd(&mspRebootEntry, MSP_DISPATCH_DELAY_US);
        } else
#endif
        if (mspPostProcessFn) {
            *mspPostProcessFn = mspRebootFn;
        }

        break;
    case MSP_MULTIPLE_MSP:
        {
            uint8_t maxMSPs = 0;
            if (sbufBytesRemaining(src) == 0) {
                return MSP_RESULT_ERROR;
            }
            int bytesRemaining = sbufBytesRemaining(dst);
            mspPacket_t packetOut;
            uint8_t* initialInputPtr = src->ptr;
            while (sbufBytesRemaining(src) && bytesRemaining > 0) {
                uint8_t newMSP = sbufReadU8(src);
                sbufInit(&packetOut.buf, dst->ptr + 1, dst->end); // reserve 1 byte for length
                if (mspFcProcessOutCommand(srcDesc, newMSP, &packetOut, NULL) != MSP_RESULT_ACK) {
                    return MSP_RESULT_ERROR;
                }
                uint8_t mspSize = sbufPtr(&packetOut.buf) - dst->ptr; // length included
                bytesRemaining -= mspSize;
                if (bytesRemaining >= 0) {
                    maxMSPs++;
                }
            }
            src->ptr = initialInputPtr;
            sbufInit(&packetOut.buf, dst->ptr, dst->end);
            for (int i = 0; i < maxMSPs; i++) {
                uint8_t* sizePtr = sbufPtr(&packetOut.buf);
                sbufWriteU8(&packetOut.buf, 0); // placeholder for reply size
                uint8_t newMSP = sbufReadU8(src);
                // No need to check again
                mspFcProcessOutCommand(srcDesc, newMSP, &packetOut, NULL);
                *sizePtr = sbufPtr(&packetOut.buf) - (sizePtr + 1);
            }
            dst->ptr = packetOut.buf.ptr;
        }
        break;

#ifdef USE_VTX_TABLE
    case MSP_VTXTABLE_BAND:
        {
            const uint8_t band = sbufBytesRemaining(src) ? sbufReadU8(src) : 0;
            if (band > 0 && band <= VTX_TABLE_MAX_BANDS) {
                sbufWriteU8(dst, band);  // band number (same as request)
                sbufWriteU8(dst, VTX_TABLE_BAND_NAME_LENGTH); // band name length
                for (int i = 0; i < VTX_TABLE_BAND_NAME_LENGTH; i++) { // band name bytes
                    sbufWriteU8(dst, vtxTableConfig()->bandNames[band - 1][i]);
                }
                sbufWriteU8(dst, vtxTableConfig()->bandLetters[band - 1]); // band letter
                sbufWriteU8(dst, vtxTableConfig()->isFactoryBand[band - 1]); // CUSTOM = 0; FACTORY = 1
                sbufWriteU8(dst, vtxTableConfig()->channels); // number of channel frequencies to follow
                for (int i = 0; i < vtxTableConfig()->channels; i++) { // the frequency for each channel
                    sbufWriteU16(dst, vtxTableConfig()->frequency[band - 1][i]);
                }
            } else {
                return MSP_RESULT_ERROR;
            }
#ifdef USE_VTX_MSP
            setMspVtxDeviceStatusReady(srcDesc);
#endif
        }
        break;

    case MSP_VTXTABLE_POWERLEVEL:
        {
            const uint8_t powerLevel = sbufBytesRemaining(src) ? sbufReadU8(src) : 0;
            if (powerLevel > 0 && powerLevel <= VTX_TABLE_MAX_POWER_LEVELS) {
                sbufWriteU8(dst, powerLevel);  // powerLevel number (same as request)
                sbufWriteU16(dst, vtxTableConfig()->powerValues[powerLevel - 1]);
                sbufWriteU8(dst, VTX_TABLE_POWER_LABEL_LENGTH); // powerLevel label length
                for (int i = 0; i < VTX_TABLE_POWER_LABEL_LENGTH; i++) { // powerlevel label bytes
                    sbufWriteU8(dst, vtxTableConfig()->powerLabels[powerLevel - 1][i]);
                }
            } else {
                return MSP_RESULT_ERROR;
            }
#ifdef USE_VTX_MSP
            setMspVtxDeviceStatusReady(srcDesc);
#endif
        }
        break;
#endif // USE_VTX_TABLE

#ifdef USE_SIMPLIFIED_TUNING
    // Added in MSP API 1.44
    case MSP_SIMPLIFIED_TUNING:
        {
            writeSimplifiedPids(currentPidProfile, dst);
            writeSimplifiedDtermFilters(currentPidProfile, dst);
            writeSimplifiedGyroFilters(gyroConfig(), dst);
        }
        break;

    case MSP_CALCULATE_SIMPLIFIED_PID:
        {
            pidProfile_t tempPidProfile = *currentPidProfile;
            readSimplifiedPids(&tempPidProfile, src);
            applySimplifiedTuningPids(&tempPidProfile);
            writePidfs(&tempPidProfile, dst);
        }
        break;

    case MSP_CALCULATE_SIMPLIFIED_DTERM:
        {
            pidProfile_t tempPidProfile = *currentPidProfile;
            readSimplifiedDtermFilters(&tempPidProfile, src);
            applySimplifiedTuningDtermFilters(&tempPidProfile);
            writeSimplifiedDtermFilters(&tempPidProfile, dst);
        }
        break;

    case MSP_CALCULATE_SIMPLIFIED_GYRO:
        {
            gyroConfig_t tempGyroConfig = *gyroConfig();
            readSimplifiedGyroFilters(&tempGyroConfig, src);
            applySimplifiedTuningGyroFilters(&tempGyroConfig);
            writeSimplifiedGyroFilters(&tempGyroConfig, dst);
        }
        break;

    case MSP_VALIDATE_SIMPLIFIED_TUNING:
        {
            pidProfile_t tempPidProfile = *currentPidProfile;
            applySimplifiedTuningPids(&tempPidProfile);
            bool result = true;

            for (int i = 0; i < XYZ_AXIS_COUNT; i++) {
                result = result &&
                    tempPidProfile.pid[i].P == currentPidProfile->pid[i].P &&
                    tempPidProfile.pid[i].I == currentPidProfile->pid[i].I &&
                    tempPidProfile.pid[i].D == currentPidProfile->pid[i].D &&
                    tempPidProfile.d_max[i] == currentPidProfile->d_max[i] &&
                    tempPidProfile.pid[i].F == currentPidProfile->pid[i].F;
            }

            sbufWriteU8(dst, result);

            gyroConfig_t tempGyroConfig = *gyroConfig();
            applySimplifiedTuningGyroFilters(&tempGyroConfig);
            result =
                tempGyroConfig.gyro_lpf1_static_hz == gyroConfig()->gyro_lpf1_static_hz &&
                tempGyroConfig.gyro_lpf2_static_hz == gyroConfig()->gyro_lpf2_static_hz;

#if defined(USE_DYN_LPF)
            result = result &&
                tempGyroConfig.gyro_lpf1_dyn_min_hz == gyroConfig()->gyro_lpf1_dyn_min_hz &&
                tempGyroConfig.gyro_lpf1_dyn_max_hz == gyroConfig()->gyro_lpf1_dyn_max_hz;
#endif

            sbufWriteU8(dst, result);

            applySimplifiedTuningDtermFilters(&tempPidProfile);
            result =
                tempPidProfile.dterm_lpf1_static_hz == currentPidProfile->dterm_lpf1_static_hz &&
                tempPidProfile.dterm_lpf2_static_hz == currentPidProfile->dterm_lpf2_static_hz;

#if defined(USE_DYN_LPF)
            result = result &&
                tempPidProfile.dterm_lpf1_dyn_min_hz == currentPidProfile->dterm_lpf1_dyn_min_hz &&
                tempPidProfile.dterm_lpf1_dyn_max_hz == currentPidProfile->dterm_lpf1_dyn_max_hz;
#endif

            sbufWriteU8(dst, result);
        }
        break;
#endif

    case MSP_RESET_CONF:
        {
            if (sbufBytesRemaining(src) >= 1) {
                // Added in MSP API 1.42
                sbufReadU8(src);
            }

            bool success = false;
            if (!ARMING_FLAG(ARMED)) {
                success = resetEEPROM();

                if (success && mspPostProcessFn) {
                    rebootMode = MSP_REBOOT_FIRMWARE;
                    *mspPostProcessFn = mspRebootFn;
                }
            }

            // Added in API version 1.42
            sbufWriteU8(dst, success);
        }

        break;

    case MSP2_GET_TEXT:
        {
            // type byte, then length byte followed by the actual characters
            const uint8_t textType = sbufBytesRemaining(src) ? sbufReadU8(src) : 0;

            const char *textVar;

            switch (textType) {
                case MSP2TEXT_PILOT_NAME:
                    textVar = pilotConfigMutable()->pilotName;
                    break;

                case MSP2TEXT_CRAFT_NAME:
                    textVar = pilotConfigMutable()->craftName;
                    break;

                case MSP2TEXT_PID_PROFILE_NAME:
                    textVar = currentPidProfile->profileName;
                    break;

                case MSP2TEXT_RATE_PROFILE_NAME:
                    textVar = currentControlRateProfile->profileName;
                    break;

                case MSP2TEXT_BUILDKEY:
                    textVar = buildKey;
                    break;

                case MSP2TEXT_RELEASENAME:
                    textVar = releaseName;
                    break;

                case MSP2TEXT_BATTERY_PROFILE_NAME:
                    textVar = currentBatteryProfile->profileName;
                    break;

                default:
                    return MSP_RESULT_ERROR;
            }

            if (!textVar) return MSP_RESULT_ERROR;

            //  type byte, then length byte followed by the actual characters
            sbufWriteU8(dst, textType);
            sbufWritePString(dst, textVar);
        }
        break;
#ifdef USE_LED_STRIP
    case MSP2_GET_LED_STRIP_CONFIG_VALUES:
        sbufWriteU8(dst, ledStripConfig()->ledstrip_brightness);
        sbufWriteU16(dst, ledStripConfig()->ledstrip_rainbow_delta);
        sbufWriteU16(dst, ledStripConfig()->ledstrip_rainbow_freq);
        break;
#endif

    case MSP2_BATTERY_PROFILE: {
        const uint8_t profileIndex = sbufBytesRemaining(src) ? sbufReadU8(src) : systemConfig()->activeBatteryProfile;
        if (profileIndex >= BATTERY_PROFILE_COUNT) {
            return MSP_RESULT_ERROR;
        }
        const batteryProfile_t *profile = batteryProfiles(profileIndex);
        sbufWriteU8(dst, profileIndex);
        sbufWriteU16(dst, profile->vbatmincellvoltage);
        sbufWriteU16(dst, profile->vbatmaxcellvoltage);
        sbufWriteU16(dst, profile->vbatwarningcellvoltage);
        sbufWriteU16(dst, profile->vbatfullcellvoltage);
        sbufWriteU16(dst, profile->batteryCapacity);
        sbufWriteU8(dst, profile->forceBatteryCellCount);
        sbufWriteU8(dst, profile->consumptionWarningPercentage);
        break;
    }

#ifdef USE_CLI
    case MSP2_CLI_SETTING:
        {
            _Static_assert(MSP_PORT_INBUF_SIZE < CLI_IN_BUFFER_SIZE,
                           "MSP input buffer must be smaller than CLI input buffer");
            const int len = sbufBytesRemaining(src);
            if (len == 0) {
                return MSP_RESULT_ERROR;
            }
            char cmdline[len + 1];
            sbufReadData(src, cmdline, len);
            cmdline[len] = '\0';

            char *eq = strstr(cmdline, "=");
            if (eq) {
                // set mode: "name = value"
                if (!cliSetSettingByName(cmdline)) {
                    return MSP_RESULT_ERROR;
                }
            }

            // get/response: return "name = value"
            // for set, this confirms the new value; for get, this returns the current value
            char buf[len + 1];
            // extract just the name (before '=' if present)
            if (eq) {
                // trim trailing spaces from name
                char *nameEnd = eq;
                while (nameEnd > cmdline && *(nameEnd - 1) == ' ') {
                    nameEnd--;
                }
                *nameEnd = '\0';
            }
            const int written = cliGetSettingByName(cmdline, buf, len + 1);
            if (written < 0 || written > (int)sbufBytesRemaining(dst)) {
                if (!eq) {
                    return MSP_RESULT_ERROR;
                }
                // set succeeded but echo failed; acknowledge the set
            } else {
                sbufWriteData(dst, buf, written);
            }
        }
        break;
#endif

#ifdef USE_CLI
    case MSP2_CLI_SETTING_INFO:
        {
            const int len = sbufBytesRemaining(src);
            if (len == 0 || len > 128) {
                return MSP_RESULT_ERROR;
            }

            // parse request: name\0<offset_u16>  (offset is optional, defaults to 0)
            char payload[129];
            sbufReadData(src, payload, len);
            payload[len] = '\0';

            // find null terminator within payload to separate name from offset
            const char *name = payload;
            uint16_t offset = 0;
            const void *nul = memchr(payload, '\0', len);
            int nameLen;
            if (nul) {
                nameLen = (const char *)nul - payload;
                const int afterNul = len - nameLen - 1;
                if (afterNul >= 2) {
                    offset = (uint8_t)payload[nameLen + 1] | ((uint8_t)payload[nameLen + 2] << 8);
                }
            } else {
                nameLen = len;
            }

            // reserve space for the total size header
            const int remaining = sbufBytesRemaining(dst);
            if (remaining < (int)sizeof(uint16_t)) {
                return MSP_RESULT_ERROR;
            }
            sbufWriteU16(dst, 0); // placeholder, filled below

            // write directly into the sbuf output, windowed by offset
            int totalLen = 0;
            const int written = cliGetSettingInfoByName(name, offset, (char *)sbufPtr(dst), sbufBytesRemaining(dst), &totalLen);
            if (written < 0) {
                return MSP_RESULT_ERROR;
            }

            // patch the total size header (2 bytes immediately before current position)
            uint8_t *hdr = sbufPtr(dst) - sizeof(uint16_t);
            hdr[0] = totalLen & 0xFF;
            hdr[1] = (totalLen >> 8) & 0xFF;

            sbufAdvance(dst, written);
        }
        break;
#endif

    default:
        return MSP_RESULT_CMD_UNKNOWN;
    }
    return MSP_RESULT_ACK;
}

#ifdef USE_FLASHFS
static void mspFcDataFlashReadCommand(sbuf_t *dst, sbuf_t *src)
{
    const unsigned int dataSize = sbufBytesRemaining(src);
    const uint32_t readAddress = sbufReadU32(src);
    uint16_t readLength;
    bool allowCompression = false;
    bool useLegacyFormat;
    if (dataSize >= sizeof(uint32_t) + sizeof(uint16_t)) {
        readLength = sbufReadU16(src);
        if (sbufBytesRemaining(src)) {
            allowCompression = sbufReadU8(src);
        }
        useLegacyFormat = false;
    } else {
        readLength = 128;
        useLegacyFormat = true;
    }

    serializeDataflashReadReply(dst, readAddress, readLength, useLegacyFormat, allowCompression);
}
#endif

static mspResult_e mspProcessInCommand(mspDescriptor_t srcDesc, int16_t cmdMSP, sbuf_t *src)
{
    uint32_t i;
    uint8_t value;
    const unsigned int dataSize = sbufBytesRemaining(src);
    switch (cmdMSP) {
    case MSP_SELECT_SETTING:
        value = sbufReadU8(src);
        if (value & BATTERYPROFILE_MASK) {
            value = value & ~BATTERYPROFILE_MASK;
            if (value >= BATTERY_PROFILE_COUNT) {
                value = 0;
            }
            changeBatteryProfile(value);
        } else if ((value & RATEPROFILE_MASK) == 0) {
            if (!ARMING_FLAG(ARMED)) {
                if (value >= PID_PROFILE_COUNT) {
                    value = 0;
                }
                changePidProfile(value);
            }
        } else {
            value = value & ~RATEPROFILE_MASK;

            if (value >= CONTROL_RATE_PROFILE_COUNT) {
                value = 0;
            }
            changeControlRateProfile(value);
        }
        break;

    case MSP_COPY_PROFILE:
        value = sbufReadU8(src);        // 0 = pid profile, 1 = control rate profile
        uint8_t dstProfileIndex = sbufReadU8(src);
        uint8_t srcProfileIndex = sbufReadU8(src);
        if (value == 0) {
            pidCopyProfile(dstProfileIndex, srcProfileIndex);
        }
        else if (value == 1) {
            copyControlRateProfile(dstProfileIndex, srcProfileIndex);
        }
        break;

#if defined(USE_GPS) || defined(USE_MAG)
    case MSP_SET_HEADING:
        magHold = sbufReadU16(src);
        break;
#endif

    case MSP_SET_RAW_RC:
#ifdef USE_RX_MSP
        {
            uint8_t channelCount = dataSize / sizeof(uint16_t);
            if (channelCount > MAX_SUPPORTED_RC_CHANNEL_COUNT) {
                return MSP_RESULT_ERROR;
            } else {
                uint16_t frame[MAX_SUPPORTED_RC_CHANNEL_COUNT];
                for (int i = 0; i < channelCount; i++) {
                    frame[i] = sbufReadU16(src);
                }
                rxMspFrameReceive(frame, channelCount);
            }
        }
#endif
        break;
#if defined(USE_ACC)
    case MSP_SET_ACC_TRIM:
        accelerometerConfigMutable()->accelerometerTrims.values.pitch = sbufReadU16(src);
        accelerometerConfigMutable()->accelerometerTrims.values.roll  = sbufReadU16(src);

        break;
#endif
    case MSP_SET_ARMING_CONFIG:
        armingConfigMutable()->auto_disarm_delay = sbufReadU8(src);
        sbufReadU8(src); // reserved. disarm_kill_switch was removed in #5073
        if (sbufBytesRemaining(src)) {
          imuConfigMutable()->small_angle = sbufReadU8(src);
        }
        if (sbufBytesRemaining(src)) {
            armingConfigMutable()->gyro_cal_on_first_arm = sbufReadU8(src);
        }
        break;

    case MSP_SET_PID_CONTROLLER:
        break;

    case MSP_SET_PID:
        for (int i = 0; i < PID_ITEM_COUNT; i++) {
            currentPidProfile->pid[i].P = sbufReadU8(src);
            currentPidProfile->pid[i].I = sbufReadU8(src);
            currentPidProfile->pid[i].D = sbufReadU8(src);
        }
        pidInitConfig(currentPidProfile);
        break;

    case MSP_SET_MODE_RANGE:
        i = sbufReadU8(src);
        if (i < MAX_MODE_ACTIVATION_CONDITION_COUNT) {
            modeActivationCondition_t *mac = modeActivationConditionsMutable(i);
            i = sbufReadU8(src);
            const box_t *box = findBoxByPermanentId(i);
            if (box) {
                mac->modeId = box->boxId;
                mac->auxChannelIndex = sbufReadU8(src);
                mac->range.startStep = sbufReadU8(src);
                mac->range.endStep = sbufReadU8(src);
                if (sbufBytesRemaining(src) != 0) {
                    mac->modeLogic = sbufReadU8(src);

                    i = sbufReadU8(src);
                    const box_t *linkedToBox = findBoxByPermanentId(i);
                    if (!linkedToBox) {
                        return MSP_RESULT_ERROR;
                    }
                    mac->linkedTo = linkedToBox->boxId;
                }
                rcControlsInit();
            } else {
                return MSP_RESULT_ERROR;
            }
        } else {
            return MSP_RESULT_ERROR;
        }
        break;

    case MSP_SET_ADJUSTMENT_RANGE:
        i = sbufReadU8(src);
        if (i < MAX_ADJUSTMENT_RANGE_COUNT) {
            adjustmentRange_t *adjRange = adjustmentRangesMutable(i);
            sbufReadU8(src); // was adjRange->adjustmentIndex
            adjRange->auxChannelIndex = sbufReadU8(src);
            adjRange->range.startStep = sbufReadU8(src);
            adjRange->range.endStep = sbufReadU8(src);
            adjRange->adjustmentConfig = sbufReadU8(src);
            adjRange->auxSwitchChannelIndex = sbufReadU8(src);
            if (sbufBytesRemaining(src) >= 4) {
                adjRange->adjustmentCenter = sbufReadU16(src);
                adjRange->adjustmentScale = sbufReadU16(src);
            }

            activeAdjustmentRangeReset();
        } else {
            return MSP_RESULT_ERROR;
        }
        break;

    case MSP_SET_RC_TUNING:
        if (sbufBytesRemaining(src) >= 10) {
            value = sbufReadU8(src);
            if (currentControlRateProfile->rcRates[FD_PITCH] == currentControlRateProfile->rcRates[FD_ROLL]) {
                currentControlRateProfile->rcRates[FD_PITCH] = value;
            }
            currentControlRateProfile->rcRates[FD_ROLL] = value;

            value = sbufReadU8(src);
            if (currentControlRateProfile->rcExpo[FD_PITCH] == currentControlRateProfile->rcExpo[FD_ROLL]) {
                currentControlRateProfile->rcExpo[FD_PITCH] = value;
            }
            currentControlRateProfile->rcExpo[FD_ROLL] = value;

            for (int i = 0; i < 3; i++) {
                currentControlRateProfile->rates[i] = sbufReadU8(src);
            }

            sbufReadU8(src);    // tpa_rate is moved to PID profile
            currentControlRateProfile->thrMid8 = sbufReadU8(src);
            currentControlRateProfile->thrExpo8 = sbufReadU8(src);
            sbufReadU16(src);   // tpa_breakpoint is moved to PID profile

            if (sbufBytesRemaining(src) >= 1) {
                currentControlRateProfile->rcExpo[FD_YAW] = sbufReadU8(src);
            }

            if (sbufBytesRemaining(src) >= 1) {
                currentControlRateProfile->rcRates[FD_YAW] = sbufReadU8(src);
            }

            if (sbufBytesRemaining(src) >= 1) {
                currentControlRateProfile->rcRates[FD_PITCH] = sbufReadU8(src);
            }

            if (sbufBytesRemaining(src) >= 1) {
                currentControlRateProfile->rcExpo[FD_PITCH] = sbufReadU8(src);
            }

            // version 1.41
            if (sbufBytesRemaining(src) >= 2) {
                currentControlRateProfile->throttle_limit_type = sbufReadU8(src);
                currentControlRateProfile->throttle_limit_percent = sbufReadU8(src);
            }

            // version 1.42
            if (sbufBytesRemaining(src) >= 6) {
                currentControlRateProfile->rate_limit[FD_ROLL] = sbufReadU16(src);
                currentControlRateProfile->rate_limit[FD_PITCH] = sbufReadU16(src);
                currentControlRateProfile->rate_limit[FD_YAW] = sbufReadU16(src);
            }

            // version 1.43
            if (sbufBytesRemaining(src) >= 1) {
                currentControlRateProfile->rates_type = sbufReadU8(src);
            }

            // version 1.47
            if (sbufBytesRemaining(src) >= 1) {
                currentControlRateProfile->thrHover8 = sbufReadU8(src);
            }

            initRcProcessing();
        } else {
            return MSP_RESULT_ERROR;
        }
        break;

    case MSP_SET_MOTOR_CONFIG:
        sbufReadU16(src);   // minthrottle deprecated in 4.6
        motorConfigMutable()->maxthrottle = sbufReadU16(src);
        motorConfigMutable()->mincommand = sbufReadU16(src);

        // version 1.42
        if (sbufBytesRemaining(src) >= 2) {
            motorConfigMutable()->motorPoleCount = sbufReadU8(src);
#if defined(USE_DSHOT_TELEMETRY)
            motorConfigMutable()->dev.useDshotTelemetry = sbufReadU8(src);
#else
            sbufReadU8(src);
#endif
        }
        break;

#ifdef USE_GPS
    case MSP_SET_GPS_CONFIG:
        gpsConfigMutable()->provider = sbufReadU8(src);
        gpsConfigMutable()->sbasMode = sbufReadU8(src);
        gpsConfigMutable()->autoConfig = sbufReadU8(src);
        gpsConfigMutable()->autoBaud = sbufReadU8(src);
        if (sbufBytesRemaining(src) >= 2) {
            // Added in API version 1.43
            gpsConfigMutable()->gps_set_home_point_once = sbufReadU8(src);
            gpsConfigMutable()->gps_ublox_use_galileo = sbufReadU8(src);
        }
        break;
#endif

#ifdef USE_MAG
    case MSP_SET_COMPASS_CONFIG:
        imuConfigMutable()->mag_declination = sbufReadU16(src);
        break;
#endif

#ifdef USE_GPS
#ifdef USE_GPS_RESCUE
#ifndef USE_WING
    case MSP_SET_GPS_RESCUE:
        autopilotConfigMutable()->maxAngle = sbufReadU16(src);
        gpsRescueConfigMutable()->returnAltitudeM = sbufReadU16(src);
        gpsRescueConfigMutable()->descentDistanceM = sbufReadU16(src);
        gpsRescueConfigMutable()->groundSpeedCmS = sbufReadU16(src);
        autopilotConfigMutable()->throttleMin = sbufReadU16(src);
        autopilotConfigMutable()->throttleMax = sbufReadU16(src);
        autopilotConfigMutable()->hoverThrottle = sbufReadU16(src);
        gpsRescueConfigMutable()->sanityChecks = sbufReadU8(src);
        gpsRescueConfigMutable()->minSats = sbufReadU8(src);
        if (sbufBytesRemaining(src) >= 6) {
            // Added in API version 1.43
            gpsRescueConfigMutable()->ascendRate = sbufReadU16(src);
            gpsRescueConfigMutable()->descendRate = sbufReadU16(src);
            gpsRescueConfigMutable()->allowArmingWithoutFix = sbufReadU8(src);
            gpsRescueConfigMutable()->altitudeMode = sbufReadU8(src);
        }
        if (sbufBytesRemaining(src) >= 2) {
            // Added in API version 1.44
            gpsRescueConfigMutable()->minStartDistM = sbufReadU16(src);
        }
        if (sbufBytesRemaining(src) >= 2) {
            // Added in API version 1.46
            gpsRescueConfigMutable()->initialClimbM = sbufReadU16(src);
        }
        break;

    case MSP_SET_GPS_RESCUE_PIDS:
        autopilotConfigMutable()->altitudeP = sbufReadU16(src);
        autopilotConfigMutable()->altitudeI = sbufReadU16(src);
        autopilotConfigMutable()->altitudeD = sbufReadU16(src);
        // altitude_F not included in msp yet
        autopilotConfigMutable()->positionP = sbufReadU16(src);
        autopilotConfigMutable()->positionI = sbufReadU16(src);
        autopilotConfigMutable()->positionD = sbufReadU16(src);
        gpsRescueConfigMutable()->yawP = sbufReadU16(src);
        break;
#endif // !USE_WING
#endif
#endif

    case MSP_SET_MOTOR:
        if (dataSize < getMotorCount() * sizeof(uint16_t)) {
            return MSP_RESULT_ERROR;
        }
        for (int i = 0; i < getMotorCount(); i++) {
            motor_disarmed[i] = motorConvertFromExternal(sbufReadU16(src));
        }
        break;

    case MSP_SET_SERVO_CONFIGURATION:
#ifdef USE_SERVOS
        if (dataSize != 1 + 12) {
            return MSP_RESULT_ERROR;
        }
        i = sbufReadU8(src);
        if (i >= MAX_SUPPORTED_SERVOS) {
            return MSP_RESULT_ERROR;
        } else {
            servoParamsMutable(i)->min = sbufReadU16(src);
            servoParamsMutable(i)->max = sbufReadU16(src);
            servoParamsMutable(i)->middle = sbufReadU16(src);
            servoParamsMutable(i)->rate = sbufReadU8(src);
            servoParamsMutable(i)->forwardFromChannel = sbufReadU8(src);
            servoParamsMutable(i)->reversedSources = sbufReadU32(src);
        }
#endif
        break;

    case MSP_SET_SERVO_MIX_RULE:
#ifdef USE_SERVOS
        i = sbufReadU8(src);
        if (i >= MAX_SERVO_RULES) {
            return MSP_RESULT_ERROR;
        } else {
            const uint8_t targetChannel = sbufReadU8(src);
            const uint8_t inputSource = sbufReadU8(src);
            if (targetChannel >= MAX_SUPPORTED_SERVOS || inputSource >= INPUT_SOURCE_COUNT) {
                return MSP_RESULT_ERROR;
            }
            customServoMixersMutable(i)->targetChannel = targetChannel;
            customServoMixersMutable(i)->inputSource = inputSource;
            customServoMixersMutable(i)->rate = sbufReadU8(src);
            customServoMixersMutable(i)->speed = sbufReadU8(src);
            customServoMixersMutable(i)->min = sbufReadU8(src);
            customServoMixersMutable(i)->max = sbufReadU8(src);
            customServoMixersMutable(i)->box = sbufReadU8(src);
            loadCustomServoMixer();
        }
#endif
        break;

    case MSP_SET_MOTOR_3D_CONFIG:
        flight3DConfigMutable()->deadband3d_low = sbufReadU16(src);
        flight3DConfigMutable()->deadband3d_high = sbufReadU16(src);
        flight3DConfigMutable()->neutral3d = sbufReadU16(src);
        break;

    case MSP_SET_RC_DEADBAND:
        rcControlsConfigMutable()->deadband = sbufReadU8(src);
        rcControlsConfigMutable()->yaw_deadband = sbufReadU8(src);
#if defined(USE_POSITION_HOLD) && !defined(USE_WING)
        posHoldConfigMutable()->deadband = sbufReadU8(src);
#else
        sbufReadU8(src);
#endif
        flight3DConfigMutable()->deadband3d_throttle = sbufReadU16(src);
        break;

    case MSP_SET_RESET_CURR_PID:
        resetPidProfile(currentPidProfile);
        break;

    case MSP_SET_SENSOR_ALIGNMENT: {
        sbufReadU8(src);
        sbufReadU8(src);  // discard deprecated acc_align
#if defined(USE_MAG)
        compassConfigMutable()->mag_alignment = sbufReadU8(src);
#else
        sbufReadU8(src);
#endif

        gyroConfigMutable()->gyro_enabled_bitmask = sbufReadU8(src);

        if (sbufBytesRemaining(src) >= 6) {
#ifdef USE_MAG
            compassConfigMutable()->mag_customAlignment.roll = sbufReadU16(src);
            compassConfigMutable()->mag_customAlignment.pitch = sbufReadU16(src);
            compassConfigMutable()->mag_customAlignment.yaw = sbufReadU16(src);
#else
            sbufReadU16(src);
            sbufReadU16(src);
            sbufReadU16(src);
#endif
        }

        break;
    }

    case MSP_SET_ADVANCED_CONFIG:
        sbufReadU8(src); // was gyroConfigMutable()->gyro_sync_denom - removed in API 1.43
        pidConfigMutable()->pid_process_denom = sbufReadU8(src);
        motorConfigMutable()->dev.useContinuousUpdate = sbufReadU8(src);
        motorConfigMutable()->dev.motorProtocol = sbufReadU8(src);
        motorConfigMutable()->dev.motorPwmRate = sbufReadU16(src);
        if (sbufBytesRemaining(src) >= 2) {
            motorConfigMutable()->motorIdle = sbufReadU16(src);
        }
        if (sbufBytesRemaining(src)) {
            sbufReadU8(src); // DEPRECATED: gyro_use_32khz
        }
        if (sbufBytesRemaining(src)) {
            motorConfigMutable()->dev.motorInversion = sbufReadU8(src);
        }
        if (sbufBytesRemaining(src) >= 8) {
            sbufReadU8(src); // deprecated gyro_to_use
            gyroConfigMutable()->gyro_high_fsr = sbufReadU8(src);
            gyroConfigMutable()->gyroMovementCalibrationThreshold = sbufReadU8(src);
            gyroConfigMutable()->gyroCalibrationDuration = sbufReadU16(src);
            gyroConfigMutable()->gyro_offset_yaw = sbufReadU16(src);
            gyroConfigMutable()->checkOverflow = sbufReadU8(src);
        }
        if (sbufBytesRemaining(src) >= 1) {
            //Added in MSP API 1.42
            systemConfigMutable()->debug_mode = sbufReadU8(src);
        }

        validateAndFixGyroConfig();

        break;
    case MSP_SET_FILTER_CONFIG:
        gyroConfigMutable()->gyro_lpf1_static_hz = sbufReadU8(src);
        currentPidProfile->dterm_lpf1_static_hz = sbufReadU16(src);
        currentPidProfile->yaw_lowpass_hz = sbufReadU16(src);
        if (sbufBytesRemaining(src) >= 8) {
            gyroConfigMutable()->gyro_soft_notch_hz_1 = sbufReadU16(src);
            gyroConfigMutable()->gyro_soft_notch_cutoff_1 = sbufReadU16(src);
            currentPidProfile->dterm_notch_hz = sbufReadU16(src);
            currentPidProfile->dterm_notch_cutoff = sbufReadU16(src);
        }
        if (sbufBytesRemaining(src) >= 4) {
            gyroConfigMutable()->gyro_soft_notch_hz_2 = sbufReadU16(src);
            gyroConfigMutable()->gyro_soft_notch_cutoff_2 = sbufReadU16(src);
        }
        if (sbufBytesRemaining(src) >= 1) {
            currentPidProfile->dterm_lpf1_type = sbufReadU8(src);
        }
        if (sbufBytesRemaining(src) >= 10) {
            gyroConfigMutable()->gyro_hardware_lpf = sbufReadU8(src);
            sbufReadU8(src); // DEPRECATED: gyro_32khz_hardware_lpf
            gyroConfigMutable()->gyro_lpf1_static_hz = sbufReadU16(src);
            gyroConfigMutable()->gyro_lpf2_static_hz = sbufReadU16(src);
            gyroConfigMutable()->gyro_lpf1_type = sbufReadU8(src);
            gyroConfigMutable()->gyro_lpf2_type = sbufReadU8(src);
            currentPidProfile->dterm_lpf2_static_hz = sbufReadU16(src);
        }
        if (sbufBytesRemaining(src) >= 9) {
            // Added in MSP API 1.41
            currentPidProfile->dterm_lpf2_type = sbufReadU8(src);
#if defined(USE_DYN_LPF)
            gyroConfigMutable()->gyro_lpf1_dyn_min_hz = sbufReadU16(src);
            gyroConfigMutable()->gyro_lpf1_dyn_max_hz = sbufReadU16(src);
            currentPidProfile->dterm_lpf1_dyn_min_hz = sbufReadU16(src);
            currentPidProfile->dterm_lpf1_dyn_max_hz = sbufReadU16(src);
#else
            sbufReadU16(src);
            sbufReadU16(src);
            sbufReadU16(src);
            sbufReadU16(src);
#endif
        }
        if (sbufBytesRemaining(src) >= 8) {
            // Added in MSP API 1.42
#if defined(USE_DYN_NOTCH_FILTER)
            sbufReadU8(src); // DEPRECATED 1.43: dyn_notch_range
            sbufReadU8(src); // DEPRECATED 1.44: dyn_notch_width_percent
            dynNotchConfigMutable()->dyn_notch_q = sbufReadU16(src);
            dynNotchConfigMutable()->dyn_notch_min_hz = sbufReadU16(src);
#else
            sbufReadU8(src);
            sbufReadU8(src);
            sbufReadU16(src);
            sbufReadU16(src);
#endif
#if defined(USE_RPM_FILTER)
            rpmFilterConfigMutable()->rpm_filter_harmonics = sbufReadU8(src);
            rpmFilterConfigMutable()->rpm_filter_min_hz = sbufReadU8(src);
#else
            sbufReadU8(src);
            sbufReadU8(src);
#endif
        }
        if (sbufBytesRemaining(src) >= 2) {
#if defined(USE_DYN_NOTCH_FILTER)
            // Added in MSP API 1.43
            dynNotchConfigMutable()->dyn_notch_max_hz = sbufReadU16(src);
#else
            sbufReadU16(src);
#endif
        }
        if (sbufBytesRemaining(src) >= 2) {
            // Added in MSP API 1.44
#if defined(USE_DYN_LPF)
            currentPidProfile->dterm_lpf1_dyn_expo = sbufReadU8(src);
#else
            sbufReadU8(src);
#endif
#if defined(USE_DYN_NOTCH_FILTER)
            i = sbufReadU8(src);
            // verify dyn notch count
            if (i > DYN_NOTCH_COUNT_MAX) {
                return MSP_RESULT_ERROR;
            }
            dynNotchConfigMutable()->dyn_notch_count = i;
#else
            sbufReadU8(src);
#endif
        }
        if (sbufBytesRemaining(src) >= 7) {
            // Added in MSP API 1.48
#if defined(USE_RPM_FILTER)
            {
                const uint16_t fadeRangeHz = sbufReadU16(src);
                const uint16_t q = sbufReadU16(src);
                uint8_t weights[RPM_FILTER_HARMONICS_MAX];
                for (int j = 0; j < RPM_FILTER_HARMONICS_MAX; j++) {
                    weights[j] = sbufReadU8(src);
                }
                if (q < 250 || q > 3000 || fadeRangeHz > 1000) {
                    return MSP_RESULT_ERROR;
                }
                for (int j = 0; j < RPM_FILTER_HARMONICS_MAX; j++) {
                    if (weights[j] > 100) {
                        return MSP_RESULT_ERROR;
                    }
                }
                rpmFilterConfigMutable()->rpm_filter_fade_range_hz = fadeRangeHz;
                rpmFilterConfigMutable()->rpm_filter_q = q;
                for (int j = 0; j < RPM_FILTER_HARMONICS_MAX; j++) {
                    rpmFilterConfigMutable()->rpm_filter_weights[j] = weights[j];
                }
            }
#else
            sbufReadU16(src);
            sbufReadU16(src);
            for (int j = 0; j < RPM_FILTER_HARMONICS_MAX; j++) {
                sbufReadU8(src);
            }
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
