Just4Stan/betaflight/src/main/fc/init.c

/*
 * This file is part of Cleanflight and Betaflight.
 *
 * Cleanflight and Betaflight are free software. You can redistribute
 * this software and/or modify this software under the terms of the
 * GNU General Public License as published by the Free Software
 * Foundation, either version 3 of the License, or (at your option)
 * any later version.
 *
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
 * If not, see <http://www.gnu.org/licenses/>.
 */

#include <stdbool.h>
#include <stdint.h>
#include <string.h>
#include <math.h>

#include "platform.h"

#include "blackbox/blackbox.h"

#include "build/build_config.h"
#include "build/debug.h"
#include "build/debug_pin.h"

#include "cms/cms.h"
#include "cms/cms_types.h"

#include "common/axis.h"
#include "common/color.h"
#include "common/maths.h"
#include "common/printf_serial.h"

#include "config/config.h"
#include "config/config_eeprom.h"
#include "config/feature.h"

#include "drivers/accgyro/accgyro.h"
#include "drivers/adc.h"
#include "drivers/bus.h"
#include "drivers/bus_i2c.h"
#include "drivers/bus_octospi.h"
#include "drivers/bus_quadspi.h"
#include "drivers/bus_spi.h"
#include "drivers/buttons.h"
#include "drivers/can/can.h"
#include "drivers/can/can_impl.h"
#include "drivers/camera_control.h"
#include "drivers/compass/compass.h"
#include "drivers/dma.h"
#include "drivers/dshot.h"
#include "drivers/exti.h"
#include "drivers/flash/flash.h"
#include "drivers/inverter.h"
#include "drivers/io.h"
#include "drivers/light_led.h"
#include "drivers/mco.h"
#include "drivers/nvic.h"
#include "drivers/persistent.h"
#include "drivers/pin_pull_up_down.h"
#include "drivers/rx/rx_pwm.h"
#include "drivers/sensor.h"
#include "drivers/serial.h"
#include "drivers/serial_softserial.h"
#include "drivers/serial_uart.h"
#include "drivers/sdcard.h"
#include "drivers/sdio.h"
#include "drivers/sound_beeper.h"
#include "drivers/system.h"
#include "drivers/time.h"
#include "drivers/timer.h"
#include "drivers/transponder_ir.h"
#include "drivers/usb_io.h"
#ifdef USE_USB_MSC
#include "drivers/usb_msc.h"
#endif
#include "drivers/vtx_common.h"
#include "drivers/vtx_rtc6705.h"
#include "drivers/vtx_table.h"

#include "fc/board_info.h"
#include "fc/dispatch.h"
#include "fc/gps_lap_timer.h"
#include "fc/init.h"
#include "fc/rc_controls.h"
#include "fc/runtime_config.h"
#include "fc/stats.h"
#include "fc/tasks.h"

#include "flight/alt_hold.h"
#include "flight/autopilot.h"
#include "flight/failsafe.h"
#include "flight/imu.h"
#include "flight/mixer.h"
#include "flight/gps_rescue.h"
#include "flight/pid.h"
#include "flight/pid_init.h"
#ifdef USE_SYSID
#include "flight/sysid.h"
#endif
#include "flight/position.h"
#include "flight/pos_hold.h"
#include "flight/servos.h"

#include "io/asyncfatfs/asyncfatfs.h"
#include "io/beeper.h"
#include "io/dashboard.h"
#include "io/displayport_fb_osd.h"
#include "io/displayport_frsky_osd.h"
#include "io/displayport_max7456.h"
#include "io/displayport_msp.h"
#include "io/dronecan/dronecan.h"
#include "io/flashfs.h"
#include "io/gimbal.h"
#include "io/gimbal_control.h"
#include "io/gps.h"
#include "io/ledstrip.h"
#include "io/pidaudio.h"
#include "io/piniobox.h"
#include "io/rcdevice_cam.h"
#include "io/serial.h"
#include "io/transponder_ir.h"
#include "io/vtx.h"
#include "io/vtx_control.h"
#include "io/vtx_msp.h"
#include "io/vtx_rtc6705.h"
#include "io/vtx_smartaudio.h"
#include "io/vtx_tramp.h"

#include "msc/emfat_file.h"
#ifdef USE_PERSISTENT_MSC_RTC
#include "msc/usbd_storage.h"
#endif

#include "msp/msp.h"
#include "msp/msp_serial.h"

#include "osd/osd.h"
#if ENABLE_OSD_CUSTOM_TEXT
#include "osd/osd_custom_text.h"
#endif

#include "pg/adc.h"
#include "pg/beeper.h"
#include "pg/beeper_dev.h"
#include "pg/bus_i2c.h"
#include "pg/bus_spi.h"
#include "pg/bus_quadspi.h"
#include "pg/can.h"
#include "pg/flash.h"
#include "pg/mco.h"
#include "pg/motor.h"
#include "pg/pinio.h"
#include "pg/piniobox.h"
#include "pg/pin_pull_up_down.h"
#include "pg/pg.h"
#include "pg/rx.h"
#include "pg/rx_pwm.h"
#include "pg/rx_spi.h"
#include "pg/sdcard.h"
#include "pg/vcd.h"
#include "pg/vtx_io.h"

#include "rx/rx.h"
#include "rx/spektrum.h"

#include "scheduler/scheduler.h"

#include "sensors/acceleration.h"
#include "sensors/barometer.h"
#include "sensors/battery.h"
#include "sensors/boardalignment.h"
#include "sensors/compass.h"
#include "sensors/esc_sensor.h"
#include "sensors/gyro.h"
#include "sensors/gyro_init.h"
#include "sensors/initialisation.h"

#include "telemetry/telemetry.h"

#ifdef USE_HARDWARE_REVISION_DETECTION
#include "hardware_revision.h"
#endif

#ifdef TARGET_PREINIT
void targetPreInit(void);
#endif

uint8_t systemState = SYSTEM_STATE_INITIALISING;

static enum {
    FLASH_INIT_ATTEMPTED                = (1 << 0),
    SD_INIT_ATTEMPTED                   = (1 << 1),
    SPI_BUSSES_INIT_ATTEMPTED           = (1 << 2),
    QUAD_OCTO_SPI_BUSSES_INIT_ATTEMPTED = (1 << 3),
} initFlags = 0;

#ifdef BUS_SWITCH_PIN
void busSwitchInit(void)
{
    IO_t busSwitchResetPin = IO_NONE;

    busSwitchResetPin = IOGetByTag(IO_TAG(BUS_SWITCH_PIN));
    IOInit(busSwitchResetPin, OWNER_SYSTEM, 0);
    IOConfigGPIO(busSwitchResetPin, IOCFG_OUT_PP);

    // ENABLE
    IOLo(busSwitchResetPin);
}
#endif

static void configureSPIBusses(void)
{
#ifdef USE_SPI
    spiPinConfigure(spiPinConfig(0));
#endif

    sensorsPreInit();

#ifdef USE_SPI
    spiPreinit();

#ifdef USE_SPI_DEVICE_0
    spiInit(SPIDEV_0);
#endif
#ifdef USE_SPI_DEVICE_1
    spiInit(SPIDEV_1);
#endif
#ifdef USE_SPI_DEVICE_2
    spiInit(SPIDEV_2);
#endif
#ifdef USE_SPI_DEVICE_3
    spiInit(SPIDEV_3);
#endif
#ifdef USE_SPI_DEVICE_4
    spiInit(SPIDEV_4);
#endif
#ifdef USE_SPI_DEVICE_5
    spiInit(SPIDEV_5);
#endif
#ifdef USE_SPI_DEVICE_6
    spiInit(SPIDEV_6);
#endif
#endif // USE_SPI
}

static void configureQuadSPIBusses(void)
{
#ifdef USE_QUADSPI
    quadSpiPinConfigure(quadSpiConfig(0));

#ifdef USE_QUADSPI_DEVICE_1
    quadSpiInit(QUADSPIDEV_1);
#endif
#endif // USE_QUADSPI
}

static void configureOctoSPIBusses(void)
{
#ifdef USE_OCTOSPI
#ifdef USE_OCTOSPI_DEVICE_1
    octoSpiInit(OCTOSPIDEV_1);
#endif
#endif
}

#if ENABLE_CAN
static void configureCANBusses(void)
{
    canPinConfigure(canPinConfig(0));
    const uint32_t bitrate = (uint32_t)canConfig()->bitrate_khz * 1000U;
    canInit(CANDEV_1, bitrate);
    canInit(CANDEV_2, bitrate);
    canInit(CANDEV_3, bitrate);
}
#endif

#ifdef USE_SDCARD
static void sdCardAndFSInit(void)
{
    sdcard_init(sdcardConfig());
    afatfs_init();
}
#endif

void initPhase1(void)
{
    // Initialize task data as soon as possible. Has to be done before tasksInit(),
    // and any init code that may try to modify task behaviour before tasksInit().
    tasksInitData();

    // initialize IO (needed for all IO operations)
    IOInitGlobal();

#if defined(USE_TARGET_CONFIG)
    // Call once before the config is loaded for any target specific configuration required to support loading the config
    targetConfiguration();
#endif

#if defined(USE_CONFIG_TARGET_PREINIT)
    configTargetPreInit();
#endif

#ifdef CONFIG_IN_SDCARD

    //
    // Config in sdcard presents an issue with pin configuration since the pin and sdcard configs for the
    // sdcard are in the config which is on the sdcard which we can't read yet!
    //
    // FIXME For now, users must NOT change flash/pin configs needed for the system to boot and/or to save the config.
    // One possible solution is to lock the pins for the flash chip so they cannot be modified post-boot.
    //
    // note that target specific SDCARD/SDIO/SPI/QUADSPI/OCTOSPI configs are
    // also not supported in USE_TARGET_CONFIG/targetConfigure() when using CONFIG_IN_SDCARD.
    //

    //
    // IMPORTANT: all default flash and pin configurations must be valid for the target after pgResetAll() is called.
    // Target designers must ensure other devices connected the same SPI/QUADSPI/OCTOSPI interface as the flash chip do not
    // cause communication issues with the flash chip.  e.g. use external pullups on SPI/QUADSPI/OCTOSPI CS lines.
    //

#ifdef TARGET_BUS_INIT
#error "CONFIG_IN_SDCARD and TARGET_BUS_INIT are mutually exclusive"
#endif

    pgResetAll();

#ifdef USE_SDCARD_SPI
    configureSPIBusses();
    initFlags |= SPI_BUSSES_INIT_ATTEMPTED;
#endif

    sdCardAndFSInit();
    initFlags |= SD_INIT_ATTEMPTED;

    if (!sdcard_isInserted()) {
        failureMode(FAILURE_SDCARD_REQUIRED);
    }

    while (afatfs_getFilesystemState() != AFATFS_FILESYSTEM_STATE_READY) {
        afatfs_poll();

        if (afatfs_getFilesystemState() == AFATFS_FILESYSTEM_STATE_FATAL) {
            failureMode(FAILURE_SDCARD_INITIALISATION_FAILED);
        }
    }

#endif // CONFIG_IN_SDCARD

#if defined(CONFIG_IN_EXTERNAL_FLASH) || defined(CONFIG_IN_MEMORY_MAPPED_FLASH)
    //
    // Config on external flash presents an issue with pin configuration since the pin and flash configs for the
    // external flash are in the config which is on a chip which we can't read yet!
    //
    // FIXME For now, users must NOT change flash/pin configs needed for the system to boot and/or to save the config.
    // One possible solution is to lock the pins for the flash chip so they cannot be modified post-boot.
    //
    // note that target specific FLASH/SPI/QUADSPI/OCTOSPI configs are
    // also not supported in USE_TARGET_CONFIG/targetConfigure() when using CONFIG_IN_EXTERNAL_FLASH/CONFIG_IN_MEMORY_MAPPED_FLASH.
    //

    //
    // IMPORTANT: all default flash and pin configurations must be valid for the target after pgResetAll() is called.
    // Target designers must ensure other devices connected the same SPI/QUADSPI/OCTOSPI interface as the flash chip do not
    // cause communication issues with the flash chip.  e.g. use external pullups on SPI/QUADSPI/OCTOSPI CS lines.
    //
    pgResetAll();

#ifdef TARGET_BUS_INIT
#error "CONFIG_IN_EXTERNAL_FLASH/CONFIG_IN_MEMORY_MAPPED_FLASH and TARGET_BUS_INIT are mutually exclusive"
#endif

#if defined(CONFIG_IN_EXTERNAL_FLASH)
    configureSPIBusses();
    initFlags |= SPI_BUSSES_INIT_ATTEMPTED;
#endif

#if defined(CONFIG_IN_MEMORY_MAPPED_FLASH) || defined(CONFIG_IN_EXTERNAL_FLASH)
    configureQuadSPIBusses();
    configureOctoSPIBusses();
    initFlags |= QUAD_OCTO_SPI_BUSSES_INIT_ATTEMPTED;
#endif

#ifndef USE_FLASH_CHIP
#error "CONFIG_IN_EXTERNAL_FLASH/CONFIG_IN_MEMORY_MAPPED_FLASH requires USE_FLASH_CHIP to be defined."
#endif

    bool haveFlash = flashInit(flashConfig());

    if (!haveFlash) {
        failureMode(FAILURE_EXTERNAL_FLASH_INIT_FAILED);
    }
    initFlags |= FLASH_INIT_ATTEMPTED;

#endif // CONFIG_IN_EXTERNAL_FLASH || CONFIG_IN_MEMORY_MAPPED_FLASH

    initEEPROM();

    ensureEEPROMStructureIsValid();

    bool readSuccess = readEEPROM();

#if defined(USE_BOARD_INFO)
    initBoardInformation();
#endif

    if (!readSuccess || !isEEPROMVersionValid() || strncasecmp(systemConfig()->boardIdentifier, TARGET_BOARD_IDENTIFIER, sizeof(TARGET_BOARD_IDENTIFIER))) {
        resetEEPROM();
    }

    systemState |= SYSTEM_STATE_CONFIG_LOADED;

#ifdef USE_DEBUG_PIN
    dbgPinInit();
#endif
#ifdef USE_PINIO
    pinioInit(pinioConfig());
#endif

    debugMode = systemConfig()->debug_mode;

#ifdef TARGET_PREINIT
    targetPreInit();
#endif

#if !defined(USE_VIRTUAL_LED)
    ledInit(statusLedConfig());
#endif
    LED2_ON;

    EXTIInit();
}

void initPhase2(void)
{
#if defined(USE_BUTTONS)

    buttonsInit();

    delayMicroseconds(10);  // allow configuration to settle // XXX Could be removed, too?

    // Allow EEPROM reset with two-button-press without power cycling in DEBUG build
#ifdef DEBUG
#define EEPROM_RESET_PRECONDITION true
#else
#define EEPROM_RESET_PRECONDITION (!isMPUSoftReset())
#endif

    if (EEPROM_RESET_PRECONDITION) {
#if defined(BUTTON_A_PIN) && defined(BUTTON_B_PIN)
        // two buttons required
        uint8_t secondsRemaining = 5;
        bool bothButtonsHeld;
        do {
            bothButtonsHeld = buttonAPressed() && buttonBPressed();
            if (bothButtonsHeld) {
                if (--secondsRemaining == 0) {
                    resetEEPROM();
#ifdef USE_PERSISTENT_OBJECTS
                    persistentObjectWrite(PERSISTENT_OBJECT_RESET_REASON, RESET_NONE);
#endif
                    systemReset();
                }
                delay(1000);
                LED0_TOGGLE;
            }
        } while (bothButtonsHeld);
#endif
    }

#undef EEPROM_RESET_PRECONDITION

#endif // USE_BUTTONS

    // Note that spektrumBind checks if a call is immediately after
    // hard reset (including power cycle), so it should be called before
    // systemClockSetHSEValue and OverclockRebootIfNecessary, as these
    // may cause soft reset which will prevent spektrumBind not to execute
    // the bind procedure.

#if defined(USE_SPEKTRUM_BIND)
    if (featureIsEnabled(FEATURE_RX_SERIAL)) {
        switch (rxConfig()->serialrx_provider) {
        case SERIALRX_SPEKTRUM1024:
        case SERIALRX_SPEKTRUM2048:
        case SERIALRX_SRXL:
            // Spektrum satellite binding if enabled on startup.
            // Must be called before that 100ms sleep so that we don't lose satellite's binding window after startup.
            // The rest of Spektrum initialization will happen later - via spektrumInit()
            spektrumBind(rxConfigMutable());
            break;
        }
    }
#endif

#if PLATFORM_TRAIT_CONFIG_HSE
    systemClockSetHSEValue(systemConfig()->hseMhz * 1000000U);
#endif

#ifdef USE_OVERCLOCK
    {
        static const uint16_t overclockMhzTable[] = {
            0, // OFF (use default clock)
#if ENABLE_OVERCLOCK_108_MHZ
            108,
#endif
#if ENABLE_OVERCLOCK_120_MHZ
            120,
#endif
#if ENABLE_OVERCLOCK_192_MHZ
            192,
#endif
#if ENABLE_OVERCLOCK_216_MHZ
            216,
#endif
#if ENABLE_OVERCLOCK_240_MHZ
            240,
#endif
        };
        const uint8_t idx = systemConfig()->cpu_overclock;
        const uint16_t mhz = (idx < ARRAYLEN(overclockMhzTable)) ? overclockMhzTable[idx] : 0;
        OverclockRebootIfNecessary(mhz);
    }
#endif

    // Configure MCO output after config is stable
#ifdef USE_MCO
    mcoInit();
#endif // USE_MCO

#ifdef USE_TIMER
    timerInit();  // timer must be initialized before any channel is allocated
#endif

#ifdef BUS_SWITCH_PIN
    busSwitchInit();
#endif

#if defined(USE_UART)
    uartPinConfigure(serialPinConfig());
#endif

    serialInit(featureIsEnabled(FEATURE_SOFTSERIAL));

    mixerInit(mixerConfig()->mixerMode);

#ifdef USE_MOTOR
    /* Motors needs to be initialized soon as posible because hardware initialization
     * may send spurious pulses to esc's causing their early initialization. Also ppm
     * receiver may share timer with motors so motors MUST be initialized here. */
    motorDevInit(getMotorCount());
    // TODO: add check here that motors actually initialised correctly
    systemState |= SYSTEM_STATE_MOTORS_READY;
#endif

    do {
#if defined(USE_RX_PPM)
        if (featureIsEnabled(FEATURE_RX_PPM)) {
            ppmRxInit(ppmConfig());
            break;
        }
#endif
#if defined(USE_RX_PWM)
        if (featureIsEnabled(FEATURE_RX_PARALLEL_PWM)) {
            pwmRxInit(pwmConfig());
            break;
        }
#endif
    } while (false);

#ifdef USE_BEEPER
    beeperInit(beeperDevConfig());
#endif
/* temp until PGs are implemented. */
#if defined(USE_INVERTER)
    initInverters(serialPinConfig());
#endif

#ifdef TARGET_BUS_INIT
    targetBusInit();

#else

    // Depending on compilation options SPI/QSPI/OSPI initialisation may already be done.
    if (!(initFlags & SPI_BUSSES_INIT_ATTEMPTED)) {
        configureSPIBusses();
        initFlags |= SPI_BUSSES_INIT_ATTEMPTED;
    }

    if (!(initFlags & QUAD_OCTO_SPI_BUSSES_INIT_ATTEMPTED)) {
        configureQuadSPIBusses();
        configureOctoSPIBusses();
        initFlags |= QUAD_OCTO_SPI_BUSSES_INIT_ATTEMPTED;
    }

#if ENABLE_SDIO_INIT && defined(USE_SDCARD_SDIO) && !defined(CONFIG_IN_SDCARD)
    sdioPinConfigure();
    sdioInitialize();
#endif
}

#ifdef USE_USB_MSC
bool checkMsc(void)
{
    return (mscCheckBootAndReset() || mscCheckButton());
}

void initMsc(void)
{
/* MSC mode will start after init, but will not allow scheduler to run,
 *  so there is no bottleneck in reading and writing data */
    ledInit(statusLedConfig());

#ifdef USE_SDCARD
    if (blackboxConfig()->device == BLACKBOX_DEVICE_SDCARD) {
        if (sdcardConfig()->mode) {
            if (!(initFlags & SD_INIT_ATTEMPTED)) {
                sdCardAndFSInit();
                initFlags |= SD_INIT_ATTEMPTED;
            }
        }
    }
#endif

#if defined(USE_FLASHFS)
    // If the blackbox device is onboard flash, then initialize and scan
    // it to identify the log files *before* starting the USB device to
    // prevent timeouts of the mass storage device.
    if (blackboxConfig()->device == BLACKBOX_DEVICE_FLASH) {
        emfat_init_files();
    }
#endif
    // There's no more initialisation to be done, so enable DMA where possible for SPI
#ifdef USE_SPI
    spiInitBusDMA();
#endif
    if (mscStart() == 0) {
        mscWaitForButton();
    } else {
        systemResetFromMsc();
    }
}
#endif

void initPhase3(void)
{
#ifdef USE_PERSISTENT_MSC_RTC
    // if we didn't enter MSC mode then clear the persistent RTC value
    persistentObjectWrite(PERSISTENT_OBJECT_RTC_HIGH, 0);
    persistentObjectWrite(PERSISTENT_OBJECT_RTC_LOW, 0);
#endif

#ifdef USE_I2C
    i2cPinConfigure(i2cConfig(0));

    // Note: Unlike UARTs which are configured when client is present,
    // I2C buses are initialized unconditionally if they are configured.

#ifdef USE_I2C_DEVICE_0
    i2cInit(I2CDEV_0);
#endif
#ifdef USE_I2C_DEVICE_1
    i2cInit(I2CDEV_1);
#endif
#ifdef USE_I2C_DEVICE_2
    i2cInit(I2CDEV_2);
#endif
#ifdef USE_I2C_DEVICE_3
    i2cInit(I2CDEV_3);
#endif
#ifdef USE_I2C_DEVICE_4
    i2cInit(I2CDEV_4);
#endif
#endif // USE_I2C

#endif // TARGET_BUS_INIT

#if ENABLE_CAN && !defined(TARGET_BUS_INIT)
    configureCANBusses();
#endif

#if ENABLE_DRONECAN
    dronecanInit();
#endif

#ifdef USE_HARDWARE_REVISION_DETECTION
    updateHardwareRevision();
#endif

#ifdef USE_VTX_RTC6705
    bool useRTC6705 = rtc6705IOInit(vtxIOConfig());
#endif

#ifdef USE_CAMERA_CONTROL
    cameraControlInit();
#endif

#ifdef USE_ADC
    adcInit(adcConfig());
#endif

    initBoardAlignment(boardAlignment());

    if (!sensorsAutodetect()) {
        // if gyro was not detected due to whatever reason, notify and don't arm.
        if (isSystemConfigured()) {
            indicateFailure(FAILURE_MISSING_ACC, 2);
        }
        setArmingDisabled(ARMING_DISABLED_NO_GYRO);
    }

    systemState |= SYSTEM_STATE_SENSORS_READY;

    // Set the targetLooptime based on the detected gyro sampleRateHz and pid_process_denom
    gyroSetTargetLooptime(pidConfig()->pid_process_denom);

    // Validate and correct the gyro config or PID loop time if needed
    validateAndFixGyroConfig();

    // Now reset the targetLooptime as it's possible for the validation to change the pid_process_denom
    gyroSetTargetLooptime(pidConfig()->pid_process_denom);

#if defined(USE_DSHOT_TELEMETRY) || defined(USE_ESC_SENSOR)
    // Initialize the motor frequency filter now that we have a target looptime
    initDshotTelemetry(gyro.targetLooptime);
#endif

    // Finally initialize the gyro filtering
    gyroInitFilters();

    pidInit(currentPidProfile);

#ifdef USE_SYSID
    sysidInit();
#endif

    mixerInitProfile();

#ifdef USE_PID_AUDIO
    pidAudioInit();
#endif

#ifdef USE_SERVOS
    servosInit();
    if (isMixerUsingServos()) {
        //pwm_params.useChannelForwarding = featureIsEnabled(FEATURE_CHANNEL_FORWARDING);
        servoDevInit(&servoConfig()->dev);
    }
    servosFilterInit();
#endif


#ifdef USE_PIN_PULL_UP_DOWN
    pinPullupPulldownInit();
#endif

#ifdef USE_PINIOBOX
    pinioBoxInit(pinioBoxConfig());
#endif

    LED1_ON;
    LED0_OFF;
    LED2_OFF;

    for (int i = 0; i < 10; i++) {
        LED1_TOGGLE;
        LED0_TOGGLE;
#if defined(USE_BEEPER)
        delay(25);
        if (!(beeperConfig()->beeper_off_flags & BEEPER_GET_FLAG(BEEPER_SYSTEM_INIT))) {
            BEEP_ON;
        }
        delay(25);
        BEEP_OFF;
#else
        delay(50);
#endif
    }

    LED0_OFF;
    LED1_OFF;

    imuInit();

    failsafeInit();

    rxInit();

#ifdef USE_GPS
    if (featureIsEnabled(FEATURE_GPS)) {
        gpsInit();
#ifdef USE_GPS_LAP_TIMER
        gpsLapTimerInit();
#endif // USE_GPS_LAP_TIMER
    }
#endif

#if ENABLE_OSD_CUSTOM_TEXT
    osdCustomTextInit();
#endif

#ifdef USE_LED_STRIP
    ledStripInit();

    if (featureIsEnabled(FEATURE_LED_STRIP)) {
        ledStripEnable();
    }
#endif

#ifdef USE_ESC_SENSOR
    if (featureIsEnabled(FEATURE_ESC_SENSOR)) {
        escSensorInit();
    }
#endif

#ifdef USE_USB_DETECT
    usbCableDetectInit();
#endif

#ifdef USE_TRANSPONDER
    if (featureIsEnabled(FEATURE_TRANSPONDER)) {
        transponderInit();
        transponderStartRepeating();
        systemState |= SYSTEM_STATE_TRANSPONDER_ENABLED;
    }
#endif

#ifdef USE_FLASH_CHIP
    if (!(initFlags & FLASH_INIT_ATTEMPTED)) {
        flashInit(flashConfig());
        initFlags |= FLASH_INIT_ATTEMPTED;
    }
#endif
#ifdef USE_FLASHFS
    flashfsInit();
#endif

#ifdef USE_SDCARD
    if (sdcardConfig()->mode) {
        if (!(initFlags & SD_INIT_ATTEMPTED)) {
            sdCardAndFSInit();
            initFlags |= SD_INIT_ATTEMPTED;
        }
    }
#endif
#ifdef USE_BLACKBOX
    blackboxInit();
#endif

#ifdef USE_ACC
    if (mixerConfig()->mixerMode == MIXER_GIMBAL) {
        accStartCalibration();
    }
#endif
    gyroStartCalibration(false);
#ifdef USE_BARO
    baroStartCalibration();
#endif

    positionInit();
    autopilotInit();

#if defined(USE_VTX_COMMON) || defined(USE_VTX_CONTROL)
    vtxTableInit();
#endif

#ifdef USE_VTX_CONTROL
    vtxControlInit();

#if defined(USE_VTX_COMMON)
    vtxCommonInit();
#endif

#ifdef USE_VTX_MSP
    vtxMspInit();
#endif

#ifdef USE_VTX_SMARTAUDIO
    vtxSmartAudioInit();
#endif

#ifdef USE_VTX_TRAMP
    vtxTrampInit();
#endif

#ifdef USE_VTX_RTC6705
    if (!vtxCommonDevice() && useRTC6705) { // external VTX takes precedence when configured.
        vtxRTC6705Init();
    }
#endif

#endif // VTX_CONTROL

#ifdef USE_GIMBAL
    gimbalInit();
#endif

    batteryInit(); // always needs doing, regardless of features.

#ifdef USE_RCDEVICE
    rcdeviceInit();
#endif // USE_RCDEVICE

#ifdef USE_PERSISTENT_STATS
    statsInit();
#endif

    // Initialize MSP
    mspInit();
    mspSerialInit();

/*
 * CMS, display devices and OSD
 */
#ifdef USE_CMS
    cmsInit();
#endif

#if (defined(USE_OSD) || (defined(USE_MSP_DISPLAYPORT) && defined(USE_CMS)))
    displayPort_t *osdDisplayPort = NULL;
#endif

#if defined(USE_OSD)
    osdDisplayPortDevice_e osdDisplayPortDevice = OSD_DISPLAYPORT_DEVICE_NONE;

    //The OSD need to be initialised after GYRO to avoid GYRO initialisation failure on some targets

    if (featureIsEnabled(FEATURE_OSD)) {
        osdDisplayPortDevice_e device;

        if (vcdProfile()->video_system == VIDEO_SYSTEM_HD) {
            device = OSD_DISPLAYPORT_DEVICE_MSP;
        } else {
            device = osdConfig()->displayPortDevice;
        }

        switch(device) {

        case OSD_DISPLAYPORT_DEVICE_AUTO:
            FALLTHROUGH;

#if defined(USE_FRSKYOSD)
        // Test OSD_DISPLAYPORT_DEVICE_FRSKYOSD first, since an FC could
        // have a builtin MAX7456 but also an FRSKYOSD connected to an
        // uart.
        case OSD_DISPLAYPORT_DEVICE_FRSKYOSD:
            osdDisplayPort = frskyOsdDisplayPortInit(vcdProfile()->video_system);
            if (osdDisplayPort || device == OSD_DISPLAYPORT_DEVICE_FRSKYOSD) {
                osdDisplayPortDevice = OSD_DISPLAYPORT_DEVICE_FRSKYOSD;
                break;
            }
            FALLTHROUGH;
#endif

#if defined(USE_MAX7456)
        case OSD_DISPLAYPORT_DEVICE_MAX7456:
            // If there is a max7456 chip for the OSD configured and detected then use it.
            if (max7456DisplayPortInit(vcdProfile(), &osdDisplayPort) || device == OSD_DISPLAYPORT_DEVICE_MAX7456) {
                osdDisplayPortDevice = OSD_DISPLAYPORT_DEVICE_MAX7456;
                break;
            }
            FALLTHROUGH;
#endif

#if ENABLE_FB_OSD
        case OSD_DISPLAYPORT_DEVICE_FBOSD:
            if (fbOsdDisplayPortInit(vcdProfile(), &osdDisplayPort) || device == OSD_DISPLAYPORT_DEVICE_FBOSD) {
                osdDisplayPortDevice = OSD_DISPLAYPORT_DEVICE_FBOSD;
                break;
            }
            FALLTHROUGH;
#endif

#if defined(USE_CMS) && defined(USE_MSP_DISPLAYPORT) && defined(USE_OSD_OVER_MSP_DISPLAYPORT)
        case OSD_DISPLAYPORT_DEVICE_MSP:
            osdDisplayPort = displayPortMspInit();
            if (osdDisplayPort || device == OSD_DISPLAYPORT_DEVICE_MSP) {
                osdDisplayPortDevice = OSD_DISPLAYPORT_DEVICE_MSP;
                break;
            }
            FALLTHROUGH;
#endif

        // Other device cases can be added here

        case OSD_DISPLAYPORT_DEVICE_NONE:
        default:
            break;
        }

        // osdInit will register with CMS by itself.
        osdInit(osdDisplayPort, osdDisplayPortDevice);

        if (osdDisplayPortDevice == OSD_DISPLAYPORT_DEVICE_NONE) {
            featureDisableImmediate(FEATURE_OSD);
        }
    }
#endif // USE_OSD

#if defined(USE_CMS) && defined(USE_MSP_DISPLAYPORT)
    // If BFOSD is not active, then register MSP_DISPLAYPORT as a CMS device.
    if (!osdDisplayPort) {
        cmsDisplayPortRegister(displayPortMspInit());
    }
#endif

#ifdef USE_DASHBOARD
    // Dashbord will register with CMS by itself.
    if (featureIsEnabled(FEATURE_DASHBOARD)) {
        dashboardInit();
#ifdef USE_OLED_GPS_DEBUG_PAGE_ONLY
        dashboardShowFixedPage(PAGE_GPS);
#else
        dashboardResetPageCycling();
        dashboardEnablePageCycling();
#endif
    }
#endif

#ifdef USE_TELEMETRY
    // Telemetry will initialise displayport and register with CMS by itself.
    if (featureIsEnabled(FEATURE_TELEMETRY)) {
        telemetryInit();
    }
#endif

    setArmingDisabled(ARMING_DISABLED_BOOT_GRACE_TIME);

// allocate SPI DMA streams before motor timers
#if defined(USE_SPI) && defined(USE_SPI_DMA_ENABLE_EARLY)
    // Attempt to enable DMA on all SPI busses
    spiInitBusDMA();
#endif

#ifdef USE_MOTOR
    motorPostInit();
    motorEnable();
#endif

// allocate SPI DMA streams after motor timers as SPI DMA allocate will always be possible
#if defined(USE_SPI) && defined(USE_SPI_DMA_ENABLE_LATE) && !defined(USE_SPI_DMA_ENABLE_EARLY)
    // Attempt to enable DMA on all SPI busses
    spiInitBusDMA();
#endif

// autopilot must be initialised before modes that require the autopilot pids
#ifdef USE_ALTITUDE_HOLD
    altHoldInit();
#endif

#ifdef USE_POSITION_HOLD
    posHoldInit();
#endif

#ifdef USE_GPS_RESCUE
    if (featureIsEnabled(FEATURE_GPS)) {
        gpsRescueInit();
    }
#endif

    debugInit();

    unusedPinsInit();

    tasksInit();

    systemState |= SYSTEM_STATE_READY;
}
