Just4Stan/betaflight/src/main/scheduler/scheduler.c

/*
 * This file is part of Cleanflight and Betaflight.
 *
 * Cleanflight and Betaflight are free software. You can redistribute
 * this software and/or modify this software under the terms of the
 * GNU General Public License as published by the Free Software
 * Foundation, either version 3 of the License, or (at your option)
 * any later version.
 *
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
 * If not, see <http://www.gnu.org/licenses/>.
 */

#define SRC_MAIN_SCHEDULER_C_

#include <stdbool.h>
#include <stdint.h>
#include <string.h>
#include <limits.h>
#include <math.h>

#include "platform.h"

#include "drivers/accgyro/accgyro.h"

#include "build/assert_core.h"
#include "build/build_config.h"
#include "build/debug.h"

#include "common/maths.h"
#include "common/time.h"
#include "common/utils.h"

#include "drivers/time.h"
#include "drivers/accgyro/accgyro.h"
#include "drivers/system.h"

#include "fc/core.h"
#include "fc/tasks.h"

#include "rx/rx.h"
#include "flight/failsafe.h"

#include "scheduler.h"

#include "sensors/gyro_init.h"

// DEBUG_SCHEDULER, timings for:
// 0 - Average time spent executing check function
// 1 - Time spent priortising
// 2 - time spent in scheduler
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
