Just4Stan/betaflight/(commit log)

2026-04-27 index on master: 3c879a06d Add ESP32 interrupt infrastructure, harden UART driver, and fix opaque resource types (#15064)
    [OpenFC-B_Paste.dxf, OpenFC-F_Paste.dxf, OpenFC.kicad_pcb, OpenFC.kicad_sch, OpenFCv0.1_bom.csv, OpenFCv0.1_designators.csv, OpenFCv0.1_positions.csv, OpenFCv0.2_bom.csv]
2026-04-28 PICO: make config flash writes multicore-safe via flash_safe_execute
    The previous implementation in config_flash.c only disabled interrupts on
    the calling core before calling flash_range_erase / flash_range_program.
    On a dual-core RP2350 build (USE_MULTICORE) this is unsafe: if core1 is
    executing from XIP at the moment core0 begins programming or erasing,
    the resulting bus stall can corrupt memory or hang the system. The
    existing inline TODO at config_flash.c:50 already pointed at this.
    This change wraps the erase + program sequence in a small helper and
    routes it through pico-sdk's flash_safe_execute() when USE_MULTICORE is
    enabled. flash_safe_execute() locks core1 out via the multicore lo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
    [config_flash.c, multicore.c]
2026-04-29 PICO: lockless SPSC core1 ring + multicoreScheduleTask API
    Adds two pieces of multicore plumbing that the existing fire-and-forget
    multicoreExecute() / multicoreExecuteBlocking() pair don't cover:
    1. core1_ring_{c,h}: a hand-rolled lockless single-producer single-
    consumer ring buffer for moving 32-bit slots from core0 -> core1
    in steady state. Sized for 64 slots (~8 ms of headroom at 8 kHz),
    uses __atomic_thread_fence() acquire/release for ordering. The
    pico-sdk queue_t was considered but its mutex backing is too heavy
    for an 8 kHz sample path; this primitive runs in a few cycles per
    push/pop on M33.
    2. multicoreScheduleTask() in multicore.h: registers a long-lived
    {u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
    [core1_ring.c, core1_ring.h, multicore.c]
2026-05-07 PICO: allow multicoreScheduleTask registration after multicoreStart
    PR2 ("SPSC ring + multicoreScheduleTask API") originally documented the
    contract as "must register before multicoreStart()" so the consumer-side
    table could stay strictly read-only and avoid any locking.
    In practice every BF caller registers from initPhase3 — pidInit() ->
    dynNotchInit() -> dynNotchOffloadInit() (PR4), and now sysidInit() (PR-D)
    — which runs *after* systemInit() has already called multicoreStart() to
    launch core1. Under the original contract those registrations silently
    fail and the workloads fall back to the inline path, defeating the
    point of the offload entirely.
    Relax the contract to allow late regi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
    [multicore.c]
2026-05-07 PICO: update multicoreScheduleTask header contract (post-relaxation)
    The header still claimed multicoreScheduleTask() must be called before
    multicoreStart(). That contract was relaxed in dfef25cd6 once it became
    clear every BF init phase runs via multicoreExecuteBlocking AFTER core1
    launches; PR-D and the dyn_notch offload both rely on the relaxation.
    Document the actual concurrency model (SPSC, write-once slots, monotonic
    count via release/acquire) so the next reader does not assume the old
    restriction still applies. No code change.
2026-05-07 PICO: enable USE_MULTICORE on RP2350B by default
    This is the moment dual-core actually turns on for RP2350B targets in
    mainline BF. The change is one line: the previously-commented-out
    USE_MULTICORE define in src/platform/PICO/target/RP2350B/target.h is
    now active.
    Behaviour with this PR alone:
    - core1 launches into multicore.c::core1_main() at boot.
    - The fire-and-forget command queue (multicoreExecute /
    multicoreExecuteBlocking) is wired up — config_flash uses it via
    flash_safe_execute().
    - The scheduled-task table from the previous PR runs in steady state
    on core1 but is empty (no tasks registered yet).
    So at runtime core1 spends almost all of its time in
    tight_loop_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
2026-05-07 PICO: offload dyn_notch peak detection + freq calc onto core1
    Adds a thin core1-offload path for the two stateless steps of
    dyn_notch_filter:STEP_DETECT_PEAKS and STEP_CALC_FREQUENCIES.
    STEP_WINDOW (which reads the live SDFT state and is racy with the
    gyro-task-side sdftPushBatch) and STEP_UPDATE_FILTERS (which writes the
    biquad coefficients consumed by the gyro filter path) stay on core0.
    When USE_MULTICORE is defined and dynNotchOffloadInit() succeeds in
    registering the core1 task, STEP_WINDOW posts a job descriptor (a copy
    of sdftData[] plus the algorithm parameters) to a 4-slot SPSC ring.
    core1 runs the peak detection and parabolic centerFreq calculation and
    publishes the result back th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
2026-05-07 PICO: assert core0 affinity for hard-realtime gyro / PID / scheduler paths
    Adds ASSERT_CORE0() at the entry of gyroUpdate(), pidController(), and
    both schedulerInit() + scheduler(), making the "core0 is hard-realtime,
    core1 is best-effort offload" invariant a build-time-checkable contract.
    The macro is provided by a new build/core_affinity.h:
    - on USE_MULTICORE targets it expands to hard_assert(get_core_num() == 0)
    - on every other target it expands to nothing
    so STM32 / SITL / PICO-single-core targets see no behaviour change. The
    assertion fires only if a future refactor accidentally moves a
    hard-realtime task onto core1, where it would silently miss its
    deadline; with the assert in p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
2026-05-07 PICO: dyn_notch_offload — drop-on-not-consumed publish (race fix)
    The previous core0/core1 hand-off had a publish/consume race: core0
    acquire-loaded ready==1, copied result, then RELEASE-stored ready=0.
    If core1 published a fresh result between core0's copy and ack, the
    ack overwrote core1's ready=1 and the new result was silently lost
    ("dyn_notch occasionally drops a frame" in flight).
    Flip the contract: producer (core1) drops the new result if the
    previous one hasn't been consumed yet, instead of overwriting in
    place. Trades a silent overwrite for a silent drop — acceptable
    for dyn_notch (next gyro frame ~1 ms later produces another peak
    detection job).
    core1_ring.h doc fix: header c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
    [core1_ring.h, dyn_notch_offload.c]
2026-05-07 flight: chirp-based on-board PID identifier (Phase 2)
    Adds USE_SYSID — a post-flight system identifier that runs on core1
    when a chirp completes. Pipeline: Welch H1 cross-spectrum → 2nd-order
    rigid-body plant fit (Levenberg-Marquardt trust region) → loop-shaping
    suggested PID gains. Suggestions are exposed via CLI / MSP / OSD;
    no auto-apply, pilot must accept manually.
    Architecture:
    - Producer (core0, pidController): sysidPushSample(setpoint, gyroUnfilt)
    every PID tick. Decimating PT1 anti-aliasing filter on the way in.
    - Consumer (core1): streaming Welch — drains 75%-overlapped Hann segments
    as they arrive, accumulates Sxx/Sxy/Syy. On chirp end, deconvolves
    controller C(jw) a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
2026-05-07 PICO: keep sysid code in flash to free RAM under RunFromHybrid
    The RunFromHybrid linker default copies all .text into RAM for speed.
    USE_SYSID adds ~40-50 KB of post-flight Welch + plant-fit code that
    runs on core1 only after the chirp ends, so XIP latency is fine.
    Add */sysid*.o to the .flashtext / .rodata exclusion list alongside
    cli/config/pg.
    Saves ~76 KB RAM on OPENFC_ECO_RP2350B (99.7% -> 85.2%). PICO targets
    without USE_SYSID build no sysid*.o, so the pattern matches nothing —
    no impact.
2026-05-07 PICO: per-board opt-in for HD OSD on RP2350B target
    The RP2350B platform target unconditionally undefs USE_OSD_HD as a
    conservative default. Boards wired to a digital VTX (DJI O4, HDZero,
    Walksnail) need the HD canvas; gate the undef on BOARD_USE_OSD_HD so
    those boards can opt in from their config.h:
    #define BOARD_USE_OSD_HD
    Boards that don't define it keep the prior default (HD off).
2026-07-19 PICO: enable 4-way BLHeli/AM32 ESC passthrough
    The 4-way interface (used by AM32 and BLHeli configurators via MSP) was
    compiled out for PICO targets and could not have worked anyway:
    - USE_SERIAL_4WAY_* was undefined in the RP2350A/B target headers
    - the DShot and PWM motor vtables did not implement getMotorIO, so
    esc4wayInit() found no ESCs
    - IOConfigGPIO refused to switch a pin's function select to SIO, so
    bit-banged one-wire serial never reached the pad, and IOCFG_IPU did
    not enable the pull-up the idle-high line relies on
    - IOCFG_AF_PP had no meaning, so pins were never returned to their
    peripheral after passthrough
    IOConfigGPIO now claims pins for SIO (remembering the previous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
2026-07-19 PICO: enable HD OSD and MSP DisplayPort
    USE_OSD_HD (both targets) and USE_MSP_DISPLAYPORT (RP2350A) were
    compiled out, so digital VTX OSD via MSP DisplayPort was unavailable
    and the configurator could not select HD. Verified working with a DJI
    O4 air unit on a PIO UART on an RP2350B board.
2026-07-19 PICO: enable serial passthrough
    USE_SERIAL_PASSTHROUGH was compiled out of the RP2350 targets. The
    implementation is platform-independent and the optional ctrl-line/baud
    callbacks are guarded, so enabling it is sufficient. Needed for e.g.
    updating ExpressLRS receivers through the FC.
2026-08-05 OSD: allow targets to override default displayport device and video system
    A target with a built-in OSD (e.g. the RP2350 framebuffer OSD) had no way
    to default to its own displayport device: pgResetFn_osdConfig hardcoded
    MSP (HD) or AUTO (SD), and pgResetFn_vcdProfile hardcoded the video
    system. Targets can now define DEFAULT_OSD_DISPLAYPORT_DEVICE and
    DEFAULT_VIDEO_SYSTEM; behaviour is unchanged when they are not defined.
2026-08-05 PICO: FB OSD robustness fixes and sync diagnostics
    Analog framebuffer OSD fixes found bringing up the OPENFC_LITE boards:
    - fall back to the baked-in font instead of failing init when no font
    data is present in flash
    - check pio_can_add_program before adding the OSD tx and count_sync
    programs (tx needs 31 of 32 instruction slots, so any co-resident
    program such as the WS2812 ledstrip driver starves it out) and check
    the state machine claim, with clear boot messages instead of a panic
    - count vsync interrupts and report sync state in CLI status
    (sync LOCKED/NOT DETECTED plus vsync count) to make no-video and
    lost-sync conditions diagnosable from the CLI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
    [cli.c, osd_pico.c]
2026-08-05 PICO: bump asyncfatfs cache to 32 sectors for SDCARD blackbox stability
    The current 11-sector (5.5 KB) asyncfatfs cache is marginal for SDCARD
    blackbox on the PICO platform: V30/A2 cards still take periodic 50-250 ms
    internal GC stalls that overflow this buffer at typical blackbox rates.
    Observed on a 256 GB SanDisk Extreme Pro (V30/A2, FAT32 with 32 KB
    clusters) used as blackbox storage on an OpenFC-ECO V0.3 board (RP2350B):
    at sample_rate=1/2 (~132 KB/s sustained), 22 % of frames were silently
    dropped despite ample average headroom. The drops correlated with the
    asyncfatfs ring filling between consecutive SD pump invocations during
    card stalls. Bumping the cache to 32 sectors (16 KB / ~12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
2026-08-05 PICO: apply motor output reordering in the DShot driver
    The DShot PIO driver assigned motor pins straight from ioTags[motorIndex],
    ignoring motorOutputReordering (an existing TODO). The configurator's motor
    reorder wizard saved the table but it silently had no effect with DShot
    protocols; the PWM driver (pwm_motor_pico.c) already applied it. Resolve the
    pin through the reordering table at init, matching dshot_dpwm.c on STM32.
    [dshot_pico.c]
2026-08-06 sdcard: allow the SD spec's full 1 s for card initialisation
    The whole init sequence had to complete within 200 ms or sdcard_reset() tore
    it down and started again, so a card that needs longer never initialises. The
    SD specification permits up to 1 second, and larger cards routinely take
    several hundred milliseconds at power-on.
    Observed on an RP2350 board: two different 64 GB cards never initialise, an
    8 GB card succeeds on roughly two boots in three, and a 16 GB card always
    succeeds. Init runs once at boot with no retry, so a failure silently costs a
    whole flight's blackbox log.
2026-08-06 Blackbox: log ESC temperature and current from extended DShot telemetry
    Bidirectional DShot already carries ESC temperature, voltage and current
    alongside eRPM when the ESC has extended telemetry enabled, but only eRPM
    reaches the blackbox. Temperature currently ends its life on the OSD, so
    there is no way to correlate ESC or motor heating with throttle, RPM and
    pack current after a flight. Motor phase current has the same problem: the
    log has total pack current only, so a single dragging bell or a bad bearing
    cannot be told apart from a heavy load on all four.
    Add debug mode ESC_EDT, which puts per-motor temperature in degrees C in
    debug[0..3] and per-motor current in amps in debug[4..7].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
2026-08-06 Enable extended DShot telemetry on targets without USE_ESC_SENSOR
    The only call site that sends DSHOT_CMD_EXTENDED_TELEMETRY_ENABLE was guarded
    by USE_ESC_SENSOR as well as USE_DSHOT_TELEMETRY, so any target that undefines
    USE_ESC_SENSOR never asks its ESCs to turn extended telemetry on. The ESCs then
    send only eRPM, and temperature, voltage and current stay at zero with no
    indication why. PICO and ESP32 targets undefine that symbol.
    USE_ESC_SENSOR is the compile time symbol and is unrelated to the runtime
    FEATURE_ESC_SENSOR test the code already performs. Gate the block on
    USE_DSHOT_TELEMETRY alone and fold the runtime test into a local that is false
    when the ESC sensor is not built in.
2026-10-12 config: OpenFC-Lite rev3.3 pin map (betaflight-config#1)
2026-10-18 feat(msp): displayport_msp_report_armed for DJI O3/O4 full power at boot
    DJI O3/O4 hold low TX power until MSP_STATUS reports ARM. With the new
    setting ON, MSP_STATUS replies to the MSP displayport serial port carry
    the ARM bit; other ports (USB, configurator) and the real arming state
    are unchanged. Default OFF. Bumps the displayport profile PG versions.
